narinthon-so/Mushroom-project/Documents/เล่ม/successed/resource/Pics/t8.jpg

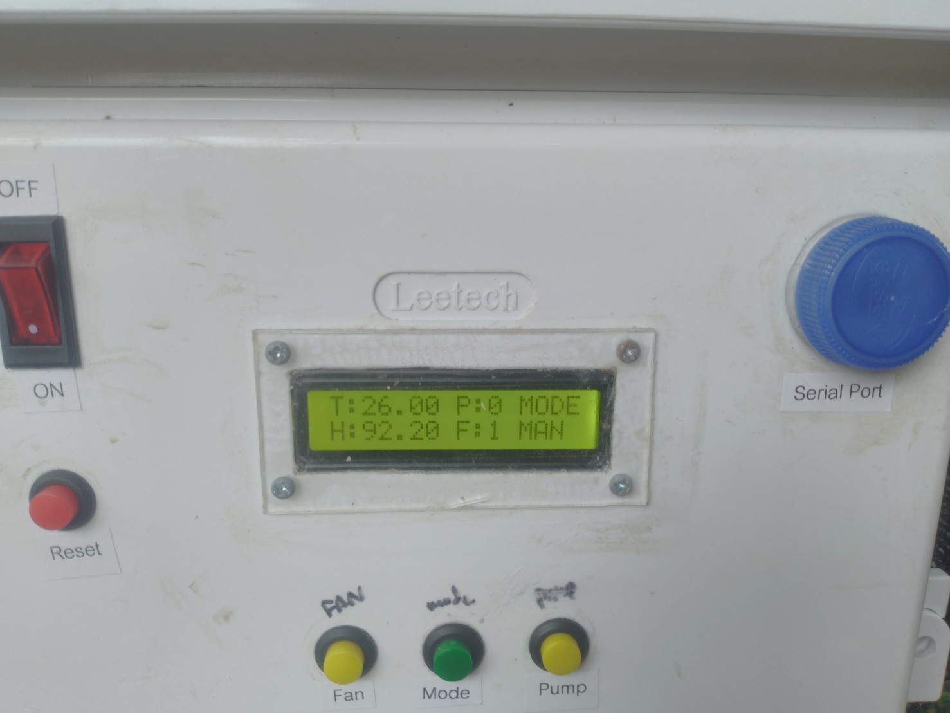
Documents/เล่ม/successed/resource/Pics/t8.jpg
