narinthon-so/Mushroom-project/Documents/เล่ม/successed/resource/Pics/IMG_20201009_142313.jpg

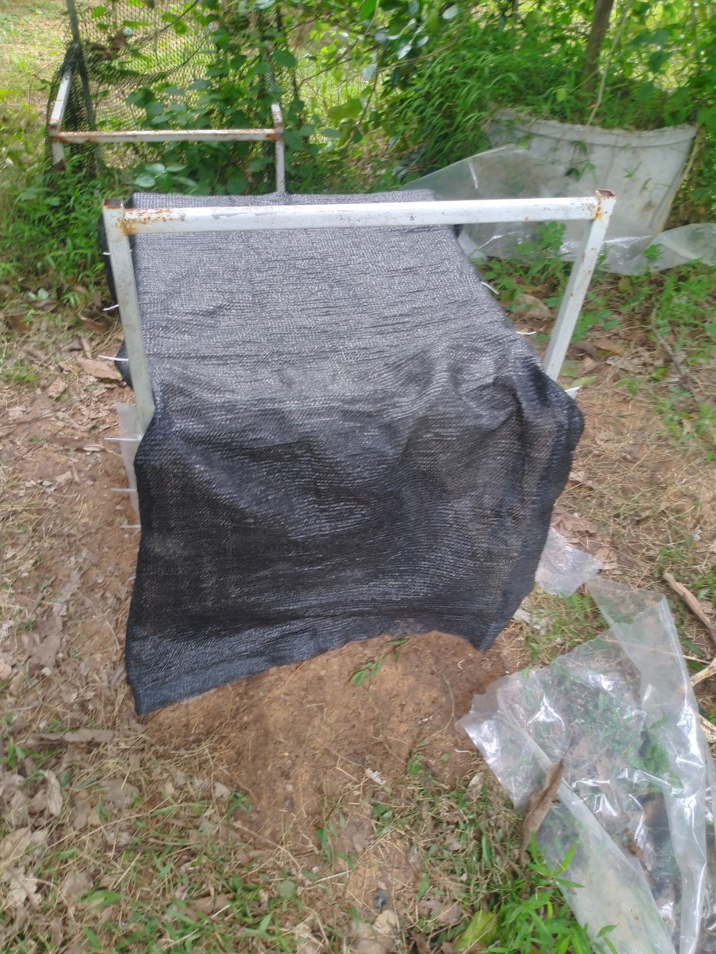
Documents/เล่ม/successed/resource/Pics/IMG_20201009_142313.jpg
