narinthon-so/Mushroom-project/Documents/hardware-diagrame.pptx

PUMP

Relay

GPIO 33

ESP32LoRa

SDA

AM2315 Sensor

LCD Monitor

FAN

Relay

GPIO 4

SCL

GPIO 34

R Sensing FAN

R Sensing PUMP

GPIO 25

GPIO 15

Switch
On / Off
FAN

GPIO 13

Switch
On / Off
PUMP

GPIO 12

Switch
AUTO / MANUAL
