narinthon-so/Mushroom-project/Documents/SystemDiagram.pptx

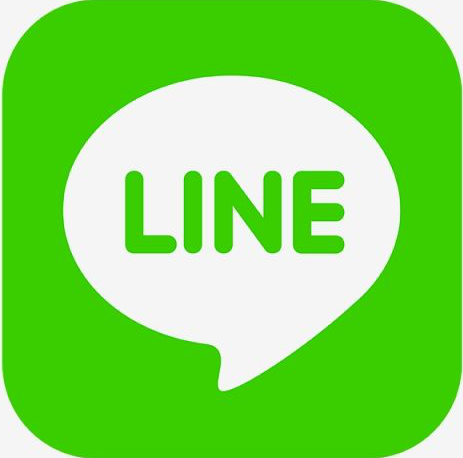
[picture p3: figure]

Line Application

Line Notify Service

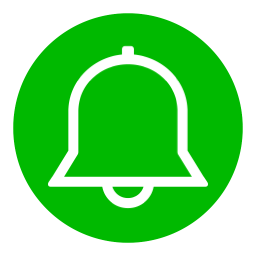
[picture p4: figure]
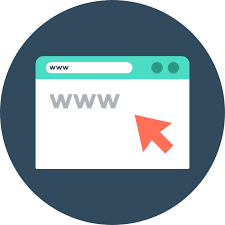
[picture p5: figure]

Web Client

Mushroom Farm

ngrok

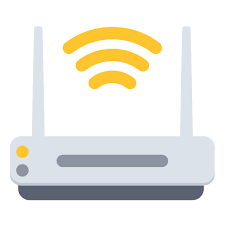
[picture p6: figure]

Access Point

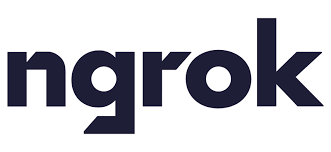
[picture p7: figure]
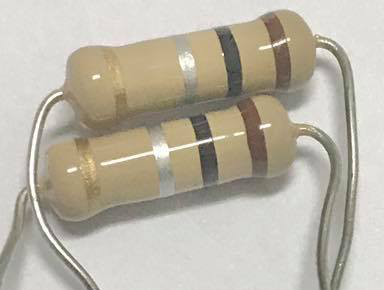
[picture p8: figure]

Current Sense Resistors

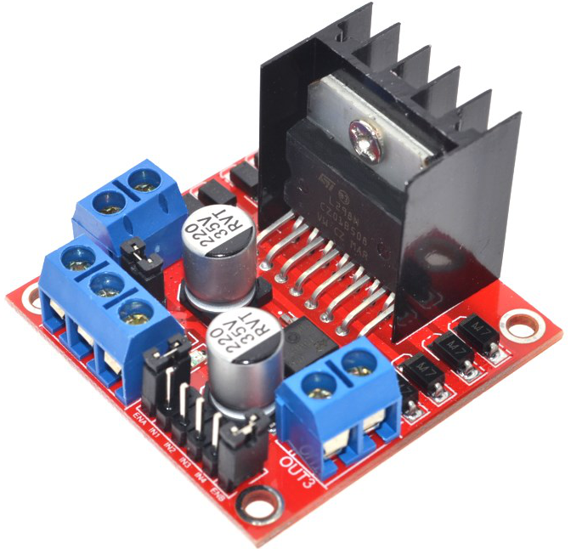
[picture p9: figure]

L298N

LED x 112

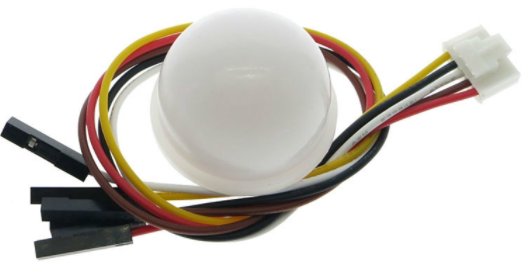
[picture p10: figure]

BH1750FVI

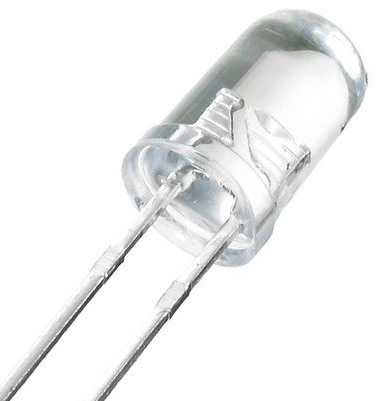
[picture p11: figure]
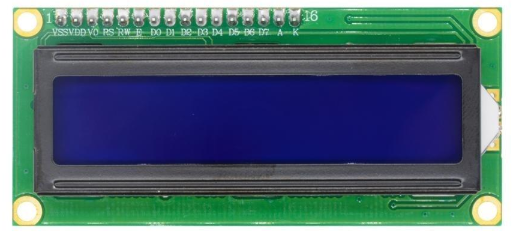
[picture p12: figure]

I2C LCD

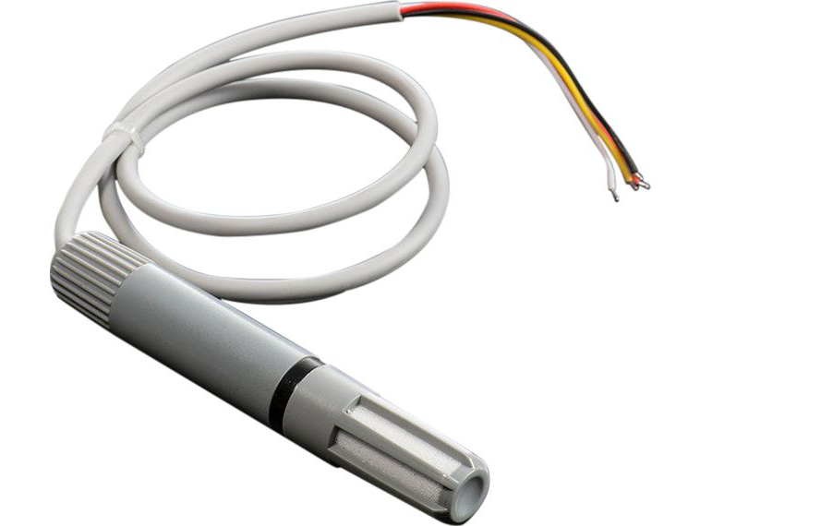
[picture p13: figure]
AM2315

AM2315

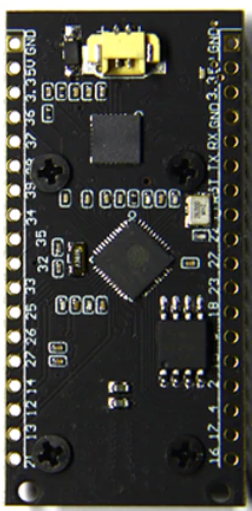
[picture p14: figure]

ESP32LoRa

ESP32LoRa

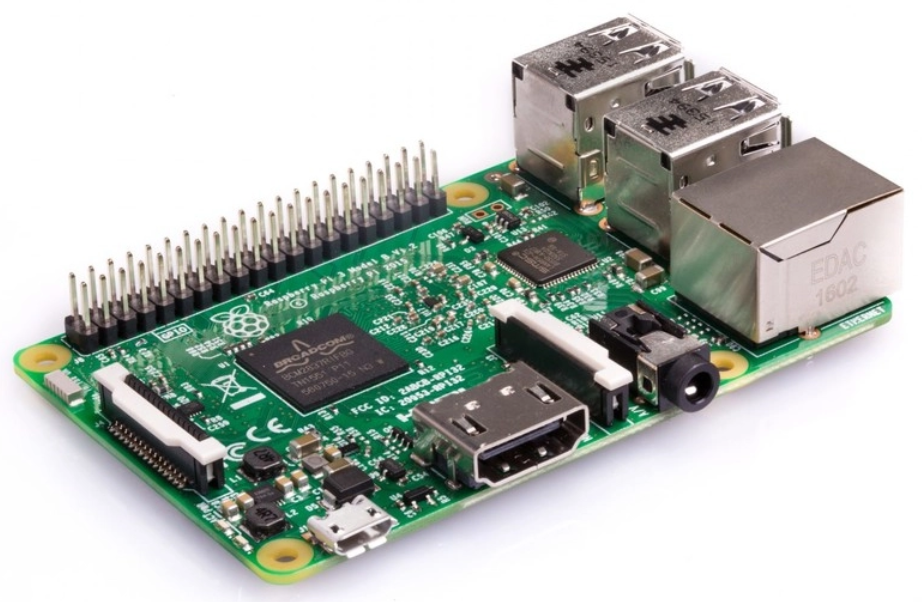
[picture p15: figure]

Raspberry pi 3 b

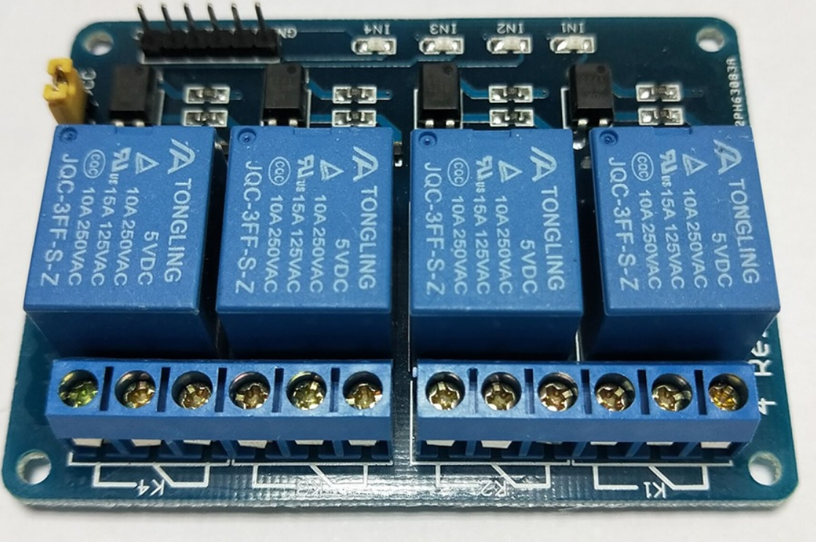
[picture p16: figure]
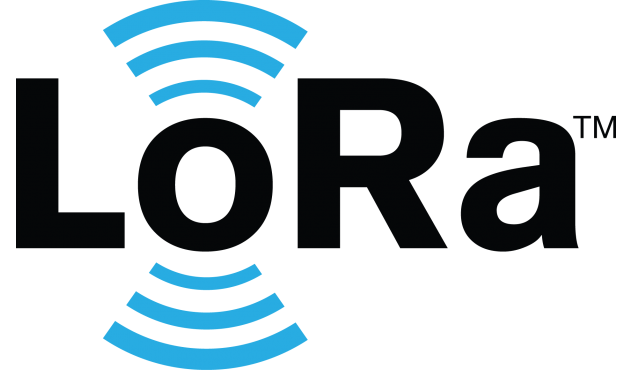
[picture p17: figure]

Relay

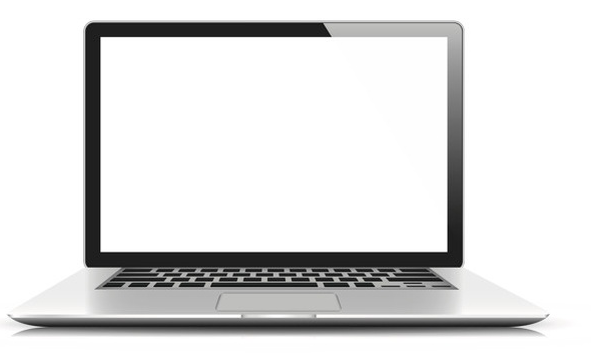
[picture p18: figure]

Windows
Application

I2C LCD

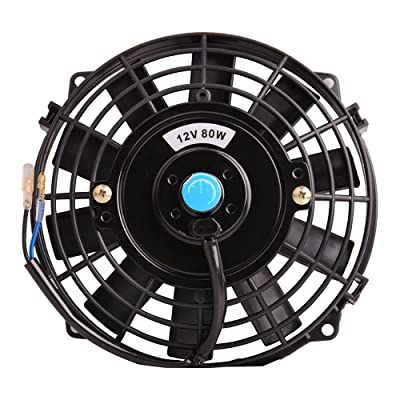
[picture p19: figure]

Fan

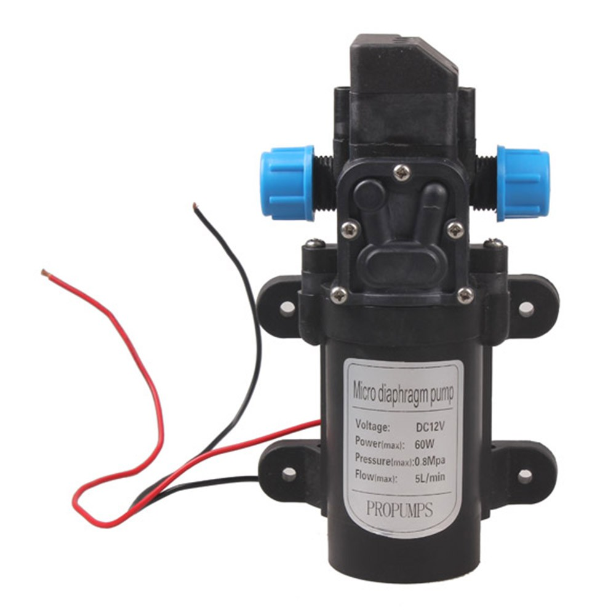
[picture p20: figure]

Pump

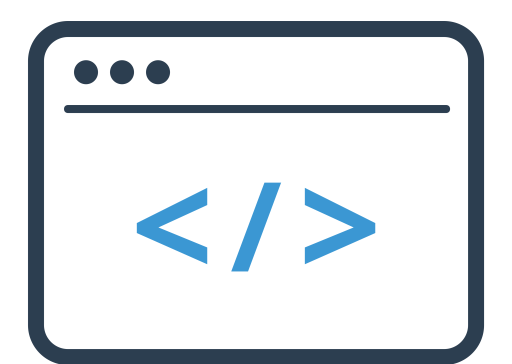
[picture p21: figure]

Web Server

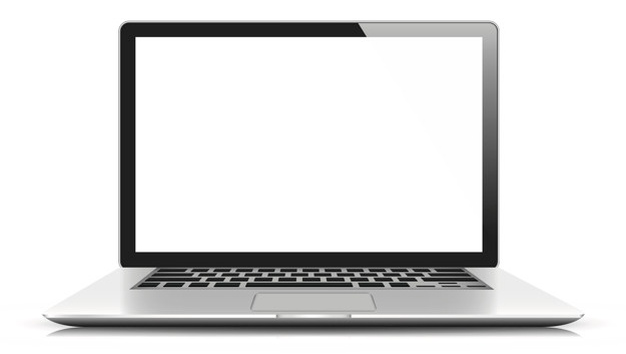
[picture p22: figure]

Windows
Application

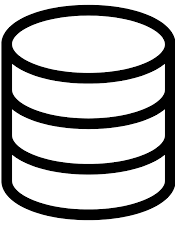
[picture p23: figure]

Database Server

## Slide 2

Web Application

NGROK

Line Application

Line Notify Service

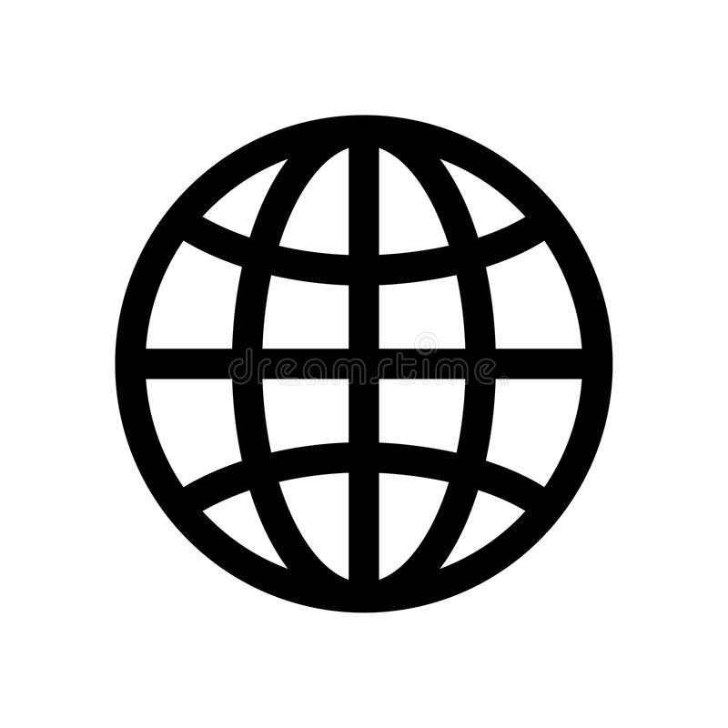
[picture p24: figure]

Internet

Access Point

Mushroom Farm

Raspberry Pi 3 b

ESP32LoRa

Web Server

Windows Application

Windows Application

Database

## Slide 3
