narinthon-so/Mushroom-project/Documents/MushroomNodeDataFormat.pptx

Mushroom Node
Address

Humidity

Min Humidity

Pump Status

Min Temperature

Set Light

X0X1T32.30H71.403080M0P1F12085L0200.33200

Mode

Fan Status

Max Humidity

Max Temperature

STA Node Address

Light

Temperature
