narinthon-so/Mushroom-project/Documents/boxdiagram.pptx

Mushroom Farm

AM2315
(วัดอุณหภูมิและความชื้น)

Web Browser
(เว็บเบราวด์เซอร์)

LINE Application
(ไลน์แอปพลิเคชัน)

I2C

Windows Application
(วินโดว์แอปพลิเคชัน)

Serial Port

ESP32LoRa
(ไมโครคอนโทรลเลอร์)

Pump, Fan
(ควบคุมอุณหภูมิและความชื้น)

NGROK
(Forward Port)

Line Notify
(แจ้งเตือน)

BH1750FVI
(วัดความแสงสว่าง)

Current Sense Resistors Circuit
(ตรวจสอบสถานะการทำงานของอุปกรณ์)

I2C

GPIO

Relay
(รีเลย์)

LCD 16X2
(แสดงผล)

LoRa 433MHz

I2C

Access Point
(แอคเซสพอยต์)

GPIO

GPIO

Raspberry Pi 3 B
(คอมพิวเตอร์)

L298N
(ควบคุมความสว่าง)

I2C

LCD 16X2
(แสดงผล)

Serial Port

Windows Application
(วินโดว์แอปพลิเคชัน)

ESP32LoRa
(ไมโครคอนโทรลเลอร์)

Web Application
(เว็บแอปพลิเคชัน)

LED
(หลอดไฟ)

Database
(ฐานข้อมูล)
