narinthon-so/Mushroom-project/Documents/รายละเอียด Use Case.docx

รายละเอียด Use Case

ตาราง 3.ป ถึงตาราง 3.ป ด้านล่างต่อไปนี้แสดงถึงรายละเอียดการใช้งานของแต่ละ

Use Case ตามรูปแบบของ UML Use Case Description

ตาราง 3.ป Login Use Case

Use Case Name | Login
Actors | User
Use Case Purpose | เพื่อเข้าสู่ระบบ
Pre-conditions | -
Post-conditions | เข้าสู่ระบบเพื่อดูค่าสถานะต่างๆ ควบคุมการทำงานของอุปกรณ์ กำหนดค่าสูงสุดต่ำสุดของอุณหภูมิและความชื้น
Main Course | 1.กรอก Username และ Password 2.กดปุ่ม Login 3.เข้าสู่ระบบเสร็จสิ้น
Exceptions | Username หรือ Password ไม่ถูกต้อง

ตาราง 3.ป Logout Use Case

Use Case Name | Logout
Actors | User
Use Case Purpose | เพื่อใช้ในการออกจากระบบ
Pre-conditions | เข้าสู่ระบบมาแล้วก่อนหน้า
Post-conditions | ออกจากระบบสำเร็จ
Main Course | 1.กดปุ่ม Logout 2.ออกจากระบบสำเร็จ
Exceptions | -

ตาราง 3.ป View Dashboard Use Case

Use Case Name | View Dashboard
Actors | User
Use Case Purpose | เพื่อใช้ในการแสดงสถานะต่างๆ และจัดการระบบ
Pre-conditions | เข้าสู่ระบบมาแล้วก่อนหน้า
Post-conditions | -
Main Course | แสดงค่าสถานะต่างๆ เช่น อุณหภูมิ ความชื้น สถานะการทำงานของอุปกรณ์
Exceptions | แสดงค่าผิดพลาด

ตาราง 3.ป Control Use Case

Use Case Name | Control
Actors | User
Use Case Purpose | เพื่อใช้ในการควบคุมการทำงานของระบบ เช่น เปลี่ยนโหมดการทำงาน ความคุมการเปิดปิดของอุปกรณ์
Pre-conditions | ใช้ร่วมกับ View Dashboard
Post-conditions | -
Main Course | 1.กดปุ่ม change mode 2.ถ้าโหมดการทำงานแบบอัตโนมัติระบบจะควบคุมการทำงานของอุปกรณ์โดยอัตโนมัติ เมื่อค่าอุณหภูมิและความชื้นต่ำกว่าหรือสูงกว่าที่กำหนด ถ้าโหมดการทำงานแบบแมนนวลผู้ใช้จะสามารถสั่งเปิดปิดอุปกรณ์ได้ตามต้องการ
Exceptions | เกิดความผิดพลาดภายในระบบ

ตาราง 3.ป Setting Use Case

Use Case Name | Setting
Actors | User
Use Case Purpose | เพื่อใช้ในการกำหนดค่าสูงสุดต่ำสุดของอุณหภูมิและความชื้น
Pre-conditions | ใช้ร่วมกับ View Dashboard
Post-conditions | -
Main Course | 1.กำหนดค่าสูงสุดต่ำสุด 2.กำหนดค่าสูงสุดต่ำสุดสำเร็จ
Exceptions | เกิดความผิดพลาดภายในระบบ

ตาราง 3.ป View Data Use Case

Use Case Name | View Data
Actors | User
Use Case Purpose | เพื่อใช้ในการแสดงผลข้อมูลที่อยู่ใน database ในรูปแบบต่างๆ
Pre-conditions | ใช้ร่วมกับ View Dashboard
Post-conditions | -
Main Course | 1.กดปุ่ม datalogger หรือ chart 2.แสดงข้อมูลในรูปแบบต่างๆ
Exceptions | ไม่สามารถติดต่อฐานข้อมูลได้

ตาราง 3.ป View Status Use Case

Use Case Name | View Status
Actors | User, Guest
Use Case Purpose | เพื่อใช้ในการแสดงสถานะบนจอ LCD Display ที่โรงเพาะเห็ด
Pre-conditions | -
Post-conditions | -
Main Course | 1.ดูค่าสถานะบนจอ LCD Display
Exceptions | เกิดความผิดพลาดภายในระบบ
