narinthon-so/Mushroom-project/Documents/ตัวอย่าง/บรรณานุกรม.docx

บรรณานุกรม

กองบรรณาธิการ HD. (2560). คำนวณค่า BMI ดัชนีมวลกาย [ออนไลน์] เข้าถึงได้จาก

URL: https://www.honestdocs.co/bmi-body-mass-index-calculator (9 มีนาคม 2561)

ทันพงษ์ ภู่รักษ์. (2563). ซอฟต์แวร์สำหรับโปรแกรมภาษา C [ออนไลน์]. เข้าถึงได้จาก

URL: www.sbt.ac.th › new › sites › default › files › TNP_Unit_2. (20 กรกฎาคม 2563)

พัชรินทร์ สุภายอง. (2560). หน่วยที่-1-ความเป็นมาของโปรแกรม-SketchUp [ออนไลน์].

เข้าถึงได้จาก URL:

https://sites.google.com/site/websitkhruhnungzz/home/hnwythi-

1-khwam-pen-ma-khxng-porkaerm-sketchup (https://sites.google.com/site/websitkhruhnungzz/home/hnwythi-). (19 กรกฎาคม 2563)

A FMIS (https://sysadmin.psu.ac.th/author/maliwan-s/) [นามแฝง]. (2560) รู้จัก Angular กันดีกว่า [ออนไลน์] เข้าถึงได้จาก

URL: https://sysadmin.psu.ac.th/2018/05/22. (9 มีนาคม 2563)

ASSANAI MANURAT (http://assanai.com/author/assanai/). (2559). เริ่มต้นทำความรู้จักกับ Spring Boot [ออนไลน์]. เข้าถึงได้จาก

URL: http://assanai.com/getting-started-spring-boot/. (19 กรกฎาคม 2563)

Hx711 [นามแฝง]. (2558). HX711 Weight Sensor Amplifier Module Dual Channel HX711 For load cell [ออนไลน์] เข้าถึงได้จาก URL: https://www.myarduino.net/product/60/hx711-weight-sensor-amplifier-module-dual-channel-hx711-for-load-cell. (8 ตุลาคม 2562)

IOXhop [นามแฝง]. (2563). DFPlayer Mini - mini MP3 player module [ออนไลน์]. เข้าถึงได้จาก URL: https://www.ioxhop.com/product/219. (19 กรกฎาคม 2563)

IOXhop [นามแฝง]. (2563). Mini 298N 2 Way PWM Mortor Driver MX1508 บอร์ดขับมอเตอร์ 2 ช่อง 1.5A ขนาดเล็ก สำหรับ smart car robot [ออนไลน์]. เข้าถึงได้จาก URL: https://www.allnewstep.com/product/1116. (19 กรกฎาคม 2563)

บรรณานุกรม (ต่อ)

IOXhop [นามแฝง]. (2563). เกียร์มอเตอร์ N20 Gear Motor 3-6V ทดรอบความเร็ว 180-360

rpm [ออนไลน์]. เข้าถึงได้จาก URL: https://www.allnewstep.com/product/3474.

(19 กรกฎาคม 2563)

IOXhop [นามแฝง]. (2563). Spur Gear Pinion 1.0 Mod 20Teeth Bore 12.7mm

(straightteeth - เฟืองตรง)[ออนไลน์]. เข้าถึงได้จาก

URL: https://www.zonemaker.com/product/1982. (19 กรกฎาคม 2563)

Kritsada Jaiyen. (2557). [UNICON] [HC-SR04] วัดระยะทางด้วยคลื่นอัลตร้าโซนิก [ออนไลน์].

Innovative Experiment Co.,Ltd. เข้าถึงได้จาก URL: http://doc.inex.co.th/hc-sr04-

ultrasonic-unicon. (8 ตุลาคม 2562)

Load Cell [นามแฝง]. (2560). Load Cell [ออนไลน์]. เข้าถึงได้จาก

URL: https://www.myarduino.net/product/1054/load-cell-weight-sensor-200-kg

(8 ตุลาคม 2562)

LoRa [นามแฝง]. (2556). LoRa 433MHz [ออนไลน์] เข้าถึงได้จาก

URL:

https://www.arduitronics.com/product/2199/lora-433mhz-sx1278-wifi-esp32-

oled-0-96 (https://www.arduitronics.com/product/2199/lora-433mhz-sx1278-wifi-esp32-). (8 ตุลาคม 2562)

Mindphp [นามแฝง]. (2560). รู้จักกับ Visual Studio Code (วิชวล สตูดิโอ โค้ด) โปรแกรมฟรี

จากค่ายไมโครซอฟท์ [ออนไลน์]. เข้าถึงได้จาก URL:

https://www.mindphp.com

/บทความ/microsoft/4829-visual-studio-code.html (https://www.mindphp.com). (19 กรกฎาคม 2563)

บรรณานุกรม (ต่อ)

Mindphp [นามแฝง]. (2560). SQL คืออะไร [ออนไลน์]. เข้าถึงได้จาก: URL:

https://www.mindphp.com/คู่มือ/73-คืออะไร/2088-sql-คืออะไร.html. (9 มีนาคม 2563)

Mindphp [นามแฝง]. (2560). Java คืออะไร จาวา คือภาษาคอมพิวเตอร์ สำหรับเขียนโปรแกรมเชิง

วัตถุ [ออนไลน์]. เข้าถึงได้จาก URL:

https://www.mindphp.com/คู่มือ/73-คืออะไร/2185-

java-คืออะไร.html (https://www.mindphp.com/คู่มือ/73-คืออะไร/2185-). (20 กรกฎาคม 2563)

Nuttavut Thongjor. (2559). TypeScript คืออะไร [ออนไลน์]. เข้าถึงได้จาก URL:

https://www.babelcoder.com/blog/posts/typescript-data-types.

(19 กรกฎาคม 2563)

Quick ERP TV [นามแฝง]. (2560). NEXTION DISPLAY [ออนไลน์]. เข้าถึงได้จาก URL:

https://www.youtube.com/watch?v=_fJO5rBiAP4. (19 กรกฎาคม 2563)

Saravut Konglampan (https://www.kkmakerclub.com/author/saravut/). (2559). จอ Touch Screen (https://www.kkmakerclub.com/2016/03/02/%e0%b8%88%e0%b8%ad-touch-screen-nextion-itead-studio-%e0%b8%aa%e0%b8%b7%e0%b9%88%e0%b8%ad%e0%b8%aa%e0%b8%b2%e0%b8%a3%e0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) [ออนไลน์]. เข้าถึงได้จาก URL:

https://www.kkmakerclub.com/2016/03/02/?fbclid=IwAR3DYbcrGDCHftxVF74ZnZsIzATUFqjTWUv_dZx_DYPQo30hxX_MlOQY0WM. (19 กรกฎาคม 2563)

SE-ED inspiration starts here [นามแฝง]. (2563). จำลองการทำงานและออกแบบลายวงจรพิมพ์

ด้วย Circuit Wizard [ออนไลน์]. เข้าถึงได้จาก URL: https://bit.ly/32DHJAn.

(19 กรกฎาคม 2563)

Wikipedia [นามแฝง]. (2563). IntelliJ IDEA [ออนไลน์]. เข้าถึงได้จาก URL:

https://en.wikipedia.org/wiki/IntelliJ_IDEA. (19 กรกฎาคม 2563)

บรรณานุกรม (ต่อ)

Y.Jaruwan [นามแฝง]. (2544). ความรู้ทั่วไปเกี่ยวกับระบบฐานข้อมูล [ออนไลน์]. เข้าถึงได้จาก :

URL: http://www3.chandra.ac.th/office/ict/document/it/it04/page01.html.

(9 ตุลาคม 2562)
