narinthon-so/Mushroom-project/Documents/งานวิจัยที่เกี่ยวข้อง/use/b_thesis.pdf

## ไอโอทีแพลทฟอร์มในโรงเพาะเห็ด IoT Platform for Mushroom Nursery

ขนั ติชัยรุจิตระการโชติกลุ ชยุต สุรกลุ

รายงานนีเ้ป็นส่วนหนึ่งของการศึกษาตามหลกัสูตรปริญญาวศิวกรรมศาสตรบัณฑิต สาขาวิชาวิศวกรรมคอมพิวเตอร์ คณะวิศวกรรมศาสตร์ สถาบันเทคโนโลยพีระจอมเกล้าเจ้าคุณทหารลาดกระบัง ปี การศึกษา 2560

ปริญญานิพนธ์ปี การศึกษา 2560 ภาควิชาวิศวกรรมคอมพิวเตอร์คณะวิศวกรรมศาสตร์ สถาบันเทคโนโลยีพระจอมเกล้าเจ้าคุณทหารลาดกระบัง เรื่อง ไอโอทีแพลทฟอร์มในโรงเพาะเห็ด
IOT PLATFORM FOR MUSHROOM NURSERY

ผู้จัดท า
1. นายขันติชัย รุจิตระการโชติกุล | รหัสนักศึกษา 57010127
2. นายชยุต | สุรกุล | รหัสนักศึกษา 57010266

_____________________________ อาจารย์ที่ปรึกษา (อาจารยเ์กียรติณรงค์ทองประเสริฐ)

______________________________อาจารยท์ ี่ปรึกษาร่วม (อาจารยส์ รยทุ ธกลมกล่อม)

I

## ไอโอทีแพลทฟอร์มในโรงเพาะเห็ด

นายขันติชัย | รุจิตระการโชติกุล 57010127
นายชยุต | สุรกุล | 57010266
อาจารยเ์กียรติณรงค์ทองประเสริฐ | อาจารย์ที่ปรึกษา
อาจารย์สรยุทธ | กลมกล่อม | อาจารยท์ ี่ปรึกษาร่วม
ปี การศึกษา 2560

บทคัดย่อ
โครงงานน้ีจดั ทา ข้ึนเพื่อศึกษา ออกแบบ และสร้างไอโอทีแพลทฟอร์มส าหรับใช้ในโรง เพาะเห็ด โดยการใช้ Raspberry Pi 3 Model B ซึ่งเป็ น Microcontroller มาใช้วดัค่าอุณหภูมิและ ความช้ืนจากเซนเซอร์ภายในโรงเรือน จากน้ันจึงส่งข้อมูลอุณหภูมิและความช้ืนที่วดัได้ไปยงั Platform และเก็บขอ้ มูลอุณหภูมิและความช้ืนลงบนฐานขอ้ มูลโดยใช้MySQL เป็นท้งฐานข้อมูล ั และตวัจดัการฐานขอ้ มูล นอกจากน้นั ยงัมีระบบ Web Application เพื่อใชแ้ สดงผลค่าอุณหภูมิและ ความช้ืนที่ถูกส่งมาจาก Raspberry Pi หรือประวตัิของค่าอุณหภูมิและความช้ืนที่เก็บไว้ใน ฐานข้อมูล
โดย Protocol ที่เป็นตวักลางในการรับส่งขอ้ มูลระหวา่ ง Raspberry Pi, Platform และ Web Application คือ MQTT Protocol และใชร้่วมกบั NodeJS ซึ่งเป็ น Service หลักที่ใช้ภายใน Platform

II

## IoT Platform for Mushroom Nursery

Mr. Kantichai Rujitrakarnchotikul 57010127
Mr. Chayoot Surakul | 57010266
Mr. Kiatnarong Tongprasert | Advisor
Mr. Sorayut | Glomglome | Co-Advisor
Academic Year 2560

ABSTRACT
This project aims to study, design and build the IoT platform for the mushroom nursery by using Raspberry Pi 3 Model B+, a microcontroller to measure the temperature and humidity from sensors in the mushroom nursery. Then sending the measured temperature and humidity data to the platform and stores them in the database using MySQL. In addition, there is a web application to display real-time temperature andhumidity data sent from Raspberry Pi or historical data stored in the database.
The protocol used to transmit data among Raspberry Pi, the platform and web application is MQTT protocol, and use NodeJS as the main service in the platform.

III

## กิตติกรรมประกาศ

โครงงานไอโอทีแพลทฟอร์มในโรงเพาะเห็ดส าเร็จลุล่วงไปไดด้ว้ยดีดว้ยความกรุณาและ ความช่วยเหลืออย่างสูงจากอาจารย์เกียรติณรงค์ทองประเสริฐ ซ่ึงเป็นอาจารย์ที่ปรึกษาของ โครงงานน้ีและอาจารยส์ รยุทธกลมกล่อม ซ่ึงเป็นอาจารยท์ ี่ปรึกษาร่วมที่ไดใ้ห้คา ปรึกษาโครงงาน และการวางแผนการดา เนินงานตลอดจนให้คา แนะนา และแนะแนวทางปฏิบตัิรวมท้งัเสียสละเวลา อนั มีค่าติดตามความคืบหน้าของโครงงานอย่างสม่า เสมอ และแกไ้ขขอ้ บกพร่องของเน้ือหาและ สา นวนของภาษาดว้ยความเอาใจใส่อยา่ งดียงิ่
ขอบพระคุณอาจารยท์ ุกท่านในภาควิชาวิศวกรรมคอมพิวเตอร์คณะวิศวกรรมศาสตร์ สถาบันเทคโนโลยีพระจอมเกล้าเจ้าคุณทหารลาดกระบังที่ได้ให้ความรู้ด้านทฤษฎีและการปฏิบัติ ในรายวิชาต่างๆที่เกี่ยวขอ้งกบัการทา โครงงานน้ีท้งัความรู้ดา้นฮาร์ดแวร์ซอฟต์แวร์และระบบ เครือข่าย ตลอดจนการเรียนรู้การทา งานเป็นกลุ่ม และสามารถทา งานร่วมกบัผอู้ื่นไดเ้ป็นอยา่ งดี ขอกราบขอบพระคุณบิดามารดาที่ให้กา ลงัใจและสนบั สนุนในทุกๆดา้น รวมท้งัให้ความรู้ และคา แนะน าในการทา งาน เพื่อส่งเสริมให้ผลลัพธ์ของโครงงานน้ีให้เป็นไปตามเป้าหมายที่ กา หนดไว้
ขอขอบคุณห้อง Make Ducation และห้อง HCRL ที่เป็นแหล่งสนบั สนุนดา้นสถานที่และ อุปกรณ์ในการพฒั นาโครงงานได้อย่างสะดวก และขอบคุณสมาชิกภายในห้อง Make Ducation และห้อง HCRL ทุกคนที่มีส่วนร่วมใหโ้ครงงานน้ีสา เร็จลุล่วงไปไดด้ว้ยดี ขอบคุณรุ่นพี่และเพื่อนๆตลอดจนผูท้ี่เกี่ยวขอ้งทุกท่านที่ไม่ไดก้ล่าวนามไว้ณ ที่น้ีที่ไดใ้ห้ ค าปรึกษาและค าแนะนา รวมท้งัแสดงความคิดเห็นต่อโครงงานในดา้นต่างๆ สุดทา้ยน้ีดว้ยคุณค่าและประโยชน์อนั พึงมีจากโครงงานน้ีขอมอบแด่ผูม้ีพระคุณทุกท่านที่ กล่าวมาขา้งตน้ และขอกราบขอบพระคุณทุกท่านมา ณ ที่น้ี

ขันติชัย รุจิตระการโชติกุล ชยุต สุรกุล

IV

## สารบัญ

หน้า
ไอโอทีแพลทฟอร์มในโรงเพาะเห็ด | I
IoT Platform for Mushroom Nursery | II
สารบัญ | IV
สารบัญตาราง | IX
สารบัญรูป | X

V

## สารบัญ(ต่อ)

หน้า

2.4.1 TEMPERATUER & HUMIDTY CONTROL SYSTEM FOR MUSHROOM.16

2.4.3 Automatic Temperature and Humidity control system by using Fuzzy Logic

VI

## สารบัญ(ต่อ)

หน้า

4.2 การทดลองรับ-ส่งขอ้มูลระหวา่ ง Raspberry Pi และ Platform โดยใช้ MQTT Protocol35

4.3 การดึงค่าจาก Back-End ที่ติดต่อกบั MySQL มาแสดงผลบน Web Application.........36

4.6 การทดลองเพาะเห็ดโดยใช้Platform ในการควบคุมสภาพแวดล้อมภายในตู้จ าลอง

VII

## สารบัญ(ต่อ)

หน้า

VIII

## สารบัญ(ต่อ)

หน้า

IX

## สารบัญตาราง

ตาราง | หน้า
1.1แผนการด าเนินงาน | 5
2.1 หลักการท างานของ Fuzzy Logic | 18
3.1 Login Use Case | 25
3.2 Logout Use Case | 26
3.3 View Dashboard Use Case | 26
3.4 View Summary Use Case | 27
3.5Set Profile Use Case | 27
3.6 Manage User/Device Use Case | 28
3.7Set Profile Use Case | 28
4.1 อัตราการเจริญเติบโตของเห็ด | 45

X

## สารบัญรูป

รูป | หน้า
1.1 IoT | 1
1.2 Model ตู้จ าลองโรงเรือนเพาะเห็ด | 3
1.3 Hardware I/O Diagram | 4
1.4System Diagram | 4
2.1 Raspberry Pi 3 Model B | 6
2.2 Ultrasonic Mist Maker Fogger | 8
2.3 DHT22 | 9
2.4 LCD Display | 10
2.5 Grow LED Strip | 11
2. 6 Waterproof Fan | 12
2.7 MQTT | 13
2.8 Web Application | 15
2.9รายละเอียดของส่วนประกอบภายในโรงเรือนจา ลอง | 16
2.10โรงเรือนเพาะเห็ดจ าลอง | 16
2.11โรงเรือนเพาะเห็ดจ าลอง | 17
3.1System Diagram | 21
3.2 Hardware I/O Diagram | 21
3.3Sequence Diagram | 22
3.4 Use Case Diagram | 24
3.5 Database Schema | 29
4.1 ส่วนสา หรับเพาะเห็ด | 34
4.2 ส่วนแผงควบคุม | 34
4.3 Dashboard | 37
4.4 หน้า Login | 40
4.5 หน้า Dashboard | 41
4.6 หน้า Profile | 41
4.7 หน้า Edit User | 42
4.8 หน้า Edit Device | 42

XI

## สารบญั รูป(ต่อ)

รูป | หน้า
4.9 หน้า Edit Farm | 43
4.10 alert message | 43
4.11 Dashboard ส าหรับจอ LCD(1) | 38
4.12 Dashboard ส าหรับจอ LCD(2) | 39
4.13 Dashboard ส าหรับจอ LCD(3) | 39
4.14 เห็ดท้งั 4 ชนิดในตูเ้พาะเห็ด | 44
4.15ค่าProfile ส าหรับการเพาะเห็ด | 45
4.16 นางรมฮังการี | 47
4.17 เห็ดนางนวลสีชมพู | 47
4.18 เห็ดนางฟ้าภูฐาน | 48
4.19 เห็ดเป๋าฮ้ือ | 48
ค.1ไฟล์ CentOS 7 -Platform.vhdx | 78
ค.2 เพิ่ม Virtual Machine | 78
ค.3 Virtual Machine Interface | 79
ค.4 Network Configuration Using a Text User Interface (nmtui) | 79
ค.5 Bash in NodeJS Container | 80
ค.6 Run Service on Bash in NodeJS Container | 80
ค.7 ดา้นซา้ยมุมซา้ยล่างของตูจ้า ลอง | 81
ค.8 ด้านบนของตู้จ าลอง | 81
ค.9 Raspberry Pi Terminal Interface | 82
ค.10 Network Configuration | 82

### บทที่ 1

## บทน า

### 1.1 ที่มาและความส าคัญของโครงงาน

ในปัจจุบนัการเพาะเห็ดในโรงเรือนน้นั มีอุณหภูมิและความช้ืนที่เหมาะสมในการออกดอก แตกต่างกนัออกไปสา หรับเห็ดแต่ละประเภท การควบคุมระบบในโรงเรือนโดยมนุษยน์ ้นัอาจทา ให้ เกิดปัญหาเนื่องจากการดูแลที่ไม่ทวั่ ถึงได้ทา ให้เกิดผลกระทบกบัคุณภาพของผลผลิตให้ไม่เป็ นไป ตามที่ต้องการได้
โครงงานน้ีจึงได้นา เอา Microcontroller มาช่วยในการควบคุมอุณหภูมิและความช้ืนใน โรงเรือนให้มีปริมาณที่เหมาะสมกับการเจริญเติบโตของเห็ด เพื่อให้เห็ดเจริญเติบโตใน สภาพแวดลอ้ มที่ดีที่สุด ทา ใหเ้พิ่มผลผลิตไดม้ ากข้ึนและลดขอ้ผิดพลาดจากการควบคุมดูแล และใช้ ควบคู่กบระบบ ั IoT Platfrom เพื่อที่สามารถแสดงขอ้มูลต่างๆและจดัการระบบภายในโรงเรือนได้ แนวคิด Internet of Things ถูกคิดข้ึนในปี1999 ต่อมาหลงัจาก2000เป็นตน้ ไปไดม้ีอุปกรณ์ อิเล็กทรอนิกส์ที่มีการใชค้า วา่ Smart ออกมาจา นวนมากเช่น smart device, smart home และsmart network ซ่ึงท้งัหมดลว้นมีโครงสร้างพ้ืนฐานที่สามารถเชื่อมต่อกบั โลกอินเตอร์เน็ตไดตามรูป ้ 1.1 ซ่ึงทา ใหอุ้ปกรณ์เหล่าน้นั สามารถสื่อสารกนั เองไดด้ว้ยเช่นกนั

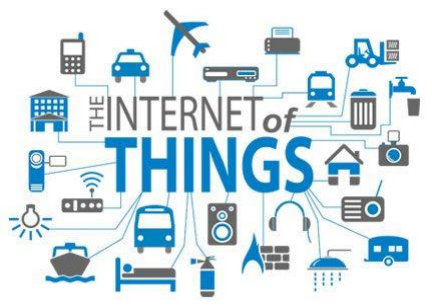
[picture p122: figure]

รูป 1.1IoT

โดย Microcontroller ส่งขอ้มูลต่างๆท้งัอุณหภูมิและความช้ืนข้ึนไปเก็บไวบ้ นเซิฟเวอร์แลว้ เราจึงนา ขอ้ มูลเหล่าน้ันไปแสดงผลผ่านทาง IoT Platform โดยสามารถจัดการและควบคุมดูแล ระบบต่างๆในโรงเรือนไดผ้า่ นทาง Web Application

1.2วตัถุประสงค

์

ของโครงงาน
1) เพื่อศึกษาและประยุกต์ใช้งาน Microcontroller
2) เพื่อจา ลองระบบโรงเรือนที่มีการเพาะเล้ียงเห็ดที่ควบคุมโดย Microcontroller
3) เพื่อออกแบบระบบควบคุมอุณหภูมิและความช้ืนที่เหมาะสมกบั เห็ดแต่ละชนิด
4) เพื่อศึกษาและประยุกต์ใช้งาน IoT Platform
5) เพื่อออกแบบระบบ Web Application ส าหรับแสดงสถานะและควบคุมระบบภายใน โรงเรือนเพาะเห็ด

### 1.3 ประโยชน์ที่คาดว่าจะได้รับ

1) เขา้ใจระบบการทา งานท้งัหมดต้งัแต่การเพาะเล้ียงเห็ด, Microcontroller, IoT Platform และ Web Application
2) นา ระบบควบคุมอุณหภูมิและความช้ืนไปประยกุ ตใ์ชใ้นการปลูกพืชและเห็ดชนิดอื่นๆ

### 1.4 ขอบเขตของโครงงาน

1) ออกแบบตู้เพาะเห็ดตามรูป 1.2 ที่สามารถควบคุมความช้ืน อุณหภูมิแสง ดว้ยProfile ต่างๆ ของเห็ดแต่ละชนิด ด้วย Mircocontroller โดยมีDiagram การเชื่อมต่อตามรูป 1.3 และ สามารถส่งขอ้มูลไปยงัระบบ IoT Platform ที่ได้พัฒนาไว้
2) นา ไปจดัแสดงในนิทรรศการและงานกิจกรรมต่างๆได้โดยตู้เพาะเห็ดสามารถเคลื่อนย้าย ไดง้่ายดว้ยลอ้เลื่อน เพื่อเป็นความรู้และแนวคิดใหก้ บัผูช้ มในงาน ท้งัน้ีสามารถเป็นชื่อเสียง ใหก้ บั สถาบนัและภาควชิา
3) จากรูป 1.4 จะเห็นไดว้า่ ระบบมีการติดต่อกนั ระหวา่ ง ตูเ้พาะเห็ด Iot Platform และผู้ใช้งาน จาก Web Application โดยมีรายละเอียดดงัน้ี
a) ตู้เพาะเห็ดสามารถท างานได้แบบ Standalone คือไม่ไดต้ิดต่อกบั Platform ก็สามารถ ท างานตาม Profile ของเห็ดแต่ละชนิด และรับส่งขอ้ มูลไปยงั Platform ภายหลังที่ สามารถเชื่อมต่อPlatform ได้
b) IoT Platform เป็นตวัสั่งการ และรับขอ้มูลต่างๆจากตูเ้พาะเห็ด ด้วย Protocol ที่กา หนด ได้

c) มี Web Appilcation ที่ติดต่อกบัผใู้ชง้านผา่ น HTTP เพื่อดูค่าสถานะและสั่งการได้

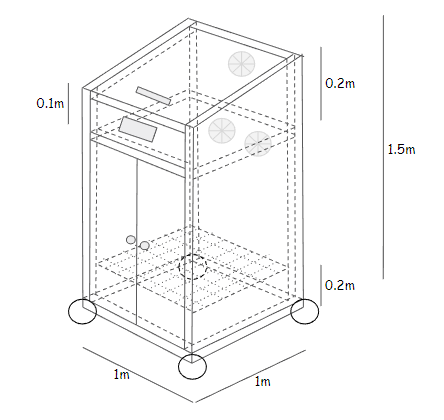
[picture p123: figure]

รูป 1.2 Model ตู้จ าลองโรงเรือนเพาะเห็ด

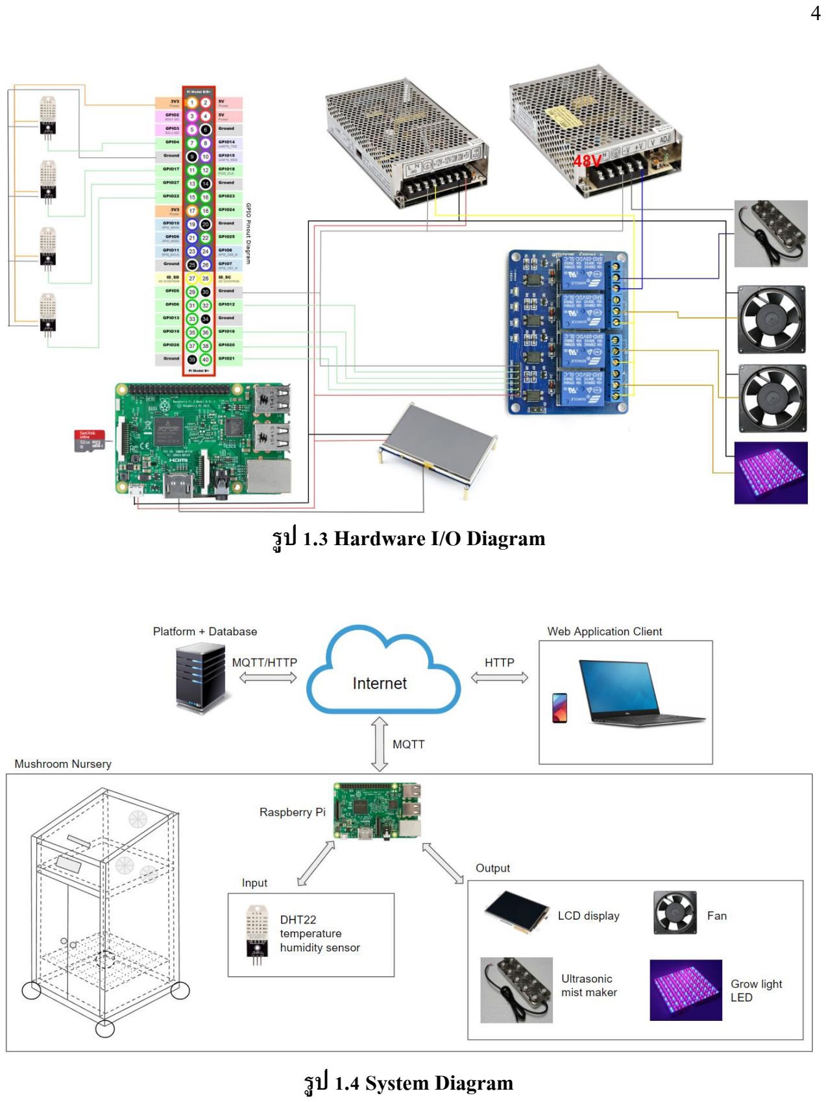
[picture p124: page 17]

รูป 1.3 Hardware I/O Diagram

รูป 1.4System Diagram

### 1.5 แผนการด าเนินการ

ตาราง 1.1แผนการด าเนินงาน
หัวข้อกิจกรรม | เดือน
ส.ค. | ก.ย. | ต.ค. | พ.ย. | ธ.ค. | ม.ค. | ก.พ. | มี.ค. | เม.ย. | พ.ค.
1. ศึกษาระบบและความ เป็ นมาของ IoT Platform และโรงเรือน เพาะเห็ด
2. ออกแบบระบบ จ าลองโรงเรือนเพาะเห็ด ที่ควบคุมโดย Microcontroller
3. จัดหาวัสดุและ อุปกรณ์ในการสร้าง โรงเรือนจ าลอง
4. ด าเนินการสร้าง โรงเรือนจ าลอง
5. ติดต้งั Microcontroller ลงใน โรงเรือนจ าลอง และ ทดลองเพาะเห็ด
6. ด าเนินการสร้างและ ทดสอบฝั่ง IoT Platform
7. วิเคราะห์ผลและ ปรับปรุงพลาดต่างๆ
8. จัดท าเอกสารเพื่อ ตีพิมพ์และรวบรวมองค์ ความรู้ท้งัหมดและ สรุปผลโครงงาน

### บทที่ 2

## ทฤษฎีที่เกียวข้อง

บทน้ีกล่าวถึงทฤษฎีต่างๆ ที่ไดน้ า มาใชใ้นโครงงานน้ีซ่ึงสามารถแบ่งไดท้ ้งัหมด 3 ส่วน คือ ส่วนของโรงเรือนจา ลองและ Microcontroller ส่วนของ Platform และสุดทา้ยคือส่วนของ Web Application แต่ละส่วนประกอบดว้ยทฤษฎีต่างๆดงัน้ี

### 2.1 Microcontroller และอปุ กรณ

์

ต่างๆภายในโรงเร

ื

อนเพาะเห็ด
Microcontroller ที่นา มาใชค้วบคุมอุปกรณ์ต่างๆภายในโรงเรือนเพาะเห็ดคือ Raspberry Pi 3 Model B ตามรูป 2.1 โดยอุปกรณ์ภายในโรงเรือนเพาะเห็ดประกอบด้วย เครื่องสร้างหมอกแบบ Ultrasonic ใชส้ ร้างกลุ่มหมอกเพื่อเพิ่มความช้ืนภายในโรงเรือน เซนเซอร์ DHT 22 ใชว้ดัความช้ืน และอุณหภูมิ เซนเซอร์ ESEN171 ใชว้ดัระดบั น้า LCD Display ส าหรับการแสดงผล Grow LED Strip ใชเ้พื่อช่วยใหเ้ห็ดเจริญเติบโตไดด้ีข้ึน และพดัลมระบายอากาศแบบกนั น้า

### 2.1.1 Raspberry Pi 3 Model B

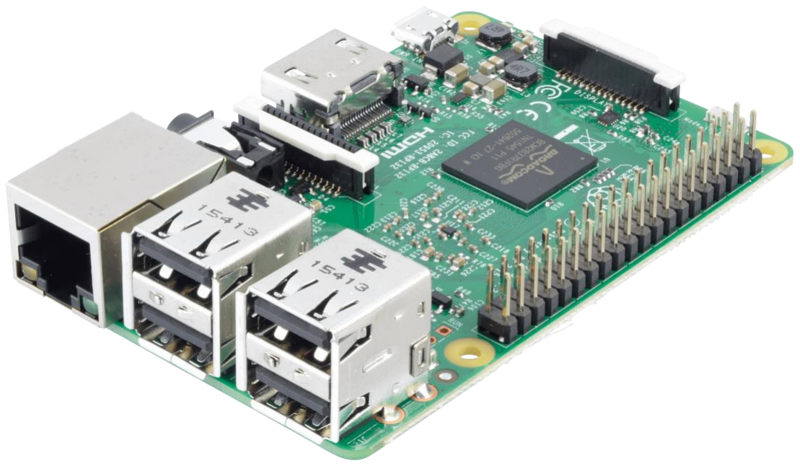
[picture p125: figure]

รูป 2.1 Raspberry Pi 3 Model B

Raspberry Piถูกออกแบบมาเพื่อให้เป็นคอมพิวเตอร์ขนาดเล็กที่สามารถเชื่อมต่อ กับ จอ เมาส์และคีย์บอร์ดได้สามารถทา งานได้เหมือนคอมพิวเตอร์ทั่วๆไป เช่น การใช้งาน Internet หรือเล่นไฟลว์ ดีีโอ
Raspberry Pi สามารถรองรับระบบปฏิบัติการ Linux ได้หลายระบบ เช่น Raspbian Pidora และ Arch Linux โดยติดต้งัลงบน SD Card โดย Raspberry Pi สามารถน าไป ประยกุ ตใ์ชท้ า สิ่งต่างๆไดม้ากมายเช่น นา ไปทา เป็นหุ่นยนต์เครื่องเล่นดนตรี
Raspberry Pi 3 Model B เป็นรุ่นที่3ของ Raspberry Pi ซ่ึงมีขนาดของบอร์ดเท่า บัตรเครดิตเท่าน้นั โดยที่มีความสามารถในการประมวลผลมากกวา่ Raspberry Pi รุ่นแรกถึง 10 เท่า คุณสมบัติของ Raspberry Pi 3 Model B มีดงัน้ี
- Broadcom BCM2837 chipset running at 1.2 GHz
- 64-bit quad-core ARM Cortex-A53
- 802.11 b/g/n Wireless LAN
- Bluetooth 4.1
- Dual core Videocore IV® Multimedia co-processor
- 1 GB LPDDR2 memory
- Supports all the latest ARM GNU/Linux distributions and Windows 10 IoT
- microUSB connector for 2.5 A power supply
- 1 x 10/100 Ethernet port
- 1 x HDMI video/audio connector
- 1 x RCA video/audio connector
- 4 x USB 2.0 ports
- 40 GPIO pins
- Chip antenna
- DSI display connector
- microSD card slot
- Size 85*56*17 mm

### 2.1.2 Ultrasonic Mist Maker Fogger

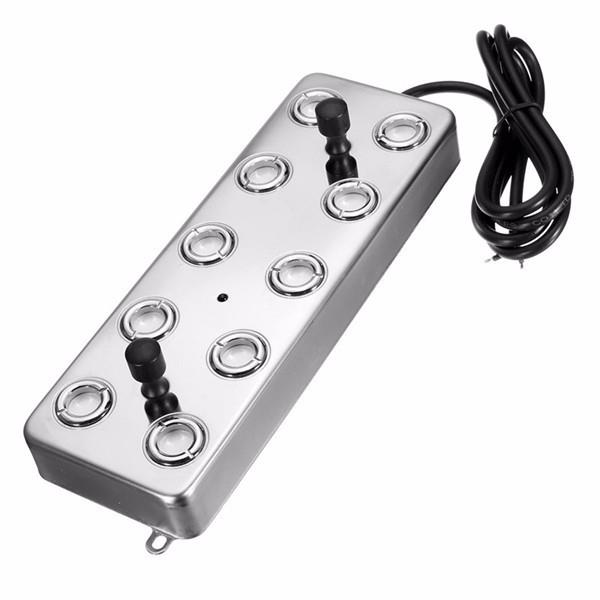
[picture p126: figure]

รูป 2.2 Ultrasonic Mist Maker Fogger

Ultrasonic Mist Maker Fogger จากรูป 2.2 ใช้ในการสร้างหมอกโดยอาศัยคลื่น Ultrasonic ในการทา ให้น้า เกิดการแตกตวักลายเป็นกลุ่มหมอก ทา ให้สามารถควบคุมความช้ืนใหม้ี ความเหมาะสมต่อการเจริญเติบโตของพืชได้
คุณสมบัติของ Ultrasonic Mist Maker Fogger มีดงัน้ี
- Power 250 w
- Electric Current 5 A
- Size 252*92*67 mm
- Water-depth : 60-80 mm
- Particle size : 0.1~0.5u
- Piezoceramics disc 1.7 MHZ
- Humidification amount : 4.5 kg/h
- Mist output tolerance ±10%

### 2.1.3 Humidity and Temperature Sensor – DHT22

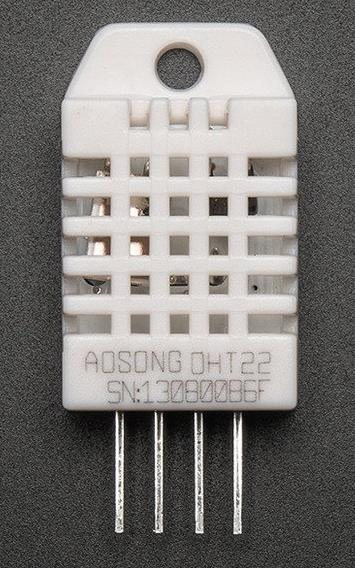
[picture p127: figure]

รูป 2.3 DHT22

DHT22 จากรูป 2.3 เป็นเซนเซอร์ที่ใชว้ดัความช้ืนและอุณหภูมิภายในตวัเดียว ถูก ออกแบบมาให้ใช้งานง่ายและมีความแม่นยา สูง โดยค่าที่วดัไดเ้ป็นรูปแบบ Digital โดยสามารถ เชื่อมต่อกบั Raspberry Pi ด้วย 4 Pin connector
คุณสมบัติของ DHT22 มีดงัน้ี
- Low cost
- 3 to 5V power and I/O
- 2.5mA max current use during conversion (while requesting data)
- Good for 0-100% humidity readings with 2-5% accuracy
- Good for -40 to 80°C temperature readings ±0.5°C accuracy
- No more than 0.5 Hz sampling rate (once every 2 seconds)
- Body size 27mm x 59mm x 13.5mm (1.05" x 2.32" x 0.53")
- 4 pins, 0.1" spacing
- Weight (just the DHT22): 2.4g

### 2.1.4 LCD Display

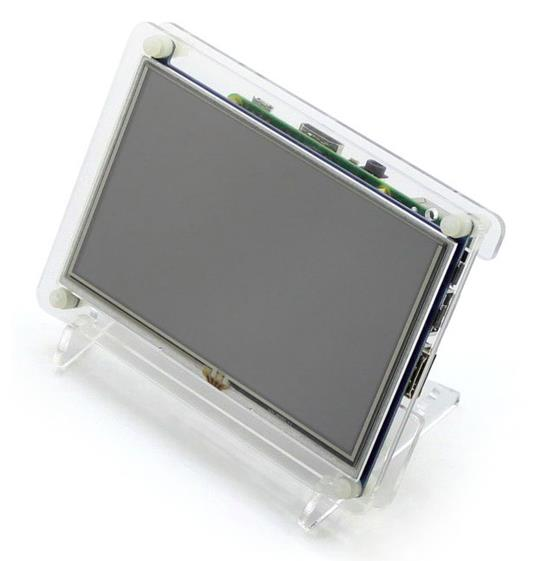
[picture p128: figure]

รูป 2.4 LCD Display

จอ LCD Display จากรูป 2.4 เป็ นจอส าหรับแสดงผลแบบสัมผสัขนาด 5 นิ้ว มี ความละเอียด 800 * 480 โดยส่วนจอแสดงผลสามารถเชื่อมต่อกบั Raspberry Pi โดยผ่านพอร์ต HDMI และแผน่ ทชัสกรีนแบบ Resistive เชื่อมต่อผา่ นพอร์ต USB
ก่อนการเริ่มตน้ ใชง้านจอ LCD Display จา เป็นตอ้งเขา้ไปปรับค่าความละเอียดของ หน้าจอให้ตรงก่อนซ่ึงต้องเพิ่มค่า Config ไว้ท้ายไฟล์ /boot/config.txt ใน SD Card ที่ติดต้ัง ระบบปฏิบตัิการไว้ดงัน้ี

โปรแกรม 2.1 การตั้งค่า Config ส าหรับจอ LCD Display

max_usb_current=1
hdmi_group=2
hdmi_mode=87

hdmi_cvt 800 480 60 6 0 0 0 hdmi_drive=1

### 2.1.5 Grow LED Strip

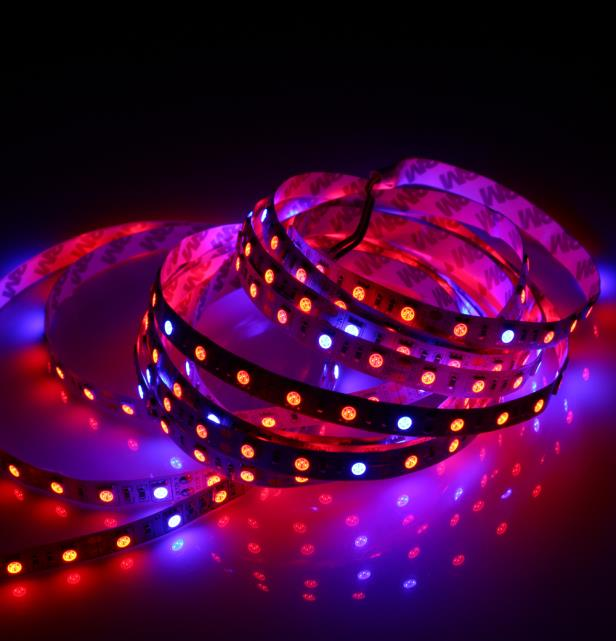
[picture p129: figure]

รูป 2.5 Grow LED Strip

ในแสงอาทิตย์ประกอบด้วย Color Spectrum ทุกสีโดยที่แสงแต่ละสีก็มีความยาว คลื่นที่แตกต่างกนั และความยาวคลื่นของแสงที่จา เป็นในการเจริญเติบโตของพืชน้นั มีเพียงแสงสี แดงกบัแสงสีน้า เงินเท่าน้นั โดยที่ความยาวคลื่นของแสงสีแดงอยูใ่ นช่วง 632nm~660nm และความ ยาวคลื่นของแสงสีน้า เงินอยใู่ นช่วง 440nm~460nm ซ่ึงความยาวคลื่นท้งั 2 ช่วงน้ีสามารถช่วยให้พืช เจริญเติบโตไดด้ีข้ึน ทา ให้สามารถใช้LED สีแดงผสมกบั LED สีน้า เงิน ในอตัราส่วน สีแดง 80% ต่อสีน้ าเงิน 20% ตามรูป 2.5 จะทา ให้เกิดเป็นแสงที่มีความยาวคลื่นตามที่พืชต้องการในการ เจริญเติบโตได้ทา ใหส้ ามารถปลูกพืชในที่ร่มได้
คุณสมบัติของ Grow LED Strip มีดงัน้ี
- Lamp Power 12 W
- Input Voltages 12 V / 24 V
- Lamp Luminous Flux 1080 -1200 lm
- Lamp Luminous Efficiency 80 lm/w
- Working Temperature -20 -60°C
- LED Wavelength Red:660nm, Blue:440nm

### 2.1.6 Waterproof Fan

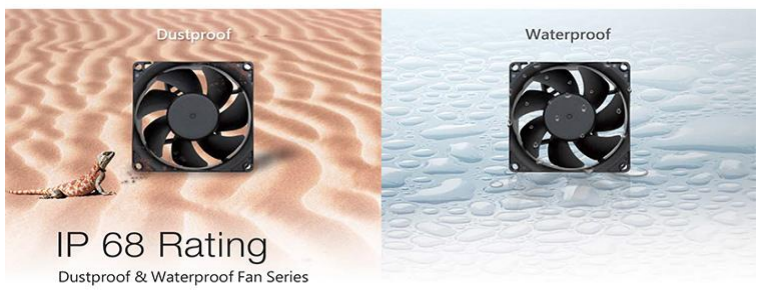
[picture p130: figure]

รูป 2. 6 Waterproof Fan

พดัลมระบายอากาศแบบกนั น้า ตามรูป 2.6 มีคุณสมบตัิดงัน้ี
- Power 2.28 W
- Power Current 190 mA
- Input Voltages 12 V
- Air Volume 50.3 CFM
- Speed 4100 RPM
- Static Pressure 0.27 Inch-H2O
- Noise 41.1 dB(A)
- Working Temperature -10 - 70°C

### 2.2 Service ที่ใช้ใน Platform

Platform น้ีใช้NodeJS เป็ น Service หลักในระบบ โดยมี MQTT Protocol library อยภู่ ายใน NodeJS ใช้ในการติดต่อกนั ระหว่าง Microcontroller, Platform และ Web Application และมี MySQL ในการจดัเก็บและจดัการขอ้มูล

### 2.2.1 NodeJS

NodeJS คือ การเขียนโปรแกรมด้วยภาษา JavaScript ที่ฝั่ง Server และมีการรัน ด้วย Chrome’s V8 JavaScript engine ซึ่งท าให้ NodeJS มีจุดเด่นอยูท่ ี่ความเร็วในการประมวลผล มี ความสามารถ Scalable network applications และสามารถรันได้บนหลายระบบปฏิบัติการ
NodeJS มีการท างานแบบ event-driven คือ การขับเคลื่อนด้วยเหตุการณ์ และ NodeJS ยงัมาพร้อมกบั เทคโนโลยีNon-Blocking I/O คือ ไม่จา เป็นตอ้งรอการทา งานของคา สั่ง อื่นๆที่ใชเ้วลานานให้เสร็จก่อน สามารถขา้มไปทา งานคา สั่งถดัไปไดเ้ลย นอกจากน้นั NodeJS ยังมี ความเป็ น Real-time Application อีกด้วย

### 2.2.2 MQTT

MQTT เป็ น Protocol ที่ถูกออกแบบมาให้ใช้ในการเชื่อมต่อระหว่างอุปกรณ์กบั อุปกรณ์ เพื่อสนับสนุนเทคโนโลยี IoT โดยใช้หลักการ Client / Server มี Topology แบบ hub and spoke โดยฝั่งPlatform ถูกเรียกวา่ Broker มีหน้าที่จัดการคิวรับ-ส่งของขอ้มูลระหวา่ ง Client และใช้ Topic เป็นตวัอา้งอิงฝั่ง Client เป็นไดท้ ้งั Publisher และ Subscriber ตามรูป 2.8

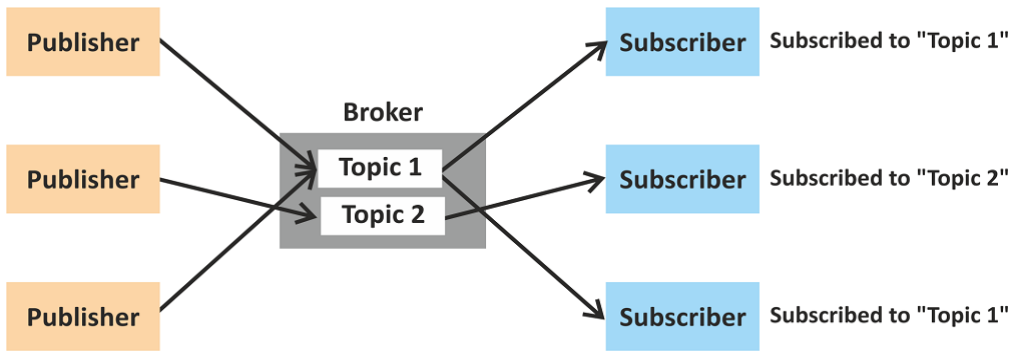
[picture p131: figure]

รูป 2.7 MQTT

หนา้ที่ของส่วนประกอบต่างๆของ MQTT คือ
1) Broker ทา หนา้ที่เป็นตวักลางคอยจดัการกบัขอ้ความที่ไดจ้าก Publisher แลว้ส่งไป ให้ Subscriber โดยอิงจาก Topic ที่ Subscriber ได้ Subscribe ไว้
2) Publisher และ Subscriber ทา การเชื่อมต่อไปยงั Broker ซ่ึงเชื่อมต่อได้2 วิธีคือ Persistent ที่สร้าง Session ค้างไวต้ลอดเวลาเพื่อติดต่อกับ Boker อีกวิธีคือ Transient ที่จ าท าให้ Boker ไม่สามารถติดตามสถานะได้
3) Topic เปรียบเสมือน Address บน Broker ที่ Client ท าการเชื่อมต่อเพื่อรับส่ง ขอ้ความต่างๆระหวา่ งกนั

### 2.2.3 Mosca

Mosca เป็ น MQTT Broker พี่พัฒนาโดยใช้ NodeJS ท าให้ Mosca มีความเร็วใน การอ่าน-เขียนขอ้ มูลไดอ้ยา่ งรวดเร็วโดยสามารถใชง้านแบบ Standalone หรือใช้งาน Embedded ใน NodeJS Application อื่นๆก็ได้

### 2.2.4 MySQL

ฐานขอ้ มูลมีลกั ษณะเป็นโครงสร้างของการเก็บรวบรวมขอ้ มูล การที่เขา้ถึงหรือ เปลี่ยนแปลงข้อมูลในฐานข้อมูลจึงจ าเป็ นต้องอาศัยระบบจัดการฐานข้อมูลเป็ นตัวกลางในการ จัดการข้อมูล และรองรับการท างานของ Application อื่นๆที่ตอ้งการใชง้านขอ้ มูลน้นั ๆ เพื่อความ สะดวกในการจัดการกบั ขอ้ มูลจา นวนมาก MySQL จึงทา หน้าที่เป็นท้งัตวัฐานขอ้ มูลและระบบ จัดการฐานข้อมูล
MySQL เป็ นระบบจัดการฐานข้อมูลแบบ Relational ซ่ึงทา การเก็บขอ้ มูลท้งัหมด ในแบบของตาราง ทา ให้ทา งานไดอ้ยา่ งรวดเร็วและมีความยืดหยุน่ นอกจากน้นั ตารางแต่ละตาราง สามารถเชื่อมโยงเข้าหากนั ทา ให้สามารถรวบหรือจดักลุ่มของขอ้ มูลไดต้ ามที่ตอ้งการโดยอาศยั ภาษา SQL
จุดเด่นของ MySQL คือ สามารถทา งานไดอ้ย่างรวดเร็ว น่าเชื่อถือใช้งานไดง้่าย และเป็ น Open Source ซ่ึงการพฒั นายงัคงดา เนินอยูอ่ ยา่ งต่อเนื่อง ทา ให้มีฟังก์ชนั่ การทา งานใหม่ๆ ที่อ านวยความสะดวกแก่ผูใ้ช้งานเพิ่มข้ึน รวบไปถึงการปรับปรุงประสิทธิภาพ ความเร็วในการ ท างาน และความปลอดภัย

### 2.3 Web Application

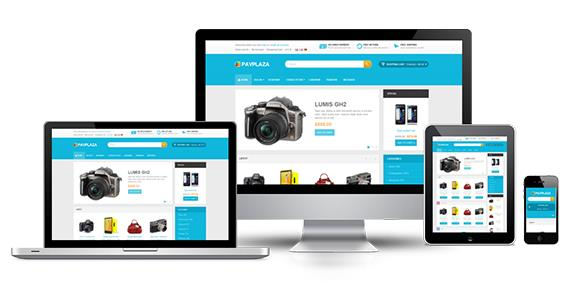
[picture p132: figure]

รูป 2.8 Web Application

Web Application คือ Application ที่ถูกเขียนข้ึนมาเพื่อเป็น Browser เพื่อใช้งาน Webpage ต่างๆ ตวัโปรแกรมของ Web Application ถูกติดต้งัไวท้ี่Platform เพื่อให้บริการกบั Client ซึ่งฝั่ง Client สามารถเป็ น Device ได้หลากหลายตามรูป 2.9 และฝั่ง Client ไม่จา เป็นตอ้งติดต้งัโปรแกรม เพิ่มเติมนอกจาก Web Browser และขอ้ มูลที่ส่งหากนั ระหว่าง Client กบั Server บนมาตรฐาน HTTP ทวั่ ไป

### 2.3.1 HTML

HTML ย่อมาจาก Hyper Text Mrkup Language เป็ นภาษาหลักที่ใช้ในการเขียน Webpage HTML ถูกพัฒนามาจากภาษา SGML และได้มีการพฒั นาต่อมาเรื่อยๆและก าหนด มาตรฐานโดย W3C มีโครงสร้างการเขียนโดยอาศัย Tag มาเพื่อควบคุมการแสดงผลของสิ่งต่างๆที่ แสดงผลอยบู่ นหนา้ Webpage และแต่ละ Tag สามารถมี Attribute อื่นๆเพิ่มเติมได้

### 2.4 Literature Review

### 2.4.1 TEMPERATUER & HUMIDTY CONTROL SYSTEM FOR MUSHROOM

งานวิจยัน้ีได้สร้างโรงเรือนเพาะเห็ดจา ลองและทา ระบบควบคุมอุณหภูมิและ ความช้ืนที่ควบคุมดว้ย Arduino MEGA 2560 R3 โดยใช้เซนเซอร์ DHT 22 และนา ค่าที่วดัไดไ้ป แสดงผลผา่ นจอ LCD Display
ภายในตูเ้พาะเห็ดใช้เครื่องพ่นหมอกแบบสเปรยจ์า นวน 3 ตวั ในการให้ความช้ืน ใชแ้อร์หนา้ต่างในการทา ความเยน็ และพดัลมส าหรับระบายอากาศจา นวน 2 ตวั ตามรูป 2.10 และ รูป 2.11

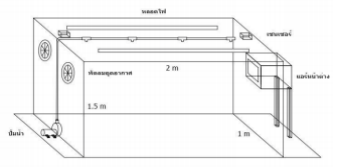
[picture p133: figure]

รูป 2.9รายละเอียดของส่วนประกอบภายในโรงเรือนจ าลอง

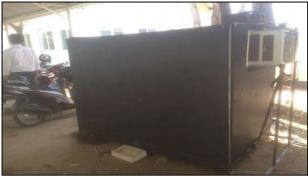
[picture p134: figure]

รูป 2.10 โรงเรือนเพาะเห็ดจ าลอง

หลกัการทา งานของอุปกรณ์ต่างๆ คือ เมื่อท าการเปิ ดเครื่อง เซนเซอร์ตรวจวัด อุณหภูมิและความช้ืน จากน้นั นา ไปแสดงผลผา่ นจอ LCD Display และทา การปรับค่าอุณหภูมิและ ความช้ืนตามตอ้งการ จากน้นั Arduino ควบคุมการทา งานของแอร์และเครื่องพ่นหมอกให้ได้ค่า สถานะต่างๆใกลเ้คียงตามค่าที่ต้งัไว้

### 2.4.2 WONDERFUL MUSHROOM PLANT

งานวิจยัน้ีไดท้ า ระบบควบคุมอุณหภูมิและความช้ืนที่ควบคุมดว้ย Arduino UNO R3 โดยใช้เซนเซอร์ AMT1001 ซ่ึงสามารถกา หนดค่าอุณหภูมิและความช้ืนตามที่ตอ้งการไดแ้ละ นา ไปแสดงผลผา่ นจอ LCD
ภายในตูเ้พาะเห็ดไดใ้ชเ้ครื่องพ่นหมอกแบบ Ultrasonic ในการใหค้วามช้ืนภายใน ตู้เพาะเห็ด ตามรูปที่ 2.12

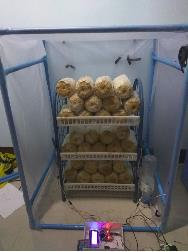
[picture p135: figure]

รูป 2.11 โรงเรือนเพาะเห็ดจ าลอง

### 2.4.3 Automatic Temperature and Humidity control system by using Fuzzy Logic

Algorithm for Mushroom nursery
งานวิจยัน้ีไดท้ า ระบบควบคุมอุณหภูมิและความช้ืนที่ควบคุมดว้ย Arduino UNO R3 โดยใช้เซนเซอร์ DHT 11 และใช้หลัก Fuzzy logic ในการควบคุมเครื่องพ่นหมอก พดัลม และ หลอดไส้
ภายในโรงเพาะเห็ดใชเ้ครื่องพ่นหมอกแบบสเปรยจ์า นวน 1 ตวัในการให้ความช้ืน พัดลมส าหรับระบายอากาศจ านวน 2 ตัว และหลอดไส้จ านวน 3 หลอดในการให้ความร้อนและแสง สวา่ ง
หลกัการทา งานคือเริ่มตน้ ทา การวดัค่าอุณหภูมิและความช้ืน จากน้นั Arduino สั่ง อุปกรณ์ท้งั 3 ตวั คือเครื่องพน่ หมอก พดัลม และหลอดไส้ใหท้ า งานดงัตารางที่2.1

ตาราง 2.1 หลักการท างานของ Fuzzy Logic

Input | Output
อุณหภูมิ | ความช้ืน | พัดลม | เครื่องพน่ หมอก | หลอดไส้
Low | Low | Off | Medium | High
Low | Medium | Off | Low | High
Low | High | Off | Off | Medium
Medium | Low | Off | Off | High
Medium | Medium | Off | Off | Off
Medium | High | Low | Off | Low
High | Low | High | Low | Off
High | Medium | High | Off | Off
High | High | High | Off | Off

จากตารางที่2.1ค่าของ Input เกิดจากสมการท้งั 3 สมการต่อไปน้ี

Medium (x) = exp (−

(x−m)

2
2σ²

) (1)

Higℎ (x) = exp (−

(x−m)

2
2σ1

2

) | (2) | เมื่อ σ1 = m − σ

Low (x) = exp (−

(x−m)

2
2σ2
2 ) | (3) | เมื่อ σ2 = m − σ1

และค่าของ Output เกิดจากการใช้Gaussian Membership Function ดงัต่อไปน้ี
1) พัดลมระบายอากาศมี 2 Fuzzy Sets คือ
a) Low ท าการเปิ ดพัดลมเพียง 1 ตัว
b) High ทา การเปิดพดัลมพร้อมกนั 2 ตวั
2) เครื่องพน่ หมอกมี3Fuzzy Sets คือ
a) Low ทา การเปิดหวัพน่ หมอกท้งัหมด 4 หวั
b) Medium ทา การเปิดหวัพน่ หมอกท้งัหมด 6 หวั
c) High ทา การเปิดหวัพน่ หมอกท้งัหมด 8 หวั
3) หลอดไส้มี 3 Fuzzy Sets คือ
a) Low ท าการเปิ ดหลอดไส้เพียง 1 ตัว
b) Medium ทา การเปิดหลอดไส้พร้อมกนั 2 ตวั
c) High ทา การเปิดหลอดไส้พร้อมกนั 3 ตวั

### บทที่ 3

## การวิเคราะห์ และออกแบบ

บทน้ีอธิบายถึงการวิเคราะห์และการออกแบบระบบ ซ่ึงแบ่งออกเป็นฝั่งโรงเรือนจา ลอง ฝั่ง Platform และฝั่ง Microcontroller โดยอธิบายเกี่ยวกบัความตอ้งการของระบบ โครงสร้างของระบบ และ Diagram ต่างๆที่เกี่ยวขอ้ง

### 3.1 ความต้องการของระบบ

1) สามารถต้งัค่าชุดขอ้มูลตามความเหมาะสมของเห็ดแต่ละชนิด
2) สามารถใชเ้ซนเซอร์วดัอุณหภูมิความช้ืน และระดบั น้า ภายในถงัน้า
3) สามารถผลิตหมอกไอน้า แสงและระบายอากาศไดต้ามความเหมาะสม
4) สามารถอ่านเขียนขอ้ มูลลงใน SD Card และส่งขอ้มูลไปยงัPlatform ผา่ น MQTT Protocol
5) มีจอ LCD ขนาด 5 นิ้ว สา หรับแสดงสถานะภายในตูเ้ห็ด
6) มี Web Application ให้ Login สา หรับจดัการและแสดงผลระบบท้งัหมด

### 3.2 โครงสร้างของระบบ

โครงสร้างของระบบจะจะแบ่งออกเป็น 2 ส่วน คือ ส่วนของSystem Diagram ตามรูป 3.1 และส่วนของ Hardware I/O Diagram ตามรูป3.2

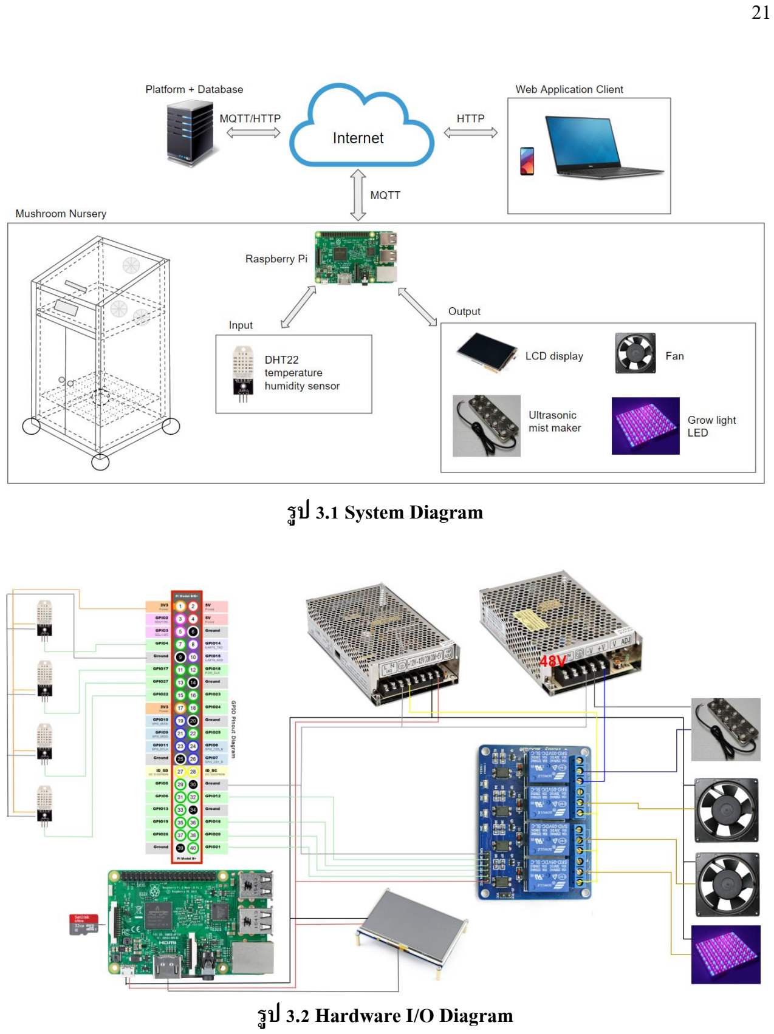
[picture p136: page 34]

รูป 3.1System Diagram

รูป 3.2 Hardware I/O Diagram

### 3.3 Sequence Diagram

Sequence Diagram จะมีรายละเอียดดังรูป 3.3

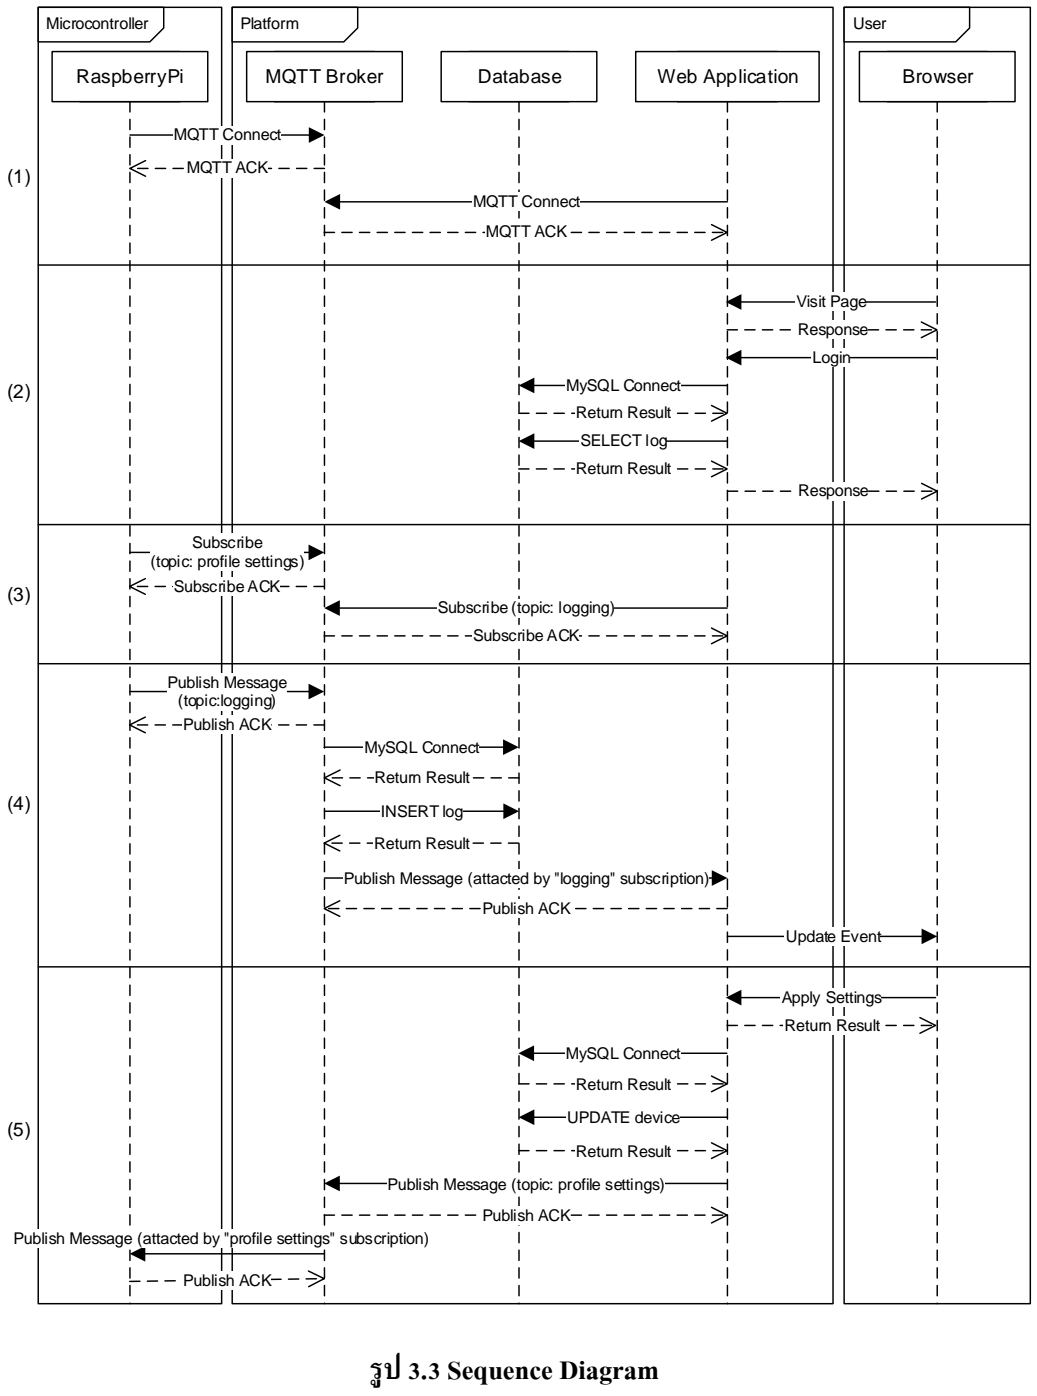
[picture p137: figure]
RaspberryPi; MQTT Broker; Database; Web Application; Browser; Microcontroller; Platform; User; MQTT Connect; MQTT ACK; Visit Page; Login; Subscribe (topic: profile settings); Subscribe ACK; Subscribe (topic: logging); Publish Message (topic:logging); MySQL Connect; INSERT log; Return Result; Update Event; Apply Settings; UPDATE device; Publish Message (topic: profile settings); SELECT log; Response; Publish ACK; รูป 3.3Sequence Diagram

Publish Message (attacted by "logging" subscription)

Publish Message (attacted by "profile settings" subscription)

ระบบมีการท างานแบบ Concurrency และ Event-driven ดงัน้นั การเขียนโครงสร้างแบบ Sequence Diagram ทา ให้เขา้ใจและมีประสิทธิภาพมากกวา่ Diagram ชนิดอื่น จากรูปภาพด้านบน แบ่งออกเป็น 5 สถานการณ์ดงัน้ี

### 3.3.1 MQTT Open Connection (1)

เมื่อเริ่มตน้ MQTT Broker Service ที่ฝั่ง Platform แล้ว ให้ Microcontroller และ Web Application Service ทา การติดต่อเขา้มาที่ Broker เพื่อใช้ในการรับ-ส่งขอ้มูลต่อไป

### 3.3.2 Web Browsing (2)

ผูใ้ช้งานติดต่อเข้ามาผ่าน Browser ตัว Web Application Service ติดต่อกับ ฐานข้อมูลเพื่อน าข้อมูลมาใช้งาน เมื่อเขา้มาแลว้แสดงในหนา้เขา้สู่ระบบ เมื่อเขา้สู่ระบบแลว้แสดง หน้า Dashboard สา หรับจดัการระบบต่อไป

### 3.3.3 Subscribe (3)

Microcontroller ท าการ Subscribe ไปที่ Platform ในหัวข้อ profile settings และ Web Application Service ท าการ Subscribe ไปที่ Platform ในหัวข้อ logging โดยเมื่อมีข้อมูล Publish เข้ามาในหัวข้อที่ได้ Subscribe ไว้ ท าให้ผู้ที่ Subscribe ไว้ที่รับข้อมูลด้วย

### 3.3.3 Publish (topic: logging) (4)

Microcontroller ส่งขอ้ มูลให้Platform ทา ให้มีเหตุการณ์เกิดข้ึน 3อย่างคือ เก็บ ขอ้ มูลที่ไดร้ับมาลงฐานขอ้ มูล, ส่งขอ้ มูลต่อไปที่Web Application Service และท าการอัพเดทหน้า เว็บ

### 3.3.3 Publish (topic: profile settings) (5)

ผูใ้ช้งานส่งขอ้ มูลให้Platform ท าให้ Web Application ท างานและมีเหตุการณ์ เกิดข้ึน 3อย่างคือแกไ้ขขอ้ มูลที่ไดร้ับมาลงฐานขอ้ มูล, ส่งขอ้ มูลต่อไปที่ Broker และ Broker ส่ง ขอ้มูลต่อไปที่Microcontroller

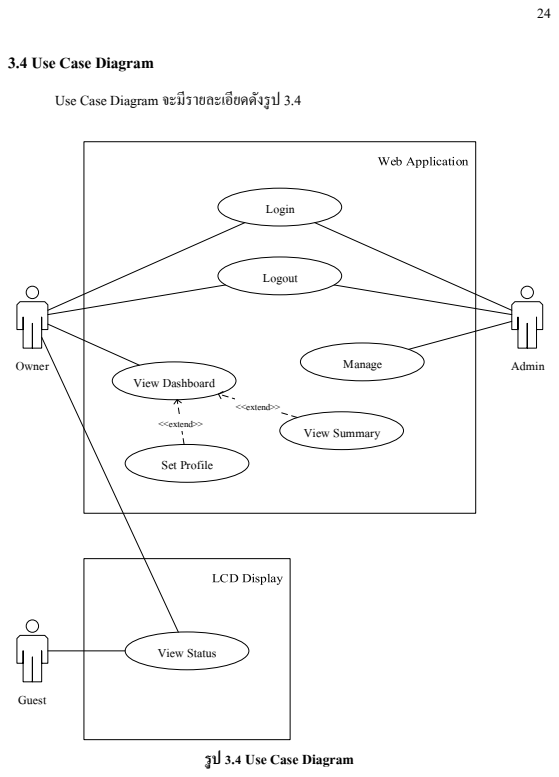
[picture p138: page 37]
Owner; Login; Guest; View Summary; Set Profile; View Status; View Dashboard; <<extend>>; Logout; Manage; Admin

3.4 Use Case Diagram
Use Case Diagram จะมีรายละเอียดดังรูป 3.4

รูป 3.4 Use Case Diagram

### 3.4.1 รายละเอียด Use Case

ตาราง 3.1 ถึงตาราง 3.5 ดา้นล่างต่อไปน้ีแสดงถึงรายละเอียดการใชง้านของแต่ละ Use Case ตามรูปแบบของ UML Use Case Description

ตาราง 3.1 Login Use Case

Use Case Name | Login
Actors | Owner, Admin
Use Case Purpose | เพื่อใชใ้นการเขา้สู่ระบบ
Pre-conditions | -
Post-conditions | เขา้สู่ระบบเพื่อเขา้หนา้จดัการขอ้มูลต่อไป
Main Course | 1.กรอก Username และ Password 2.กดปุ่ ม Login หรือ Enter 3.เขา้สู่ระบบเสร็จสิ้น
Exceptions | 1.Username หรือ Password ไม่ถูกตอ้ง 2.ไม่สามารถติดต่อกบัฐานขอ้ มูลได้

ตาราง 3.2 Logout Use Case

Use Case Name | Logout
Actors | Owner, Admin
Use Case Purpose | เพื่อใช้ในการออกจากระบบ
Pre-conditions | เขา้สู่ระบบมาแลว้ก่อนหนา้
Post-conditions | ออกสู่ระบบโดยสมบูรณ์
Main Course | 1.กดปุ่ ม Logout 2.ออกสู่ระบบเสร็จสิ้น
Exceptions | 1.ระบบภายในผิดพลาด

ตาราง 3.3 View Dashboard Use Case

Use Case Name | View Dashboard
Actors | Owner
Use Case Purpose | ใช้ในการแสดงและจัดการระบบ
Pre-conditions | เขา้สู่ระบบมาแลว้ก่อนหนา้
Post-conditions | -
Main Course | 1.แสดงผลประวตัิและกราฟต่างๆ 2.แกไ้ขProfile ต่างๆ
Exceptions | 1.ระบบภายในผิดพลาด 2.ใส่ขอ้มูลไม่ถูกตอ้ง

ตาราง 3.4 View Summary Use Case

Use Case Name | View Summary
Actors | Owner
Use Case Purpose | ใชใ้นการแสดงผลสรุปในรูปแบบต่างๆ
Pre-conditions | ใชร้่วมกบั View Dashboard
Post-conditions | -
Main Course | -
Exceptions | 1.ระบบภายในผิดพลาด

ตาราง 3.5Set Profile Use Case

Use Case Name | Set Profile
Actors | Owner
Use Case Purpose | ใชใ้นการต้งัค่าProfile
Pre-conditions | ใชร้่วมกบั View Dashboard
Post-conditions | -
Main Course | -
Exceptions | 1.ระบบภายในผิดพลาด

ตาราง 3.6 Manage User/Device Use Case

Use Case Name | Manage
Actors | Admin
Use Case Purpose | ใช้ในการจัดการระบบ
Pre-conditions | เขา้สู่ระบบมาแลว้ก่อนหนา้และมีสถานะเป็ น ผู้ดูแลระบบ
Post-conditions | -
Main Course | 1.จัดการ User, Farm และ Device
Exceptions | 1.ระบบภายในผิดพลาด 2.ใส่ขอ้มูลไม่ถูกตอ้ง

ตาราง 3.7Set Profile Use Case

Use Case Name | View Status
Actors | Owner, Guest
Use Case Purpose | ใช้ในการแสดงสถานะบนจอ LCD Display บนตู้เห็ดจ าลอง
Pre-conditions | -
Post-conditions | -
Main Course | 1.นิ้วกดบนจอสัมผสัเพื่อเลือกแสดงส่วนต่างๆ
Exceptions | 1.ระบบภายในผิดพลาด

### 3.5 Database Schema

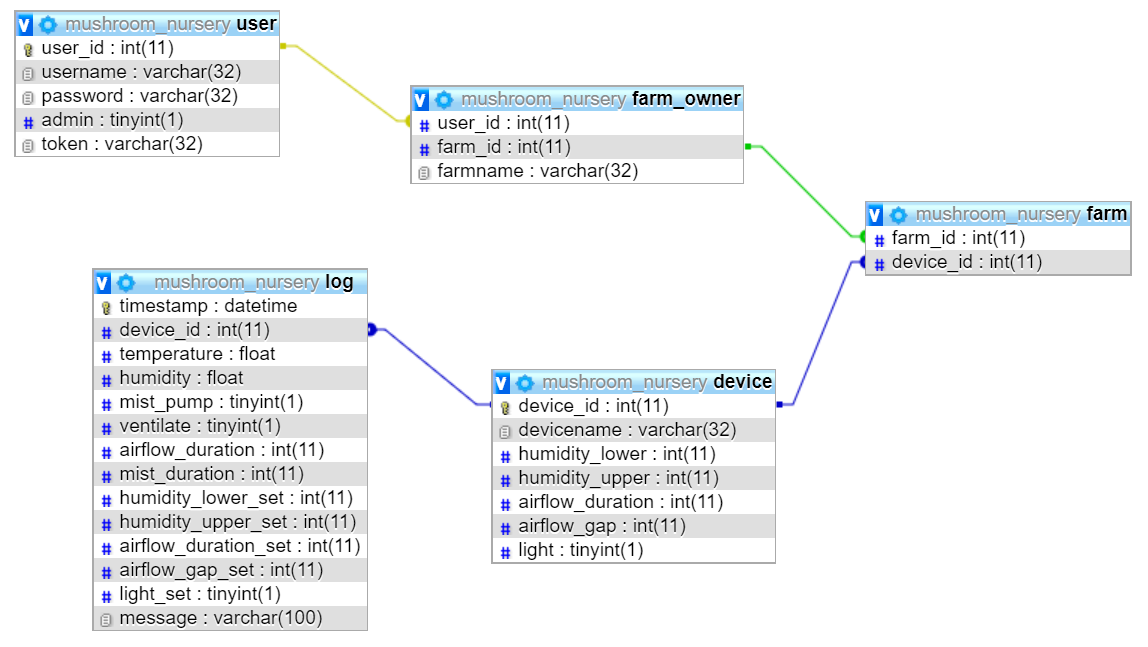
[picture p139: figure]

รูป 3.5 Database Schema

จากรู ป 3.5 จะแสดงโครงสร้างฐานข้อมูล โดยแบ่งออกเป็น 5 ตาราง มีรายละเอียด คา อธิบายแต่ละ Attribute ดงัน้ี

### 3.5.1 user

ใชเ้ก็บขอ้มูลของผใู้ชง้าน
1) user_id ขอ้ มูลประเภทเลขจา นวนเต็ม ใช้เก็บเลขไอดีของผูใ้ช้งาน เป็น Primary Key
2) username ขอ้มูลประเภทตวัอกัษรความยาวไม่เกิน 32 ตวั ใชเ้ก็บชื่อผใู้ชง้าน
3) password ขอ้มูลประเภทตวัอกัษรความยาวไม่เกิน 32 ตวั ใชเ้ก็บรหสัผา่ น
4) admin ขอ้มูลประเภทบูลีน ใชเ้ก็บสถานะผดูู้แลระบบ
5) token ขอ้ มูลประเภทตวัอกัษรความยาวไม่เกิน 32 ตัว ใชเ้ก็บ token ส าหรับเข้าถึง Web Application ของPlatform

### 3.5.2 farm_owner

ใชเ้ก็บขอ้มูลรายการฟาร์มของผู้ใช้งาน
1) user_id ข้อมูลประเภทเลขจ านวนเต็ม ใช้เก็บเลขไอดีของผูใ้ช้งาน เป็ น Unique Key
2) farm_id ข้อมูลประเภทเลขจ านวนเต็ม ใชเ้ก็บเลขไอดีของฟาร์ม เป็ น Unique Key
3) farmname ขอ้มูลประเภทตวัอกัษรความยาวไม่เกิน 32 ตัวใชเ้ก็บชื่อฟาร์ม

### 3.5.3 farm

ใชเ้ก็บขอ้มูลรายการอุปกรณ์ของฟาร์ม
1) farm_id ข้อมูลประเภทเลขจ านวนเต็ม ใชเ้ก็บเลขไอดีของฟาร์ม เป็ น Unique Key
2) device_id ข้อมูลประเภทเลขจ านวนเต็ม ใชเ้ก็บเลขไอดีของอุปกรณ์เป็ น Unique Key

### 3.5.3 device

ใชเ้ก็บขอ้มูลProfile ของ Mircocontroller
1) device_id ขอ้มูลประเภทเลขจา นวนเตม็ ใชเ้ก็บเลขอุปกรณ์เป็น Primary Key
2) devicename ขอ้มูลประเภทตวัอกัษรความยาวไม่เกิน 32 ตัวใชเ้ก็บชื่ออุปกรณ์
3) humidity_upper ข้อมูลประเภทเลขจ านวนเต็ม ใชเ้ก็บค่าช่วงความช้ืนสูงสุด
4) humidity_lower ข้อมูลประเภทเลขจ านวนเต็ม ใชเ้ก็บค่าช่วงความช้ืนต่

้
าสุด
5) airflow_duration ข้อมูลประเภทเลขจ านวนเต็ม ใชเ้ก็บค่าระยะเวลาที่ระบายอากาศ หน่วยเป็นนาที
6) airflow_gap ข้อมูลประเภทเลขจ านวนเต็ม ใชเ้ก็บค่าระยะเวลาที่พกัระบายอากาศ หน่วยเป็นนาที
7) light ขอ้มูลประเภทบูลีน ใชเ้ก็บค่าการในแสงในโรงเรือน

### 3.5.4 log

ใชเ้ก็บประวตัิของค่าที่ต่างๆในช่วงเวลาต่างๆ
1) timestamp ขอ้มูลประเภทวนั เวลา ใชเ้ก็บเวลา Unix Timestamp เป็ น Primary Key
2) device_id ข้อมูลประเภทเลขจ านวนเต็ม ใช้เก็บเลขอุปกรณ์เป็น Unique Keytemperature ข้อมูลประเภทเลขทศนิยมลอยตัว ใชเ้ก็บค่าอุณหภูมิณ ช่วงเวลา น้นั
3) humidity ข้อมูลประเภทเลขทศนิยมลอยตัว ใชเ้ก็บค่าความช้ืน ณ ช่วงเวลาน้นั
4) mist_pump ข้อมูลประเภทบูลีน ใชเ้ก็บค่าสถานะกา ลงัใชง้านเครื่องทา หมอก
5) ventilate ข้อมูลประเภทบูลีน ใชเ้ก็บค่าสถานะกา ลงัใชง้านระบายอากาศ

6) airflow_duration ข้อมูลประเภทเลขจ านวนเต็ม ใชเ้ก็บค่าระยะเวลาเครื่องทา หมอก ทา งานต้งัแต่เปิดเครื่อง
7) mist_duration ข้อมูลประเภทเลขจ านวนเต็ม ใช้เก็บค่าระยะเวลาระบายอากาศ ต้งัแต่เปิดเครื่อง
8) humidity_upper_set ข้อมูลประเภทเลขจ านวนเต็ม ใชเ้ก็บค่าช่วงความช้ืนสูงสุด
9) humidity_lower_set ข้อมูลประเภทเลขจ านวนเต็ม ใชเ้ก็บค่าช่วงความช้ืนต่า สุด
10) airflow_duration_set ข้อมูลประเภทเลขจ านวนเต็ม ใช้เก็บค่าระยะเวลาที่ระบาย อากาศหน่วยเป็นนาที
11) airflow_gap_set ข้อมูลประเภทเลขจ านวนเต็ม ใช้เก็บค่าระยะเวลาที่พกัระบาย อากาศหน่วยเป็นนาที
12) light ข้อมูลประเภทบูลีน ใชเ้ก็บค่าการในแสงในโรงเรือน
13) message ข้อมูลประเภทตัวอักษรความยาวไม่เกิน 100 ตัว ใช้เก็บข้อความที่ ต้องการ เช่น error, note, comment, information เป็ นต้น

### 3.6 MQTT Design

มีระบบ Authenticate เพื่อยืนยันอุปกรณ์ข้อมูลที่ใช้สา หรับติดต่อสื่อสารเป็นรูปแบบ JSON แล้วให้ JavaScript แปลงเป็ น Object เพื่อใชง้านต่อไป โดยแบ่ง Topic เพื่อใชใ้นงานดา้นต่างๆดงัน้ี 3.5.1profile settings
ใช้ส าหรับต้งัค่าโปรไฟล์ของอุปกรณ์โดยส่งขอ้ มูลจากPlatform ไปยังอุปกรณ์ โดยมีรายละเอียดดงัน้ี
1) device_id หมายเลขไอดีของอุปกรณ์
2) humidity_lowerค่าการต้งัค่าความช้ืนต ่าสุด
3) humidity_upperค่าการต้งัค่าความช้ืนสูงสุด
4) airflow_durationค่าการต้งัค่าระยะเวลาระบายอากาศ
5) airflow_gapค่าการต้งัค่าระยะเวลาพักระบายอากาศ
6) lightค่าการต้งัค่าการใช้แสง

### 3.5.1 logging

ใช้ส าหรับส่งประวตัิโปรไฟล์และสถานะต่างๆของอุปกรณ์โดยส่งขอ้ มูลจากอุ ปกรณ์ไปยัง Platform โดยมีรายละเอียดดงัน้ี
1) device_id หมายเลขไอดีของอุปกรณ์
2) temperatureค่าอุณหภูมิณ เวลาน้นั
3) humidityค่าความช้ืน ณ เวลาน้นั
4) mist_pumpค่าการทา งานของเครื่องทา หมอก
5) ventilateค่าการทา งานของระบายอากาศ
6) airflow_durationค่าระยะเวลาระบายอากาศท้งัหมด ต้งัแต่เปิดเครื่อง
7) mist_durationค่าระยะเวลาทา งานของเครื่องทา หมอกท้งัหมด ต้งัแต่เปิดเครื่อง
8) humidity_lower_setค่าการต้งัค่าความช้ืนต่า สุด
9) humidity_upper_setค่าการต้งัค่าความช้ืนสูงสุด
10) airflow_duration_setค่าการต้งัค่าระยะเวลาระบายอากาศ
11) airflow_gap_setค่าการต้งัค่าระยะเวลาพกัระบายอากาศ
12) light_setค่าการต้งัค่าการใชแ้สง
13) messageข้อความจากอุปกรณ์

### บทที่ 4

## การทดลองและผลการทดลอง

บทน้ีเป็นการทดลองต่างๆ ท้ังส่วนโรงเรือนเพาะเห็ด ส่วน Platform และส่วน Web Application และการเชื่อมต่อท้งั 3 ส่วนเขา้ดว้ยกนัผา่ น MQTT Protocol โดยไดท้ า การทดลองดงัน้ี
1. สร้างตู้จ าลองโรงเรือนเพาะเห็ด
2. การทดลองรับ-ส่งขอ้มูลระหวา่ ง Raspberry Pi และ Platform โดยใช้ MQTT Protocol
3. การดึงค่าจาก Back-End ที่ติดต่อกบั MySQL มาแสดงผลบน Web Application
4. การควบคุมระบบต่างๆภายในโรงเรือนผา่ น Web Application
5. การควบคุมระบบต่างๆภายในโรงเรือนผา่ นจอ LCD หน้าโรงเรือน
6. การทดลองเพาะเห็ดโดยใช้Platform ในการควบคุมสภาพแวดล้อมภายในตู้จ าลอง โรงเรือนเพาะเห็ด

### 4.1 สร้างตู้จ าลองโรงเร

ื

อนเพาะเห็ด
4.1.1วตัถุประสงค์
เพื่อจา ลองระบบโรงเรือนที่มีการเพาะเล้ียงเห็ดที่สามารถควบคุมความช้ืนและ อุณหภูมิได้โดยใช้ Microcontroller

### 4.1.2 วิธีการทดลอง

สร้างตูจ้า ลองโรงเรือนเพาะเห็ดจา ลองข้ึนจากPlastwood โดยโรงเรือนมีขนาด 1x1x1.5 เมตรและไดม้ีการแบ่งส่วนสา หรับเพาะเห็ดและส่วนแผงควบคุมออกจากกนั ดงัน้ี
1) ส่วนส าหรับเพาะเห็ด ประกอบไปด้วยช้ันก้อนเห็ด มีเซนเซอร์วัดอุณหภูมิและ ความช้ืน เซนเซอร์วดัระดบั น้า เครื่องทา หมอก พัดลมระบายอากาศ ไฟ LED
2) ส่วนแผงควบคุม มีRaspberry Pi ที่คอยรับค่าต่างๆจากเซนเซอร์และควบคุมการ ท างานของอุปกรณ์ภายในโรงเรือน และจอ LCD เพื่อแสดงสถานะต่างๆ

### 4.1.3 ผลการทดลอง

สร้างตู้จ าลองโรงเรือนเพาะเห็ดโดยมีส่วนของตูแ้ยกออกเป็น 2 ส่วน คือภายในตู้ เป็ นส่วนสา หรับเพาะเห็ดตามรูป 4.1และด้านบนตู้จะเป็ นส่วนแผงควบคุมตามรูป 4.2

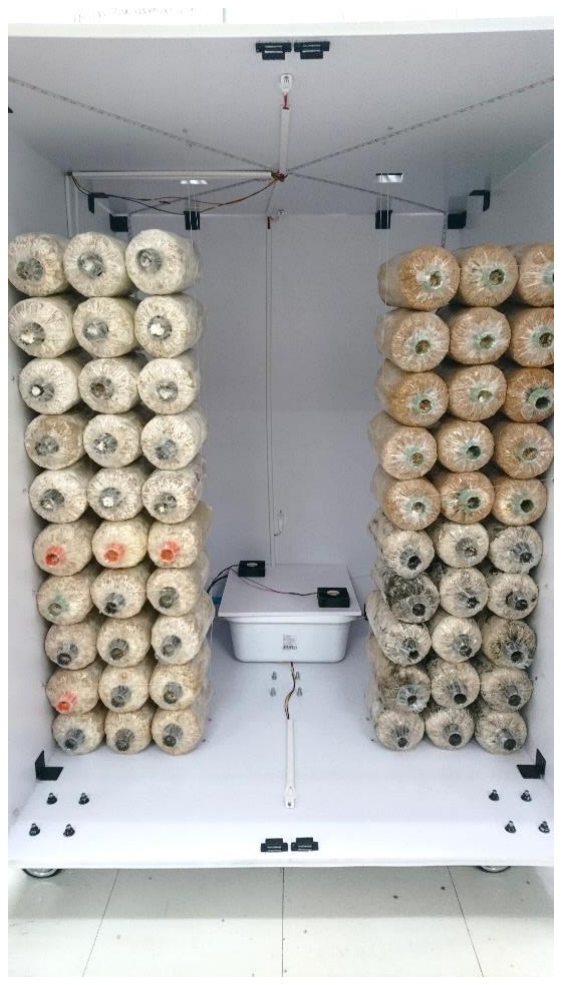
[picture p140: figure]

รูป 4.1 ส่วนส าหรับเพาะเห็ด

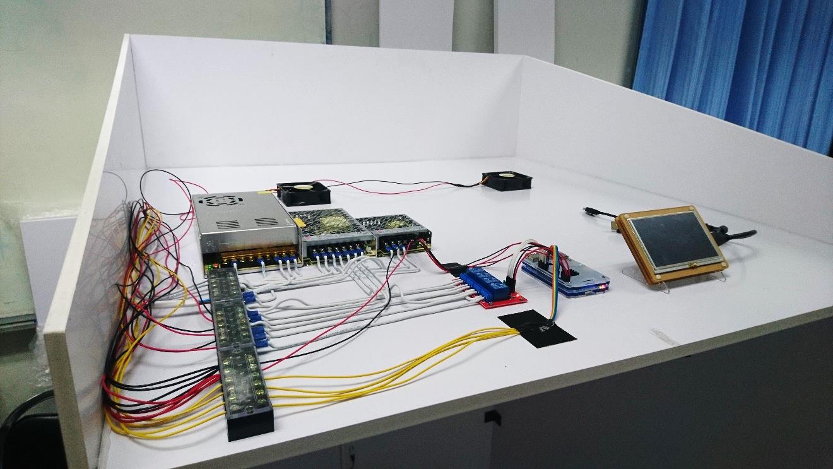
[picture p141: figure]

รูป 4.2 ส่วนแผงควบคุม

### 4.2 การทดลองรับ-ส่งข้อมูลระหว่าง Raspberry Pi และ Platform โดยใช้ MQTT

Protocol
4.2.1วตัถุประสงค์
เพื่อส่งขอ้มูลอุณหภูมิและความช้ืนที่วดัไดจ้าก Raspberry Pi ไปแสดงบน Platform

### 4.2.2 วิธีการทดลอง

1) ติดต้งัระบบปฏิบตัิการ NOOBS (New Out Of Box Software) บน Raspberry Pi
2) ติดต้งัระบบปฏิบตัิการ Ubuntu บน Platform
3) เขียนโปรแกรม Microservice บน Platform โดยใช้ NodeJS และ Mosca ตาม โปรแกรม 4.1

โปรแกรม 4.1 การตั้งค่าโปรแกรมเพื่อทดลอง Create MQTT Broker

var mosca = require('mosca');

var ascoltatore = {
//using ascoltatore
type: 'mongo',
url: 'mongodb://localhost:27017/mqtt', pubsubCollection: 'ascoltatori', mongo: {}

};

var settings = {
port: 1883

};

var server = new mosca.Server(settings);

server.on('clientConnected', function(client) { console.log('client connected', client.id); });

// fired when a message is received server.on('published', function(packet, client) { console.log('Published', packet.payload);
});

server.on('ready', setup);

// fired when the mqtt server is ready function setup() {
console.log('Mosca server is up and running');

}

4. เขียนโปรแกรม Microservice บน Raspberry Pi โดยใช้ NodeJS และ MQTT ตาม โปรแกรม 4.2

โปรแกรม 4.2 การตั้งค่าโปรแกรมเพื่อทดลอง Open Connection, Subscribe และ Publish

var mqtt = require('mqtt')
var client = mqtt.connect('mqtt://test.mosquitto.org')

client.on('connect', function () { client.subscribe('presence') client.publish('presence', 'Hello mqtt')
})

client.on('message', function (topic, message) { // message is Buffer
console.log(message.toString())
client.end()
})

### 4.2.3 ผลการทดลอง

Platform สามารถรับข้อมูลจาก Raspberry Pi ผา่ น MQTT Protocol บนมาตรฐาน IP โดยการปรับแต่งให้Microcontroller และ Platform สามารถเขา้กนัได้

4.3การดึงค่าจาก Back-End ที่ติดต่อกับ MySQL มาแสดงผลบน Web Application 4.3.1วตัถุประสงค์
เพื่อดึงค่าอุณหภูมิความช้ืน และค่า Profile ต่างๆที่ได้ต้งัค่าและถูกเก็บไว้ใน MySQL มาแสดงผลบนหน้า Dashboard ใน Web Application

### 4.3.2 วิธีการทดลอง

เขียน Code SQL เพื่อ query ขอ้มูลส่วนที่ตอ้งการออกมา แลว้นา มาเก็บในรูปแบบ Object ของ JavaScript เพื่อส่งขอ้มูลผา่ น Socket.io ไปยัง Front-End

### 4.3.3 ผลการทดลอง

หน้า Dashboard ตามรูป 4.3 จะสามารถแสดงผลค่าอุณหภูมิและความช้ืนปัจจุบนั ภายในโรงเรือนได้และสามารถแสดงการฟยอ้นหลงัไดท้ ้งัอุณหภูมิและความช้ืน นอกจากน้นั ยงั สามารถแสดงระยะเวลาการทา งานท้งัหมดของพดัลมระบายอากาศกบั เครื่องทา หมอก

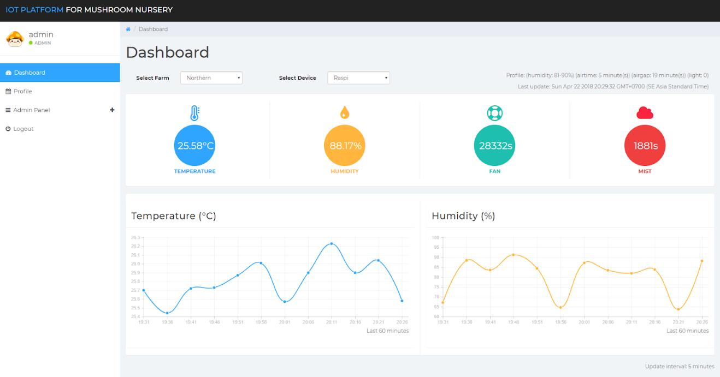
[picture p142: figure]

รูป 4.3 Dashboard

4.4การควบคุมระบบต่างๆภายในโรงเร

ื

อนผ่าน Web Application
4.4.1วตัถุประสงค์
เพื่อออกแบบระบบ Web Application ส าหรับแสดงสถานะและควบคุมระบบ ภายในโรงเรือนเพาะเห็ด

4.5การควบคุมระบบต่างๆภายในโรงเร

ื

อนผ่านจอ LCD หน้าโรงเรือน

### 4.5.1 วตัถุประสงค์

เพื่อออกแบบ Dashboard ส าหรับจอ LCD หน้าโรงเรือน เพื่อใช้แสดงสถานะและ ควบคุมระบบภายในโรงเรือนเพาะเห็ด

### 4.5.2 วิธีการทดลอง

ออกแบบหน้า Dashboard ตามรูป 4.11 ส าหรับใช้แสดงสถานะและควบคุมระบบ ต่างๆภายในโรงเรือน โดยจอ LCD มีขนาด 800x480 โดยหน้า Dashboard จะมีรายละเอียดหลักๆ ดงัน้ี

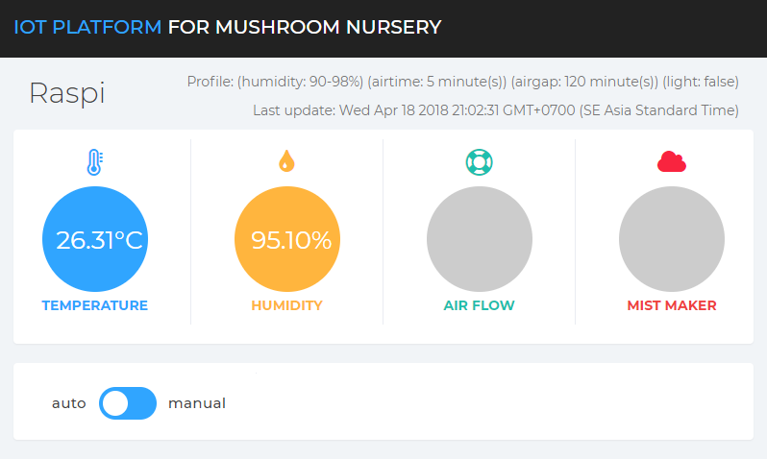
[picture p143: figure]

รูป 4.4 Dashboard ส าหรับจอ LCD(1)

โดยด้านบนจะแสดงชื่อ Device, Profile ที่ได้ต้งัค่าไว้และเวลาล่าสุดที่แสดง ส่วนกลางจะเป็นรายละเอียดหลกั ท้งั 4 อย่าง ประกอบไปด้วย อุณหภูมิความช้ืน พัดลมระบาย อากาศ และเครื่องทา หมอกโดยส่วนอุณหภูมิความช้ืนน้นั จะแสดงเป็นค่าปัจจุบนั ตามที่วดัค่าได้ ภายในตูเ้พาะเห็ด และส่วนพดัลมระบายอากาศ และเครื่องทา หมอกเมื่อทา การเปิดการทา งานจะมี ไฟแสดงแสดงสถานะปรากฎข้ึน โดยจะเปิดการทา งานก็ต่อเมื่อค่าความช้ืนอยู่ต่า กว่าค่าที่ต้งัค่าไว้ ใน Profile ตามรูป 4.12

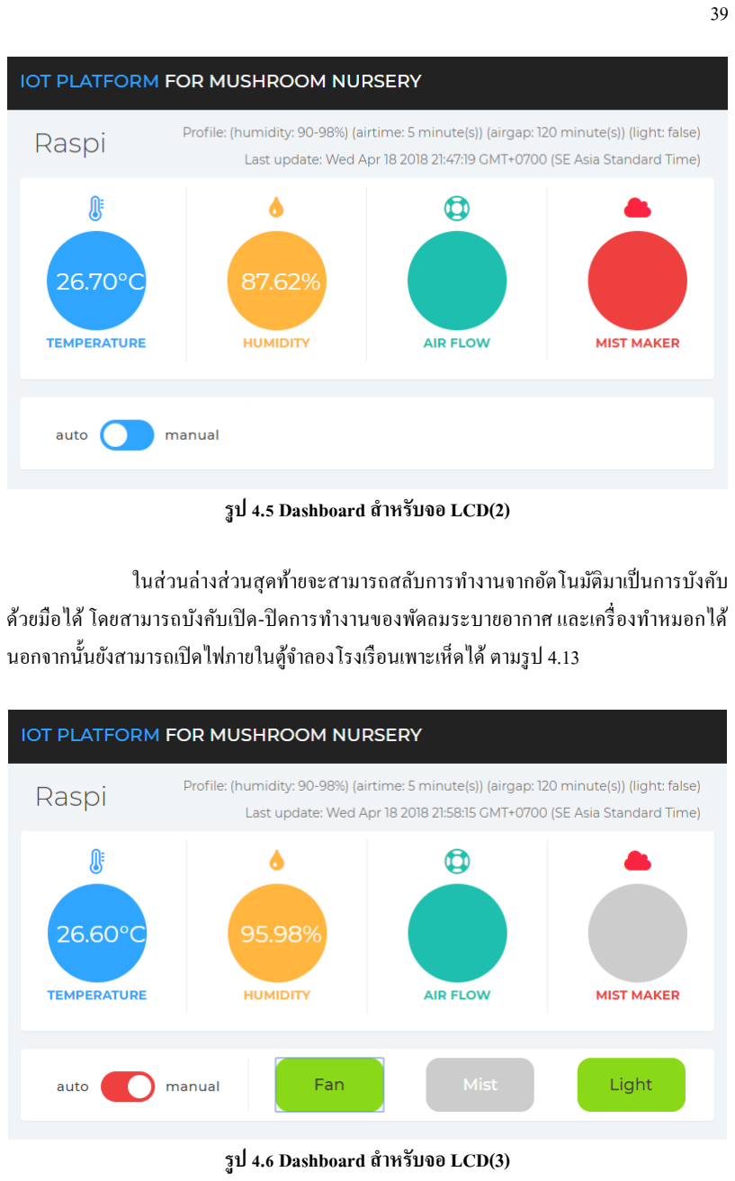
[picture p144: page 52]

รูป 4.5 Dashboard ส าหรับจอ LCD(2)

ในส่วนล่างส่วนสุดทา้ยจะสามารถสลบัการทา งานจากอตัโนมตัิมาเป็นการบงัคบั ด้วยมือได้ โดยสามารถบังคับเปิ ด-ปิ ดการท างานของพัดลมระบายอากาศ และเครื่องท าหมอกได้ นอกจากน้นัยงัสามารถเปิดไฟภายในตูจ้า ลองโรงเรือนเพาะเห็ดได้ตามรูป 4.13

รูป 4.6 Dashboard ส าหรับจอ LCD(3)

### 4.5.1 ผลการทดลอง

หน้า Dashboard สามารถแสดงค่าอุณหภูมิและความช้ืนปัจจุบนั ภายในโรงเรือนได้ และเมื่อความช้ืนต่า กวา่ ที่กา หนดไวพ้ ดัลมระบายอากาศ และเครื่องทา หมอกก็จะทา งาน ทา ให้ไฟ แสดงสถานะติด และเมื่อสลับการควบคุมจากอัตโนมัติเป็ นการควบคุมด้วยมือแล้วสามารถบังคับ เปิ ด-ปิ ด พัดลมระบายอากาศ, เครื่องท าหมอก และไฟภายในโรงเรือนได้

### 4.4.2 วิธีการทดลอง

ออกแบบ Web Application สา หรับใชแ้สดงสถานะและควบคุมระบบต่างๆภายใน โรงเรือน โดยจะแบ่งออกเป็น 4 ส่วน คือ หน้า Login, หน้า Dashboard, หน้า Profile และหน้า Admin Panel
หน้า Login ตามรูป 4.4 มีรายละเอียดคือ ช่องสา หรับใส่ Username และPassword เพื่อเข้าใช้งาน

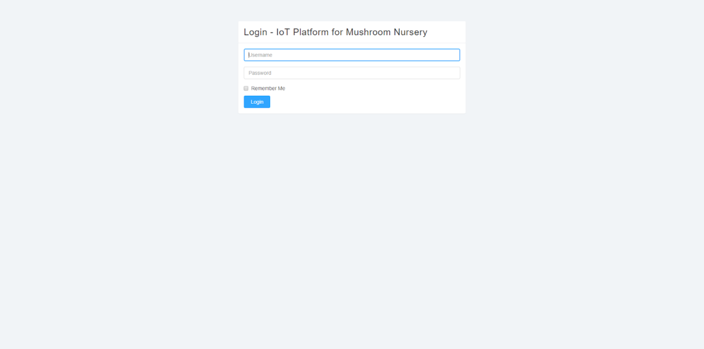
[picture p145: figure]

รูป 4.7 หน้า Login

หน้า Dashboard ตามรูป 4.5 จะสามารถเลือกฟาร์มและ Device เพื่อแสดงอุณหภูมิ และความช้ืนจากค่าที่วดัได้ภายในโรงเรือน พัดลมระบายอากาศ และเครื่องท าหมอกจะแสดง ระยะเวลาทา งานท้งัหมดเป็นวินาทีและกราฟแสดงรายละเอียดย้อนหลังส าหรับอุณหภูมิและ ความช้ืน

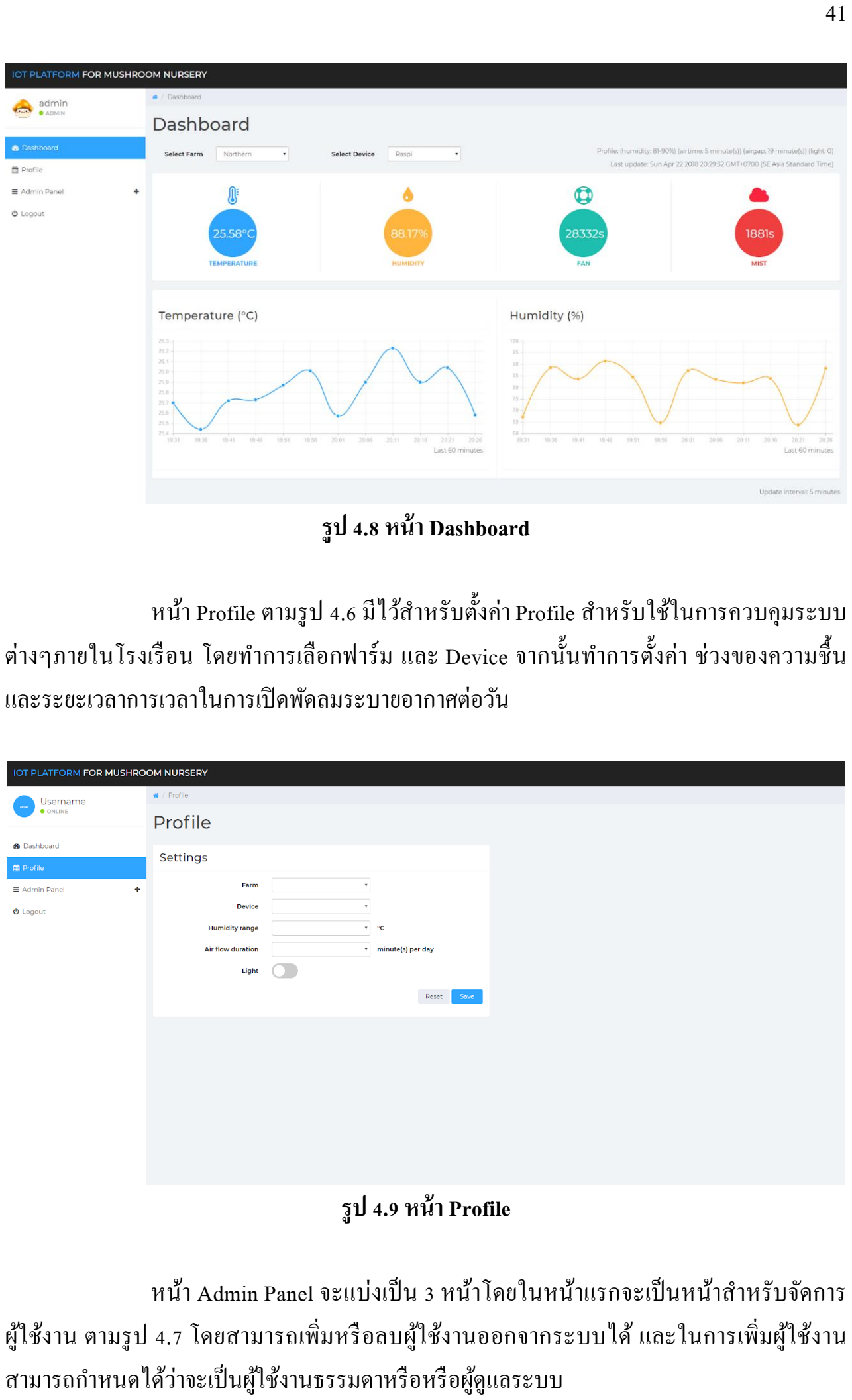
[picture p146: page 54]

รูป 4.8 หน้า Dashboard

หน้าProfile ตามรูป 4.6 มีไวส้ าหรับต้งัค่าProfile ส าหรับใช้ในการควบคุมระบบ ต่างๆภายในโรงเรือน โดยท าการเลือกฟาร์ม และ Device จากน้นั ทา การต้งัค่า ช่วงของความช้ืน และระยะเวลาการเวลาในการเปิดพดัลมระบายอากาศต่อวนั

รูป 4.9 หน้า Profile

หน้า Admin Panel จะแบ่งเป็น 3 หน้าโดยในหน้าแรกจะเป็ นหน้าส าหรับจัดการ ผู้ใช้งาน ตามรูป 4.7 โดยสามารถเพิ่มหรือลบผูใ้ช้งานออกจากระบบได้และในการเพิ่มผูใ้ช้งาน สามารถกา หนดไดว้า่ จะเป็นผใู้ชง้านธรรมดาหรือหรือผดูู้แลระบบ

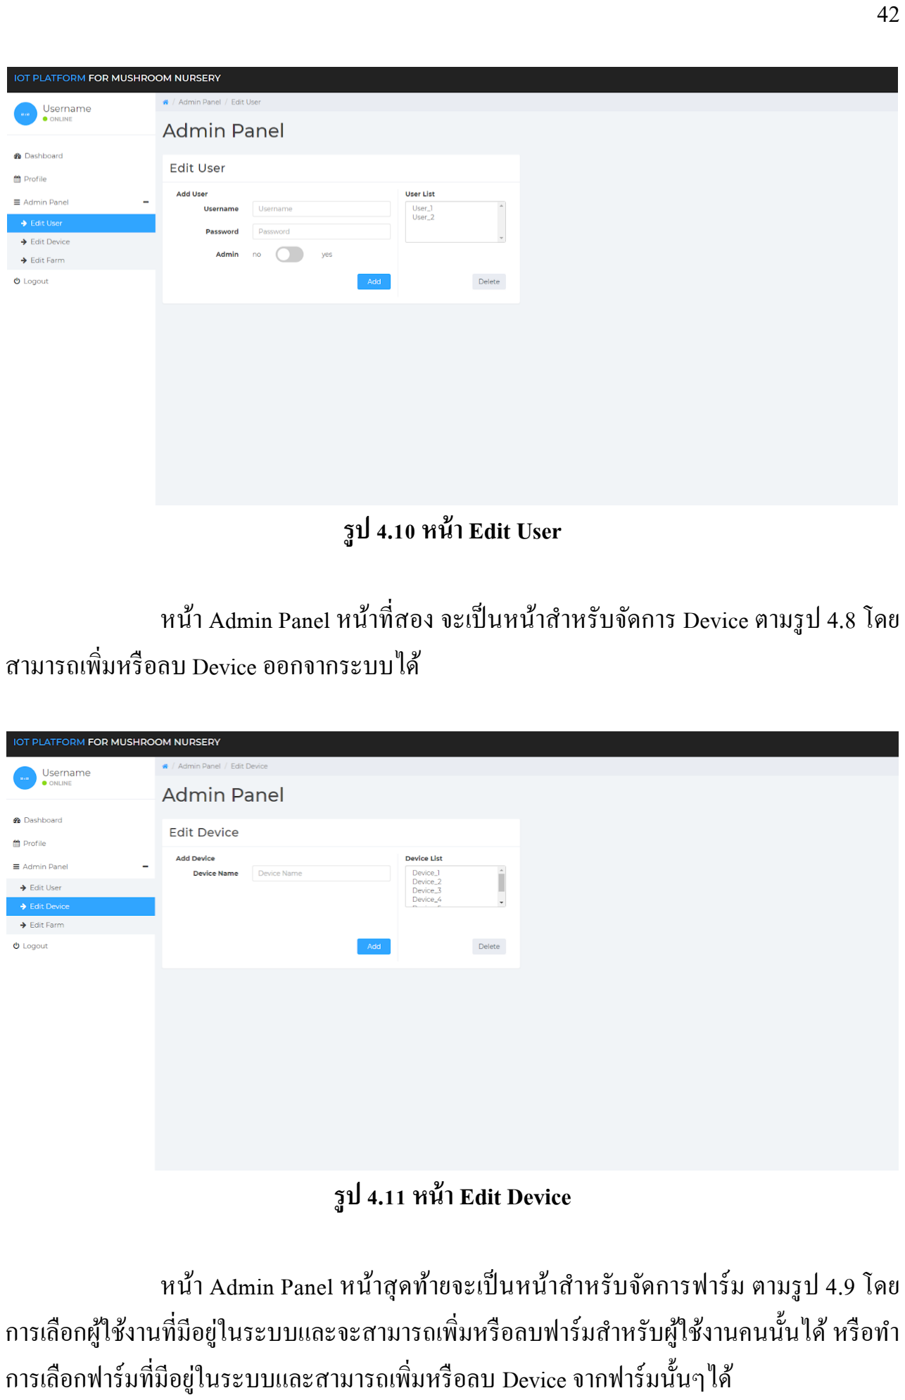
[picture p147: page 55]

รูป 4.10 หน้า Edit User

หน้า Admin Panel หน้าที่สอง จะเป็ นหน้าส าหรับจัดการ Device ตามรูป 4.8 โดย สามารถเพิ่มหรือลบ Device ออกจากระบบได้

รูป 4.11 หน้า Edit Device

หน้า Admin Panel หน้าสุดท้ายจะเป็ นหน้าส าหรับจัดการฟาร์ม ตามรูป 4.9 โดย การเลือกผใู้ชง้านที่มีอยใู่ นระบบและจะสามารถเพิ่มหรือลบฟาร์มสา หรับผใู้ชง้านคนน้นัได้หรือทา การเลือกฟาร์มที่มีอยใู่ นระบบและสามารถเพิ่มหรือลบ Device จากฟาร์มน้นั ๆได้

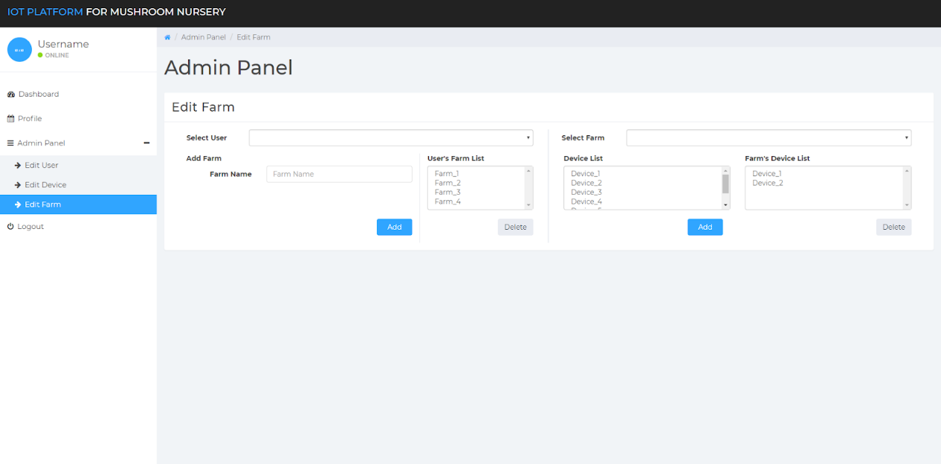
[picture p148: figure]

รูป 4.12หน้า Edit Farm

### 4.4.3 ผลการทดลอง

หน้า Login เมื่อใส่ Username และ Password ถูกจะสามารถเขา้ระบบไดแ้ ต่ถา้ใส่ ผดิจะไม่สามารถเขา้สู้ระบบได้ตามรูป 4.10

รูป 4.13 alert message

หน้า Dashboard สามารถเลือกฟาร์มและ Device ที่จะแสดงรายละเอียดได้และ รายละเอียดต่างๆที่แสดงมีความถูกตอ้งสมบูรณ์
หน้า Profile สามารถเลือกฟาร์มและ Device เพื่อต้งัค่าProfile ให้ Device น้นั ๆได้ และเมื่อทา การต้งัค่าProfile เสร็จจะอัพเดท Profile น้นั เขา้สู่ระบบ
หน้า Admin Panel สามารถจัดการผู้ใช้งาน Device และฟาร์มได้โดยสามารถเพิ่ม หรือลบผู้ใช้งานและ Device จากระบบได้และสามารถเพิ่มหรือลบฟาร์มใหผ้ใู้ชง้านที่มีอยใู่ นระบบ ได้และสามารถเพิ่มหรือลบ Device ที่มีอยใู่ นระบบใหฟ้ าร์มที่ตอ้งการได้

4.6การทดลองเพาะเห็ดโดยใช้Platform ในการควบคุมสภาพแวดล้อมภายในตู้จ าลอง โรงเรือนเพาะเห็ด
4.6.1วตัถุประสงค์
เพื่อทดสอบประสิทธิภาพของ Platform ว่าสามารถช่วยในการเพาะเห็ดภายใน โรงเรือนภายใตส้ ภาพแวลลอ้ มที่กา หนดได้

### 4.6.2 วิธีการทดลอง

ท าการเพาะเห็ดจ านวน 4 ชนิดในตู้จ าลองโรงเรือนเพาะเห็ด ตามรูป 4.14 โดยมี เห็ดดงัน้ี
1. เห็ดนางรมฮงัการีอยดู่ า้นบนซา้ยของรูป
2. เห็ดนางนวลสีชมพูอยดู่ า้นบนขวาของรูป
3. เห็ดนางฟ้าภูฐาน อยดู่ า้นล่างซา้ยของรูป
4. เห็ดเป๋าฮ้ืออยดู่ า้นล่างขวาของรูป

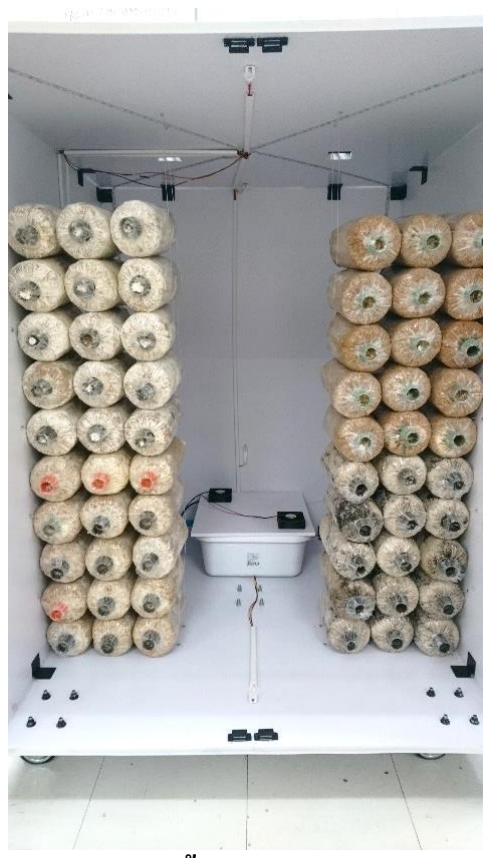
[picture p149: figure]

รูป 4.14 เห็ดท้งั4 ชนิดในตู้เพาะเห็ด

โดยกา หนดค่าProfile ดังรูป 4.15

รูป 4.15 ค่า Profile ส าหรับการเพาะเห็ด

จากน้นั ทา การติดตามการเจริญเติบโตของเห็ดเป็ นระยะเวลา 2 สัปดาห์ โดยท าการ เก็บขอ้มูลเป็ นถ่ายรูปบนั ทึกดงัตาราง 4.1

ตาราง 4.1อัตราการเจริญเติบโตของเห็ด
วันที่ | รูป
1 -2

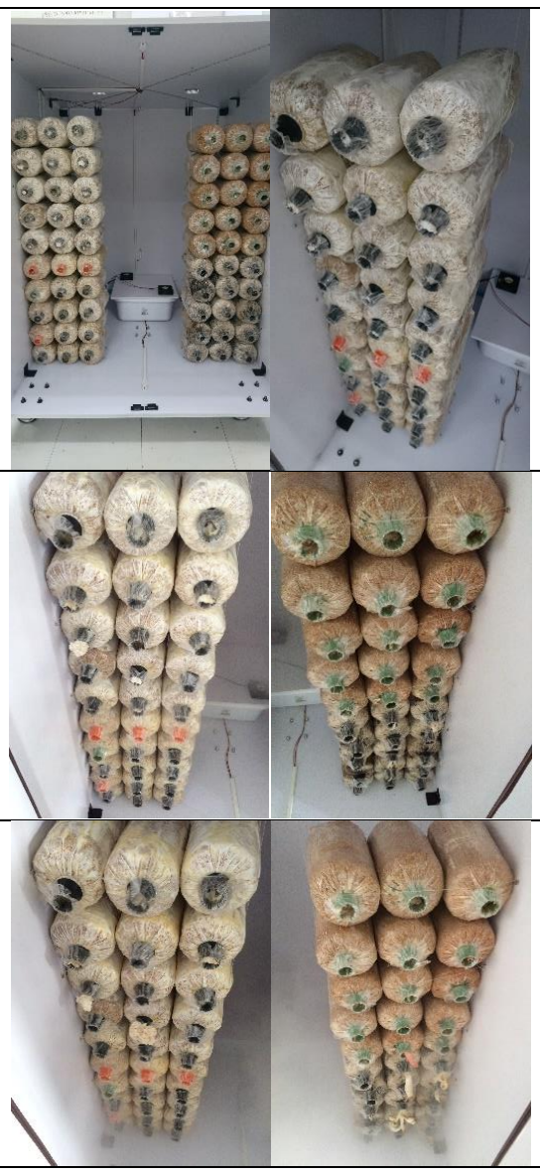
[picture p150: figure]

3 -4

5 -6

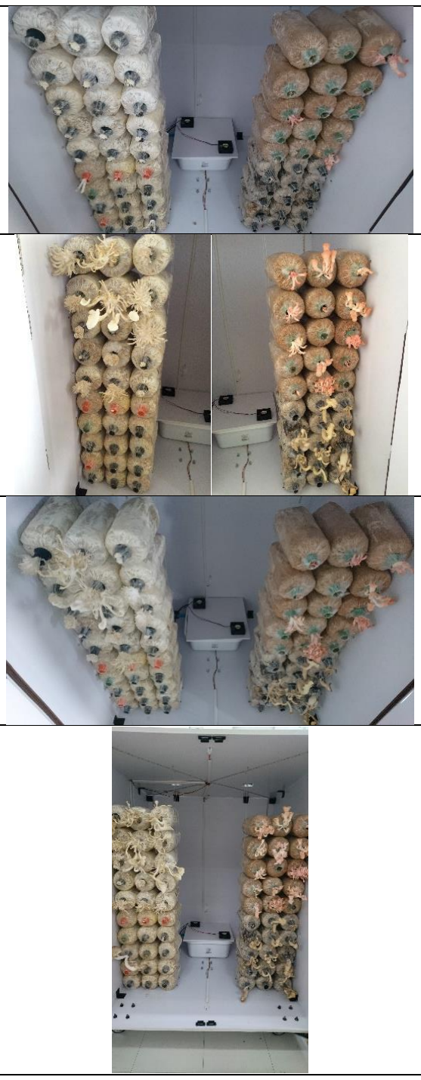
[picture p151: figure]

7 -8

9 -10

11 -12

13 -14

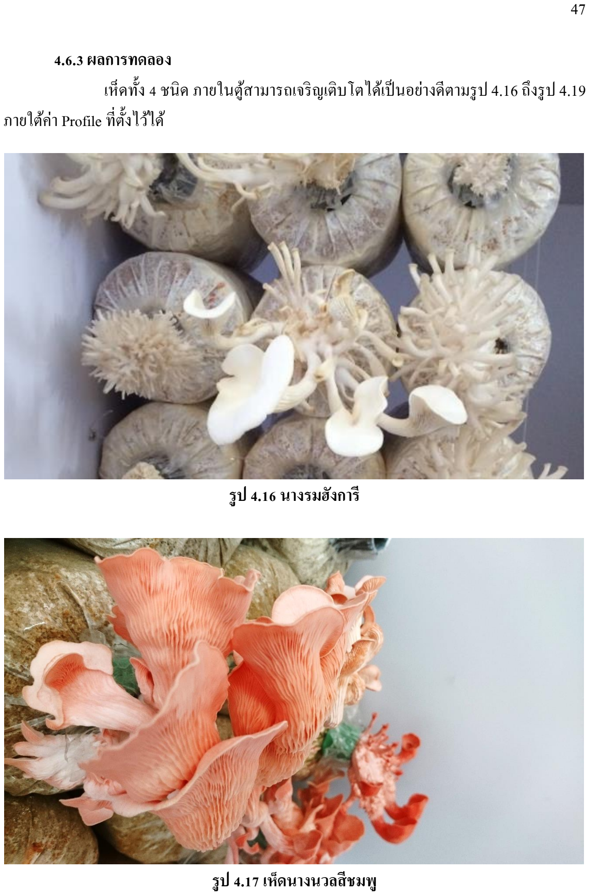
[picture p152: page 60]

### 4.6.3 ผลการทดลอง

เห็ดท้งั 4 ชนิด ภายในตูส้ ามารถเจริญเติบโตไดเ้ป็นอยา่ งดีตามรูป 4.16 ถึงรูป 4.19 ภายใต้ค่าProfile ที่ต้งัไว้ได้

รูป 4.16 นางรมฮังการี

รูป 4.17 เห็ดนางนวลสีชมพู

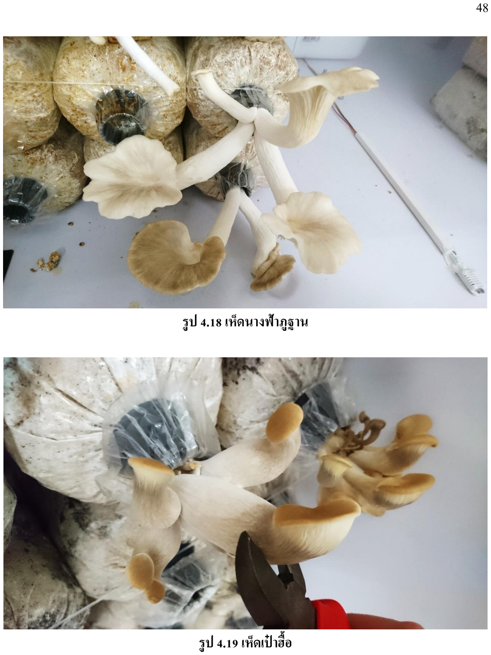
[picture p153: page 61]

รูป 4.18 เห็ดนางฟ้าภูฐาน

รูป 4.19 เห็ดเป๋ าฮื้อ

### บทที่ 5

## สรุปผล

### 5.1 ผลสรุปของโครงงาน

### 5.1.1 ส่วนของตู้จ าลองโรงเพาะเห็ด

สั่งซ้ือวสั ดุเช่น แผ่นไม้Plastwood, ล้อรถเข็น, เหล็กฉาก, สายไฟฟ้า, ตะปู,กาว เชื่อม, ถงัน้า , ท่อน้า และอุปกรณ์อิเล็กทรอนิกส์ เป็ นต้น และเครื่องมือ เช่น สว่านไฟฟ้า, เลื่อย Jigsaw, ไขควง,คีมปากแหลม และคีมตัด เป็ นต้น
ลงมือตดัแผน่ Plastwood ตามแบบตูท้ ี่ไดอ้อกแบบเอาไว้จากน้นั นา มาประกอบตู้ ดว้ยวสั ดุที่ไดก้ล่าวไปในขา้งตน้ ตามดว้ยติดต้งัอุปกรณ์อิเล็กทรอนิกส์ตาม Hardware I/O Diagram ที่ได้ออกแบบเอาไว้
ทดสอบความแข็งแรงของตูโ้ดยการเคลื่อนยา้ยวางของที่มีน้า หนกั โดยตูต้อ้งไม่ บุบ งอ หรือเบ้ียว ทดสอบระบบอิเล็กทรอนิกส์โดยจ่ายไฟเขา้ Power Supply แลว้สั่งใชง้าน พดัลม เครื่องท าหมอก หลอดไฟLED อ่านค่า Sensor จาก DHT22 ด้วย Raspberry Pi ให้ถูกต้องตามที่ กา หนด โดยที่ให้ค่าที่ไม่เพ้ียน ไม่ร้อนเกินค่าปกติและไม่ให้ทองแดงในสายไฟฟ้าโดนความช้ืน โดยตรง

### 5.1.2 ส่วนของ Platform

ติดต้งัระบบปฏิบตัิการ CentOS ลงบน Server และ NOOBS บน Raspberry Pi แล้ว ต้งัค่า Networkและค่าพ้ืนฐานที่จา เป็น เช่น รหสัผา่ น, Time Zone ให้เรียบร้อย
ติดต้งั Service ที่ใช้ใน Platform ตามหัวข้อ Deployment ในภาคผนวก ข ทดสอบระบบโดยการใช้งานทุกส่วนของระบบ เช่น ติดต่อกับฐานข้อมูลด้วย คา สั่ง Select, Insert, Update และ Delete, ใช้งาน Function ที่เขียนบน Platform และใช้งาน Web Application ด้วย Test Case ที่ครอบคลุมการใชง้านท้งัหมด
ทดสอบใช้งานจริง 24 ชวั่ โมงต่อวนั เก็บค่า Log เพื่อน ามาประเมินความถูกต้อง ของระบบ และแกไ้ขปัญหาตามความผดิพลาดที่พบ

### 5.1.3 ส่วนของ Web Application

เลือกใช้ Dashboard Template ที่เหมาะสมกบัความตอ้งการของระบบ เลือกใช้ณ ที่น้ีคือ Lumino - Dashboard โดยใช้ HTML, CSS และ JavaScript ในการพัฒนา Web Application

ปรับแต่งส่วนของ User Interface ตามความต้องการที่ได้ออกแบบไว้ พัฒนา Front-end และ Back-end ด้วยภาษา JavaScript
ทดสอบ Web Application ทุกส่วนดว้ย Test Case ที่ครอบคลุมการใชง้านท้งัหมด แบ่งเป็น Login, Logout, View Dashboard และ Admin Panel โดยตอ้งให้ค่าที่ถูกตอ้งตามที่กา หนด และแกไ้ขตามความผดิพลาดที่พบ

### 5.2 ปัญหาและอปุ สรรค

### 5.2.1 ส่วนของตู้จ าลองโรงเพาะเห็ด

การสร้างตู้จ าลองโรงเพาะเห็ดต้องตดัแผ่น Plastwood เองด้วย Jigsaw ทา ให้เกิด ความผิดพลาดได้ง่าย ตดัแล้วขนาดและรูปทรงไม่ได้ตามที่ต้องการ ต้องใช้เครื่องมือน าคือไม้ บรรทัดเหล็กฟุตยาว และเส้นเหล็กแบน
ช่องทางการระบายอากาศไม่เพียงพอและไม่เหมาะสม ทา ให้ดอกเห็ดออกมาเหี่ยว ไม่สวยตามที่คาดหวงั ตอ้งเพิ่มขนาดของช่องระบายอากาศและเพิ่มช่วงเวลาที่ระบายอากาศใน ระบบ

### 5.2.2 ส่วนของ Platform

ในส่วนของ NodeJS และ MQTT ไม่เขา้ใจการทา งานของเทคโนโลยีโดยละเอียด ทา ให้เกิดความล่าชา้ในการพฒั นาและ Code ที่พฒั นาไม่ไดป้ ระสิทธิภาพ ต้องศึกษาและท าความ เขา้ใจเพื่อใหใ้ชง้านไดอ้ยา่ งมีประสิทธิภาพ ตวัอยา่ งเช่น NodeJS ได้ศึกษาSyntax มาตรฐาน, Arrow Function, Callback Function, Synchronous และ Asynchronous เป็นตน้ ส่วนของ MQTT ได้ศึกษา การ Authenticate, Subscribe และ Publish เป็ นต้น

### 5.1.3 ส่วนของ Web Application

จาก Dashboard Template ที่ไดเ้ลือกมา ตอ้งใช้เวลาศึกษาโครงสร้างท้งัหมดจาก ผู้พัฒนา Lumino - Dashboard
เนื่องจากระบบมีหลาย Module ท าให้ต้องใช้เวลาและการจัดการสูง ต้องวางแผน และเขียนบนั ทึกให้ครอบคลุม แบ่ง Module การทา งานออกเป็นส่วนๆ ไม่ให้เกิดการ Bind กนัของ Function

### 5.3 แนวทางพัฒนาต่อ

### 5.3.1 ส่วนของตู้จ าลองโรงเพาะเห็ด

ลงมือติดต้งัและใชง้านในฟาร์มเห็ดจริงให้สามารถScaling จ านวนของฟาร์มเห็ด จา นวนมากได้จากหมู่บา้น ชุมชน ของผเู้ป็นเจา้ของฟาร์มเห็ด

### 5.3.2 ส่วนของ Platform

ทดลองรองรับ ผู้ใช้งาน, ฟาร์ม และอุปกรณ์จ านวนมาก เชื่อมต่อเข้ามาใน Platform จากน้นัวเิคราะห์วา่ รองรับปริมาณไดเ้ท่าไหร่ในขนาด Platform หนึ่ง เมื่อการใช้งานในระบบเดิมไม่เพียงพอ สามารถวางแผนออกแบบและพฒั นาท้งั แบบ Horizontal Scalingและ VerticalScaling ได้

### 5.3.3 ส่วนของ Web Application

เพิ่ม Feature ตามความตอ้งการของเจา้ของฟาร์มเห็ดเช่น ควบคุมความช้ืนแบบ เปลี่ยนแปลงไดใ้นแต่ละช่วงเวลาที่กา หนด เป็นตน้ เพิ่มระบบ Sorting และ Searching เพิ่มรองรับปริมาณผู้ใช้งาน, ฟาร์ม และอุปกรณ์ จา นวนมากที่เพิ่มข้ึน

### บรรณานุกรม

Oran Chieochan and Anukit Saokaew. 2017. “IoT for Smart Farm: A case study of the Lingzhi Mushroom Farm at Maejo University.” Bachelor’s Thesis, Chiang Mai University, Thailand.

Theeramet Kaewwiset and Paitoon Yodkhad. 2013. “Automatic Temperature and Humidity control system by using Fuzzy Logic Algorithm for Mushroom nursery.” Bachelor’ s Thesis, Chiangrai College, Thailand.

Adison Chuenthaisong. 2016. “ Temperatuer and Humidiy Control System for Mushroom. ” Bachelor’s Thesis, Kasetsart University Chalermphrakiat Sakonnakhon Province Campus, Thailand.

Nithikorn Sabaengbal. 2016. “ Wonderful Mushroom Plant.” Bachelor’ s Thesis, Kasetsart University Chalermphrakiat Sakonnakhon Province Campus, Thailand.

Hyemin Lee, Dongig Sin, Eunsoo Park, Injung Hwang, Gyeonghwan Hong, and Dongkun Shin. 2016. “ Open Software Platform for Companion IoT Devices.” Bachelor’ s Thesis, Sungkyunkwan University, Korea.

ก ฤ ษ ณ ะ จู จ้ อ ย . 2018. ก ฤ ษ ณ ะ ฟ า ร์ ม เ ห็ ด . [ Online] . Available : http://www.kritsanamushroom.com/th.

Arpapon Chankaew. 2018. factors affect mushroom growth. [Online]. Available : https://hug-hed.blogspot.com/2015/07/factors-affect-mushroom-growth.html.

### ภาคผนวก ก

## Source Code

Platform
เขียนด้วยภาษา JavaScript ใช้งานด้วย NodeJS โดยแบ่งเป็น 4 Module ดงัน้ี main-server.js
├ | mosca-server.js
├ | mysql.js
└ | web-backend.js
docker-compose.yaml
main-server.js

// require

var mosca_server = require('./mosca-server.js')

var mysql = require('./mysql.js')

var web_backend = require('./web-backend.js')

// function

function makeToken (length) {

var text = ''

var possible =

'ABCDEFGHIJKLMNOPQRSTUVWXYZabcdefghijklmnopqrstuvwxyz0123456789' for (var i=0; i<length; i++)

text += possible.charAt(Math.floor(Math.random() * possible.length))

return text

}

function checkToken (token) {

var check_result = false

var sql = 'SELECT user_id FROM user WHERE token = ?'

return mysql.con.query(sql, [token], function (err, result) {

if (!(result[0] === undefined))

return true
else
return false
})

}

function checkAdmin (token) {

var check_result = false

var sql = 'SELECT admin FROM user WHERE token = ?'

return mysql.con.query(sql, [token], function (err, result) {

if (!(result[0] === undefined))

return true
else
return false
})

}

// object

// log: device -> mqtt -> mosca -> nodejs -> mysql

mosca_server.server.on('published', function (message, detail) {

if (message.topic === 'logging') {

console.log('MQTT log received:', message.payload.toString())

var sql = 'INSERT INTO log SET ?'

mysql.con.query(sql, JSON.parse(message.payload), function (err, result) {

if (err)

throw err
console.log('MySQL 1 log record inserted\n')

})

}
})

// socket.io for web backend

web_backend.io.on('connection', function (socket) {

socket.on('login', function (message) {

var sql = 'SELECT password FROM user WHERE username = ?'

mysql.con.query(sql, [message.username], function (err, result) {

if (err)

throw err
if (!(result[0] === undefined) &&(message.password ===

result[0].password)) {

var token = makeToken(32)

var sql = 'UPDATE user SET token = ? WHERE

username = ?'

mysql.con.query(sql, [token, message.username],

function (err, result) {

if (err)

throw err
socket.emit('login-result', token)

console.log('Socket.io user logged in:',

message.username)

})

}
else
socket.emit('login-result', false)

})

})

socket.on('get-user-info', function (message) {

if (!checkToken(message))

socket.emit('get-user-info-result', false)

var sql = 'SELECT user_id, username, admin FROM user WHERE token = ?'

mysql.con.query(sql, [message], function (err, result) {

if (err)

throw err
if (!(result[0] === undefined)) {

socket.emit('get-user-info-result', result[0])

}
else {
socket.emit('get-user-info-result', false)

}
})

})

socket.on('update-dashboard', function (message) {

if (!checkToken(message.token))

socket.emit('update-dashboard-result', false)

var sql = 'SELECT log.* FROM user, log WHERE token = ? AND device_id = ?

AND timestamp >= (SELECT CURRENT_TIMESTAMP - (1000*5*2))'

mysql.con.query(sql, [message.token, message.device_id], function (err,

result) {

if (err)

throw err
if (!(result === undefined)) {

socket.emit('update-dashboard-result', result)

}
else {
socket.emit('update-dashboard-result', false)

}
console.log('Socket.io update dashboard')

})

})

socket.on('update-profile-settings', function (message) {

if (!checkToken(message.token))

socket.emit('update-profile-settings-result', false)

var sql = 'UPDATE device SET humidity_lower = ?, humidity_upper = ?,

airflow_duration = ?, airflow_gap = ?, light = ? WHERE device_id = ?'

mysql.con.query(sql, [message.humidity_lower, message.humidity_upper,

message.fan_duration, message.fan_gap, message.light, message.device_id], function (err,

result) {

if (err)

throw err
if (!(result === undefined)) {

socket.emit('update-profile-settings-result',

result)

}
else {
socket.emit('update-profile-settings-result', false)

}
console.log('Socket.io update profile settings')

})

var sql = 'SELECT devicename FROM device WHERE device_id = ?'

mysql.con.query(sql, [message.device_id], function (err, result) {

if (err)

throw err
var mqtt_message = {

device_id:+message.device_id,

devicename: result[0].devicename,

humidity_lower: message.humidity_lower,

humidity_upper: message.humidity_upper,

airflow_duration: message.fan_duration,

airflow_gap: message.fan_gap,

light: message.light,

}
mosca_server.server.publish({topic:'profile_settings',

payload: JSON.stringify(mqtt_message)}, function() {

console.log('Mosca sent:', 'profile settings')

})

})

})

socket.on('get-user', function (message) {

if (!checkToken(message.token) || !checkAdmin(message.token))

socket.emit('get-user-result', false)

var sql = 'SELECT username, user_id FROM user'

mysql.con.query(sql, function (err, result) {

if (err)

throw err
if (!(result === undefined)) {

socket.emit('get-user-result', result)

}
else {
socket.emit('get-user-result', false)

}
console.log('Socket.io get user')

})

})

socket.on('add-user', function (message) {

if (!checkToken(message.token) || !checkAdmin(message.token))

socket.emit('add-user-result', false)

var sql = 'SELECT username FROM user WHERE username = ?'

mysql.con.query(sql, [message.username], function (err, result) {

if (result[0] === undefined) {

var sql = 'INSERT INTO user SET username = ?, password = ?,

admin = ?'

mysql.con.query(sql, [message.username,

message.password, message.admin], function (err, result) {

if (err)

throw err
if (!(result === undefined)) {

socket.emit('add-user-result',

'add')

}
else {
socket.emit('add-user-result',

false)

}
console.log('Socket.io add user')

})

}
else {
var sql = 'UPDATE user SET password = ?, admin = ?

WHERE username = ?'

mysql.con.query(sql, [message.password,

message.admin, message.username], function (err, result) {

if (err)

throw err
if (!(result === undefined)) {

socket.emit('add-user-result',

'update')

}
else {
socket.emit('add-user-result',

false)

}
console.log('Socket.io update user')

})

}
})

})

socket.on('delete-user', function (message) {

if (!checkToken(message.token) || !checkAdmin(message.token))

socket.emit('delete-user-result', false)

var sql = 'DELETE FROM user WHERE user_id = ?'

mysql.con.query(sql, [message.user_id], function (err, result) {

if (err)

throw err
if (!(result === undefined)) {

socket.emit('delete-user-result', result)

}
else {
socket.emit('delete-user-result', false)

}
console.log('Socket.io delete user')

})

})

socket.on('get-device', function (message) {

if (!checkToken(message.token) || !checkAdmin(message.token))

socket.emit('get-device-result', false)

var sql = 'SELECT * FROM device WHERE ?'

mysql.con.query(sql, [message.where], function (err, result) {

if (err)

throw err
if (!(result === undefined)) {

socket.emit('get-device-result', result)

}
else {
socket.emit('get-device-result', false)

}
console.log('Socket.io get device')

})

})

socket.on('add-device', function (message) {

if (!checkToken(message.token) || !checkAdmin(message.token))

socket.emit('add-device-result', false)

var sql = 'SELECT devicename FROM device WHERE devicename = ?'

mysql.con.query(sql, [message.devicename], function (err, result) {

if (result[0] === undefined) {

var sql = 'INSERT INTO device SET devicename = ?,

humidity_lower = 81, humidity_upper = 90, airflow_duration = 5, airflow_gap = 35, light = 0'

mysql.con.query(sql, [message.devicename], function

(err, result) {

if (err)

throw err
if (!(result === undefined)) {

socket.emit('add-device-

result', result)

}
else {
socket.emit('add-device-

result', false)

}
console.log('Socket.io add device')

})

}
else
socket.emit('add-device-result', 'exist')

})

})

socket.on('delete-device', function (message) {

if (!checkToken(message.token) || !checkAdmin(message.token))

socket.emit('delete-device-result', false)

var sql = 'DELETE FROM device WHERE device_id = ?'

mysql.con.query(sql, [message.device_id], function (err, result) {

if (err)

throw err
if (!(result === undefined)) {

socket.emit('delete-device-result', result)

}
else {
socket.emit('delete-device-result', false)

}
console.log('Socket.io delete device')

})

})

socket.on('get-farm', function (message) {

if (!checkToken(message.token) || !checkAdmin(message.token))

socket.emit('get-farm-result', false)

var sql = 'SELECT * FROM farm_owner WHERE ?'

mysql.con.query(sql, [message.where], function (err, result) {

if (err)

throw err
if (!(result === undefined)) {

socket.emit('get-farm-result', result)

}
else {
socket.emit('get-farm-result', false)

}
console.log('Socket.io get farm')

})

})

socket.on('get-user-farm', function (message) {

if (!checkToken(message.token))

socket.emit('get-user-farm-result', false)

var sql = 'SELECT * FROM farm_owner WHERE user_id = ?'

mysql.con.query(sql, [message.user_id], function (err, result) {

if (err)

throw err
if (!(result === undefined)) {

socket.emit('get-user-farm-result', result)

}
else {
socket.emit('get-user-farm-result', false)

}
console.log('Socket.io get user farm')

})

})

socket.on('add-user-farm', function (message) {

if (!checkToken(message.token) || !checkAdmin(message.token))

socket.emit('add-user-farm-result', false)

var sql = 'SELECT farmname FROM farm_owner WHERE farmname = ?'

mysql.con.query(sql, [message.farmname], function (err, result) {

if (result[0] === undefined) {

var sql = 'INSERT INTO farm_owner SET user_id = ?,

farmname = ?'

mysql.con.query(sql, [message.user_id,

message.farmname], function (err, result) {

if (err)

throw err
if (!(result === undefined)) {

socket.emit('add-user-farm-

result', result)

}
else {
socket.emit('add-user-farm-

result', false)

}
console.log('Socket.io add user farm')

})

}
else
socket.emit('add-user-farm-result', 'exist')

})

})

socket.on('delete-user-farm', function (message) {

if (!checkToken(message.token) || !checkAdmin(message.token))

socket.emit('delete-user-farm-result', false)

var sql = 'DELETE FROM farm_owner WHERE user_id = ? AND farm_id = ?'

mysql.con.query(sql, [message.user_id, message.farm_id], function (err,

result) {

if (err)

throw err
if (!(result === undefined)) {

socket.emit('delete-user-farm-result', result)

}
else {
socket.emit('delete-user-farm-result', false)

}
console.log('Socket.io delete user farm')

})

})

socket.on('get-farm-device', function (message) {

if (!checkToken(message.token))

socket.emit('get-farm-device-result', false)

var sql = 'SELECT device.* FROM farm, device WHERE farm_id = ? AND

farm.device_id = device.device_id'

console.log('Socket.io get farm device')

mysql.con.query(sql, [message.farm_id], function (err, result) {

if (err)

throw err
if (!(result === undefined)) {

socket.emit('get-farm-device-result', result)

}
else {
socket.emit('get-farm-device-result', false)

}
})

})

socket.on('add-farm-device', function (message) {

if (!checkToken(message.token) || !checkAdmin(message.token))

socket.emit('add-farm-device-result', false)

var sql = 'SELECT device_id FROM farm WHERE farm_id = ? AND device_id

= ?'

mysql.con.query(sql, [message.farm_id, message.device_id], function (err,

result) {

if (result[0] === undefined) {

var sql = 'INSERT INTO farm SET farm_id = ?,

device_id = ?'

mysql.con.query(sql, [message.farm_id,

message.device_id], function (err, result) {

if (err)

throw err
if (!(result === undefined)) {

socket.emit('add-farm-device-

result', result)

}
else {
socket.emit('add-farm-device-

result', false)

}
console.log('Socket.io add farm device')

})

}
else
socket.emit('add-farm-device-result', 'exist')

})

})

socket.on('delete-farm-device', function (message) {

if (!checkToken(message.token) || !checkAdmin(message.token))

socket.emit('delete-farm-device-result', false)

var sql = 'DELETE FROM farm WHERE farm_id = ? AND device_id = ?'

console.log('Socket.io delete farm device')

mysql.con.query(sql, [message.farm_id, message.device_id], function (err,

result) {

if (err)

throw err
if (!(result === undefined)) {

socket.emit('delete-farm-device-result', result)

}

else {
socket.emit('delete-farm-device-result', false)

}
})

})

})

mosca-server.js

// require

var mosca = require('mosca')

// variable

var settings = {

port: 1883,

}

var server = new mosca.Server(settings)

// Accepts the connection if the username and password are valid

var authenticate = function(client, username, password, callback) {

var authorized =(username.toString() === 'mqtt' && password.toString() === 'naja')

if (authorized) {

client.user = username

callback(null, authorized)

}
}

// function

function setup() {

server.authenticate = authenticate

console.log('Mosca server is up and running on 0.0.0.0:'+settings.port)

}

// object

server.on('clientConnected', function(client) {

console.log('Mosca client connected:', client.id)

})

server.on('clientDisconnected', function(client) {

console.log('Mosca client disconnected:', client.id)

})

server.on('published', function(packet, client) {

//console.log('Received data', '\n')

})

server.on('ready', setup)

// exports

exports.server = server

mysql.js

// require

var mysql = require('mysql')

// variable

var settings = {

host: "mysql",

port: "3306",

user: "root",

password: "eiei",

database : 'mushroom_nursery'

}

var con = mysql.createConnection(settings)

// exports

exports.con = con

console.log('MySQL connected to mysql:'+settings.port)

web-backend.js

// require

var io = require('socket.io')(9000)

// exports

exports.io = io

console.log('Socket.io listening on 0.0.0.0:9000')

Raspberry Pi
เขียนด้วยภาษา JavaScript ใช้งานด้วย NodeJS โดยแบ่งเป็น 4 Module และ 1 JSON file ดงัน้ี
main-client.js
├ | mqtt-client.js
├ | lcd-display.js
└ | sensor.js
└ | filesystem.js
└ | profile.json
main-client.js

// require

var mqtt_client = require('./mqtt-client.js')

var sensor = require('./sensor.js')

var filesystem = require('./filesystem.js')

var lcd_display = require('./lcd-display.js')

// variable

var profile = sensor.profile

// function

function sendLog() {

var message = {

device_id: profile.device_id,

temperature: sensor.status.temperature,

humidity: sensor.status.humidity,

mist_pump: sensor.status.mist_pump,

ventilate: sensor.status.ventilate,

airflow_duration: sensor.status.airflow_duration,

mist_duration: sensor.status.mist_duration,

humidity_lower_set: profile.humidity_lower,

humidity_upper_set: profile.humidity_upper,

airflow_duration_set: profile.airflow_duration,

airflow_gap_set: profile.airflow_gap,

light_set: profile.light,

message: 'OK'

}

mqtt_client.client.publish('logging', JSON.stringify(message), function() {

console.log('MQTT sent:', 'log')

})

}
setInterval(sendLog, 300000)

// object mqtt_client.client.on('message', function (topic, message) {

if (topic === 'profile_settings' && JSON.parse(message).device_id ===

profile.device_id) {

console.log('MQTT get profile settings')

profile = sensor.profile = JSON.parse(message)

sensor.updateExportsProfile()

}
})

lcd_display.io.on('connection', function(socket) {

console.log('Socket.io connected')

socket.on('update-request', function() {

sensor.updateExportsStatus()

var message = {

profile: profile,

temperature: sensor.status.temperature,

humidity: sensor.status.humidity,

mist_pump: sensor.status.mist_pump,

ventilate: sensor.status.ventilate

}
socket.emit('update-value', message) // Emit on the opened socket.

})

socket.on('control', function(message) {

sensor.control = message

sensor.updateExportsControl()

console.log(message)

})

})

mqtt-client.js

// require

var mqtt = require('mqtt')

// variable

var settings = {

clientId: 'raspi_01',

username: 'mqtt',

password: 'naja',

reconnectPeriod: 1000 * 1

}

var client = mqtt.connect('mqtt://161.246.11.102', settings)

// object

client.on('connect', function () {

console.log('MQTT connected to the server')

client.subscribe('profile_settings', { qos: 2 })

console.log('MQTT subscribed: profile_settings')

})

client.on('message', function (topic, message) {

//console.log('MQTT ( topic:', topic, ') received:', message.toString(), '\n')

})

client.on('error', function(error) {

console.log('MQTT ERROR: ', error)

})

client.on('offline', function() {

console.log('MQTT offline')

})

client.on('reconnect', function() {

console.log('MQTT reconnect')

})

// exports

exports.client = client

lcd-display.js

// require

var express = require('express')

var io = require('socket.io')(9000)

// variable

var settings = {

port: 80,

env: '0.0.0.0'

}

// object

app = express()

app.use(express.static(__dirname + '/views'))

app.listen(settings.port, settings.env, function () {

console.log('Express listening on', settings.env+':'+settings.port)

})

// exports

exports.app = app

exports.io = io

sensor.js

// require

var nodeDhtSensor = require('node-dht-sensor')

var gpio = require('onoff').Gpio

var filesystem = require('./filesystem.js')

// variable

var sensors =[

{name: 'DHT22-1', type: 22, pin: 6},

{name: 'DHT22-1', type: 22, pin: 13},

{name: 'DHT22-3', type: 22, pin: 19},

{name: 'DHT22-4', type: 22, pin: 26}
]

var relays =[

new gpio(12, 'out'),

new gpio(16, 'out'),

new gpio(20, 'out'),

new gpio(21, 'out')
]

var profile = filesystem.readFile()

var temperature =[0, 0, 0, 0]

var humidity =[0, 0, 0, 0]

var mist_pump = false

var ventilate = false

var airflow_duration = 0

var mist_duration = 0

var temperature_average
var humidity_average
var triggered =[0, 0]

var airflow = false

var airflow_duration_counter = 0

var airflow_gap_counter = 0

var control = {

manual: false,

fan: false,

mist: false,

light: false

}

var interval = {

_1second: new Date(),

_5second: new Date(),

_60second: new Date()

}

// function

function readSensors () {

for (var i in sensors) {

var read = nodeDhtSensor.read(sensors[i].type, sensors[i].pin)

temperature[i] = read.temperature.toFixed(2)

humidity[i] = read.humidity.toFixed(2)

}
temperature_average =(+temperature[0]*0.1 ++temperature[1]*0.3 ++temperature[2]*0.3 +

+temperature[3]*0.3).toFixed(2)

humidity_average =(+humidity[0]*0.3 ++humidity[1]*0.3 ++humidity[2]*0.1 +

+humidity[3]*0.3).toFixed(2)

writeRelays()

}

function writeRelays () {

if (control.manual)

return

if(airflow) {

relays[1].writeSync(1)

relays[2].writeSync(0)

relays[3].writeSync(0)

if(!ventilate)

triggered[1]++

mist_pump = false

ventilate = true

}
else if(humidity_average < profile.humidity_lower) {

relays[1].writeSync(1)

relays[2].writeSync(1)

relays[3].writeSync(1)

if(!mist_pump)

triggered[0]++

if(!ventilate)

triggered[1]++

mist_pump = true

ventilate = true

}
else if(humidity_average > profile.humidity_upper) {

relays[1].writeSync(1)

relays[2].writeSync(0)

relays[3].writeSync(0)

if(!ventilate)

triggered[1]++

mist_pump = false

ventilate = true

}
else {
relays[1].writeSync(0)

relays[2].writeSync(0)

relays[3].writeSync(0)

mist_pump = false

ventilate = false

}

if(profile.light)

relays[0].writeSync(1)

else
relays[0].writeSync(0)

}

function manualWriteRelays () {

if (!control.manual)

return

if(control.fan) {

relays[1].writeSync(1)

if(!ventilate)

triggered[1]++

ventilate = true

}
else {
relays[1].writeSync(0)

ventilate = false

}

if(control.mist) {

relays[2].writeSync(1)

relays[3].writeSync(1)

if(!mist_pump)

triggered[0]++

mist_pump = true

}
else {
relays[2].writeSync(0)

relays[3].writeSync(0)

mist_pump = false

}

if(control.light)

relays[0].writeSync(1)

else
relays[0].writeSync(0)

}

function consoleOutput () {

console.log('\n', Date())

console.log('Profile:', JSON.stringify(profile))

console.log('DHT22-1\tTemperature:', temperature[0]+'°C,', 'Humidity:',

humidity[0]+'%')

console.log('DHT22-2\tTemperature:', temperature[1]+'°C,', 'Humidity:',

humidity[1]+'%')

console.log('DHT22-3\tTemperature:', temperature[2]+'°C,', 'Humidity:',

humidity[2]+'%')

console.log('DHT22-4\tTemperature:', temperature[3]+'°C,', 'Humidity:',

humidity[3]+'%')

console.log('Humidity:', humidity_average+'%', ' | Triggered:', triggered)
console.log('MistPump:', mist_pump, ' | Ventilate:', ventilate)
console.log('MistDuration:', mist_duration, ' | AirflowDuration:',

airflow_duration, '\n')

}

function timer () {

var time = new Date()

if (time - interval._1second >= 1000) {

interval._1second =+interval._1second + 1000

if (mist_pump)

mist_duration++

if (ventilate)

airflow_duration++

}

if (time - interval._5second >= 5000) {

interval._5second =+interval._5second + 5000

readSensors()

consoleOutput()

}

if (time - interval._60second >= 60000) {

interval._60second =+interval._60second + 60000

if (airflow_duration === 1) {

airflow = true

console.log('Sensor start airflow')

}
else if (airflow_duration === 0) {

airflow = false

console.log('Sensor stop airflow')

}
else if (airflow) {

airflow_duration_counter++

if (airflow_duration_counter >=+profile.airflow_duration) {

airflow_duration_counter = 0

airflow = false

console.log('Sensor stop airflow')

}

}
else {
airflow_gap_counter++

if (airflow_gap_counter >=+profile.airflow_gap) {

airflow_gap_counter = 0

airflow = true

console.log('Sensor start airflow')

}

}
}

}

setInterval(timer, 100)

function unexportOnClose () {

for(var i in relays) {

relays[i].writeSync(0)

console.log('Sensor unexport relay:', i)

}
process.exit()

}
process.on('SIGINT', unexportOnClose)

// exports

exports.profile = profile

exports.status = {

temperature: temperature_average,

humidity: humidity_average,

mist_pump: mist_pump,

ventilate: ventilate,

airflow_duration: airflow_duration,

mist_duration: mist_duration

}
exports.control = control

exports.updateExportsProfile = function () {

profile = exports.profile

filesystem.writeFile(profile)

console.log('Sensor profile settings updated')

if (profile.airflow_duration === 1) {

airflow = true

console.log('Sensor start airflow')

}
else if (profile.airflow_duration === 0) {

airflow = false

console.log('Sensor stop airflow')

}

}
exports.updateExportsStatus = function () {

exports.status = {

temperature: temperature_average,

humidity: humidity_average,

mist_pump: mist_pump,

ventilate: ventilate,

airflow_duration: airflow_duration,

mist_duration: mist_duration

}
}
exports.updateExportsControl = function () {

control = exports.control

manualWriteRelays()

}

console.log('Sensor activated')

filesystem.js

// require

var fs = require('fs')

// variable

var filename = 'profile.json'

// function

function readFile () {

console.log('Filesystem read:', filename)

return JSON.parse(fs.readFileSync(filename))

}

function writeFile (data) {

fs.writeFile(filename, JSON.stringify(data), function (err) {

if (err) throw err

console.log('Filesystem write:', filename)

})

}

// exports

exports.readFile = readFile

exports.writeFile = writeFile

profile.json

{
"device_id":0,

"devicename":"Raspi",

"humidity_lower":81,

"humidity_upper":90,

"airflow_duration":5,

"airflow_gap":25,

"light":false

}

docker-compose.yaml

version: '3'

services:

nginx-php:

image: richarvey/nginx-php-fpm

ports:
- "80:80"

volumes:

- "/root/platform/nginx-php:/var/www/html:Z"

restart: always

stdin_open: true

tty: true

mysql:

image: mysql

ports:

- "3306:3306"

volumes:

- "/root/platform/mysql:/var/lib/mysql:Z"

environment:

MYSQL_ROOT_PASSWORD: "eiei"

MYSQL_ALLOW_EMPTY_PASSWORD: "no"

restart: always

stdin_open: true

tty: true

node:

image: node

ports:

- "1883:1883"
- "9000:9000"

volumes:

- "/root/platform/node:/root/node:Z"

restart: always

stdin_open: true

tty: true

### ภาคผนวก ข

## Deployment

Technology Requirement
Hardware
Server
Raspberry Pi Model B+
Operating System
CentOS
NOOBS
Engine
Docker
Docker-compose
NodeJS
MySQL
MQTT
Nginx
Language
Bash
JavaScript
HTML
CSS
SQL

Installation Method Command Platform

yum update -y

yum install screen docker -y

dpkg-reconfigure tzdata

SET GLOBAL time_zone = 'Asia/Bangkok';

date +%T -s "0:00:00"

#upload phpmyadmin, create phpmyadmin database, generate blowfish passphase

curl "https://bootstrap.pypa.io/get-pip.py" -o "get-pip.py"

python get-pip.py

pip install docker-compose

#add docker-compose.yaml + necessary files and change to that directory

docker-compose create

docker-compose start

screen -md -S node docker exec -it platform_node_1 bash

cd /root/node

npm init
npm install
node main-server.js

#ctrl+A then ctrl+D for detach and run on background

Raspberry Pi

apt-get update -y

apt-get install screen vim nodejs -y

dpkg-reconfigure tzdata

SET GLOBAL time_zone = 'Asia/Bangkok';

date +%T -s "0:00:00"

curl -o bcm2835-1.55.tar.gz http://www.airspayce.com/mikem/bcm2835/bcm2835-1.55.tar.gz

tar zxvf bcm2835-1.55.tar.gz

cd bcm2835-1.55

./configure

make && make check
make install

#add necessary files and change to that directory

npm init
npm install
screen -md -S client node main-client.js

screen -md -S browser chromium-browser --start-fullscreen

Create Database Command

CREATE DATABASE mushroom_nursery;

USE mushroom_nursery;

CREATE TABLE user (

user_id INT PRIMARY KEY AUTO_INCREMENT, username VARCHAR(32),

password VARCHAR(32),

admin BOOLEAN,
token VARCHAR(32)
);

CREATE TABLE farm_owner (

user_id INT UNIQUE KEY,
farm_id INT UNIQUE KEY PRIMARY KEY AUTO_INCREMENT, farmname VARCHAR(32)
);

CREATE TABLE farm (

farm_id INT UNIQUE KEY,
device_id INT UNIQUE KEY
);

CREATE TABLE device (

device_id INT PRIMARY KEY AUTO_INCREMENT, devicename VARCHAR(32),

humidity_lower FLOAT,

humidity_upper FLOAT,
airflow_duration INT,
airflow_gap INT,

light BOOLEAN
);

CREATE TABLE log (

timestamp TIMESTAMP PRIMARY KEY, device_id INT,

temperature FLOAT,
humidity FLOAT,
mist_pump BOOLEAN,

ventilate BOOLEAN,
airflow_duration INT,

mist_duration INT,
humidity_lower_set FLOAT,
humidity_upper_set FLOAT,

airflow_duration_set INT,
airflow_gap_set INT,

light_set BOOLEAN,
message VARCHAR(100)
);

### ภาคผนวก ค

## Usage

Platform
1. เตรียม HyperV และไฟล์ CentOS 7 -Platform.vhdx

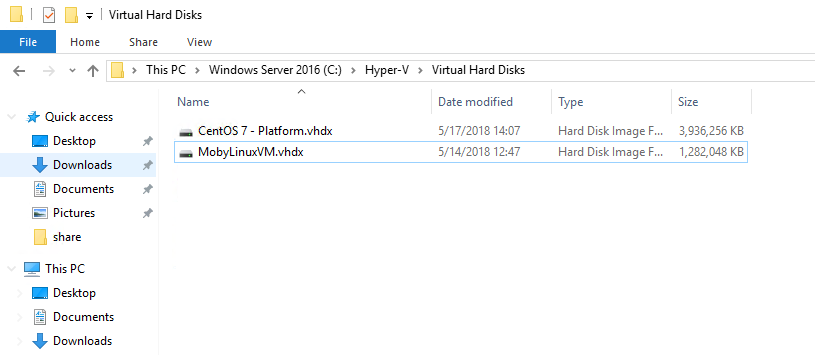
[picture p154: figure]

รูปที่ค.1 ไฟล์ CentOS 7 - Platform.vhdx

2. เข้าไปที่ Hyper-V Manager คลิกขวาที่ Server -> New -> Virtual Machine… ต้งั ค่าและเพิ่ม Virtual Disk ให้เรียบร้อย

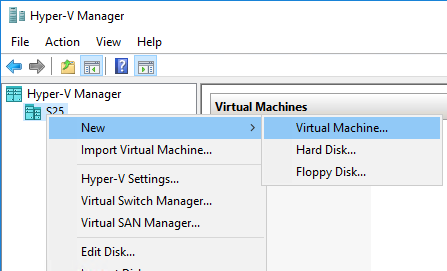
[picture p155: figure]

รูปที่ค.2 เพิ่ม Virtual Machine

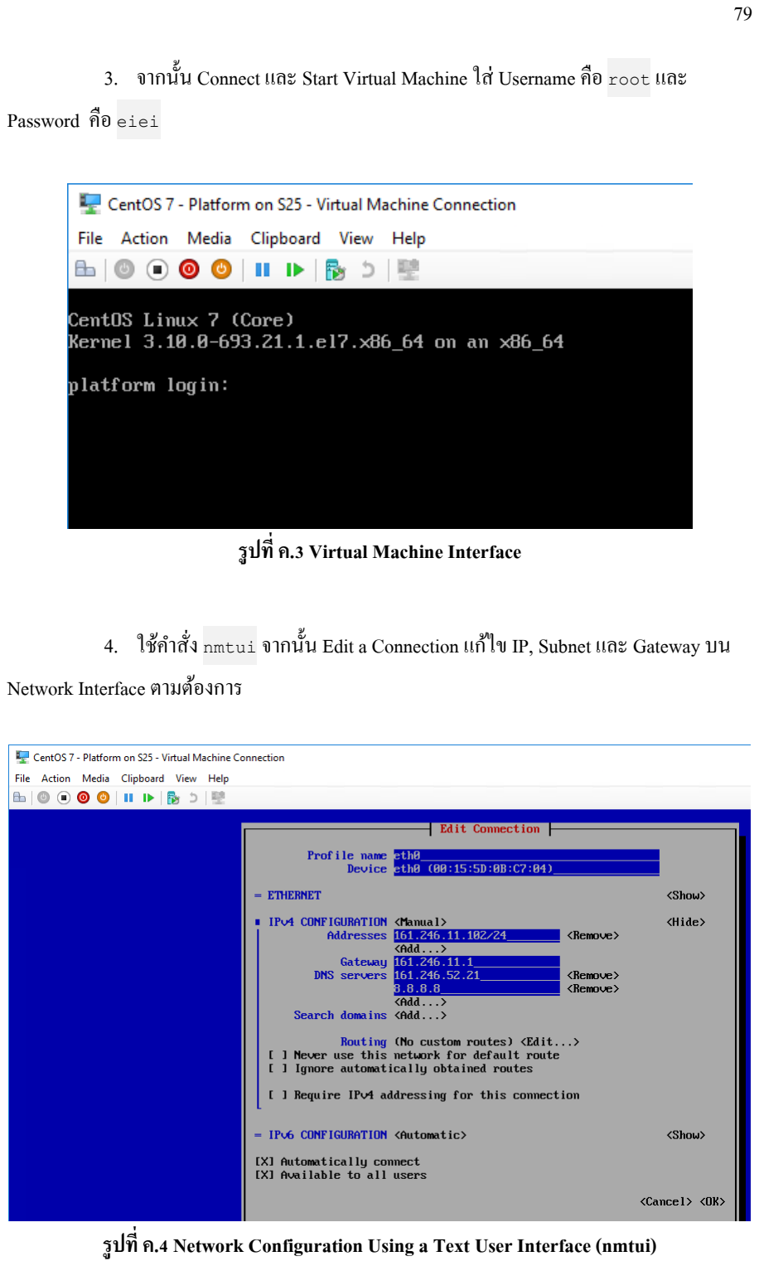
[picture p156: page 92]

3. จากน้นั Connect และ Start Virtual Machine ใส่ Username คือ root และ Password คือ eiei

รูปที่ค.3 Virtual Machine Interface

4. ใชค้า สั่ง nmtui จากน้นั Edit a Connection แกไ้ขIP, Subnet และ Gateway บน Network Interface ตามต้องการ

รูปที่ค.4 Network Configuration Using a Text User Interface (nmtui)

5. ใชค้า สั่ง screen -S node docker exec -it platform_node_1 bash
เพื่อเข้ามาจัดการ NodeJS

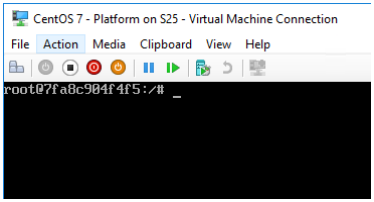
[picture p157: figure]

รูปที่ค.5 Bash in NodeJS Container

6. ใชค้า สั่ง cd /root/node | และ node main-server.js | เพื่อ run service
(กด Ctrl+A แล้ว Ctrl+D เพื่อ detach และ run in background) (กด Ctrl+C เพื่อ terminate)
(ใชค้า สั่ง screen -r node เพื่อกลับเข้ามาจัดการ NodeJS)

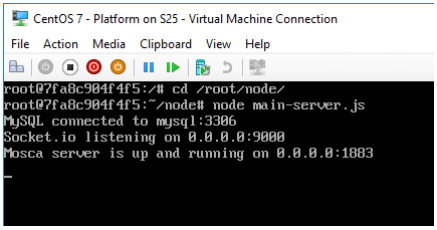
[picture p158: figure]

รูปที่ค.6 Run Service on Bash in NodeJS Container

Microcontroller

1. เสียบปลกั๊ไฟฟ้าและเสียบสายยางหรือเติมน้า ในถงั 5 ลิตรข้ึนไป ให้เรียบร้อย

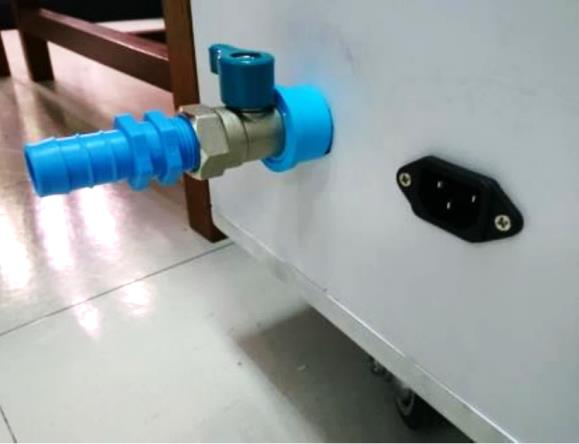
[picture p159: figure]

รูปที่ค.7 ด้านซ้ายมุมซ้ายล่างของตู้จ าลอง

2. ระบบจะท างานอัตโนมัติและข้ึนภาพดงัรูป

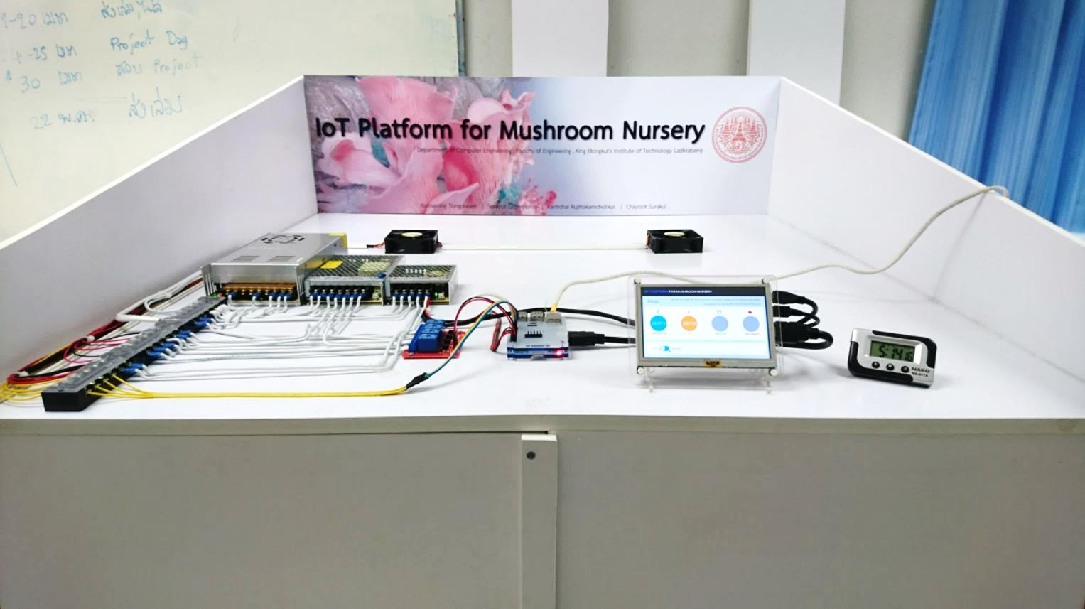
[picture p160: figure]

รูปที่ค.8 ด้านบนของตู้จ าลอง

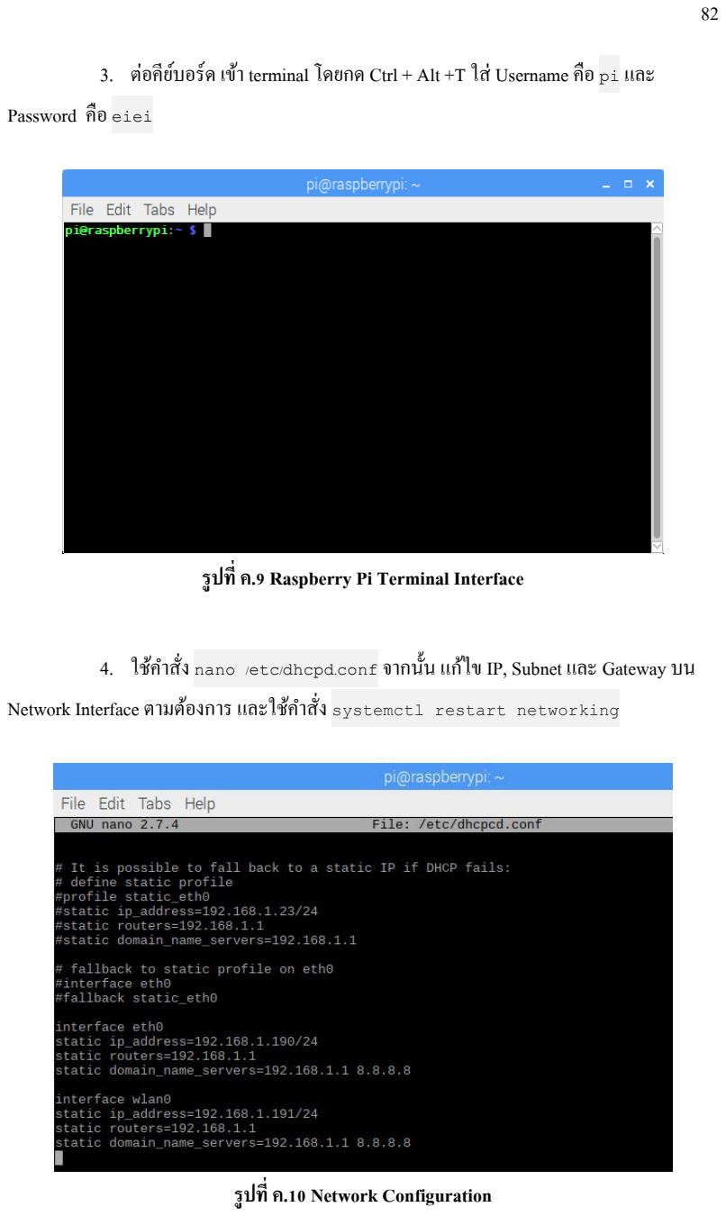
[picture p161: page 95]

3. ต่อคียบ์อร์ด เขา้ terminal โดยกด Ctrl + Alt +T ใส่ Username คือ pi และ Password คือ eiei

รูปที่ค.9 Raspberry Pi Terminal Interface

4. ใชค้า สั่ง nano /etc/dhcpd.conf จากน้นั แกไ้ขIP, Subnet และ Gateway บน Network Interface ตามตอ้งการและใชค้า สั่ง systemctl restart networking

รูปที่ค.10 Network Configuration

5. ใชค้า สั่ง cd /client แลว้ใชค้า สั่ง vim แกไ้ขทุก Module ที่มี IP ของ Platform ให้ ตรงกบั IP ของ Platform ที่ใชอ้ยปู่ ัจจุบนั
6. ใชค้า สั่ง screen -S node node main-client.js เพื่อ run service
(กด Ctrl+A แล้ว Ctrl+D เพื่อ detach และ run in background) (กด Ctrl+C เพื่อ terminate)
(ใชค้า สั่ง screen -r node เพื่อกลับเข้ามาจัดการ NodeJS)

Web Application
Web Application สา หรับใชแ้ สดงสถานะและควบคุมระบบต่างๆภายในโรงเรือน โดยจะแบ่งออกเป็น 4 ส่วน คือ หน้า Login, หน้า Dashboard, หน้าProfile และหน้า Admin Panel หน้า Login ส าหรับใส่ Username และ Password เพื่อเข้าใช้งาน เมื่อ login เข้า มาแล้วจะเจอหน้า Dashboard ที่จะแสดงอุณหภูมิและความช้ืนจากค่าที่วดัไดภ้ ายในโรงเรือน พัด ลมระบายอากาศ และเครื่องทา หมอกจะแสดงระยะเวลาทา งานท้งัหมดเป็นวินาทีและกราฟแสดง รายละเอียดย้อนหลังส าหรับอุณหภูมิและความช้ืน โดยสามารถเลือก Farm และ Device ไดว้่าจะ แสดงรายละเอียดต่างๆจาก Device ไหน
หน้า Profile มีไวส้า หรับต้งัค่า Profile สา หรับใชใ้นการควบคุมระบบต่างๆภายใน โรงเรือน โดยท าการเลือก Farm และ Device จากน้นั ทา การต้งัค่า ช่วงของความช้ืน ระยะเวลาการ เวลาในการเปิดพดัลมระบายอากาศต่อวนั และสามารถเลือกไดว้า่ จะเปิดไฟหรือไม่
หน้า Admin Panel จะสามารถใช้ได้เฉพาะผูใ้ชง้านที่มีสถานะผูดู้แลระบบเท่าน้นั โดยจะแบ่งเป็น 3 หน้า ในหน้าแรกจะเป็ นหน้าส าหรับจัดการผู้ใช้งาน โดยสามารถเพิ่มหรือลบ ผู้ใช้งานออกจากระบบได้และในการเพิ่มผใู้ชง้านสามารถกา หนดไดว้า่ จะเป็นผใู้ชง้านธรรมดาหรือ หรือผู้ดูแลระบบหน้าต่อไปจะเป็ นหน้าส าหรับจัดการ Device โดยสามารถเพิ่มหรือลบ Device ออก จากระบบได้หน้าสุดท้ายจะเป็ นหน้าส าหรับจัดการฟาร์ม โดยการเลือกผู้ใชง้านที่มีอยใู่ นระบบและ จะสามารถเพิ่มหรือลบฟาร์มส าหรับผูใ้ช้งานคนน้นั ได้หรือทา การเลือกฟาร์มที่มีอยู่ในระบบและ สามารถเพิ่มหรือลบ
