narinthon-so/Mushroom-project/Documents/เล่ม/บทที่ 2.pdf

บทที่ 2
ทฤษฎีและงานวิจัยที่เกี่ยวข้อง

ในการจัดทำโครงงานโรงเพาะเห็ดอัจฉริยะผู้จัดทำโครงงานได้ศึกษาทฤษฎีและงานวิจัยที่ เกี่ยวข้องเพื่อใช้ในการดำเนินโครงงานให้เป็นไปตามวัตถุประสงค์และขอบเขตของโครงงาน

### 2.1 ทฤษฎีที่เกี่ยวข้อง

### 2.1.1 ไมโครคอนโทรลเลอร์ESP32 LoRa

ESP32 LoRa เป็นบอร์ดที่รวมเอา ESP32 และโมดูล LoRa SX1278 ไว้ในบอร์ดเดียวทำให้ สามารถสื่อสารแบบ Wi-Fi Bluetooth และสามารถส่งข้อมูลระยะไกลแบบ LoRa

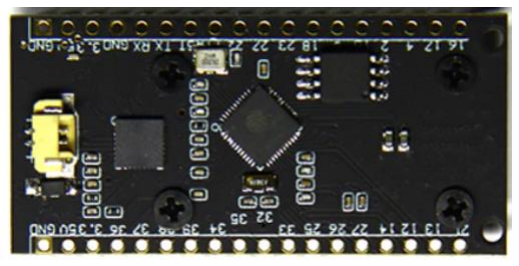
[picture p281: figure]

รูปที่ 2.1 แสดงภาพของไมโครคอนโทรลเลอร์ESP32 LoRa

รายละเอียด ESP32 เป็นชื่อของไอซีไมโครคอนโทรลเลอร์ที่รองรับการเชื่อมต่อ WiFi และ Bluetooth 4.2 BLE ในตัว ผลิตโดยบริษัท Espressif จากประเทศจีน โดยไอซี ESP32 มีสเปคโดย ละเอียด ดังนี้

- ซีพียูใช้สถาปัตยกรรม Tensilica LX6 แบบ 2 แกนสมอง สั า นา ิกา 240MHz
- มีแรมในตัว 512KB
- รองรับการเชื่อมต่อรอมภายนอกสูงสุด 16MB
- มาพร้อมกับ WiFi มาตร าน 802.11 b/g/n รองรับการใช้งานทั้งในโหมด Station softAP และ Wi-Fi direct
- มีบลูทู ในตัว รองรับการใช้งานในโหมด 2.0 และโหมด 4.0 BLE
- ใช้แรงดันไ ้าในการทำงาน 2.6V ถึง 3V
- ทำงานได้ที่อุ หภูมิ -40◦C ถึง 125◦C
- นอกจากนี้ ESP32 ยังมีเซ็นเซอร ต่าง มาในตัวด้วย ดังนี้
- วงจรกรองสั า รบกวนในวงจรขยายสั า
- เซ็นเซอร แม่เหล็ก
- เซ็นเซอร สัมผัส (Capacitive touch) รองรับ 10 ช่อง
- รองรับการเชื่อมต่อคลิสตอล 32.768kHz สำหรับใช้กับส่วนวงจรนับเวลาโดยเฉพาะ
- ขาใช้งานต่าง ของ ESP32 รองรับการเชื่อมต่อบัสต่าง ดังนี้
- มี GPIO จ านวน 28 ช่อง
- รองรับ UART จ านวน 3 ช่อง
- รองรับ SPI จ านวน 2 ช่อง
- รองรับ I2C จ านวน 2 ช่อง
- รองรับ 12-bits ADC จ านวน 18 ช่อง
- รองรับ 8-bits DAC จ านวน 2 ช่อง
- รองรับ I2S จ านวน 1 ช่อง
- รองรับ PWM / Timer ทุกช่อง
- รองรับการเชื่อมต่อกับ SD-Card
- นอกจากนี้ ESP32 ยังรองรับ ังก ชั่นเกี่ยวกับความปลอดภัยต่าง ดังนี้
- รองรับการเข้ารหัส WiFi แบบ WEP และ WPA/WPA2 PSK/Enterprise

รายละเอียด LoRa SX1278 ทำงานร่วมกับโปรโตคอลการสื่อสาร SPI ดังนั้นจึงสามารถใช้กับ ไมโครคอนโทรลเลอร์ที่รองรับ SPI ได้ จำเป็นต้องใช้ Ariel (เสาอากาศ) ร่วมกับโมดูลมิฉะนั้นอาจทำให้ โมดูลเสียหายอย่างถาวร โมดูลควรใช้พลังงาน 3.3V เท่านั้นโดยมีคุ สมบัติต่างดังนี้

### 2.1.2 Raspberry Pi 3 Model B

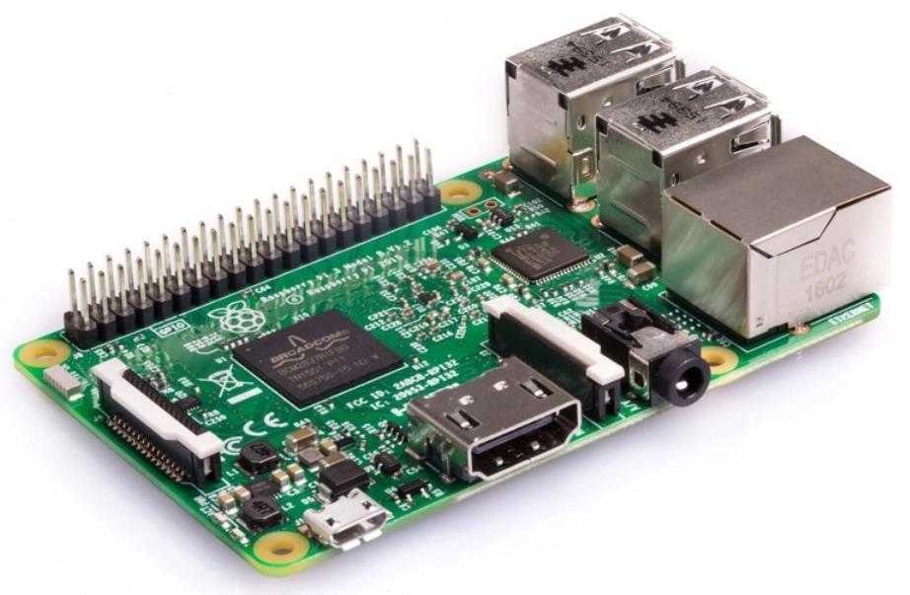
[picture p282: figure]

รูปที่ 2.2 แสดงภาพ Raspberry Pi 3 Model B

Raspberry Pi 3 Model B เปรียบเสมือนคอมพิวเตอร์ขนาดเล็กที่สามารถเชื่อมต่อกับ จอ เมาส์ และคีย์บอร์ดได้ สามารถทำงานได้เหมือนคอมพิวเตอร์ทั่วไป เช่น การทำงานเอกสาร ดูหนัง ัง เพลง การใช้งานอินเทอร์เน็ต การเขียนโปรแกรม เป็นต้น

- ใช้แรงดันไ ้าในการทำงาน 3.3V
- ความถี่ในการท างาน 433MHz
- การสื่อสาร SPI แบบ Half-Duplex
- เทคนิคการมอดูเลต FSK, GFSK, MSK, GMSK, LoRa
- Packet size: 256 bytes
- ความไว: -148db

Raspberry Pi สามารถรองรับระบบปฏิบัติการ Linux ได้หลาย Distros เช ่น Respbian Ubuntu Pidora และ Arch Linux โดยติดตั้งระบบปฏิบัติการลงใน SD Card โดย Raspberry Pi สามารถนำไปประยุกต์ใช้ทำสิ่งต่าง ได้มากมาย เช่น Database Server Robot Microcontroller รายละเอียดทางเทคนิคของ Raspberry Pi 3 Model B มีดังนี้
- Quad Core 1.2GHz Broadcom BCM2837 64bit CPU
- 1GB RAM
- BCM43438 wireless LAN and Bluetooth Low Energy (BLE) on board
- 100 Base Ethernet
- 40-pin extended GPIO
- 4 USB 2 ports
- 4 Pole stereo output and composite video port
- Full size HDMI
- CSI camera port for connecting a Raspberry Pi camera
- DSI display port for connecting a Raspberry Pi touchscreen display
- Micro SD port for loading your operating system and storing data
- Upgraded switched Micro USB power source up to 2.5A

### 2.1.3 AM2315 เซนเซอร์วัดอุณหภูมิและความชื้น

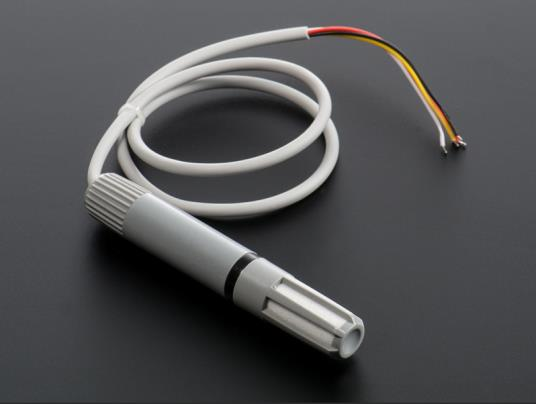
[picture p283: figure]

รูปที่ 2.3 แสดงภาพ AM2315 เซนเซอร์วัดอุ หภูมิและความชื้น

AM2315 คือเซ็นเซอร์วัดค่าอุ หภูมิและความชื้นคุ ภาพสูงที่มีเอาท์พุทเป็นสั า ดิจิตอล โดยมีการสอบเทียบสั า ดิจิตอลเอาท์พุทแล้ว ใช้โมดูลตรวจจับอุ หภูมิละความชื้นคุ ภาพสูงเพื่อให้ แน่ใจว่ามีการวัดค่าที่แม่นยำและมีความทนทาน เซ็นเซอร์ประกอบด้วยตัววัดความชื้นประเภทความจุ ไ ้า อุปกร ์วัดอุ หภูมิที่มีความแม่นยำสูง และเชื่อมต่อด้วยไมโครคอนโทรลเลอร์ 8 บิตประสิท ิภาพ สูง AM2315 สื่อสารด้วย I2C ผู้ใช้สามารถเชื่อต่อ I2C bus ได้โดยตรง

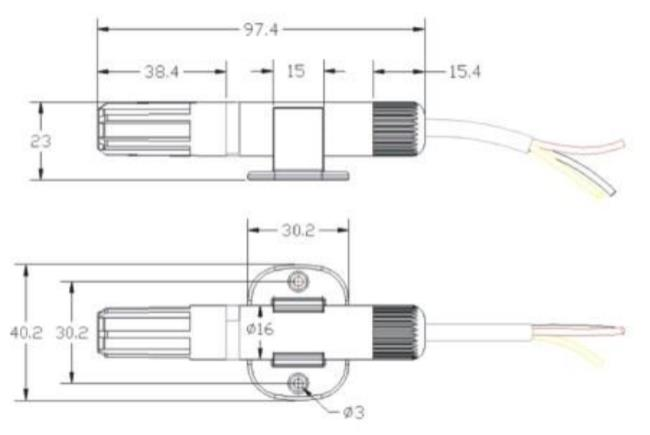
[picture p284: figure]

รูปที่ 2.4 แสดงภาพขนาดของ AM2315 ในหน่วยมิลลิเมตร (mm)

รายละเอียดทางเทคนิคของ AM2315 มีดังต่อไปนี้
- 3.5 to 5.5V power and I/O
- 10 mA max current use during conversion (while requesting data)
- Good for 0-100% humidity readings with 2% accuracy
- Good for -20 to 80°C temperature readings ±0.1°C typical accuracy
- 0.5 Hz update rate
- Body size 98mm x 16mm diameter (4" x 0.9" )
- 4 wires 20 inches long
- Weight: 82.64g
- This board/chip uses I2C 7-bit address 05C.

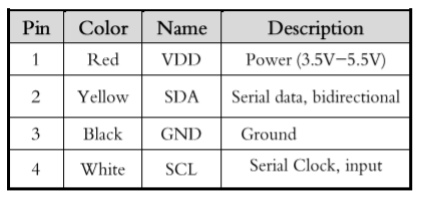
[picture p285: figure]

รูปที่ 2.5 แสดงภาพ AM2315 pin assignment

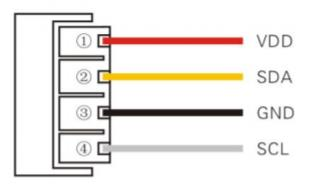
[picture p286: figure]

รูปที่ 2.6 แสดงภาพ AM2315 wiring diagram

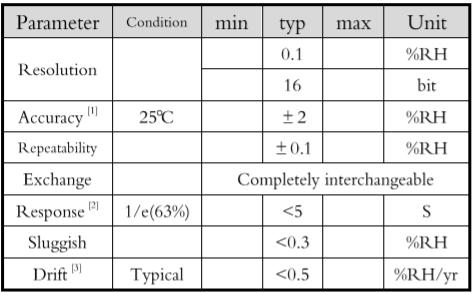
[picture p287: figure]

รูปที่ 2.7 แสดงภาพ AM2315 relative humidity performance table

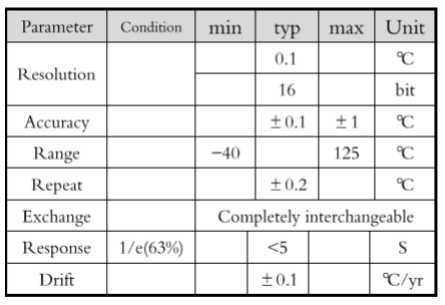
[picture p288: figure]

รูปที่ 2.8 แสดงภาพ AM2315 relative temperature performance table

### 2.1.3.1 โปโตคอลการสื่อสาร I

2C ของเซนเซอร์AM2315
AM2315 I²

c bus มีจุดเชื ่อมต ่อ (Interface) ที ่ได้มาตร าน สามารถต ่อกับ I

2C bus ของ
ไมโครคอนโทรลเลอร์ได้โดยตรง เซนเซอร์ AM2315 มี I2C address (SLAVE ADDRESS) คือ 0xB8

### 2.1.3.1.1 คำอธิบายอินเทอร์เฟซ I2C ของเซนเซอร์ AM2315

การวัดค่าอุ หภูมิและความชื้นที่แม่นยำและลดการทำงานของเซนเซอร์เมื่อเซนเซอร์ไม่มี การทำงานเซนเซอร์จะเปลี่ยนเป็นโหมด Sleep โดยอัตโนมัติ เพื่อลดการทำงานของเซ็นเซอร์ ลดอุ หภูมิ ภายในของเซนเซอร์ เมื ่อต้องการจะอ่านค ่าจากเซนเซอร์ที ่อยู ่ในโหมด Sleep ไมโครคอนโทรลเลอร์ จะต้องจะคำสั่งเพื่อปลุกการทำงานของเซนเซอร์ก่อน ดังนั้นถ้าไม่มีการอ่านค่าจากเซนเซอร์เป็นเวลานาน เมื่อจะอ่านค่าจากเซนเซอร์ต้องอ่านค่าอย่างน้อย 2 วินาที เพราะค่าที่อ่านได้วินาทีแรกจะเป็นค่าล่าสุด ก่อนเซนเซอร์จะเข้าโหมด Sleep

### 2.1.3.1.2 คุณสมบัตินเทอร์เฟซของ I

2C
ลักษ ะเฉพาะ I

2C ของ AM2315 ถ้าต้องการค่าอุ หภูมิและความชื้นที่ดีที่สุด การต่อสาย I

2C bus จะต้องต่อดังรูปที่ 2.9

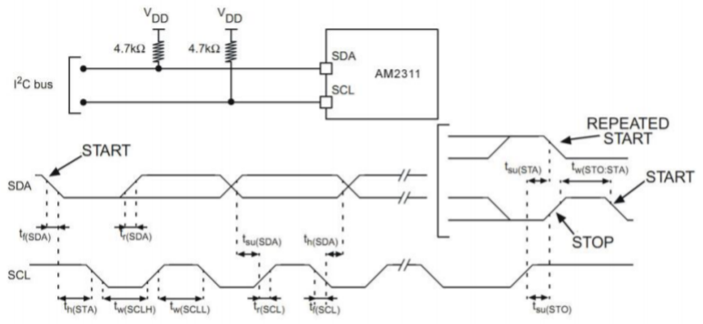
[picture p289: figure]

รูปที่ 2.9 แสดงภาพการต่อวงจรกับ I

2C bus ของ AM2315

### 2.1.3.1.3 โปรโตคอลการสื่อสาร

เซนเซอร์ AM2315 มีโปรโตคอลการสื่อสาร I

2C bus ที่ได้มาตร านโดยอ้างอิงจาก โปรโตคอล ModBus เซนเซอร์ AM2315 ตามมาตร านโรงงานได้ร่วมเอา I

2C_ModBus โดยมีรูปแบบดังต่อไปนี้
1) รูปแบบการสื่อสารข้อมูล (Communication data format)

รูปที่ 2.10 แสดงภาพรูปแบบการสื่อสารข้อมูลของ AM2315

2) การสื่อสารและกระบวนการถ่ายโอนข้อมูล เมื่อมีการส่งคำสั่งการสื่อสารจากไมโครคอนโทรลเลอร์ (host) ไปยัง เซนเซอร์และเซนเซอร์ ได้รับคำสั่งแล้วจะประมวลผลคำสั่งและอ่านค่าจากนั้นจะส่งข้อมูลที่ได้กลับไปยังไมโครคอนโทรลเลอร์ (host) ข้อมูลที่ส่งกลับไปจะประกอบไปด้วย function code, ข้อมูล (data) และ CRC code
3) I

2C slave address ของเซนเซอร์ AM2315 เซนเซอร์ AM2315 ทุกตัวจะมี I

2C address เหมือนกันคือ 0xB8 ดังนั้น ใน I

2C bus จะ
สามารถมีเซนเซอร์ AM2315 ได้เพียงแค่ 1 เซนเซอร์เท่านั้น
4) การสื่อสาร I

2C function code
ในการสื ่อสาร I

2C function code คือ byte แรกของเ รมข้อมูล (frame transmission) กฎของการสื่อสาร I

2C_ModBus กำหนด function code ระหว่าง 1 ถึง 127 เช่น ไมโครคอนโทรลเลอร์ (host) ส ่งความต้องการที ่จะดำเนินงานผ่านทาง function code เพื ่อบอกเซนเซอร์ดำเนินการตามที่ ต้องการ การตอบกลับของเซนเซอร์ก็จะส่ง function code เดียวกันไปยังไมโครคอนโทรลเลอร์ (host) เช่นกัน ตัวอย่างของ function code แสดงดังรูปที่ 2.11

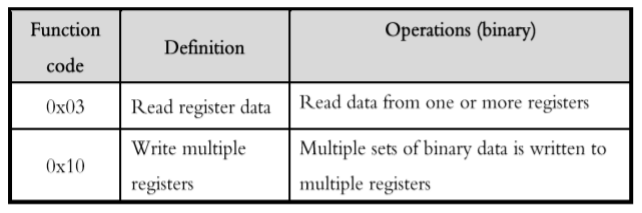
[picture p290: figure]

รูปที่ 2.11 แสดงภาพตัวอย่างของ function code

5) พื้นที่ข้อมูลการสื่อสาร I

2C
พื้นที่ข้อมูล (data area) ประกอบด้วยข้อมูลที่ต้องการจากเซนเซอร์ ตัวอย่างของข้อมูล เช่น อุ หภูมิ ความชื้น ข้อมูลต่าง ของเซนเซอร์ ข้อมูลที่เขียน เป็นต้น ที่อยู่อ้างอิง (reference address) ตัวอย่างเช่น ไมโครคอนโทรลเลอร์ (host) บอกเซนเซอร์ว่า 03 ผ่านทาง function code ข้อมูลที่ได้จะ ประกอบด้วย ความยาวของข้อมูล และ ข้อมูลภายใน register
I

2C_Modbus เ ซน เ ซ อ ร ์ใ ช้โ ป รโ ต ค อ ล ก า ร สื ่ อ ส า ร แบ บ ก ำ ห น ด เ อง (custom) ไมโครคอนโทรลเลอร์ (host) ใช้คำสั่งการสื่อสาร (function code 03) สามารถอ่านข้อมูลใน register ที่ แสดงในรูปที่ 2.12 ได้ทั้งหมด แต่ละ register จะมีขนาดเพียง 1 byte ถ้ามีการอ่านข้อมูลจากซนเซอร์ มากกว่า 10 register ขึ้นไป จะได้ค่า error จากเซนเซอร์

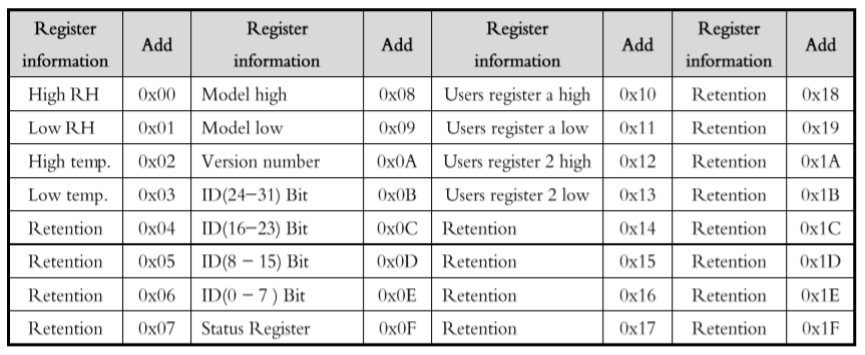
[picture p291: figure]

รูปที่ 2.12 แสดงภาพ AM2315 Data register

6) รูปแบบเอ้าท์พุตของอุ หภูมิ (Temperature output format)
ค่าอุ หภูมิมีความละเอียด 16bit ตำแหน่งค่าอุ หภูมิมากสุด (Bit15) เท่ากับ 1 สำหรับค่า อุ หภูมิที ่ติดลบ มีค ่าเท ่ากับ 0 สำหรับค ่าอุ หภูมิที ่เป็นบวก ค ่าอุ หภูมิจะอยู ่ที ่ (Bit14-Bit0) เป็น ตัวอักษร (string)
7) สาถานะของ Register
สาถานะของ Register Bit7-Bit0 bit แสดงดังรูปที่ 2.13

รูปที่ 2.13 แสดงภาพสาถานะของ Register

### 2.1.3.1.4 Timing การสื่อสาร I

2C
การสื ่อสาร I

2C ของเซนเซอร์ AM2315 แม้ว ่าจะอ้างอิงมาตร าน I

2C Timing แต ่จำเป็น
สำหรับโปรโตคอลของเซนเซอร์ AM2315 และ ข้อกำหนดด้านเวลา (timing) ในการสื่อสาร สำหรับการ อ่านค่าจากเซนเซอร์ที่ถูกต้อง ต้องทำตามข้อกำหนดและ timing
1) ตัวอย่างลำดับการอ่านค่าจากเซนเซอร์
รุปที่ 2.14 ตัวอย่างการอ่านค่าจากเซนเซอร์ AM2315 การอ่านค่าที่ถูกต้องต้องปฏิบัติตาม ข้อตกลงอย่างเข้มงวด จากรูปการสื่อสารระหว่างไมโครคอนโทรลเลอร์ (host)กับเซนเซอร์ตั้งแต่เริ่มต้น จนสิ้นสุดจะใช้เวลามากที่สุดคือ 3 วินาที

รูปที่ 2.14 แสดงภาพตัวอย่างการอ่านค่าจากเซนเซอร์ AM2315

2) I²C Read and write timing decomposition การอ่านหรือเขียนเซนเซอร์ต้องเป็นไปตาม 3 ขั้นตอนต่อไปนี้ มิฉะนั้นจะไม่สามารถสื่อสาร กับเซนเซอร์ได้หรือไม่สามารถอ่านค่าที่ถูกต้อง
ขั้นตอนที่ 1 ปลุกการทำงานของเซนเซอร์ ในการลดความร้อนภายในเซนเซอร์ เซนเซอร์จะ อยู่ในสถานะไม่ทำงาน ต้องปลุกการทำงานของเซนเซอร์ก่อนส่งคำสั่งอ่านและเขียน มิฉะนั้นเซนเซอร์จะ ไม่ตอบสนอง (respond) โดยการตอบกลับด้วยการส่ง ACK การปลุกการทำงานของเซนเซอร์ทำได้ตาม คำสั่งต่อไปนี้
ส่งสั า เริ่มต้น (start signal) ใช้กับโฮสต์ที่อยู่เริ่มต้น รอช่วงเวลาหนึ่ง แล้วส่งสั า สิ้นสุด (stop signal) กล่าวคือ initial signal + 0xB8 + wait (800us-3s) + stop signal ดังรูปที่ 2.15

รูปที่ 2.15 แสดงภาพการปลุกการทำงานของเซนเซอร์

ขั้นตอนที่ 2 อ่านคำสั่งเพื่อส่งหรือส่งคำสั่งเพื่อเขียน

เมื่อปลุกการทำงานของเซนเซอร์แล้วจะสามารถอ่านข้อมูลได้อย่างครบถ้วนด้วยมาตร าน I

2C timing รองรับความเร็วสูงสุด 100Kb/s การอ่านค่าอุ หภูมิและความชื้นเบื่องต้นแสดงดังรูปที่ 2.16 โดยไมโครคอนโทรลเลอร์ (host) จะส่งคำสั่งไปดังนี้ START + 0xB8 (SLA) + 0x03 (function code) + 0x00 (start address) + 0x04 (register length) + STOP

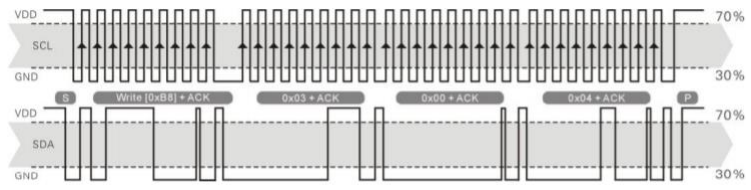
[picture p292: figure]

รูปที่ 2.16 แสดงภาพตัวอย่างการส่งคำสั่งเพื่ออ่านค่าอุ หภูมิและความชื้น

ขั้นตอนที่ 3 ข้อมูลอ่านกลับหรือสั า ยืนยัน
เมื่อไมโครคอนโทรลเลอร์ (host) ส่งคำสั่งเพื่ออ่านหรือเขียนไปแล้วต้องรออย่างน้อย 1.5ms แล้วขั้นตอนต่อไปก็ส่งลำดับการอ่าน (read sequence) เพื่ออ่านค่าจากเซนเซอร์ดังรูปที่ 2.17 เมื่ออ่าน ค่าเสร็จแล้ว I

2C address จะต้องการรอเป็นเวลาอย่างน้อย 30us ก่อนที่จะส่งสั า เพื่ออ่านค่าต่อไป หรือส่งค่า error

รูปที่ 2.17 แสดงภาพตัวอย่างการค่าอ่าอุ หภูมิและความชื้น

ตัวอย่างของข้อมูลที่อ่านได้และส่งกลับไปยังไมโครคอนโทรลเลอร์ (host)
0x03(Function code) + 0x04(Data length) + 0x03(High humidity) + 0x39(Low humidity) + 0x01(High temperature) + 0x15(Low temperature) + 0xE1(CRC Low byte checksum) + 0xFE(CRC High byte checksum);
ดังนั้น 0339H = 3x256+3x16+9 = 825 => Humidity = 825/10=82.5%RH;
0115H = 1x256+1x16+5 = 277 => Temperature = 277/10=27.7*C; จากขั้นตอนทั้งหมดที่ผ ่านมาเป็นกระบวนการอ่านค่าจากเซนเซอร์ ถ้าสามารถปฏิบัติตาม ขั้นตอนทั้งหมดได้ก็จะสามารถใช้งานเซนเซอร์ได้อย่างมีประสิท ิภาพ การอ่านค่าจากเซนเซอร์อย ่าง ต่อเนื่องค่าได้จะอั เดททุก 2 วินาทีเป็นอย่างน้อย (minimum interval of continuous reading 2S)

### 2.1.3.1.5 Flow chart การทำงานของเซนเซอร์

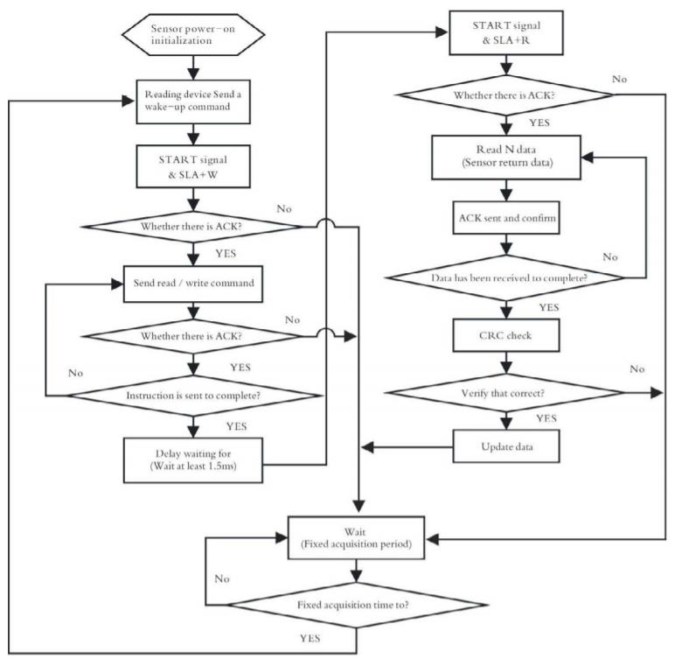
[picture p293: figure]

รูปที่ 2.18 แสดงภาพ Flow chart การทำงานของเซนเซอร์

2.1.4 4-Channel Relay Module

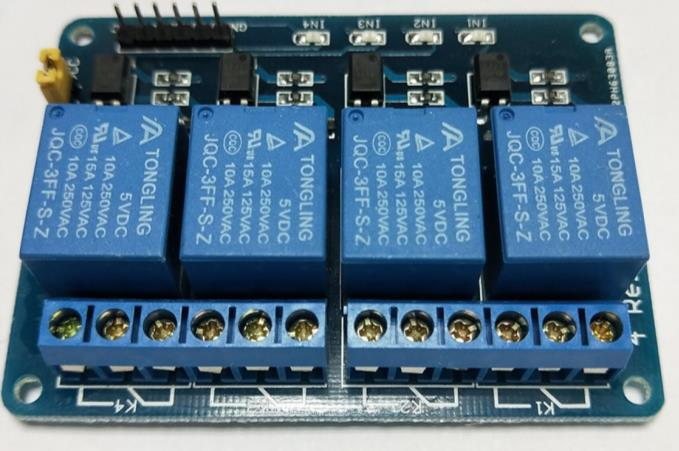
[picture p294: figure]

รูปที่ 2.19 แสดงภาพของ 4-Channel Relay Module

รีเลย์เป็นสวิตช์ที่ทำงานด้วยไ ้าและเช่นเดียวกับสวิตช์อื่น ที่สามารถเปิดหรือปิดได้โดย ปล ่อยให้กระแสไหลผ ่านหรือไม ่ สามารถควบคุมด้วยแรงดันไ ้าต ่ำเช ่น 3.3V ที ่ให้มาโดย Microcontroller GPIO และช่วยให้สามารถควบคุมแรงดันไ ้าสูงเช่น 12V, 24V หรือแรงดันไ หลัก (220V)
รายละเอียดทางเทคนิคของ 4-Channel Relay Module มีดังนี้
- 4-Channel Relay breakout
- Power supply range from 5V~7.5V
- Onboard Photocoupler isolation
- Equiped with high-current relay, AC250V 10A ; DC30V 10A.
- Relay Output Indicator LED
- VCC is system power source, and JD_VCC is relay power source. Ship 5V relay by default. Plug jumper cap to use
- TTL logic interface can be directly connected to microcontroller (Arduino, 8051, AVR, PIC, DSP, ARM, ARM, MSP430, etc )

จากรูปที ่ 2.19 ประกอบด้วย relay จำนวน 4 ตัว แต ่ละตัวมีสามช ่อง common(COM), Normally Closed(NC), Normally Open(NO)
- COM เชื่อมต่อกับแหล่งจ่ายแรงดัน (220V, 12V, 24V)
- NC (Normally Closed) ใช้เมื ่อต้องการให้รีเลย์ทำงานแบบ Normally Closed หมายความว ่าวงจรปิด(กระแสไหล) เว้นแต ่จะส ่งสั า จาก Microcontroller ไปยังโมดูลรีเลย์เพื่อเปิดวงจรและหยุดการไหลของกระแส
- NO (Normally Open) ใช้เมื่อต้องการให้รีเลย์ทำงานแบบ Normally Open หมายความว ่าวงจรเปิด(กระแสไม่ไหล) เว้นแต ่จะส ่งสั า จาก Microcontroller เพื่อปิดวงจร
ด้านแรงดันไ ต่ำ(ต่อกับ Microcontroller) ประกอบด้วย 6 พินดังนี้
- VCC แรงดันไ ้าบวก
- GND Ground
- IN1-IN4 พอร์ตสำหรับควบคุมรีเลย์

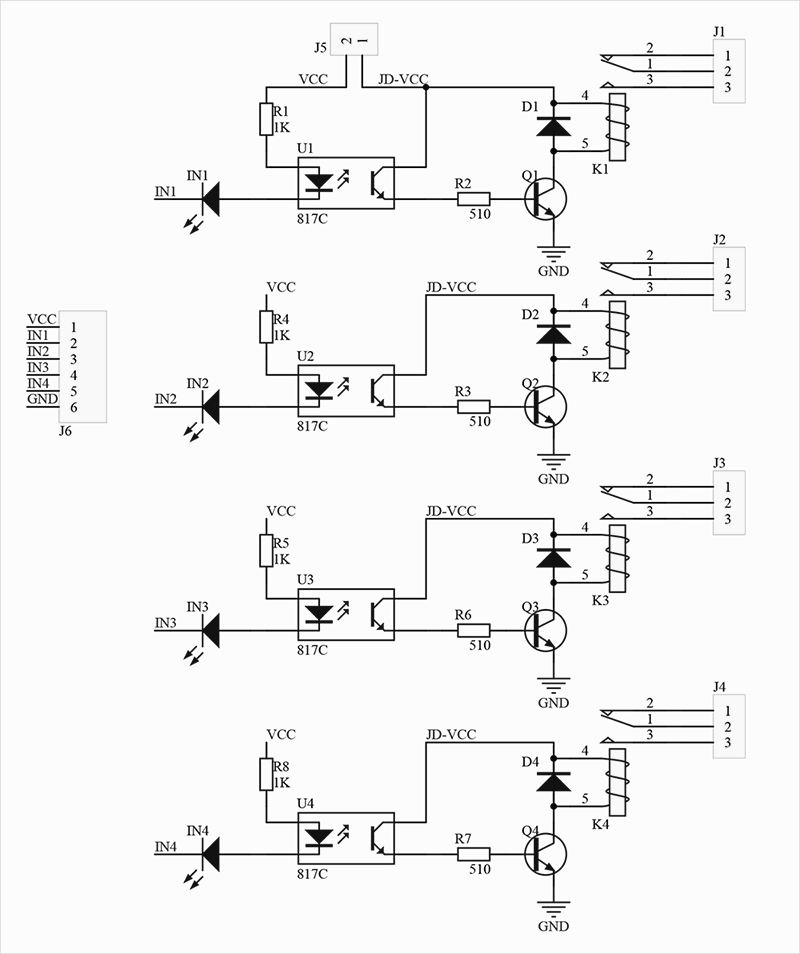
[picture p295: figure]

รูปที่ 2.20 แสดงภาพของ 4-channel relay schematic

จากรูปด้านบน เมื่อพอร์ตสั า (IN) อยู่ในระดับต่ำ(LOW) ไ สั า จะสว่างขึ้นและออป โตคัปเปลอร์ 817c จะแปลงแสงเป็นสั า ทางไ ้า ออปโตคัปเปลอร์ 817c สามารถแยก สั า ไ ้าอินพุตและเอาต์พุตออกจากกัน จากนั้นทรานซิสเตอร์จะทำงาน ขดลวดรีเลย์จะถูก กระแสไ ้า และหน้าสัมผัส(Contact) ที่เปิดตามปกติ(Normally Open) ของรีเลย์จะปิดลง เมื่อพอร์ต สั า (IN) อยู่ในระดับสูง(HIGH) หน้าสัมผัส(Contact) ที่ปิดตามปกติ(Normally Close) ของรีเลย์จะ ปิด

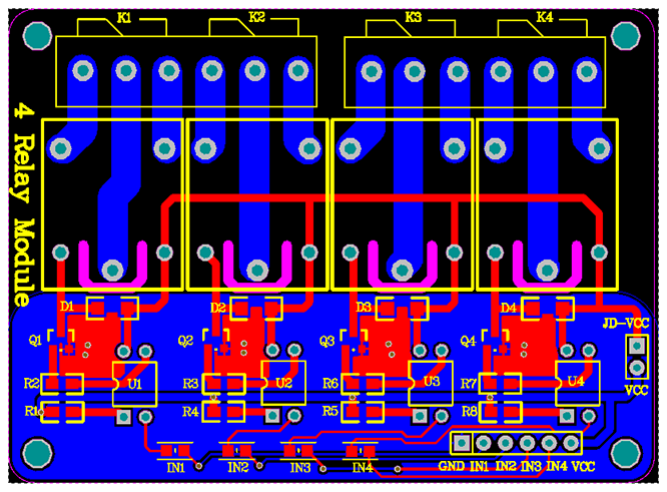
[picture p296: figure]

รูปที่ 2.21 แสดงภาพ 4-channel relay PCB

### 2.1.5 จอแอลซีดี (I2C LCD)

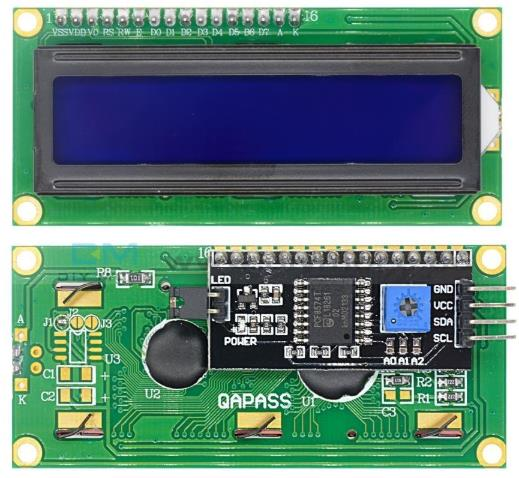
[picture p297: figure]

รูปที่ 2.22 แสดงภาพของจอแอลซีดี (I2C LCD)

I2C LCD ประกอบด้วยวงจรเสริมขนาดเล็กที่ติดตั้งที่ด้านหลังของโมดูล คือชิป PCF8574 ใช้ สำหรับการสื่อสาร I2C และโพเทนชิออมิเตอร์เพื่อปรับแสงจอ (backlight) ข้อดีของ I2C LCD คือการต่อ สายทำได้ง ่ายใช้เพียงสองพินในการควบคุม LCD โดยทั ่วไปแล้ว LCD มาตร านต้องการการเชื่อมต่อ ประมา 12 พินซึ่งอาจเป็นปั หาได้หากคุ ไม่มีพิน GPIO เหลือพอ
บัส I2C เป็นบัสอนุกรมที ่คิดค้นโดย PHLIPS เป็นบัสอนุกรมประสิท ิภาพสูงซึ ่งมีการ กำหนดเวลาบัสและ ังก์ชันซิงโครไนซ์อุปกร ์ความเร็วสูงหรือต่ำที่ระบบโฮสต์หลายระบบต้องการ บัส I2C มีเพียงสองสายสั า สองทิศทาง Serial Data Line (SDA) และ Serial Clock Line (SCL) ข้อมูลจำเพาะของ 16 × 2, 20 × 4 และ LCD ขนาดอื่น ส ่วนให ่จะเหมือนกัน เพาะ ทั้งหมดใช้ตัวควบคุม HD44780 Hitachi LCD เหมือนกัน
รายละเอียดทางเทคนิคของ จอแอลซีดี (I2C LCD) มีดังต่อไปนี้
- Operating voltage 5 V
- Controller Hitachi HD44780 LCD controller
- Default address 0x27
- Screen resolution 2-lines × 16 characters
- Character resolution 5 × 8 pixels
- Module dimensions 80 × 36 × 12 mm
- Viewing area dimensions 64.5 × 16.4 mm

### 2.1.6 เครื่องปั๊มน้ำ (Pump)

เครื่องปั๊มน้ำ (Pump) เป็นอุปกร ์ที่ช่วยส่งผ่านพลังงานจากแหล่งต้นกำเนิดไปยังของเหลว เพื่อทำให้ของเหลวเคลื่อนที่จาก ตำแหน่งหนึ่งไป ยังอีก ตำแหน่งหนึ่งที่อยู่สูงกว่า หรือในระยะทางที่ไกล ออกไป โดยจุดเริ่มต้นของเครื่องปั๊มน้ำนี้มีประวัติศาสตร์ที่ยาวนานกว่า 2,000 ปีก่อนคริสตศักราช ซึ่ง ในช่วงเริ่มแรกมีการใช้พลังงาน ที่ได้จากมนุษย์ สัตว์ ต่อมาจึงได้ใช้พลังงานจาก รรมชาติ เช่น พลังงาน จากลม และน้ำเป็นแหล่งต้นกำเนิด ซึ่งในช่วงแรกเพียง เพื่อการอุปโภคบริโภคและทำการเกษตรเท่านั้น ในปัจจุบันเครื่องปั๊มน้ำจัดเป็นอุปกร ์เครื่องมืออีกชนิดหนึ่งที่มีความเกี่ยวข้องกับชีวิตความ เป็นอยู่ของมนุษย์อย่างมาก เป็นอุปกร ์ ที่ช่วยจัดส่งน้ำเพื่อการอุปโภค บริโภค การเกษตร คมนาคม

อุตสาหกรรม ตลอดจนการบำบัดน้ำเสีย เพื่อรักษา สภาวะแวดล้อม ที่ดีให้กับมนุษย์ ซึ่งวิวัฒนาการของ เครื่องปั๊มน้ำในปัจจุบันได้เปลี่ยนไปจากเดิม ที่ใช้พลังงานจาก แหล่ง รรมชาติมาเป็น การใช้พลังงานจาก ไอน้ำ จากเครื่องยนต์ และที่นิยมกันมากคือ การใช้พลังงานไ ้า เนื่องจากความสะดวกและง่ายต่อการใช้ งาน

### 2.1.6.1 ปั๊มพ่นหมอก DC12V 4.8 บาร์

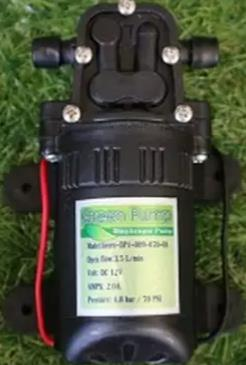
[picture p298: figure]

รูปที่ 2.23 แสดงภาพปั๊มพ่นหมอก DC12V 4.8 บาร์

รายละเอียดทางเทคนิคของ ปั๊มพ่นหมอก DC12V 4.8 บาร์มีดังต่อไปนี้
- แรงดันไ ้า : DC 12V
- กำลังไ ้า: 24 วัตต์
- กินกระแส : 2 แอมป์
- แรงดัน : 4.8 บาร์

- อัตราการไหลสูงสุด : 3.5ลิตร / นาที หรือ 210 ลิตร / ชั่วโมง
- ท่อน้ำเข้า - ออก : 3 หุน ( 3/8 นิ้ว) สามารถใช้สาย 3 หุน สวมเข้ากับท่อเข้า-ออก ปั๊มน้ำได้เลย
- ระยะดูดลึก : ไม่เกิน 1.8 เมตร
- ระบบการทำงาน : ไม่มีสวิตช์แรงดันอัตโนมัติ ( NO Pressure switch ) เหมือนปั๊ม น้ำอัตโนมัติ
- สามารถใช้งานกับแบตเตอรี่ 12V หรือแผงโซล่าเซลล์ไม่ควรต่ำกว่า 30 วัตต์ 12V หรือ 18V
- ขนาดโดยประมา 15*8*7ซม.
- น้ำหนัก 0.5กก.
- ควรใช้งานต่อเนื่องนานประมา 2 ชั่วโมง พัก 15 นาที เพื่อป้องกันการไหม้ของ มอเตอร์
- ปั๊มน้ำไม่ควรโดนน้ำ เพราะจะทำให้น้ำซึมผ่านเข้าไปในมอเตอร์ ทำให้มอเตอร์ไหม้ได้
- สามารถใช้เป็นปั๊มพ่นยา พ่นปุ๋ย สามารถใช้สายพ่นยาได้ 50 เมตร
- สามารถพ่นได้ไกลสูงประมา 4เมตร

### 2.1.7 พัดลม (Fan)

พัดลม (Fan) เป็นอุปกร ์ที่ช่วยให้เกิดการไหลของอากาศ ปัจจุบันพัดลมเป็นอุปกร ์ที่มีใช้ โดยทั่วไปในโรงงานอุตสาหกรรมและอาคารบ้านเรือน

### 2.1.7.1 การจำแนกพัดลมสามารถแบ่งได้เป็นประเภทใหญ่ๆ ตามลักษณะการเคลื่อนที่ของ

อากาศ
1) พัดลมแบบหมุนแรงเหวี่ยง (Centrifugal flow or radial fans) พัดลมแบบแรงเหวี่ยงหรือพัดลมซึ่งมีการไหลของอากาศในแนวรัศมีจะประกอบด้วยใบพัดหมุนอยู่ภายใน ตัวเรือนของพัดลม (Fan house) ชุดใบพัดจะประกอบด้วยแผ่นใบเล็ก ประกอบเข้าด้วยกัน เป็นลักษ ะ กงล้อความดันของอากาศจะถูกทำให้มีค่าสูงขึ้นภายในตัวเรือนของพัดลมซึ่งสามารถเพิ่มค่าให้สูงขึ้นได้ด้วย การเพิ่มขนาดความยาวของใบพัดซึ่งจะทำให้แรงเหวี่ยงหนีศูนย์กลางภายในระบบมีค่ามากขึ้นอากาศจะ

ไหลผ่านเข้าไปในท่อทางเข้าโดยมีทิศทางขนานกับแกนของใบพัดและไหลออกใน ทิศทางตั้งฉากกับแกน ของเพลาใบพัดในท่อทางออกพัดลมประเภทนี้จำแนกตามลักษ ะรูปร่างของ ใบพัดเป็น 3 แบบ คือ
1.1) แบบใบพัดตรง (Straight blade หรือ Radial fans) พัดลมชนิดนี้มีจำนวนใบน้อยที่สุดประมา 6 ถึง 20 ใบและใบพัดจะอยู่ในระนาบรัศมีจากเพลา ใบพัด หมุนด้วยความเร็วรอบอย่างต่ำประมา 500-3000 รอบ/นาที ดังนั้นจึงเหมาะกับงานที่ ต้องการปริมาตร การไหลน้อย และมีค่าความดันของอากาศสูง
1.2) แบบใบพัดโค้งไปข้างหน้า (Forward curved blade fans) พัดลมชนิดนี้จะมีใบพัดโค้งไปข้างหน้าในทิศทางเดียวกับการหมุนชุดใบพัดจะมีจำนวนแผ ่นใบพัด ประมา 20 – 60 ใบชุดใบพัดจะมีลักษ ะคล้ายกับกรงกระรอก (Squirrel cage) เพลาใบพัดจะมีขนาด เล็กหมุนด้วยความเร็วรอบที่สูงกว่าพัดลมชนิดใบพัดตรงการทำงานของพัดลมชนิดนี้มีเสียงเบา ที่สุดมี ข้อเสียคือมีโอกาสที่มอเตอร์จะทำงานเกินกำลังและมีช่วงการทำงานของพัดลมที่ไม่เสถียรดังนั้น จึงไม่ควร ใช้กับงานหรือระบบที่มีอัตราการไหลของอากาศเปลี่ยนแปลงตลอดเวลาพัดลมชนิดนี้จะให้ค่าความดันลม และอัตราการไหลของอากาศสูงที่สุด
1.3) แบบใบพัดโค้งไปข้างหลัง (Backward curved blade fans) พัดลมชนิดนี้จะมีใบพัดเอียงไปข้างหลังในทิศทางตรงกันข้ามกับทิศทางการหมุนของใบพัด จะมีจำนวน ใบพัดประมา 10 –50 ใบ และเป็นพัดลมที่มีความเร็วรอบสูง ไม่ก่อให้เกิดเสียงดังเกินควรไม่ มีลักษ ะ ที่มอเตอร์จะทำงานเกินกำลัง และไม่มีช่วงการทำงานที่ไม ่เสถียรเหมาะที่จะใช้งานระบายอากาศและ อากาศที่ใช้ต้องสะอาดด้วยเนื่องจากสามารถที่จะควบคุมความดันและปริมา ลมได้ง่าย พัดลมชนิดนี้จะมี ราคาสูงกว่าชนิดอื่น เมื่อเทียบขนาดเท่ากัน
2) พัดลมแบบอากาศไหลตามแนวแกน (Axial flow fans) พัดลมแบบนี้อากาศจะไหลขนานกับแกนของใบพัดและตั้งฉากกับระนาบการหมุนของใบพัดชุดใบพัด จะ ถูกติดตั้งบนแกนเพลาขับของมอเตอร์ต้นกำลัง ซึ่งอยู่ภายในตัวพัดลมทำให้มอเตอร์สามารถระบาย ความ ร้อนออกไปกับอากาศที่ถูกขับเคลื่อนพัดลมชนิดนี้มีราคาถูกการทำงานของพัดลมมีเสียงดังและมีช่วงการ

ทำงานของพัดลมที่ไม่เสถียรจึงเหมาะกับงานระบายอากาศ มีขนาดเล็ก เคลื่อนย้ายง่าย สามารถแบ่งได้ 2 ลักษ ะคือ

2.1) พัดลมที่ให้ลมหมุนเป็นเกลียว (Tube axial fans) พัดลมแบบอากาศไหลตามแนวแกนชนิดนี้มีโครงสร้างประกอบด้วยชุดใบพัดซึ ่งหมุนอยู่ภายในท่อรูป ทรงกระบอกลมที่ถูกขับเคลื่อนให้ผ่านชุดใบพัดจะหมุนเป็นเกลียวมีลักษ ะการไหลแบบปั่นป่วน พัดลม ชนิดนี้ให้ค่าความดันลมปานกลาง
2.2) พัดลมที่ให้ลมในแนวเส้นตรง (Vane axial fans) พัดลมแบบอากาศไหลตามแนวแกนชนิดนี้จะมีแผ ่นครีบเพื ่อใช้ในการบังคับการไหลของ อากาศที่ถูกขับเคลื่อนติดตั้งอยู่ภายในตัวเรือนของพัดลม บริเว ท่อทางออกบริเว ด้านหลัง ชุดใบพัดเพื่อช่วยให้การไหลของอากาศที่ถูกขับเคลื่อน มีทิศทางเป็นเส้นตรงมากที่สุดซึ ่งจะ ช่วยลดลักษ ะการไหลของ อากาศปั่นป่วนลดลงและลดพลังงานสู เสียเนื่องจากการไหลของ อากาศปั่นป่วนภายในระบบให้น้อยลงทำให้ประสิท ิภาพการใช้งานและราคาสูงกว่าพัดลม ชนิด Tube axial fans

### 2.1.7.2 การทำงานของพัดลม

การทำงาน และกลไกที ่ทำให้พัดลมกับที ่หรือหมุนส ่ายไปมาพัดลมจะทำงานได้เมื่อ กระแสไ ้า เข้าสู่ระบบ และเมื่อกดปุ่มเลือกให้ลมแรงหรือเร็วตามที่ผู้ใช้ต้องการ กระแสไ ้าจึงไหลเข้า สู่ตัวมอเตอร์ทำให้แกนมอเตอร์หมุนใบพัดที่ติดอยู่กับแกนก็หมุนตามไปด้วยจึงเกิดเป็น ลมพัดออกมา พัด ลมตั้งโต๊ะจะมีราคาต่ำกว ่าพัดลมตั้งพื้นและใช้พลังงานไ ้าต่ำกว ่า ทั้งนี้เพราะมีขนาดมอเตอร์และ กำลังไ ้าต่ำกว่าและพัดลมตั้งพื้นจะให้ลมแรงมากกว่า

### 2.1.7.3 พัดลม 12 นิ้ว 10 ใบ 12V

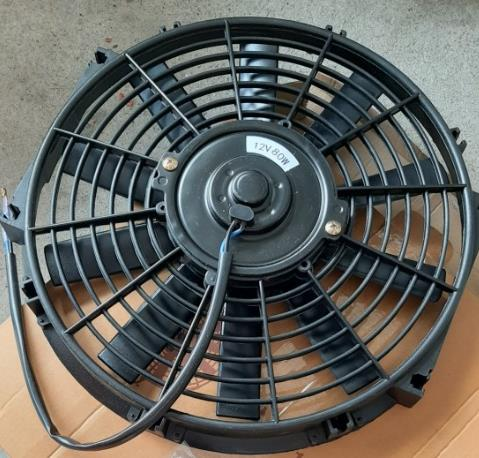
[picture p299: figure]

รูปที่ 2.24 แสดงภาพพัดลม 12 นิ้ว 10 ใบ 12V

รายละเอียดทางเทคนิคของ พัดลม 12 นิ้ว 10 ใบ 12V มีดังต่อไปนี้
- แรงดันไ ้า : DC 12V
- กำลังไ ้า: 80 วัตต์
- กินกระแส : 6.6 แอมป์
- ขนาด 12 นิ้ว
- 10 ใบพัด
- ใบพัดบาง น้ำหนักเบา มีตะแกรงกันการกระเด็น
- สามารถใช้ระบายความร้อนในรถยนต์ หรืองานดัดแปลงอื่น

### 2.1.8 LoRa (Long Range)

LoRa มากจากคำว่า Long Range เป็นหนึ่งในเทคโนโลยีด้าน LPWAN (Low-Power Wide-Area Network) เครือข่ายสื่อสารแบบกว้างที่เน้นใช้พลังงานต่ำ เป็นเทคโนโลยีที่ถือว่าเป็นหัวใจสำคั สำหรับงานทางด้าน IoT (Internet of Things) จุดเด่นของ LPWAN เทคโนโลยีได้แก่
- Secure—Bidirectional Communication
- Simple Star Network Topology ( ไม่จำเป็นต้องมี network ที่ซับซ้อนเช่น Mesh หรือ Repeater )
- Low data rate
- Low cost
- Long battery life
LoRa เป็นเทคโนโลยีการส ่งข้อมูลแบบไร้สายในระยะไกล โดยใช้เทคนิค Proprietary Spread Spectrum technology ซึ่งรูปแบบถูกพัฒนาโดย Semtech Corporation ซึ่งมีย่านความถี่ใน แต่ละภูมิภาคที่แตกต่างกันดังตารางต่อไปนี้
ตารางที่ 2.1 ความถี่ที่ใช้สำหรับ LoRa (หน่วยเป็น MHz)
ไทย | 920-925
ยุโรป | 867-869
อเมริกาเหนือ | 902-928
จีน | 470-510
เกาหลี | 920-925
ี่ปุ่น | 920-925
อินเดีย | 865-867

โดยประกาศจาก กสทช. ที่เกี่ยวข้องกับเทคโนโลยี LPWAN ว่าถ้ามีกำลังส่งไม่เกิน 500 มิลลิ วัตต์ได้รับยกเว้นไม่ต้องได้รับใบอนุ าตให้ มี ใช้ และนำออก ซึ่งเครื่องวิทยุคมนาคมและใบอนุ าตให้ตั้ง สถานีวิทยุคมนาคม แต่ไม่ได้รับยกเว้น ใบอนุ าตให้ทำนำเข้า และค้าซึ่งเครื่องวิทยุ คมนาคม

ถ้ามีกำลังส่งสูงกว่า 500 มิลลิวัตต์จะต้องได้รับใบอนุ าตวิทยุคมนาคมที่ เกี่ยวข้อง และการ ใช้คลื่นความถี่ดังกล่าว จะต้องได้รับอนุ าตให้ใช้คลื่นความถี่ ตามมาตรา ๔๕ แห่งพระราชบั ัติองค์กร จัดสรรคลื ่นความถี ่ และ กำกับการประกอบกิจการวิทยุกระจายเสียง วิทยุโทรทัศน์ และกิจการ โทรคมนาคม พ.ศ. ๒๕๕๓ และจะต้องได้รับ ใบอนุ าตประกอบกิจการโทรคมนาคมแบบที่ สาม

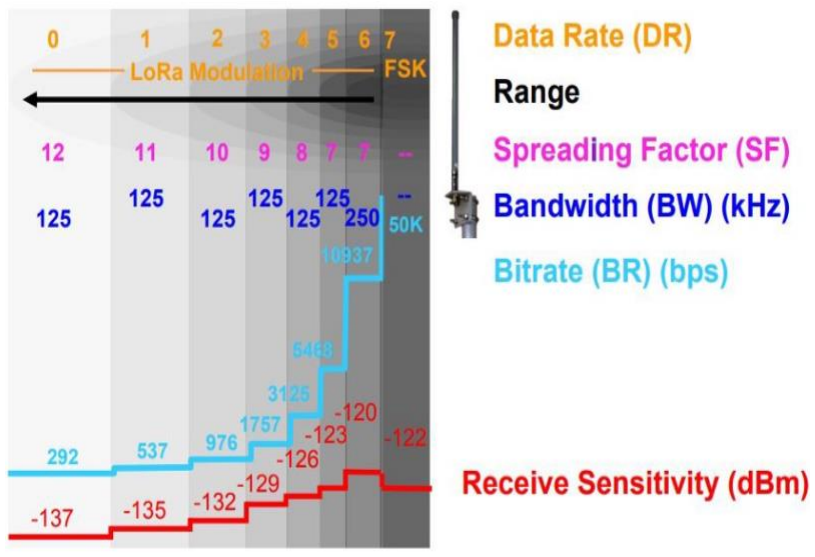
[picture p300: figure]

รูปที่ 2.25 แสดงภาพตัวอย่างค่า Data Rate (DR)

จากรูปที่ 2.25 ตัวอย่างค่า Data Rate ( DR ) สังเกตจากรูป จะเห็นว่า DR เป็น 0 อุปกร ์ จะสามารถส่งข้อมูลได้ไกลที่สุด โดยสามารถส่งด้วย Bitrate ที่ต่ำที่สุดโดยการกำหนด Data Rate จะถูก กำหนดจาก Spreading Factor ( SF ) ตั้งแต่ 7– 12 โดยที่แบนวิดท์ ช่องสั า และค่า SF ที่ปรับได้ อาจจะเปลี่ยนแปลงตาม Frequency plan ของแต่ละโซน

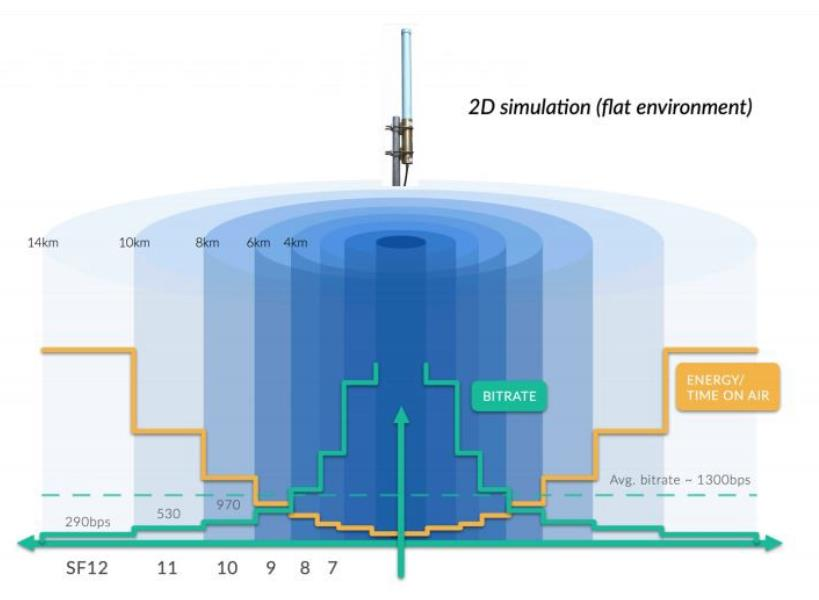
[picture p301: figure]

รูปที่ 2.26 แสดงภาพความสัมพัน ์ระหว่าง BITRATE และระยะห่างของอุปกร ์กับ Gateway

จากรูปที่ 2.26 จะเห็นว่าเมื่ออุปกร ์เข้าใกล้ gateway มากก็จะสามารถที่จะส่งข้อมูลด้วย BITRATE ที่สูงขึ้นได้ และการส่งข้อมูลจะเร็วขึ้นอีกด้วย รวมถึงพลังงานที่ใช้ในการส่งถ้าเทียบต่อขนาดของ แพกเกตก็จะน้อยกว่าอุปกร ์ที่อยู่ไกล Gateway ซึ่งในระดับ LoRaWAN จะมีโหมด ADR ( Adaptive Data Rate ) ที่เซตในแพกเกตการส่งข้อมูลเพื่อให้การเชื่อมต่อระหว่าง Gateway และ Device สามารถ ปรับ Spreading Factor แบบอัตโนมัติเพื่อประสิท ิภาพในการส่งโดยดูจากระยะการเชื่อมต่อระหว่าง Gateway และ Device โดยสามารถเลือกได้ว่าต้องที่จะ ปรับเพื่อส่งข้อมูลได้เร็วที่สุด หรือ ปรับเพื่ออายุ การใช้งานแบตเตอรี่ที่ยาวนานที่สุดเป็นต้น

### 2.1.8.1 คุณสมบัติหลักของเทคโนโลยี LoRa

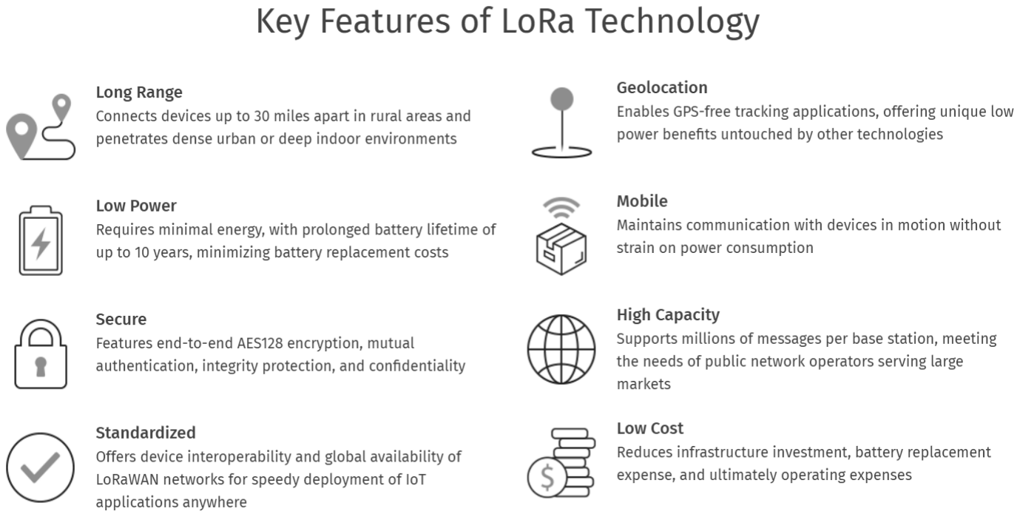
[picture p302: figure]

รูปที่ 2.27 แสดงภาพคุ สมบัติหลักของเทคโนโลยี LoRa

จากรูปที่ 2.27 เทคโนโลยี LoRa มีคุ สมบัติต่าง ดังต่อไปนี้
- Long Range สามารถเชื่อมต่ออุปกร ์ที่ห่างกันไม่เกิน 30 ไมล์ในพื้นที่ชนบทและ เจาะเข้าไปในสภาพแวดล้อมในเมืองที่หนาแน่นหรือในที่ลึก
- Geolocation มีแอปพลิเคชันการระบุตำแหน่งที่ใช้พลังงานต่ำ
- Low Power ใช้พลังงานน้อยที่สุดพร้อมอายุการใช้งานแบตเตอรี่ที่ยาวนานถึง 10 ปี ลดค่าใช้จ่ายในการเปลี่ยนแบตเตอรี่
- Mobile รักษาการสื่อสารกับอุปกร ์ที่เคลื่อนไหวโดยไม่ต้องใช้พลังงานมากเกินไป
- Secure มีการเข้ารหัส AES128 แบบ end-to-end การรับรองความถูกต้องซึ่งกัน และกัน
- High Capacity รองรับข้อความนับล้านต่อสถานี านตอบสนองความต้องการของผู้ ให้บริการเครือข่ายสา าร ะที่ให้บริการในตลาดขนาดให ่

- Standardized ความสามารถในการทำงานร่วมกันของอุปกร ์และความพร้อมใช้ งานทั่วโลกของเครือข่าย LoRaWAN สำหรับการปรับใช้แอปพลิเคชัน IoT ได้อย่าง รวดเร็วทุกที่
- Low Cost ลดการลงทุนโครงสร้างพื้น านค ่าใช้จ่ายในการเปลี ่ยนแบตเตอรี ่และ ค่าใช้จ่ายในการดำเนินงาน

### 2.1.8.2 ความแตกต่างระหว่าง LoRa และ LoRaWan

LoRa ใช้งานได้เฉพาะโปรโตคอลระดับ Link layer เหมาะอย่างยิ่งที่จะใช้ในการสื่อสารแบบ P2P (point to point) ระหว่างโหนด LoRaWan สามารถใช้งานโปรโตคอลระดับ Network layer ทำให้สามารถสื่อสารกับอุปกร ์ อื่นที่เชื่อมต่อกันผ่าน Cloud platform

### 2.1.9 การเชื่อมต่ออุปกรณ์แบบ I2C (I

2C)
I

2C หรือ I2C Bus ย่อมาจาก Inter Integrate Circuit Bus (IIC) นิยมเรียกสั้น ว่า BUS (ไอ-แสคว-ซี-บัส) เป็นการสื ่อสารอนุกรม แบบซิงโครนัส (Synchronous) เพื ่อใช้ ติดต ่อสื ่อสาร ระหว ่าง ไมโครคอนโทรลเลอร์ (MCU) กับอุปกร ์ภายนอก ซึ่งถูกพัฒนาขึ้นโดยบริษัท Philips Semiconductors โดยใช้สายสั า เพียง 2 เส้นเท่านั้น คือ serial data (SDA) และสาย serial clock (SCL) ซึ่งสามารถ เชื่อมต่ออุปกร ์ จำนวนหลาย ตัว เข้าด้วยกันได้ ทำให้ไมโครคอนโทรลเลอร์ใช้พอร์ตเพียง 2 พอร์ต เท่านั้น
I

2C BUS ใช้สายสั า 2 เส้น คือ SCL ,SDA สำหรับติดกับอุปกร์แบบ 2 ทิศทาง โดยที่ ขาสั า ทั้ง 2 จะต้องต่อกับตัวต้านทานแบบ pull up 2-10K เนื่องจากเอาต์พุตมีลักษ ะเป็น แบบ Open Darin หรือเป็นแบบ Open Collector เพื่อให้เอาต์พุตเชื่อมต่อกันได้หลายตัว


รูปที่ 2.28 แสดงลักษ ะการการเชื่อมต่ออุปกร ์แบบ I

2C BUS

### 2.1.9.1 การเขียน-อ่านข้อมูลกับอุปกรณ์แบบ I

2C BUS

รูปที่ 2.29 แสดงรูปแบบการเขียนและอ่านข้อมูลแบบ I

2C BUS

จากรูปที่ 2.29 การรับ-ส่งข้อมูลแบบ I

2C BUS ไมโครคอนโทรลเลอร์จะเริ่มต้นการส่งข้อมูล ด้วยการส ่ง สถานะเริ ่มต้น (START Conditions) เพื ่อแสดงการขอใช้บัส แล้วตามด้วย รหัสควบคุม (Control Byte) ซึ่งประกอบ ด้วยรหัส ประจำตัวอุปกร ์ Device ID ,Device Address ,และ Mode ใน การเขียนหรืออ่านข้อมูล เมื่ออุปกร ์ รับทราบว่าไมโครคอนโทรลเลอร์ต้องการ จะติดต่อด้วยก็ต้องส่ง สถานะรับรู้ (Acknowledge) หรือแจ้งให้ไมโครคอนโทรลเลอร์รับรู้ว่าข้อมูลที่ได้ส่งมามีความถูกต้อง และ เมื ่อสิ้นสุดการส ่งข้อมูล MCU จะต้องส ่ง สถานะสิ้นสุด ( STOP Conditions) เพื ่อบอกกับอุปกร ์ว่า สิ้นสุดการใช้บัส สถานะบัสว่าง คือเมื่อบัสไม่ได้ถูกใช้งาน ทั้ง SCL และ SDA จะเป็น 1 ทั้งคู่

### 2.1.9.2 การกำหนดสถานะเริ่มต้นและสถานะสิ้นสุดของ I

2C BUS (START and STOP
Conditions)


รูปที่ 2.30 แสดง I

2C BUS START and STOP Conditions จากรูปที ่ 2.30 ลักษ ะการกำหนดสถานะเริ ่มต้นและสถานะสิ้นสุดของ I

2C BUS เมื่อ
ต้องการส่งข้อมูล ไมโครคอนโทรลเลอร์จะต้องส่งสถานะเริ่มต้น (START Conditions) คือให้ SDA เปลี่ยน จาก 1 มาเป็น 0 ในข ะที่ SCL มีค่าเป็น 1 และเมื่อสิ้นสุดการการใช้บัส ไมโครคอนโทรลเลอร์จะต้องส่ง สถานะสิ้นสุด ( STOP Conditions) คือให้ SDA เปลี่ยนจาก 0 มาเป็น 1ในข ะที่ SCL มีค่าเป็น 1

### 2.1.9.3 รหัสควบคุมของ I

2C BUS (Control Byte)

รูปที่ 2.31 แสดงรหัสควบคุมของ I

2C BUS (Control Byte)

จากรูปที่ 2.31 รหัสควบคุมของ I

2C BUS ประกอบด้วยรหัสประจำตัวของอุปกร ์ (Device ID) ประกอบด้วยบิต 1-7 และบิต 0 เป็นบิตควบคุมการเขียนอ ่าน รหัสประจำตัวของอุปกร ์ ประกอบด้วยรหัสประจำตัวจากผู้ผลิต Product ID 4 บิต (บิต 4-7) ที ่เปลี ่ยนแปลงแก้ไขไม ่ได้ และ

Device Address 3 บิต (บิต 1-3) ซึ่งผู้ใช้ สามารถ กำหนด เองได้ รวมแลัวเป็นรหัส 7 บิท ใช้ระบุตัว อ ุปกร ์ ที ่ต ่ออยู ่บนบัส จะมีค ่าซ้ำกันไม ่ได้ บิตควบค ุมการเขียนอ ่าน (Mode) บิต 0 เมื่อ ไมโครคอนโทรลเลอร์ต้องการเขียนข้อมูลไปยังอุปกร ์ก็กำหนดให้บิตนี้เป็น 0 และเมื่อต้องการ อ่าน ข้อมูล จากอุปกร ์ ก็กำหนดให้บิตนี้เป็น 1

### 2.1.9.4 ช่วงเวลารับส่งบิตข้อมูลของ I

2C BUS


รูปที่ 2.32 แสดงช่วงเวลารับส่งบิตข้อมูลของ I

2C BUS

จากรูปที่ 2.32 สะภาวะการรับ-ส่งข้อมูล จะกระทำในข ะที่ขา SCL เป็น 1 และสะภาวะการ เปลี่ยนแปลงข้อมูล จะกระทำในข ะที่ขา SCL เป็น 0

### 2.1.10 วงจรแปลงสัญญาณอนาล็อกเป็นดิจิตอล (Analog to Digital Converter)

การรับสั า จากตัวตรวจจับ (Sensor) ที ่เป็นสั า อนาล็อกในรูปของแรงดันหรือ กระแสที่เปลี่ยนแปลง เช่น ตัวตรวจจับอุ หภูมิความดัน แสง ฯลฯ มาประมวลผลด้วยตัวประมวลผลที่ เป็นวงจร ดิจิตอล ไมโครโปรเซสเซอร์หรือไมโครคอมพิวเตอร์จะต้องมีการเปลี่ยนสั า อนาล็อกจาก ตัวตรวจจับเหล่านั้นให้เป็นสั า ดิจิตอล โดยใช้วงจรที่เรียกว่า วงจร Analog to Digital Converter (ADC) ซึ ่งวิ ีการในการแปลงสั า จากอนาล็อกเป็นดิจิตอลมีหลายวิ ีด้วยกันตั้งแต่ใช้วงจรแปลง สั า จากอนาล็อกเป็น Counter Ramp ADC, แบบ Linear Ramp ADC, แบบ Dual Slope ADC

หรือแบบ Successive Approximation ADC ซึ่งวังจรดังกล่าวนี้อาจอยู่ในรูปของวงจรที ่ประกอบจาก วงจรเปรียบเทียบแรงดัน และวงจรเข้ารหัส หรือวงจรที่ประกอบจากวงจรเปลี่ยนเทียบแรงดันวงจรนับ วงจรเปลี่ยนสั า จากดิจิตอลเป็นอนาล็อก รวมทั้งที่สร้างเป็นไอซีส าเร็จรูปที่ใช้ส าหรับแปลงสั า อนาล็อกเป็นดิจิตอลโดยเฉพาะ
วงจรแปลงสั า อนาล็อกเป็นดิจิตอลเป็นวงจรที่ท าหน้าที่แปลงสั า อนาล็อกที่อยู่ใน รูปของแรงดันหรือกระแสที่เปลี่ยนแปลง ให้เป็นสั า ดิจิตอลเพื่อส่งไปยังส่วนประมวลผลที่ใช้วงจร ดิจิตอลไมโครโปรเซสเซอร์หรือไมโครคอมพิวเตอร์


รูปที่ 2.33 แสดงบล็อกไดอะแกรมของระบบควบคุมที่ประกอบด้วยวงจร ADC ตัวประมวลผลและ วงจร DAC

จากรูปที ่ 2.33 ทรานสดิวเซอร์จะตรวจจับการเปลี ่ยนแปลงทางกายภาพ (Physical Variable) เช่นการเปลี่ยนแปลงของอุ หภูมิ, ความเข้มของแสง, อัตราการไหล, ความดัน และความเร็ว แล้วท าการเปลี่ยนการเปลี่ยนแปลงทางกายภาพเหล่านั้นให้เป็นการเปลี่ยนแปลงของสั า ไ ้าในรูป ของแรงดันหรือกระแสที่ เป็นสัดส่วนโดยตรงกับการเปลี ่ยนแปลงทางกายภาพนั้น อุปกร ์ ทรานสดิวเซอร์ที ่สามารถตรวจจับ สั า ดังกล่าวได้แก่ เทอร์มิสเตอร์ (Thermister) ,โ โต้ไดโอด (Photo Diode) , โ โต้เซลล์(Photo cell) , Flow Meter , Pressure Transducer หรือ Tachometer ตามล าดับ หลังจากนั้นจะส่งสั า ไ ้าที่ได้ไปยัง วงจรแปลงสั า อนาล็อกเป็นสั า ดิจิตอล เพื่อท าการแปลงสั า ไ ้าดังกล่าวให้เป็นสั า ดิจิตอล แล้วส่งต่อไปยังส่วนควบคุมหรือส่วน ประมวลผลที่เป็นวงจรดิจิตอลไมโครโปรเซอสเซอร์ หรือ ไมโครคอมพิวเตอร์ซึ่งจะท าหน้าที่ประมวลผล

สั า ดิจิตอลที่อินพุต ตามเงื่อนไขของโปรแกรมที่ก าหนดไว้จากนั้นส่งผลลัพ ์ที่ได้จากการประมวลผล ในรูปของสั า ดิจิตอลไปที ่เอาท์พุตซึ ่งมีวงจรแปลงสั า ดิจิตอลเป็นอนาล็อกที ่ท าการแปลง สั า ดิจิตอลให้เป็นอนาล็อกส่งไปยัง Actuator ที ่ใช้ควบคุมการเปลี ่ยนแปลงทางกายภาพ เช่น ควบคุมการเปิดปิดของวาล์ว ควบคุมการท างานของ Heaterหรือควบคุมทิศทางความเร็ว หรือต าแหน่ง ของมอเตอร์เป็นต้น

### 2.1.10.1 การใช้งาน ADC กับไมโครคอนโทรลเลอร์(ESP32)

การอ่านค่าอนาล็อกด้วยไมโครคอนโทรลเลอร์ (ESP32) หมายความว ่าจะสามารถอ่านค่า แรงดันระหว่าง 0V ถึง 3.3V ซึ่ง ESP32 สามารถอ่านค่าอนาล็อกด้วยความละเอียดสูงสุดถึง 12-bit จากนั้นแรงดันไ ้าที่วัดได้จะถูกกำหนดให้เป็นค่าระหว่าง 0 ถึง 4095 โดยที่ 0 V สอดคล้อง กับ 0 และ 3.3 V สอดคล้องกับ 4095 แรงดันไ ้าระหว่าง 0 V ถึง 3.3 V จะได้รับค่าที่สอดคล้องกัน ระหว่าง


รูปที่ 2.34 แสดงภาพความละเอียดและแรงดันที่ ESP32 สามารถอ่านได้

ค่า ADC ไม่ใช่เชิงเส้น (Non-linear) ตามหลักการแล้วเมื่อใช้พิน ESP32 ADC อ่านค่าคาดว่า จะเป็นแบบเชิงเส้น (Linear) แต่ในการใช้งานจริงค่าที่ได้จะเป็นดังรูปด้านล่าง


รูปที่ 2.35 แสดงภาพค่าอนาล็อกที่อ่านได้เมื่อใช้ ESP32

จากรูปที ่ 2.35 จะเห็นว ่า ESP32 จะไม ่สามารถแยกความแตกต ่างจาก 3.2V ถึง 3.3V กล่าวคือค่าความละเอียดที่ได้จะเป็นค่าเดียวกันคือ 4095 เช่นเดียวกันในระดับแรงดันที่ต่ำมาก จาก 0V ถึง 0.1V ค่าความละเอียดที่ได้จะเป็นค่าเดียวกันคือ 0
ังก์ชัน analogRead() การอ่านอินพุตอะนาล็อกด้วย ESP32 โดยใช้ Arduino IDE ทำได้ ง ่ายเพียงแค ่ใช้ ังก์ชัน analogRead () โดยการกำหนดขา GPIO ที ่จะใช้อ ่านค ่าอนาล็อก analogRead(GPIO); ESP32 รองรับการวัดใน 18 ช่องสั า บอร์ด DEVKIT V1 DOIT มีเพียง 15 ตัว เท่านั้น (เวอร์ชันที่มี 30 GPIOs)


รูปที่ 2.36 แสดงภาพ ESP32 Pinout Reference

ไม ่สามารถใช้พิน ADC2 เมื ่อใช้ Wi-Fi ดังนั้นหากใช้ Wi-Fi และมีปั หาในการรับค ่าจาก ADC2 GPIO อาจพิจาร าใช้ ADC1 GPIO แทนซึ่งจะช่วยแก้ปั หาได้ ังก์ชั่นที่มีประโยชน์อื่น ังก์ชั่นขั้นสูงสำหรับใช้กับพิน ADC ที่สามารถเป็นประโยชน์ในการ ใช้งาน ESP32 ADC
- analogReadResolution(resolution) การกำหนดความละเอียดในการอ ่านค่า อนาล็อก สามารถกำหนดความละเอียดได้ตั้งแต่ 9-bit (0-511) ถึง 12-bit ค่าความ ละเอียดเริ่มต้นคือ 12-bit
- analogSetWidth(width) มี วั ต ถ ุ ป ร ะ สง ค ์ ก า ร ใ ช้ง า น เ ห มื อ น ัง ก ์ ชั่ น analogReadResolution(resolution)
- analogSetCycles(cycles) กำหนดจำนวนรอบต่อตัวอย่าง (sample) ค่าเริ่มต้นคือ 8 (0-255)

- analogSetSamples(samples) กำหนดจำนวนตัวอย ่าง (samples) ในช ่วง ค่า เริ่มต้นคือ 1 ตัวอย่าง (sample) มีผลในการเพิ่มความไว (sensitivity)
- analogSetClockDiv(attenuation) ตั้งค่าตัวแบ่งสำหรับสั า นาฬิกา ADC ค่า เริ่มต้นคือ 1 ช่วง (1-255)
- analogSetAttenuation(attenuation) ตั้งค ่าการลดทอนอินพุตสำหรับพิน ADC ทั้งหมด ค่าเริ่มต้นคือ ADC_11db การตั้งค่า ADC_0db คือไม่มีการลดทอนอินพุต (1V input = ADC reading of 1088) การตั้งค ่า ADC_2_5db ตั้งค ่าการลดทอน เป็น 1.34 (1V input = ADC reading of 2086) การตั้งค่า ADC_6db ตั้งค่าการ ลดทอน 1.5 (1V input = ADC reading of 2975) การตั้งค่า ADC_11db sets an attenuation of 3.6 (1V input = ADC reading of 3959)
- analogSetPinAttenuation(pin, attenuation) ตั้งค่าการลดทอนอินพุตสำหรับพิน ที่ระบุค่าเริ่มต้นคือ ADC_11db ค่าการลดทอนจะเหมือนกันจาก ังก์ชันก่อนหน้า
- adcAttachPin(pin) แนบ (Attach) พินเข้ากับ ADC (ล้างโหมดอะนาล็อกอื่น ที่ อาจเปิดอยู่) ส่งคืนผลลัพ ์เป็นค่า TRUE หรือ FALSE
- adcStart(pin), adcBusy(pin) and resultadcEnd(pin) เริ ่มการแปลง ADC บน บัส (bus) ของพินที่แนบ (Attach) มาตรวจสอบว่าการแปลงบนบัส ADC ของพิน กำลังทำงานอยู่หรือไม่ (ส่งกลับค่า TRUE หรือ FALSE) รับผลลัพ ์ของการแปลง: ส่งกลับจำนวนเต็ม 16 บิต

### 2.1.11 อุณหภูมิ (Temperature)

คือการวัดค่าเฉลี่ยของพลังงานจลน์ของอนุภาคในสสารใด ซึ่งสอดคล้องกับความร้อนหรือ เย็นของสสารนั้น ในอดีตมีแนวคิดเกี่ยวกับอุ หภูมิเกิดขึ้นเป็น 2 แนวทาง คือตามแนวทางของหลักอุ หพลศาสตร์ และตามการอ ิบายเชิงจุลภาคทาง ิสิกส์เชิงสถิติ แนวคิดทางอุ หพลศาสตร์นั้น ถูก พัฒนาขึ้นโดยลอร์ดเคลวิน โดยเกี่ยวข้องกับการวัดในเชิงมหภาค ดังนั้นคำจำกัดความอุ หภูมิในเชิงอุ หพลศาสตร์ในเบื้องแรก จึงระบุเกี ่ยวกับค ่าตัวแปรต ่าง ที ่สามารถตรวจวัดได้จากการสังเกต ส ่วน แนวทางของ ิสิกส์เชิงสถิติจะให้ความเข้าใจในเชิงลึกยิ่งกว ่าอุ หพลศาสตร์ โดยอ ิบายถึงการสะสม จำนวนอนุภาคขนาดให ่ และตีความพารามิเตอร์ต่าง ในอุ หพลศาสตร์ (เชิงมหภาค) ใน านะค่าเฉลี่ย ทางสถิติของพารามิเตอร์ของอนุภาคในเชิงจุลภาค

ในการศึกษา ิสิกส์เชิงสถิติ สามารถตีความคำนิยามอุ หภูมิในอุ หพลศาสตร์ว่า เป็นการวัด พลังงานเฉลี่ยของอนุภาคในแต่ละองศาอิสระในระบบอุ หพลศาสตร์ โดยที่อุ หภูมินั้นสามารถมองเป็น คุ สมบัติเชิงสถิติ ดังนั้นระบบจึงต้องประกอบด้วยปริมา อนุภาคจำนวนมากเพื่อจะสามารถบ่งบอกค่า อุ หภูมิอันมีความหมายที่นำไปใช้ประโยชน์ได้ ในของแข็ง พลังงานนี้พบในการสั่นไหวของอะตอมของ สสารในสภาวะสมดุล ในแก๊สอุดมคติ พลังงานนี้พบในการเคลื่อนไหวไปมาของอนุภาคโมเลกุลของแก๊ส

### 2.1.11.1 ความร้อนและอุณหภูมิ

สสารทั้งหลายประกอบด้วย อะตอมรวมตัวกันเป็นโมเลกุล การเคลื่อนที่ของอะตอม หรือการ สั่นของโมเลกุล ทำให้เกิดรูปแบบของพลังงานจลน์ ซึ่งเรียกว่า “ความร้อน” (Heat) เราพิจาร าพลังงาน ความร้อน (Heat energy) จากพลังงานทั้งหมดที่เกิดขึ้นจากการเคลื่อนที่ของอะตอมหรือโมเลกุลทั้งหมด ของสสาร
อุ หภูมิ (Temperature) หมายถึง การวัดค่าเฉลี่ยของพลังงานจลน์ซึ่งเกิดขึ้นจากอะตอมแต่ ละตัว หรือแต่ละโมเลกุลของสสาร เมื่อเราใส่พลังงานความร้อนให้กับสสาร อะตอมของมันจะเคลื่อนที่เร็ว ขึ้น ทำให้อุ หภูมิสูงขึ้น แต ่เมื ่อเราลดพลังงานความร้อน อะตอมของสสารจะเคลื ่อนที ่ช้าลง ทำให้ อุ หภูมิลดต่ำลง
หากเราต้มน้ำด้วยถ้วยและหม้อบนเตาเดียวกัน จะเห็นได้ว่าน้ำในถ้วยจะมีอุ หภูมิสูงกว่า แต่ จะมีพลังงานความร้อนน้อยกว่าในหม้อ เนื่องจากปริมา ความร้อนขึ้นอยู่กับมวลทั้งหมดของสสาร แต่ อุ หภูมิเป็นเพียงค่าเฉลี่ยของพลังงานในแต่ละอะตอม ดังนั้นบรรยากาศชั้นบนของโลก (ชั้นเทอร์โมส เ ียร์) จึงมีอุ หภูมิสูง แต่มีพลังงานความร้อนน้อย เนื่องจากมีมวลอากาศอยู่อย่างเบาบาง

### 2.1.11.2 หน่วยของอุณหภูมิและการแปลงหน่วย

การแปลงหน่วยอุ หภูมิ คือการแปลงข้อมูลอุ หภูมิในหน่วยอุ หภูมิหนึ่ง ให้กลายเป็นอีก หน่วยอุ หภูมิหนึ่ง อาทิ เช่น 0 องศาเซลเซียส เป็น 32 องศา าเรนไฮต์ ซึ่งต้องใข้สูตรทางค ิตศาสตร์ใน การแก้
องศาเซลเซียส (อังกฤษ:Celcius, สั ลักษ ์: °C) ตั้งตามชื่อของนักดาราศาสตร์ชาวสวีเดน นายแอนเดอร์ เซลเซียส (Anders Celsius) เป็นคนแรกที ่เสนอระบบที ่ใกล้เคียงกับระบบนี้ (องศา เซนติเกรด) นี้ ในปี พ.ศ. 2285 (ค.ศ. 1742) กำหนดอุ หภูมิจุดเยือกแข็งของน้ำคือ 0 องศา และจุดเดือด ของน้ำคือ 100 องศาเซลเซียส ที่ระดับความดันบรรยากาศมาตร าน ในปัจจุบันองศาเซลเซียสใช้กับ

แพร่หลายทั่วโลกในชีวิตประจำวัน ยกเว้นประเทศสหรั อเมริกา และ ประเทศไลบีเรีย รวมถึงประเทศที่ ใช้บริการทางอุตุนิยมวิทยา และ ดินแดนโพ้นทะเลของสหราชอา าจักรฯ เท่านั้นที่นิยมใช้หน่วยองศา า เรนไฮต์ แต่องศาเซลเซียสใช้ในวงการวิทยาศาสตร์ทั่วโลกอย่างเป็นสากล

การแปลงหน่วยอุ หภูมิจากองศา าเรนไฮต์(Fahrenheit) เป็นองศาเซลเซียส (Celcius) จากสมการ

°F = °C x 9/5 +32
จะได้

°C = (°F - 32) x 5/9
การแปลงหน่วยอุ หภูมิจากเคลวิน (kelvin) เป็นองศาเซลเซียส (Celcius) จากสมการ

K = °C + 273.15
จะได้

°C = K − 273.15

องศา าเรนไฮต์ (อังกฤษ:Fahrenheit, สั ลักษ ์: °F) คือหน่วยมาตรวัดอุ หภูมิชนิดหนึ่ง ตั้งชื่อตามนัก ิสิกส์ชาวเยอรมัน กาเบรียล าเรนไฮต์ (1686-1736) ผู้เสนอระบบมาตรวัดอุ หภูมินี้เมื่อ ปี ค.ศ.1724 โดยที ่ค่าสเกลองศา าเรนไฮต์มีจุดอ้างอิงต ่ำสุด 0°F เป็นอุ หภูมิจุดเยือกแข็งของ น้ำ น้ำแข็ง และ เกลือแอมโมเนียมคลอไรด์ องศา าเรนไฮต์เป็นมาตรวัดอุ หภูมิแรกที่มีการใช้งานกันอย่าง แพร่หลาย ในปัจจุบัน องศา าเรนต์ไฮต์ใช้จุดแข็งและจุดเดือดของน้ำเป็นจุดอ้างอิง โดยมีจุดเยือกแข็งอยู่ ที่ 32°F และ มีจุดเดือดที่ 212°F โดยที่มีระยะห่างระหว่างจุดเยือกแข็งกับจุดเดือดของน้ำคือ 180 องศา ความดันบรรยากาศมาตร าน ระดับน้ำทะเล าเรนไฮต์เป็นมาตรวัดอุ หภูมิอย่างเป็นทางการใน สหรั อเมริกา และประเทศที่ใกล้ชิดกับสหรั อเมริกาในมหาสมุทรแปซิ ิกตะวันตก ดินแดนหมู่เกาะที่เป็น ดินแดนโพ้นทะเลของสหราชอา าจักร และ ประเทศไลบีเรีย

การแปลงหน่วยอุ หภูมิจากเคลวิน (kelvin) เป็นองศา าเรนไฮต์ (Fahrenheit) จากสมการ

K = (°F + 459.67) × 5⁄9
จะได้

°F = K × 9⁄5 − 459.67
การแปลงหน่วยอุ หภูมิจากองศาเซลเซียส (Celcius) เป็นองศา าเรนไฮต์ (Fahrenheit) จากสมการ

°C = (°F − 32) × 5⁄9
จะได้

°F = °C × 9⁄5 + 32

เคลวิน (อังกฤษ: kelvin, สั ลักษ ์: K) เป็นหน่วยวัดอุ หภูมิหนึ่ง และเป็นหน่วยพื้น าน หนึ ่งในเจ็ดของระบบเอสไอ นิยามให้เท ่ากับ 1/273.16 เท ่าของอุ หภูมิเทอร์โมไดนามิกของจุดสาม สถานะของน้ำ เคลวินตั้งชื่อเพื่อเป็นเกียรติแต่นัก ิสิกส์และวิศวกรชาวอังกฤษ วิลเลียม ทอมสัน บารอนที่ หนึ่งแห่ง เคลวิน (William Thomson, 1st Baron Kelvin) เคลวิน เป็นหน่วยของหน่วยวัดอุ หภูมิหนึ่ง ที่ลอร์เควิน ได้พัฒนาคิดสเกลขึ้นใหม่ โดยหาความสัมพัน ์ระหว่างอุ หภูมิและความเร็วของอิเล็กตรอนที่ เคลื่อนที่รอบนิวเคลียส โดยสังเกตว่าถ้าให้ความร้อนกับสสารมากขึ้น อิเล็กตรอนจะมีพลังงานมากขึ้น ทำ ให้เคลื่อนที่มีความเร็วมากขึ้น ในทางกลับกันถ้าลดความร้อนให้กับสสาร อิเล็กตรอนก็จะมีพลังงานน้อยลง ทำให้การเคลื่อนที่ลดลง และถ้าสามารถลดอุ หภูมิลงจนถึงจุดที่อิเล็กตรอนหยุดการเคลื่อนที่ จุดนั้น จะไม่มีอุ หภูมิหรือพลังงานในสสารเลย และจะไม่มีการแผ่รังสีความร้อนจากวัตถุ จึงเรียกอุ หภูมิ จุด นี้ว่า ศูนย์สัมบูร ์ (0 K) อุ หภูมิเพิ่ม 1 K มีค่าเท่ากับ 1°C

การแปลงหน่วยอุ หภูมิจากองศาเซลเซียส (Celcius) เป็นเคลวิน (kelvin) จากสมการ

°C = K − 273.15
จะได้

K = °C + 273.15
การแปลงหน่วยอุ หภูมิจากองศา าเรนไฮต์ (Fahrenheit) เป็นเคลวิน (kelvin) จากสมการ

°F = K × 9⁄5 − 459.67
จะได้

K = (°F + 459.67) × 5⁄9

### 2.1.12 ความชื้น (Humidity)

ความชื้น (Humidity) หมายถึง ปริมา ไอน้ำที ่มีอยู ่ในอากาศ เมื ่อน้ำได้รับความร้อนจะ เปลี่ยนสถานะจากของเหลวกลายเป็นไอลอยขึ้นในอากาศ เรียกว่า การระเหย ซึ่งความร้อนที่ใช้ในการทำ ให้น้ำระเหยกลายเป็นไอ เรียกว่า ความร้อนแฝง (Latent Heat) เมื่ออากาศเย็นลงไอน้ำจะเริ่มกลั่นตัวเป็น ละอองและคายความร้อนแฝงออกมาด้วย กาศจะได้รับไอน้ำมากหรือน้อยขึ้นอยู ่กับอุ หภูมิ ดังนั้น อุ หภูมิจึงเป็นตัวกำหนดปริมา ไอน้ำในอากาศ อากาศที่มีอุ หภูมิสูงจะรับไอน้ำได้มากกว่าอากาศที่มี อุ หภูมิต่ำ ถ้าอากาศไม่สามารถรับไอน้ำได้เรียกว่า ไอน้ำอิ่มตัว (Saturate)

### 2.1.12.1 ความชื้นในอากาศ

ความชื้นในอากาสสามารถแบ่งออกเป็น 4 ประเภท คือ
1) ความชื้นสัมบูร ์ (Absolute Humidity) เป็นน้ำหนักของไอน้ำที่มีอยู่จริงในปริมาตรของ อากาศจำนวนหนึ่งคำนว ได้จากน้ำหนักของไอน้ำต่อหนึ่งหน่วยปริมาตรของอากาศ หรือกล่าวอีกนัยหนึ่ง ว่าความชื้นสัมบูร ์คือความหนาแน่นของไอน้ำในอากาศ หน่วยที่ใช้มักเป็นกรัมต่อลูกบาศก์เมตรความชื้น สัมบูร ์ไม่นิยมใช้ในทางอุตุนิยมวิทยาเพราะเมื่ออากาศลอยตัวขึ้นหรือจมตัวลงจะทำให้ปริมาตรของ

อากาศเปลี่ยนแปลงเนื่องจากบริเว รอบ ความกดอากาศจะเปลี่ยนแปลงแม้ว่าไอน้ำที่มีอยู่ในอากาศจะ คงที่
2) ความชื้นจำเพาะ (Specific Humidity) คือน้ำหนักหรือความชื้นที่มีอยู่ในอากาศ (Q) เป็น อัตราส่วนระหว่างน้ำหนักไอน้ำ (Mv) ต่อน้ำหนักของอากาศชื้น น้ำหนักของไอน้ำ (Mv) รวมกับน้ำหนัก ของอากาศ (Ma) มักใช้เป็นกรัมของน้ำต่อ 1 กิโลกรัมของอากาศชื้น ดังสมการ

Q = Mv/(Mv+Ma)
ความชื้นจำเพาะของอากาศจะมีค่าคงที่ เมื่ออากาศขยายตัวหรือหดตัว โดยที่ความชื้นจะไม่เปลี่ยนแปลง แม้ว่าปริมาตรของอากาศจะขยายตัวหรือหดตัวก็ตาม
3) ความชื้นสัมพัท ์ (Relative Humidity) คืออัตราส่วนระหว่างน้ำหนักของไอน้ำที่มีอยู่จริง ที่อุ หภูมิและความกดดันหนึ่งต่อน้ำหนักของไอน้ำอิ่มตัวที่อุ หภูมิและความกดดันนั้น คิดเป็นค่าร้อยละ ตัวอย่างเช่น อากาศ 1 ลูกบาศก์เมตร เมื่ออุ หภูมิ 30 องศาเซลเซียสมีไอน้ำอยู่ 9 กรัม และในอุ หภูมิ นั้นอากาศอิ่มตัวมีไอน้ำอยู่ 30 กรัม ความชื้นสัมพัท ์เท่ากับ (100*9)/30 เท่ากับ 30% ความชื้นสัมพัท ์ เป็นวิ ีวัดความชื้นในอากาศที่ใช้มากที่สุด การเปลี่ยนแปลงความชื้นสัมพัท ์จะไม่ทำให้ปริมา ไอน้ำที่มี อยู่ในอากาศเปลี่ยนแปลง แต่อ ุหภูมิจะเปลี่ยนแปลง และถ้าอุ หภูมิเปลี่ยนแปลงความชื้นสัมพัท ์จะ เปลี่ยนแปลงด้วย
4) อุ หภูมิจุดน้ำค้าง (Dew Point Temperature) คืออุ หภูมิซึ ่งอากาศถูกทำให้เย็นลง (ความกดอากาศคงที่) ถึงอุ หภูมิหนึ่งที่ที่ไอน้ำจุดอิ่มตัวพอดี อุ หภูมิของจุดน้ำค้างจะเป็นเท่าใดก็ได้ ขึ้นอยู่กับจำนวนไอน้ำที่มีอยู่จริงในอากาศ ถ้าอากาศมีไอน้ำมากอุ หภูมิของจุดน้ำค้างจะสูง แต่ถ้าไอน้ำมี น้อยอุ หภูมิของจุดน้ำค้างจะต่ำ ถ้าอุ หภูมิของอากาศลดต่ำกว่าจุดน้ำค้างจะมีการกลั่นตัวในรูปของ หยดน้ำ เช่น ในฤดูร้อนแก้วน้ำที่ใส่น้ำแข็งตั้งทิ้งไว้ความชื้นของอากาศจะรวมกันเป็นหยดน้ำเกาะอยู่รอบ นอกแก้วน้ำ เนื่องจากอุ หภูมิของแก้วน้ำที่ใส่น้ำแข็งจะต่ำกว่าอุ หภูมิจุดน้ำค้างที่อยู่โดยรอบ อุ หภูมิ ของจุดน้ำค้างจะบอกถึงความไม่สะดวกสบายของมนุษย์ในช่วงที ่มีอากาศอุ ่นและชื้นได้ดีกว่าความชื้น สัมพัท ์ ยกเว้นผู้ที่เคยชินกับอากาศร้อนชื้น คนส่วนให ่รู้สึกว่าอากาศชื้นไม่สะดวกสบายเมื่ออุ หภูมิจุด น้ำค้างสูงกว่า 17 องศาเซลเซียส ในขนะที่บางคนอาจไม่รู้สึกสบายตัว เมื่ออุ หภูมิจุดน้ำค้างสูงกว่า 20 องศาเซลเซียส

### 2.1.12.2 ความชื้นสัมพัทธ์ของประเทศไทยในแต่ละฤดู

ประเทศไทยตั้งอยู่ในเขตร้อนใกล้เส้นศูนย์สูตร จึงมีอากาศร้อนชื้นปกคลุมเกือบตลอดปี เว้น แต่บริเว ที่ลึกเข้าไปในแผ่นดิน ตั้งแต่ภาคกลางขึ้นไปความชื้นสัมพัท ์จะลดลงชันเจน ในช่วงฤดูหนาว และฤดูร้อน โดยเฉพาะฤดูร้อนจะเป็นช่วงที่มีความชื้นสัมพัท ์ลดลงต่ำที่สุดในรอบปี ในบริเว ดังกล่าวมี ความชื้นสัมพัท ์เฉลี่ยตลอดปีที่ 72-74 เปอร์เซ็นต์และจะลดลงเหลือ 62-69 เปอร์เซ็นต์ในช่วงฤดูร้อน ดัง แสดงข้อมูลตามตารางที่ 2.ป
ตารางที่ 2.2 สถิติความชื้นสัมพัท ์เฉลี่ย (%) ของประเทศไทยในช่วงฤดูกาลต่าง
ภาค | ฤดูหนาว | ฤดูร้อน | ฤดูฝน | ตลอดปี
เหนือ | 73 | 62 | 81 | 74
ตะวันออกเฉียงเหนือ | 69 | 65 | 80 | 72
กลาง | 71 | 69 | 79 | 73
ตะวันออก | 71 | 74 | 81 | 76
ใต้ฝังตะวันออก | 81 | 77 | 78 | 79
ใต้ฝังตะวันตก | 77 | 76 | 84 | 80

### 2.1.13 ตัวต้านทานตรวจสอบกระแส (Current Sense Resistors)

การตรวจสอบกระแสโดยการวัดแรงดันตกคร่อมตัวต้านทานเป็นวิ ีทำสามารถทำได้ง่าย แต่ ต้องพิจาร าปัจจัยต่าง ก่อนนำมาใช้งาน เช่น การเลือกค่าความต้านทาน ขนาดของตัวต้านทาน ความ ร้อน การวัดการไหลของกระแสมีพารามิเตอร์ที ่สำคั ที ่ต้องจัดการเพื ่อให้ระบบทำงานอย ่างมี ประสิท ิภาพ วิ ีที่ใช้กันทั่วไปในการตรวจสอบการไหลของกระแสทำได้โดยการนำตัวต้านทานที ่มีค่า ความต้านทานต่ำ ต่ออนุกรมกับโหลดแล้ววัดแรงดันตกคร่อมตัวต้านทานโดยใช้กฎของโอห์ม

V = IR
การใช้ตัวต้านทานในการตรวจสอบกระแสเป็นวิ ีพื้น านที่มีประสิท ิภาพ แต่ยังมีปั หาด้าน การออกแบบรายละเอียดปลีกย่อยอีกมากมายที่ต้องคำนึงถึง เช่น ตำแหน่งของตัวต้านทานตรวจสอบ กระแส ค่าความต้านทาน ขนาดของตัวต้านทาน และข้อพิจาร าเชิงกลอีกหลายประการ

### 2.1.13.1 ตำแหน่งการวางตัวต้านทานตรวจสอบกระแส

ตำแหน่งการวางตัวต้านทานตรวจสอบกระแสมีการวางอยู่ 2 แบบคือ การตรวจจับด้านต่ำ (Low-side Sensing) และ การตรวจับด้านสูง (High-side Sensing) ในการตรวจจับด้านต ่ำจะวางตัว ต้านทานตรวจสอบกระแสระหว่างโหลด (Load) และ กราวด์ (Ground) ดังรูปที่ 2.ป ซึ่งช่วยให้สามารถ ใช้วงจรขยายสั า วัดแรงดันตกคร่อมตัวต้านทานตรวบสอบกระแส (Current Sense Resistors) และ กราวด์ (Ground) ได้ง่าย


รูปที่ 2.37 แสดงภาพการวางตัวต้านทานตรวจสอบกระแสแบบการตรวจจับด้านต่ำ (Low-side Sensing)

แบบที่ 2 เป็นการตรวจจับด้านสูง (High-side Sensing) โดยการวงตัวต้านทานตรวจสอบ กระแส (Current Sense Resistors) ระหว่างแหล่งจ่าย (Power) และ โหลด (Load) ดังรูปที่ 2.ป การ ตรวจจับแบบนี้จะใช้วงจรขยายสั า แบบ differential amplifier หรือ instrumentation amplifier ในการวัดแรงดันตกคร่อมตัวต้านทานตรวจสอบกระแส (Current Sense Resistors)


รูปที่ 2.38 แสดงภาพการวางตัวต้านทานตรวจสอบกระแสแบบการตรวจจับด้านสูง (High-side Sensing)

### 2.1.13.2 การเลือกตัวต้านทานตรวจสอบกระแส

ในทางปฏิบัติโดยทั่วไปการเลือกตัวต้านทานตรวจสอบกระแส (Current Sense Resistors) เมื่อนำตัวต้านทานไปต่อกับโหลด (Load) แรงดันตกคร่อมตัวต้านทานตรวจสอบกระแส (Current Sense Resistors) ไม่ควรเกิน 100mV หรือต่ำกว่า เพื่อไม่ให้แบ่งแรงดันจากโหลดมากไป ค่าความต้านทานควรมี ค ่าประมา 10-mΩ หรือต ่ำกว ่าจากรูปที ่ 2.ป แสดงภาพตัวอย ่างของตัวต้านทานตรวจสอบกระแส (Current Sense Resistors) ที่มีค่าความต้านทาน 0.2-mΩ


รูปที่ 2.39 แสดงภาพตัวต้านทานตรวจสอบกระแสขนาด 0.2-mΩ

### 2.1.14 วงจรออปแอมป์ (Op-Amp Circuit)


รูปที่ 2.40 แสดงภาพวงจรออปแอมป์ (Op-Amp Circuit)

### 2.1.14.1 คุณสมบัติของออปแอมป์

ออปแอมป์ (Op-Amp) เป็นชื่อย่อสำหรับเรียกของวงจรขยายที่มาจากคำว่า Operational Amplifier เป็นวงจรขยายแบบต ่อตรง (Direct coupled amplifier) ที ่มีอัตราการขยายสูงมากใช้การ ป้อนกลับแบบลบไปควบคุมลักษ ะการทำงาน ทำให้ผลการทำงานของวงจรไม่ขึ้นกับพารามิเตอร์ภายใน ของออปแอมป์ วงจรภายในประกอบด้วยวงจรขยายที่ต่ออนุกรมกันคือวงจรขยายดิ เ อเรนเชียลด้าน

ทางเข้า วงจรขยายดิ เ อเรนเชียลภาคที ่สอง วงจรเลื ่อนระดับและวงจรขยายกำลังด้านทางออก สั ลักษ ์ที่ใช้แทนออปแอมป์จะเป็นรูปสามเหลี่ยม ไอซีออปแอมป์เป็นไอซีที่แตกต่างไปจากลิเนียร์ไอซี ทั่ว ไปคือไอซีออปแอมป์มีขาอินพุท 2 ขาเรียกว่าขาเข้าไม่กลับเ ส(Non-Inverting Input) หรือขา (+) และขาเข้ากลับเ ส (Inverting Input) หรือขา (-) ส่วน ทางด้านออกมีเพียงขาเดียว เมื่อสั า ป้อนเข้า ขาไม่กลับเ สสั า ทางด้านออกจะมีเ สตรงกับทางด้านเข้า แต่ถ้าป้อนสั า เข้าที่ขาเข้ากลับเ ส สั า ทางออกจะมีเ สต่างไป 180 องศา จากสั า ทางด้านเข้า


รูปที่ 2.41 แสดงแผนภาพบล็อกการทำงานของออปแอมป์

คุ ลักษ ะของ OP-AMP ในอุดมคติ(Ideal Op-Amp)
- อัตราขยายของ Op-Amp แบบวงจรรอบเปิด (Open Loop Gain) มีค่าสูงมากจนเป็น อนันต์AVOL = infinity
- Zin มีค่าสูงมากจนถือได้ว่าเป็น infinity
- Zout มีค่าต่ำมากจนถือได้ว่าเป็น 0
- อัตราขยายของ Op-Amp ไม่ขึ้นกับความถี่
- เมื่อ Vin = 0 จะได้Vout เป็น 0 ด้วย

### 2.1.14.2 วงจรขยายสัญญาณแบบกลับเฟส (Inverting Amplifier)

ในวงจรขยายออปแอมป์นั้นสามารถที่จะกำหนดอัตราการขยายของวงจรได้โดยการใช้วงจรเน กาที ีดแบ็ค (Negative Feedback) เมื่อเราป้อนสั า เข้าทางขากลับเ ส (ขา-)แรงดันด้านทางออก จะมีมุมเ สต ่างไปจากแรงดันทางเข้า 180 องศา ซึ ่งมีลักษ ะตรงข้าม สั า ตรงกันข้ามนี้จะถูก ป้อนกลับผ่าน Rf เข้ามายังขาอินเวอร์ติงอีกครั้งหนึ่ง ตรงจุดนี้จะทำให้สั า เกิดการหักล้างกันอัตรา การขยายก็จะลดลง ถ้าตัวต้านทานที่เป็นตัวป้อนกลับมีค่ามาก จะทำให้สั า ป้อนกลับมีขนาดเล็ก อัตราการขยายออกจึงสูง ถ้าตัวต้านทานที่ป้อนกลับมีค่าน้อยสั า ป้อนกลับไปได้มากอัตราการขยายก็ จะลดลง ฉะนั้นอัตราส่วนของความต้านทาน Rin และ Rf จะเป็นตัวกำหนดอัตราการขยายของวงจรโดย ไม่ขึ้นกับอัตราการขยายของออปแอมป์ซึ่งสามารถหาอัตราการขยายแรงดันได้จากสูตร

Gain=

Vout
Vin

= −

Rf
Rin

Vout = −

Rf
Rin

× Vin


รูปที่ 2.42 แสดงภาพของวงจรขยายสั า แบบกลับเ ส

### 2.1.14.3 วงจรขยายแบบไม่กลับเฟส (Non-inverting amplifier)

วงจรขยายนี้เป็นวงจรขยายอีกแบบหนึ่งที่ต้องการเ สในการขยายเป็นเ สเดียวกัน ดังนั้นการ ป้อนสั า อินพุทจึงต้องป้อนเข้าที ่ขาอินพุทไม่กลับเ ส (+) ซึ่งเมื่อขยายออกที่เอาท์พุทแล้วจะได้ สั า เอาท์พุทที่มีเ สเหมือนเดิม ดังนั้นในวงจรขยายแบบไม่กลับเ สนี้การป้อนกลับเพื่อลดอัตราการ ขยายจึงยังคง ต้องป้อนไปยังขาอินเวอร์ติง (-) เพื่อให้เกิดการหักล้างของสั า กันภายในตัวไอซีออป แอมป์ โดยสามารถหาอัตราการขยายของวงจรได้

Vout
Vin = A(v) = 1 +

RF
R2

Vout = (1 +

Rf
R2

)Vin


รูปที่ 2.43 แสดงภาพของวงจรขยายแบบไม่กลับเ ส

### 2.1.14.4 วงจรขยายสัญญาณแบบตามแรงดัน (Voltage Follower (Buffer)

วงจรขยายสั า แบบตามแรงดัน จะมีแรงดันทางด้านเอาท์พุตเท่ากับแรงดันทางด้าน อินพุต


รูปที่ 2.44 แสดงวงจรขยายสั า แบบตามแรงดัน

### 2.1.14.5 วงจรเปรียบเทียบแรงดัน (Comparator)

วงจรเปรียบเทียบแรงดันแสดงตามรูปที 2.ป เป็นวงจรแบบไม่เป็นเชิงเส้น ซึ่งจะให้เอาต์พุต อิ่มตัวออกมาที่ประมา 90% ของแหล่งจ่ายไ ทั้งด้านบวก และด้านลบ ขั้วของเอาต์พุตขึ้นอยู่กับ เครื่องหมายของผลต่างอินพุต vi − vREF


รูปที่ 2.45 แสดงวงจรเปรียบเทียบแรงดัน

### 2.1.15 เว็บแอปพลิเคชัน (Web Application)


รูปที่ 2.46 แสดงภาพตัวอย่างเว็บแอปพลิเคชัน

เว็บแอปพลิเคชัน (Web Application) คือเว็บที่นำเอา โปรแกรมประยุกต์ (Application) มา รวมไว้ในเว็บโดยการใช้ภาษาคอมพิวเตอร์เชิงโปรแกรมมิ่งเช่น PHP, NodeJS, Python, .NET, Java ฯลฯ เช่น การพัฒนาเว็บแอปพลิเคชันให้สามารถคำนว ได้เหมือนเครื่องคิดเลข
เว็บไชต์ (Website) — เป็นเว็บไซต์ที่ไว้นำเสนอข้อมูลความรู้ แต่ไม่สามารถคำนว หรือ ทำงานอย่างโปรแกรมคอมพิวเตอร์ได้
เว็บแอปพลิเคชัน (Web Application) — เป็นเว็บที่นำเอาโปรแกรมคอมพิวเตอร์มาใช้ใน เว็บซึ่งเชื่อมต่อ านข้อมูลเรียบร้อยแล้ว สามารถเปลี่ยนข้อมูลที่แสดงในเว็บได้อย่าง่ายดายโดยไม่ต้องแก้ไข HTML, CSS และ Javascript จะเห็นตัวอย่างได้ในเว็บต่าง เว็บขายของ ฯลฯ จุดเด่นของเว็บแอปพลิเคชัน (Web Application)
- Web Application เหมาะกับองค์กรขนาดเล็กเพราะมีค่าใช้จ่ายต่ำ และคิดค่าใช้จ่าย ตามจำนวนการใช้งานจริง
- การใช้งานในองค์กรทำได้ง ่าย เพียงแค ่มีเว็บบราวเซอร์ซึ ่งเป็นสิ ่งพื้น านใน คอมพิวเตอร์ปัจจุบันแทบทุกเครื่องก็ใช้งานได้

- ข้อมูลจัดเก็บที่เดียว ง่ายต่อการจัดการ และไม่เกิดความซ้ำซ้อน
- ไม่ต้องการเครื่องคอมพิวเตอร์ประสิท ิภาพสูงซึ่งมีราคาแพง
- อยู่ที่ไหนก็ทำงานได้เพราะสามารถล๊อกอินเข้าใช้งานได้เลยไม่ต้องติดตั้งโปรแกรม
- ไม่ต้องมีบุคคลากรด้านเทคนิคเป็นของตัวเอง เพราะผู้ให้บริการดูแลเซิ เวอร์และการ บำรุงรักษาเองทั้งหมด
- ส่วน มากใช้ได้หลากหลายแพลท อร์มทั้ง Windows, Linux และ Mac ทำให้องค์กร สามารถเลือกใช้บางเครื่องเป็น Linux ได้เพื่อลดค่าใช้จ่ายด้านลิขสิท ์
- เชื่อมต่อกับเว็บแอพหรือบริการออนไลน์อื่น ได้ง่าย

### 2.1.16 วินโดว์แอปพลิเคชัน (Windows Application)


รูปที่ 2.47 ตัวอย่างวินโดว์แอปพลิเคชัน

Windows Application ห รื อ WinAPP เป็นโป ร แก รมป ร ะเภ ท GUI (Graphic User Interface) เรียกง่าย ก็คือ โปรแกรมประเภทนี้เป็นโปรแกรมที่จะติดต่อหรือตอบสนองกับผู้ใช้ (User) ผ ่านทางระบบภาพ Graphic เพื ่อให้มีการใช้งานที ่ง ่ายและเข้าใจได้ง ่ายยิ ่งขึ้นนั ่นเอง ในสมัยก ่อนนั้น

โปรแกรมประเภทนี้ จะต้องผ่านการเขียนโปรแกรมขึ้นมาด้วยข้อความหรือ Text จากโปรแกรมอย่างเช่น Notepad หรือ Editplus แต่หากเป็นในปัจจุบัน มีโปรแกรมที่สามารถใช้วิ ีคลิ๊กวาง ลากวางให้สามารถ จัดการสร้างสรรค์โปรแกรมได้ง่ายยิ่งขึ้น แต่ถึงอย่างไรก็ควรที่จะมีการศึกษาในเรื่องของหลักการพัฒนา โปรแกรมไว้บ้าง เพื่อความสะดวกในการแก้ไขและจัดการโปรแกรมในภายหลัง

### 2.1.17 ซอฟต์แวร์ที่เกี่ยวข้อง

### 2.1.17.1 ภาษา C++


รูปที่ 2.48 ภาษา C++

C++ เป็นภาษาคอมพิวเตอร์เพื่อวัตถุประสงค์ทั่วไป ซึ่งสามารถเขียนโปรแกรมได้ทั้งแบบออบ เจ็ค และการเขียนแบบปกติทั่วไป และยังมีเครื่องมืออำนวยความสะดวกในการจัดการและเข้าถึงระดับ หน ่วยความจำนอกจากนี้มันยังถูกนำไปใช้ในการเขียนโปรแกรมแบบต ่าง มากมาย เช ่น โปรแกรม คอมพิวเตอร์ ระบบฝังตัว (Embedded) ไมโครคอนโทรลเลอร์ เว็บเซิร์ เวอร์ การพัฒนาเกม และแอพ พลิเคชันที่ต้องการประสิท ิภาพอย่างสูง
ภาษา C++ เป็นภาษาที่ถูกออกแบบมาในการเขียนโปรแกรมระบบ ซึ่งมีประสิท ิภาพและ ความยืดหยุ่นในการออกแบบโปรแกรมสูง C++ เป็นภาษาที่ต้องคอมไพล์ก่อนที่จะนำไปใช้งาน ซึ่งสามารถ

พัฒนาได้ในหลาย แพลต อร์ม ซึ ่งได้รับการสนับสนุนโดยองค์กรต ่าง ที ่ประกอบไปด้วย Free Software Foundation (FSF's GCC) LLVM Microsoft Intel และ IBM
C++ นั้นถูกกำหนดให้เป็นภาษาที ่เป็นมาตร านโดย International Organization for Standardization (ISO) ซึ่งเวอร์ชันล่าสุดนั้นเผยแพร่ใน ันวาคม 2014 คือ ISO/IEC 14882:2014 หรือที่ รู้จักกันในชื่อของ C++14 โดยที่ภาษา C++ ได้เริ่มกำหนดมาตรา านครั้งแรกในปี 1998 คือ ISO/IEC 14882:1998 ภาษา C++ ถูกพัฒนาโดย Bjarne Stroustrup ที่ Bell Labs ตั้งแต่ปี 1979 ซึ่งในตอนแรก เป็นส่วนขยายของภาษา C โดยที่เขาต้องการที่จะพัฒนาภาษาที่มีประสิท ิภาพและยืดหยุ่นเหมือนกับ ภาษา C และยังมีคุ สมบัติใหม่ที่สูงกว่าสำหรับพัฒนาโปรแกรม
Bjarne Stroustrup นักวิทยาศาสตร์คอมพิวเตอร์ชาวเดนมาร์ก ได้สร้างภาษา C++ ขึ้นในปี 1979 โดยเขาเริ่มจาก "C with Classes" ซึ่งเป็นภาษาก่อนหน้าของภาษา C++ แรงจูงใจสำหรับการสร้าง ภาษาใหม่นั้นมีต้นกำเนิดมาจากประสบการ ์ในการเขียนโปรแกรมสำหรับงานวิจัยในการศึกษาระดับ ปริ าเอกของเขา ในข ะที ่ Stroustrup เริ ่มต้นการทำงานที ่ AT&T Bell Labs เขามีปั หาในการ วิเคราะห์ UNIX kernel ซึ่งเกี่ยวกับ distributed computing จากการจดจำในประสบการ ์ปริ าเอก ของเขา Stroustrup ตั้งใจว่าจะเพิ่มความสามารถให้ภาษา C กับคุ สมบัติที่เหมือนภาษา Simula เขา เลือกภาษา C เพราะว่ามันเป็นภาษาเขียนโปรแกรมเพื่อวัตถุประสงค์ทั่วไป ที่ทำงานเร็ว สะดวกใช้งานง่าย และใช้กันอย ่างแพร ่หลาย จนกระทั ่งในปี 2011 มาต านของ C++11 ได้ถูกเผยแพร ่ โดยการเพิ่ม คุ สมบัติใหม่เข้ามามากมาย รวมทั้งการเพิ่มเติมขนาดของไลบรารี่มาตร าน และให้ความสะดวกแก่ โปรแกรมเมอร์ภาษา C++ เป็นอย่างมาก คอมไพเลอร์คือโปรแกรมคอมพิวเตอร์หรือกลุ่มของโปรแกรมที่แปลงซอสโค้ดที่เขียนขึ้นใน ภาษา C++ ไปเป็นภาษาคอมพิวเตอร์ (Target language) หลังจากที ่ทำการแปลงแล้วจะได้ข้อมูลใน รูปแบบของ านสอง (Binary) ที่เรียกกันว่า Object code เหตุผลที่ต้องแปลงโปรแกรมจากภาษาเขียน โปรแกรมไปเป็นภาษาเครื ่องโดยคอมไพเลอร์ก็เพื ่อสร้างโปรแกรมที ่สามารทำงานได้ (Executable program) คอมพิวเตอร์สามารถเข้าใจแค ่ภาษาเครื ่อง ภาษาที ่ประกอบไปด้วยตัวเลข 1 และ 0 เรา จำเป็นต้องใช้คอมไพเลอร์เพื่อแปลงโปรแกรมที่เราเขียนไปเป็นภาษาเครื่องที ่ให้คอมพิวเตอร์สามารถ ทำงานได้คอมไพเลอร์ช ่วยให้โปรแกรมเมอร์พัฒนาโปรแกรมของพวกเขาได้อย ่างง ่ายดายในการเขียน โปรแกรมด้วยภาษาระดับสูง อย่างเช่น ภาษา C++

### 2.1.17.2 ภาษา Visual Basic.NET


รูปที่ 2.49 ภาษา Visual Basic.NET

Visual Basic .NET (VB.NET) เป็นภาษารุ่นที่สามในการเขียนโปรแกรมแบบ event-driven programming (การเขียนโปรแกรมที่ขึ้นกับเหตุการ ์) ซึ่งมาพร้อมกับเครื่องมือพัฒนาจาก Microsoft เปิดตัวครั้งแรกในปี 1991 และได้รับการพัฒนาให้ดีมากขึ้นจนถึงปี 2008 โดย ภาษา Visual Basic นั้นถูก ออกแบบมาเพื่อให้ง่ายต่อการเรียนรู้และง่ายต่อการใช้งาน ภาษา Visual Basic นั้นถูกพัฒนามาจากภาษา Basic ภาษาเขียนโปรแกรมที่เข้าใจง่ายสำหรับผู้เริ่มต้น
ภาษา Visual Basic สนับสนุนการพัฒนาโปรแกรมแบบ rapid application development (RAD) และ graphical user interface (GUI) การเข้าถึง านข้อมูล และอื ่น ที ่ทำงานภายใต้ .NET Framework เวอร์ชันล่าสุดของ Visual Basic นั้นสนับสนุนการเขียนโปรแกรมเชิงวัตถุอย่างเต็มรูปแบบ และยังถูกออกแบบมาเพื ่อช ่วยให้ผู้เรียนสามารถเรียนรู้ได้อย ่างรวดเร็ว โปรแกรมเมอร์สามารถสร้าง โปรแกรม GUI อย่างง่ายไปจนถึงซับซ้อน การเขียนโปรแกรมใน VB นั้นสามารถออกแบบได้โดยการลาก และวางส่วนประกอบต่าง ของตัวควบคุมหรือ อร์ม การระบุแอตทริบิวต์เพิ่มเติมสำหรับส่วนประกอบ เหล ่านั้น และเขียนโค้ดเพิ ่มเติมสำหรับการทำงาน เพราะว ่า VB ได้มีการกำหนดค ่าแอตทริบิวต์และ ังก์ชันพื้น านในการทำงานของโค้ด โปรแกรมเมอร์จึงไม่จำเป็นที่จะเขียนโค้ดเป็นจำนวนมากในการ พัฒนาโปรแกรม ข้างล่างนี้เป็นตัวอย่างของหน้าออกแบบ อร์มที่ว่างปล่าวใน Visual Studio 2019 ใน ภาษา Visual Basic


รูปที่ 2.50 ตัวอย่างของหน้าออกแบบ อร์มที่ว่างปล่าวใน Visual Studio 2019

VB 1.0 นั้นถูกแนะนำครั้งแรกในปี 1991 การออกแบบหน้าตาโดยการลากและวางนั้นได้รับ การสืบทอดมาจากตัวสร้าง Prototype ที ่พัฒนาโดย Alan Cooper และบริษัทของเขาชื ่อว ่า Tripod หละงจากนั้น Microsoft ได้ทำการติดต่อกับ Cooper เพื่อพัฒนา Tripod สำหรับระบบ อร์มที่สามารถ เขียนโปรแกรมได้ ภายใต้โค้ดที ่มีชื ่อว ่า Ruby (ซึ ่งไม ่มีความสัมพัน ์กับภาษา Ruby ในปัจจุบัน) ซึ่ง Tripod ไม่ได้รวมเกี่ยวกับภาษาเขียนโปรแกรมทั้งหมด Microsoft จึงตัดสินใจที่จะรวม Ruby กับ Basic เพื ่อสร้างภาษา Visual Basic โดย Interfaces ของ Ruby เป็นตัวสร้างส ่วนที ่มองเห็นได้ด้วยสายตา (Visual) ของ Visual Basic และได้นำไปรวมกับ "EB" Embedded BASIC engine ที ่ออกแบบโดย Microsoft Ruby ยังให้ความสามารถในการเชื่อมโยงกับการโหลดไลบรารี่แบบไดนามิกส์ ที่สนับสนุน การควมคุมเพื่มเติมที่ภายหลังกลายมาเป็น VBX interface

### 2.1.17.3 ภาษา PHP


รูปที่ 2.51 แสดงสั ลักษ ์ของภาษา PHP

PHP (พีเอชพี) ย่อมาจากคำว่า PHP Hypertext Preprocessor ภาษา PHP เป็นโปรแกรม ภาษาคอมพิวเตอร์ระดับสูง ที่สามารถใช้งานในระบบเครือข่ายอินเทอร์เน็ตได้ มีความสามารถสูง และมีผู้ นิยมใช้เป็นจำนวนมาก อีกทั้งยังสามารถดาวน์โหลดมาใช้ได้ รี จากเว็บไซต์ http://php.net/
PHP เป็นภาษาสคริปต์ ( Scripting Language ) คำสั ่งต ่าง จะเก็บในรูปของข้อความ (Text) สามารถใช้งานอิสระหรืออาจเขียนแทรกอยู่ในภาษา HTML ก็ได้ แต่ในการใช้งานจริงมักใช้งาน ร่วมกับภาษา HTML ดังนั้นการเขียนโปรแกรมนี้ต้องมีความรู้ด้านภาษา HTML เป็นอย่างดี อย่างไรก็ตาม เราสามารถใช้โปรแกรมประยุกต์มาช่วยอำนวยความสะดวกในการสร้างงานได้ เช ่น Macromedia Dreamweaver หรือโปรแกรมประเภท Editor เช่น EditPlus ฯลฯ โปรแกรมเหล่านี้จะช่วยจำแนกคำ เช่น คำสั่ง คำทั่วไป ตัวแปร ฯลฯ ให้มีสีต่างกันเพื่อสะดวกในการสังเกต และมีตัวเลขบอกบรรทัดทำให้ สะดวกในการแก้ไข
PHP คือ ภาษาคอมพิวเตอร์ Server-Side Script ซึ ่งใช้ในการจัดทำเว็บไซต์และสามารถ ประมวลผลออกมาในรูปแบบ HTML โดยมีราก านโครงสร้างคำสั่งมาจากภาษา ภาษาซี ภาษาจาวา และ ภาษาเพิร์ล เป้าหมายหลักของภาษาPHP คือให้นักพัฒนาเว็บไซต์สามารถเขียนเว็บเพจ ที่มีความตอบโต้ ได้อย่างรวดเร็ว
ผู้ให้กำเนิด PHP มีชื่อว่า รัสมัส เลอร์ดอร์ (Rasmus Lerdorf) โดยเริ่มต้นเขียนสคริปต์ Perl CGI ใส ่ไว้ในโฮมเพจประวัติส ่วนตัว และเห็นว ่าการเขียน CGI ด้วย Perl มีความยุ ่งยาก จึงได้เขียน โปรแกรมขึ้นใหม่ด้วยภาษา C ที่สามารถแยกส่วนที่เป็นภาษาHTML ออกจากส่วนที่เป็นภาษา C เพื่อแยก ประมวลผล แล้วทำการสร้างโค้ด HTML ขึ้นใหม่ โดยตั้งชื่อโปรแกรมนี้ว่า Personal Home Page Tools (PHP-Tools) และได้เริ ่มแจกจ ่ายโค้ดออกไปในลักษ ะ รีแวร์ ต ่อมาจึงได้เริ ่มเปิดให้ผู้สนใจเข้าร่วม ปรับปรุงและพัฒนา จนกลายป็นภาษา PHP ในปัจจุบัน

### 2.1.17.4 ภาษา JavaScript


รูปที่ 2.52 แสดงสั ลักษ ์ของ JavaScript

JavaScript คือ ภาษาคอมพิวเตอร์สำหรับการเขียนโปรแกรมบนระบบอินเทอร์เน็ต ที่กำลัง ได้รับความนิยมอย่างสูง Java JavaScript เป็น ภาษาสคริปต์เชิงวัตถุ (ที่เรียกกันว่า "สคริปต์" (script) ซึ่ง ในการสร้างและพัฒนาเว็บไซต์ (ใช่ร่วมกับ HTML) เพื่อให้เว็บไซต์ของเราดูมีการเคลื่อนไหว สามารถ ตอบสนองผู้ใช้งานได้มากขึ้น ซึ ่งมีวิ ีการทำงานในลักษ ะ "แปลความและดำเนินงานไปทีละคำสั ่ง" (interpret) หรือเรียกว่า อ็อบเจ็กโอเรียลเต็ด (Object Oriented Programming) ที่มีเป้าหมายในการ ออกแบบและพัฒนาโปรแกรมในระบบอินเทอร์เน็ต สำหรับผู้เขียนด้วยภาษา HTML สามารถทำงานข้าม แพลต อร์มได้ โดยทำงานร่วมกับ ภาษา HTML และภาษา Java ได้ทั้งทางฝั่งไคลเอนต์ (Client) และ ทางฝั่งเซิร์ เวอร์ (Server)
JavaScript ถูกพัฒนาขึ้นโดย เน็ตสเคปคอมมิวนิเคชันส์ (Netscape Communications Corporation) โดยใช้ชื่อว่า Live Script ออกมาพร้อมกับ Netscape Navigator2.0 เพื่อใช้สร้างเว็บเพจ โดยติดต่อกับเซิร์ เวอร์แบบ Live Wire ต่อมาเน็ตสเคปจึงได้ร่วมมือกับ บริษัทซันไมโครซิสเต็มส์ปรับปรุง ระบบของบราวเซอร์เพื่อให้สามารถติดต่อใช้งานกับภาษาจาวาได้ และได้ปรับปรุง LiveScript ใหม่เมื่อ ปี 2538 แล้วตั้งชื ่อใหม ่ว ่า JavaScript JavaScript สามารถทำให้ การสร้างเว็บเพจ มีลูกเล ่น ต ่าง มากมาย และยังสามารถโต้ตอบกับผู้ใช้ได้อย่างทันที เช่น การใช้เมาส์คลิก หรือ การกรอกข้อความใน อร์ม เป็นต้น

เนื่องจาก JavaScript ช่วยให้ผู้พัฒนา สามารถสร้างเว็บเพจได้ตรงกับความต้องการ และมี ความน่าสนใจมากขึ้น ประกอบกับเป็นภาษาเปิด ที่ใครก็สามารถนำไปใช้ได้ ดังนั้นจึงได้รับความนิยมเป็น อย่างสูง มีการใช้งานอย่างกว้างขวาง รวมทั้งได้ถูกกำหนดให้เป็นมาตร านโดย ECMA การทำงานของ JavaScript จะต้องมีการแปลความคำสั่ง ซึ่งขั้นตอนนี้จะถูกจัดการโดยบราวเซอร์ (เรียกว่าเป็น client-side script) ดังนั้น JavaScript จึงสามารถทำงานได้ เฉพาะบนบราวเซอร์ที ่สนับสนุน ซึ ่งปัจจุบัน บราวเซอร์เกือบทั้งหมดก็สนับสนุน JavaScript แล้ว อย ่างไรก็ดี สิ ่งที ่ต้องระวังคือ JavaScript มีการ พัฒนาเป็นเวอร์ชั่นใหม่ ออกมาด้วยดังนั้น ถ้านำโค้ดของเวอร์ชั่นใหม่ ไปรันบนบราวเซอร์รุ่นเก่าที่ยังไม่ สนับสนุน ก็อาจจะทำให้เกิด error ได้
การทำงานของ JavaScript เกิดขึ้นบนบราวเซอร์ (เรียกว่าเป็น client-side script) ดังนั้นไม่ ว่าคุ จะใช้เซิร์ เวอร์อะไร หรือที่ไหน ก็ยังคงสามารถใช้ JavaScript ในเว็บเพจได้ ต่างกับภาษาสคริปต์ อื่น เช่น Perl, PHP หรือ ASP ซึ่งต้องแปลความและทำงานที่ตัวเครื่องเซิร์ เวอร์ (เรียกว่า server-side script) ดังนั้นจึงต้องใช้บนเซิร์ เวอร์ ที่สนับสนุนภาษาเหล่านี้เท่านั้น อย่างไรก็ดี จากลักษ ะดังกล่าวก็ ทำให้ JavaScript มีข้อจำกัด คือไม่สามารถรับและส่งข้อมูลต่าง กับเซิร์ เวอร์โดยตรง เช่น การอ่านไ ล์ จากเซิร์ เวอร์ เพื่อนำมาแสดงบนเว็บเพจ หรือรับข้อมูลจากผู้ชม เพื่อนำไปเก็บบนเซิร์ เวอร์ เป็นต้น ดังนั้นงานลักษ ะนี้ จึงยังคงต้องอาศัยภาษา server-side script อยู่ (ความจริง JavaScript ที่ทำงานบน เซิร์ เวอร์เวอร์ก็มี ซึ่งต้องอาศัยเซิร์ เวอร์ที่สนับสนุนโดยเฉพาะเช่นกัน แต่ไม่เป็นที่นิยมนัก)

### 2.1.17.4.1 Ajax (Asynchronous JavaScript and XML)


รูปที่ 2.53 แสดงสั ลักษ ์ของ Ajax

Ajax (ย่อมาจาก Asynchronous JavaScript and XML) เป็นเทคนิคการเขียนโปรแกรมแบบนึง ไม่ใช่ ภาษาโปรแกรมใหม ่อย ่างที ่บางคนเข้าใจจากชื ่อเต็มของ Ajax จะสังเกตว ่ามีคีย์เวิร์ด 2 ตัวคือ (Asynchronous) JavaScript และ XML ก็คือ การใช้ JavaScript แบบ Asynchronous (แบบคำสั่งไม่ เป็นลำดับขั้นหรือไม่ sync. กัน) และใช้ XML โดยมีหลักการท างาน 2 ประเด็น คือ การ update หน้าจอ แบบบางส่วน และการติดต่อสื่อสารกับ Server โดยใช้หลักการ Asynchronous ท าให้ผู้ใช้ไม่ต้องหยุด การท างาน เพื่อรอการประมวลผลจาก Server รวมถึงการโหลดและการรีเ รชหน้าจอ ของบราวเซอร์ ทางฝั่ง Client มีการใช้ Ajax โดยการเพิ่มเลเยอร์ระหว่าง user browser กับ server ท าให้ผู้ใช้สามารถ ท างานได้โดยไม่ต้องรอให้ Client ติดต่อไปยัง Server รวมถึงการโหลดและการรีเ รชหน้าจอทั้งหมดด้วย ดังนั้นผู้ใช้สามารถใช้งาน application ได้อย่างมีประสิท ิภาพมากขึ้น

### 2.1.17.5 ภาษา HTML (Hyper Text Markup Language)


รูปที่ 2.54 แสดงสั ลักษ ์ของภาษา HTML

HTML ย ่อมาจาก Hyper Text Markup Language คือภาษาคอมพิวเตอร์ที ่ใช้ในการ แสดงผลของเอกสารบน website หรือที่เราเรียกกันว่าเว็บเพจ ถูกพัฒนาและกำหนดมาตร านโดยองค์กร World Wide Web Consortium (W3C) และจากการพัฒนาทางด้าน Software ของ Microsoft ทำให้ ภาษา HTML เป็นอีกภาษาหนึ่งที่ใช้เขียนโปรแกรมได้ หรือที่เรียกว่า HTML Application
HTML เป็นภาษาประเภท Markup สำหรับการการสร้างเว็บเพจ โดยใช้ภาษา HTML สามารถทำโดยใช้โปรแกรม Text Editor ต่าง เช่น Notepad, Editplus หรือจะอาศัยโปรแกรมที ่เป็น

เครื่องมือช่วยสร้างเว็บเพจ เช่น Microsoft FrontPage, Dream Weaver ซึ่งอ านวยความสะดวกในการ สร้างหน้า HTML ส่วนการเรียกใช้งานหรือทดสอบการทำงานของเอกสาร HTML จะใช้โปรแกรม web browser เช ่น Microsoft Internet Explorer (IE), Mozilla Firefox, Safari, Opera, และ Netscape Navigator Google Chrome เป็นต้น

### 2.1.17.6 ภาษา CSS (Cascading Style Sheet)

รูปที่ 2.55 แสดงแสดงสั ลักษ ์ของภาษา CSS

CSS ย่อมาจาก Cascading Style Sheet มักเรียกโดยย่อว่า "สไตล์ชีต" คือภาษาที่ใช้เป็น ส ่วนของการจัดรูปแบบการแสดงผลเอกสาร HTML โดยที ่ CSS กำหนดกฏเก ฑ์ในการระบุรูปแบบ (หรือ "Style") ของเนื้อหาในเอกสาร อันได้แก่ สีของข้อความ สีพื้นหลัง ประเภทตัวอักษร และการจัดวาง ข้อความ ซึ่งการกำหนดรูปแบบ หรือ Style นี้ใช้หลักการของการแยกเนื้อหาเอกสาร HTML ออกจาก คำสั่งที่ใช้ในการจัดรูปแบบการแสดงผล กำหนดให้รูปแบบของการแสดงผลเอกสาร ไม่ขึ้นอยู่กับเนื้อหา ของเอกสาร เพื่อให้ง่ายต่อการจัดรูปแบบการแสดงผลลัพ ์ของเอกสาร HTML โดยเฉพาะในกร ีที่มีการ เปลี ่ยนแปลงเนื้อหาเอกสารบ ่อยครั้ง หรือต้องการควบคุมให้รูปแบบการแสดงผลเอกสาร HTML มี ลักษ ะของความสม่ำเสมอทั่วกันทุกหน้าเอกสารภายในเว็บไซต์เดียวกัน โดยกฏเก ฑ์ในการกำหนด รูปแบบ (Style) เอกสาร HTML ถูกเพิ่มเข้ามาครั้งแรกใน HTML 4.0 เมื่อปีพ.ศ. 2539 ในรูปแบบของ CSS level 1 Recommendations ที่กำหนดโดย องค์กร World Wide Web Consortium หรือ W3C ประโยชน์ของ CSS มีดังต่อไปนี้

- CSS มีคุ สมบัติมากกว่า tag ของ html เช่น การกำหนดกรอบให้ข้อความ รวมทั้ง สี รูปแบบของข้อความที่กล่าวมาแล้ว
- CSS นั้นกำหนดที่ต้นของไ ล์ html หรือตำแหน่งอื่น ก็ได้ และสามารถมีผล กับ เอกสารทั้งหมด หมายถึงกำหนด ครั้งเดียวจุดเดียวก็มีผลกับการแสดงผลทั้งหมด ทำ ให้เวลาแก้ไขหรือปรับปรุงทำได้สะดวก ไม่ต้องไล่ตามแก้ tag ต่าง ทั่วทั้งเอกสาร
- CSS สามารถกำหนดแยกไว้ต่างหากจาก ไ ล์เอกสาร html และสามารถนำมาใช้ ร่วม กับเอกสารหลายไ ล์ได้ การแก้ไขก็แก้เพียง จุดเดียวก็มีผลกับเอกสารทั้งหมด CSS กับ HTML / XHTML นั้นทำหน้าที ่คนละอย ่างกัน โดย HTML / XHTML จะทำหน้าที ่ในการวาง โครงร่างเอกสารอย่างเป็นรูปแบบ ถูกต้อง เข้าใจง่าย ไม่เกี่ยวข้องกับการแสดงผล ส่วน CSS จะทำหน้าที่ ในการตกแต่งเอกสารให้สวยงาม เรียกได้ว่า HTML /XHTML คือส่วน coding ส่วน CSS คือส่วน design

### 2.1.17.7 โปรแกรม Ngrok


รูปที่ 2.56 แสดงสั ลักษ ์ของโปรแกรม Ngrok

Ngrok เป็น Tool Open Source พัฒนาโดย GitHub ซึ ่งอำนวยความสะดวกให้บุคคลอื่น สามารถเข้าใช้งาน Website หรือ Application ที่กำลังทำงานอยู่บนเครื่อง Localhost นั่นเอง อีกทั้ง Ngrok ยังมีหลากหลายช ่องสั า ที่มีความปลอดภัยในการรับและส่งข้อมูลจากเครื่องผู้ใช้ไปจนถึง เครื่อง Localhost

โดยบุคคลอื ่นสามารถเข้าใช้งาน Website หรือ Application กำลังทำงานอยู ่บนเครื ่อง Localhost ผ่านทาง URL ของทาง Ngrok โดยที่ทาง Ngrok จะทำการสุ่มสร้าง URL ขึ้นมา และ URL ที่ ได้มานั้น จะทำการเปลี่ยนไปทุกครั้งเมื่อมีการปิดหรือเปิดใช้งาน Ngrok
อีกทั้ง Ngrok ยังมีเว็บอินเตอร์เ ส ซึ ่งสามารถใช้ตรวจสอบหรือ Monitor ผ ่านทาง URL http://127.0.0.1:4040 ซึ่งสามารถใช้ตรวจสอบการรับส่งข้อมูล Http ทั้งหมด ไม่ว่าจะเป็นการรับส่ง ข้อมูลแบบ Get หรือแบบ Post, การขอ Request การส่ง Response, Traffic รวมถึง Webhook ที่เข้า มาใช้งานบนเครื่อง Localhost
ระบบปฏิบัติการ (Operating System) ที่ Ngrok รองรับมีดังต่อไปนี้
- Mac OS X
- Linux
- Mac (32-bit)
- Windows (32-bit)
- Linux (ARM)
- Linux (ARM64)
- Linux (32-bit)
- FreeBSD (64-bit)
- FreeBSD (32-bit)

### 2.1.17.8 ระบบฐานข้อมูล (Database)

รูปที่ 2.57 แสดงสั ลักษ ์ของระบบ านข้อมูล

Database หรือ านข้อมูล คือ กลุ่มของข้อมูลที่ถูกเก็บรวบรวมไว้ โดยมีความสัมพัน ์ซึ่งกัน และกัน โดยไม ่ได้บังคับว ่าข้อมูลทั้งหมดนี้จะต้องเก็บไว้ในแ ้มข้อมูลเดียวกันหรือแยกเก็บหลาย แ ้มข้อมูล
ระบบ านข้อมูล (Database System) คือ ระบบที่รวบรวมข้อมูลต่าง ที่เกี่ยวข้องกันเข้าไว้ ด้วยกันอย่างมีระบบมีความสัมพัน ์ระหว่างข้อมูลต่าง ที่ชัดเจน ในระบบ านข้อมูลจะประกอบด้วย แ ้มข้อมูลหลายแ ้มที่มีข้อมูล เกี่ยวข้องสัมพัน ์กันเข้าไว้ด้วยกันอย่างเป็นระบบและเปิดโอกาสให้ผู้ใช้ สามารถใช้งานและดูแลรักษาป้องกันข้อมูลเหล่านี้ ได้อย่างมีประสิท ิภาพ โดยมีซอ ต์แวร์ที่เปรียบเสมือน สื่อกลางระหว่างผู้ใช้และโปรแกรมต่าง ที่เกี่ยวข้องกับการใช้ านข้อมูล เรียกว่า ระบบจัดการ านข้อมูล หรือ DBMS (data base management system)มีหน้าที่ช่วยให้ผู้ใช้เข้าถึงข้อมูลได้ง ่ายสะดวกและมี ประสิท ิภาพ การเข้าถึงข้อมูลของผู้ใช้อาจเป็นการสร้าง านข้อมูล การแก้ไข านข้อมูล หรือการตั้ง คำถามเพื่อให้ได้ข้อมูลมา โดยผู้ใช้ไม่จำเป็นต้องรับรู้เกี่ยวกับรายละเอียดภายในโครงสร้างของ านข้อมูล ประโยชน์ของ านข้อมูล มีดังต่อไปนี้
- ลดการเก็บข้อมูลที่ซ้ำซ้อน ข้อมูลบางชุดที่อยู่ในรูปของแ ้มข้อมูลอาจมีปรากฏอยู่ หลาย แห่ง เพราะมีผู้ใช้ข้อมูลชุดนี้หลายคน เมื่อใช้ระบบ านข้อมูลแล้วจะช่วยให้ ความซ้ำซ้อนของข้อมูลลดน้อยลง
- รักษาความถูกต้องของข้อมูล เนื่องจาก านข้อมูลมีเพียง านข้อมูลเดียว ในกร ีที่มี ข้อมูลชุดเดียวกันปรากฏอยู่หลายแห่งใน านข้อมูล ข้อมูลเหล่านี้จะต้องตรงกัน ถ้ามี การแก้ไขข้อมูลนี้ทุก แห่งที่ข้อมูลปรากฏอยู่จะแก้ไขให้ถูกต้องตามกันหมดโดย อัตโนมัติด้วยระบบจัดการ านข้อมูล
- การป้องกันและรักษาความปลอดภัยให้กับข้อมูลทำได้อย่างสะดวก การป้องกันและ รักษาความปลอดภัยกับข้อมูลระบบ านข้อมูลจะให้เฉพาะผู้ที่เกี่ยวข้องเท่านั้นซึ่ง ก่อให้เกิดความปลอดภัย(security) ของข้อมูลด้วย

### 2.2 งานวิจัยที่เกี่ยวข้อง

### 2.2.1 ไอโอทีแพลทฟอร์มโรงเพาะเห็ด

ขันติชัย, ชยุต (2560) ได้ศึกษา ออกแบบ และสร้างไอโอทีแพลท อร์มสำหรับใช้ในโรงเพาะ เห็ด โดยการใช้ Raspberry Pi 3 Model B ซึ่งเป็น Microcontroller มาใช้วัดค่าอุ หภูมิและ ความชื้น จากเซนเซอร์ภายในโรงเรือน จากนั้นจึงส่งข้อมูลอุ หภูมิและความชื้นที่วัดได้ไปยัง Platform และเก็บ ข้อมูลอุ หภูมิและความชื้นลงบน านข้อมูลโดยใช้MySQL เป็นทั้ง านข้อมูล และตัวจัดการ านข้อมูล นอกจากนั้นยังมีระบบ Web Application เพื่อใช้แสดงผลค ่าอุ หภูมิและ ความชื้นที ่ถูกส ่งมาจาก Raspberry Pi หรือประวัติของค ่าอุ หภูมิและความชื้นที ่เก็บไว้ใน านข้อมูล โดย Protocol ที่เป็น ตัวกลางในการรับส ่งข้อมูลระหว่าง Raspberry Pi, Platform และ Web Application คือ MQTT Protocol และใช้ร่วมกับ NodeJS ซึ่งเป็น Service หลักที่ใช้ภายใน Platform

### 2.2.2 IOT for Smart Farm: A case study of the Lingzhi Mushroom Farm at Maejo

University
Oran, Anukit (2560) ได้นำเทคโนโลยีไอโอทีมาใช้ในการเพาะเห็ดหลินจือ โดยวัดค่า ความชื้นในโรงเพาะเห็ดหลินจือ และแสดงผลบนโทรศัพท์และคอมพิวเตอร์ผ่าน NETPIE การควบคุมการ ทำงานของสปริงเกอร์และปั๊มหมอกเป็นแบบอัตโนมัติและแจ้งเตือนสถานะการทำงานของสปริงเกอร์และ ปั๊มหมอกผ่าน แอปพลิเคชัน LINE

### 2.2.3 การประยุกต์ใช้เทคโนโลยีไอโอทีควบคุมฟาร์มอัจฉริยะในโรงเรือนเพาะเห็ดนางฟ้า

วีรศักดิ , สุรพงษ์ม, รั สิท ิ (2561) ได้ออกแบบระบบควบคุมอุ หภูมิและความชื้นสำหรับ โรงเรือนเพาะเห็ดด้วย ไมโครคอนโทรลเลอร์โดยมีการศึกษาค้นคว้าข้อมูลที่เกี่ยวข้องต่อการเพาะเห็ด ตลอดจนการออกแบบโครงสร้างโรงเรือนที่เหมาะสมโดยแบ่งการทดสอบออก 2 ส่วนคือการทดสอบใน ส ่วนของระบบควบคุมและการทดสอบผลผลิต ของดอกเห็ดในโรงเรือนที ่มีการควบคุมอุ หภูมิและ ความชื้นโดยนำก้อนเห็ดนางรมและเห็ดนาง ้ามาทดสอบจำนวน 300 ก้อนและเปรียบเทียบประสิท ิภาพ โรงเรือนเพาะเห็ดที่มีการควบคุมอุ หภูมิและความชื้นที่สร้างขึ้นกับโรงเรือน โดยประยุกต์ใช้ระบบไอโอที ที่ใช้เซ็นเซอร์วัดประกอบด้วย วัดอุ หภูมิ ความชื้นสัมพัท ์ในโรงเรือนเห็ดนาง ้าและควบคุมการเปิดปิด ปั้มน้ำให้สปริงเกอร์และพ่นหมอกแบบอัตโนมัติ และเซอร์วิสที่ใช้ในการ ส่งข้อมูลขึ้นระบบอินเตอร์เน็ตคือ NETPIE และเซอร์วิสย่อยคือ NETPIE freeboard ในการแสดงสถา ะความชื้น และเวลาแบบเรลไทม์ (real time) และ NETPIE FEED ในการบันทึกข้อมูลความชื้นและเวลาและการดึงข้อมูลมาใช้งานคือ

Node.JS ผ่านเซอร์วิส NETPIE REST API มาเป็นไ ล์ CSV ในส่วนแสดงสถา ะการทำงานของการให้น้ำ แบบสปริงเกอร์และพ่นหมอกแบบอัตโนมัติผ่านมือถือ

### 2.2.4 IOT BASED DESIGN IMPLEMENTATION OF MUSHROOM FARM MONITORING

USING ARDUINO MICROCONTROLLERS & SENSORS
Parvati, Megha (2561) ในงานวิจัยฉบับนี้นำเสนอระบบการตรวจสอบและควบคุม สิ่งแวดล้อมเพื่อตรวจสอบและควบคุมสภาพแวดล้อมใน าร์มเห็ด ช่วยให้ผู้ใช้สามารถตรวจสอบอุ หภูมิ ความชื้นความเข้มข้นของก๊าซคาร์บอนไดออกไซด์และความเข้มของแสงใน าร์มเห็ดบนอุปกร ์ Android โดยใช้แพลต อร์มออนไลน์ thing Speak ส ่วนของตัวควบคุมสภาพแวดล้อมใน าร์มเห็ดจะควบคุม สภาพแวดล้อมให้เป็นไปตามที ่ผู้ใช้กำหนด ข้อมูลสถานะของสภาพแวดล้อมใน าร์มเห็ดจะถูกส ่งไป แสดงผลผ่าน ESP8266 WiFi modem
