narinthon-so/Mushroom-project/Documents/งานวิจัยที่เกี่ยวข้อง/006_WUNCA_Lora.pdf

บรรยายโดย
ผู้ช่วยศาสตราจารย์ ดร.กิตติพงษ์สุวรรณราช
kitti@psru.ac.th
และนายสุชิน เขียวเนตร
suchin@psru.ac.th
ศูนย์เทคโนโลยีสารสนเทศ
มหาวิทยาลัยราชภัฏพิบูลสงคราม พิษณุโลก

เครือข่าย LoRa กับการประยุกต์ใช้งานใน Smart University

## Agenda

- Internet of Things
- IoTs Problems (Distance , wiring)
- Introduction to LoRa
- LoRa Device/Node and Gateway
- LoRa Standard
- LoRa vs NB-IoT
- LoRa in Thailand
- LoRa Case Study
- LoRa for Smart University


https://www.gartner.com/smarterwithgartner/gartner-top-10-strategic-technology-trends-for-2018/


https://smarttech.smartsme.co.th/content/1902

### What is IoT?

- The Internet of Things (IoT) is the network of

physical objects—devices, vehicles, buildings and

other items embedded with electronics, software,

sensors, and network connectivity—that enables

these objects to collect and exchange data.

### “อินเทอร์เน็ตส าหรับสรรพสิ่ง”

### Where is IoT?

### It’s everywhere!


Smart
Appliances

Healthcare

Education – Partnership – Solutions

Information Security

Office of Budget and Finance

Wearable Tech


Education – Partnership – Solutions

Information Security

Office of Budget and Finance

## IoTs Problems

- Distance (ภายนอกอาคาร)
– ส่วนใหญ่ IoTs จะใช้ในพื ้นที่ใกล้ๆ ภายในอาคาร หรือระยะไม่เกิน 100 เมตร หรืออาจจะไกลมากขึ ้นโดยใช้เครือข่ายอินเทอร์เน็ตที่สามารถเข้าถึงได้
- Cable wiring
– ความยุ่งยากในการเดินสายสัญญาณ
– ระยะทางจ ากัด อาจจะไม่เหมาะส าหรับการท างานในพื ้นที่กว้าง เช่น Smart Farm

## Introduction to LoRa

LoRa® and LoRaWAN™. Low–Power, Wide-Area Networks (LPWAN) are projected to support a major portion of the billions of devices forecasted for the Internet of Things (IoT). LoRaWAN™ is designed from the bottom up to optimize LPWANs for battery lifetime, capacity, range, and cost. A summary of the LoRaWAN™ specification for the different regions will be given as well as high level comparison of the different technologies competing in the LPWAN space.


## LoRa Gateway


## LoRaWAN Architecture


Resources : livelession

## LoRa กบ

ั


## เทคโนโลยอ

ีื

่

นๆ

## LoRa Device/Node and Gateway


No. | Freq.
1. 433 Mhz.
2. 868 Mhz.
3. 915 Mhz.
LoRa Gateway

LoRa Node (ESP32+OLED+LoRa+WiFi)

vs

- LoRa contains only the link layer protocol and is perfect to be used in P2P communications between nodes. LoRa modules are a little cheaper that the LoRaWAN ones.
- LoRaWAN includes the network layer too so it is possible to send the information to any Base Station already connected to a Cloud platform. LoRaWAN modules may work in different frequencies by just connecting the right antenna to its socket.
- These modules are based on the same modulation technology (the same PHY layer): LoRa™, developed by Semtech. The LoRa module implements a simple link protocol, created by Libelium. However, the LoRaWAN module runs the LoRaWAN protocol, a much richer and more advanced protocol, created by the LoRa Alliance.
- The LoRa module and the LoRaWAN module are not compatible because the protocols are different.

http://www.libelium.com/development/waspmote/documentation/lora-vs-lorawan/

## LoRa Network Architecture


## LoRa Regional Summary


## LoRa Standard


## การประยุกต์ใช้งาน LoRa


ค่า RSSI จะเป็นตัวบอกระยะห่างจากต้นทาง

## LoRA in Thailand

- ลงประกาศในราชกิจจานุเบกษา เรียบร้อย ปลดล็อคย่านความถี่ 920-925 MHz ส าหรับ LoRa
- http://www.ratchakitcha.soc.go.th/DATA/PDF/2560/E/289/47.PDF
- http://www.ratchakitcha.soc.go.th/DATA/PDF/2560/E/289/51.PDF
- http://www.ratchakitcha.soc.go.th/DATA/PDF/2560/E/289/50.PDF

## สรุป (ร

่

## าง) ประกาศ กสทช.ฯ ท

ี

่

เก

ี

่

## ยวขอ

้

## งกบ

### ั LPWAN

- ในประกาศฯ LPWAN นั ้นจะอยู่ในส่วนที่ (2) กรณีเครื่องวิทยุคมนาคมประเภทสื่อสารข้อมูลทั่วไป ที่ ไม่ใช่ RFID (Non-RFID) สามารถสรุปสาระส าคัญดังนี ้
- ให้ใช้คลื่นความถี่ ๙๒๐-๙๒๕ เมกะเฮิรตซ์
- ถ้ามีก าลังส่งไม่เกิน ๕๐๐ มิลลิวัตต์ ได้รับยกเว้น ไม่ต้องได้รับใบอนุญาตให้ มี ใช้ และน าออก ซึ่งเครื่อง วิทยุคมนาคมและใบอนุญ าตให้ตั ้ง สถานีวิทยุคมนาคม แต่ไม่ได้รับยกเว้น ใบอนุญาตให้ท าน าเข้า และ ค้าซึ่งเครื่องวิทยุ คมนาคม
- ถ้ามีก าลังส่งสูงกว่า ๕๐๐ มิลลิวัตต์จะต้องได้รับใบอนุญาตวิทยุคมนาคมที่ เกี่ยวข้อง และการใช้คลื่น ความถี่ดังกล่าว จะต้องได้รับอนุญาตให้ใช้คลื่นความถี่ ตามมาตรา ๔๕ แห่งพระราชบัญญัติองค์กร จัดสรรคลื่นความถี่ และ ก ากับการประกอบกิจการวิทยุกระจายเสียง วิทยุโทรทัศน์ และกิจการ โทรคมนาคม พ.ศ. ๒๕๕๓ และจะต้องได้รับ ใบอนุญาตประกอบกิจการโทรคมนาคมแบบที่ สาม
- ไม่ได้รับสิทธิคุ้มครองการรบกวน
- จะเห็นว่าช่วงคลื่นความถี่ดังกล่าว เป็นมาตฐาน Unlicense Frequency Band ของ LoRaWAN ที่ใช้กันแพร่หลายอยู่แล้ว ซึ่งจากร่าง ประกาศนี ้ ก็ท าให้คาดหวังได้ว่าในปี (2561) อุตสาหกรรม LoRaWAN IoT น่าจะคึกคักยิ่งขึ ้น

## LoRa in Thailand



## LoRa for Smart University


ปี 2017 เริ่มมีการทดสอบและทดลองใช้ LoRa บน พื ้นที่ส่วนของการศึกษาหลัก (วิทยาเขต : ทุ่งทะเลแก้ว 997 ไร่) ได้แก่ Solar Smart Bin , Solar Co Station และ GPS Tracking U-bus services ฯลฯ เพื่อเข้าสู่การเป็น Green and Smart University ในอนาคต

http://itc.psru.ac.th

ESP32 LoRa SX1278 0.96 Inch Blue OLED Display Bluetooth WIFI Lora Kit 32


เป็นอุปกรณ์แรก ๆ และ
ปัจจุบันที่ทีมศูนย์ IT เราใช้ ทดสอบเครือข่าย LoRa
ด้วยคุณสมบัติที่ครบถ้วน
และราคาที่ถูก ใช้งานง่าย



ทดสอบการรับส่งข้อความ
บนอาคารศูนย์ IT ชั ้น 6
ไปยังประตูทางออกที่ 2
ด้วยระยะทาง 1.05 กม.

มหาวิทยาลัยราชภัฏพิบูลสงคราม พื ้นที่ส่วนทะเลแก้ว 997 ไร่


ทดสอบด้วยการส่ง
ข้อความค าว่า Hello
จาก Node A ไปยัง
Node B ได้ไกลสุดที่
ประมาณ 1,000 ม.
โดยสังเกตจากค่า RSSI
ไม่เกิน -131


Lithium Rechargeable
Battery 1000 mAh 3.7v

สามารถท างานได้ประมาณ 7 ชม.

## Case Study in PSRU

1. Solar Smart Bin
ถังขยะที่สามารถรายงานปริมาณขยะ ให้แม่บ้านหรือผู้เกี่ยวข้องทราบได้ว่า สถานะใกล้เต็มหรือกี่ %
2. Solar Co Station


สถานีวัดค่าคาร์บอนไดออกไซด์ ส าหรับรถยนต์ และจักรยานยนต์ที่ผู้ใช้บริการขับขี่ผ่านจุดส าคัญๆ ภายในมหาวิทยาลัย


## Solar Smart Bin


ESP32 LoRa + WiFi
ร่วมกับ Ultrasonic
sensor

## Solar Co Station


ESP32+LoRa+wifi
with Co sensor
,Temp and Humidity

For Green University


## NB-IoT

Narrowband IoT (NB-IoT), also known as LTE Cat NB1, is a Low Power Wide Area (LPWA) technology that works virtually anywhere. It connects devices more simply and efficiently on already established mobile networks, and handles small amounts of fairly infrequent 2-way data, securely and reliably. And the best is, it provides:


NB-IoT ( Narrow Band IoT ) ถูกออกแบบโดย 3GPP ที่มี หน้าที่ก าหนดสเปคทางด้านการสื่อสาร 3G, 4G/LTE ทุกวันนี ้ถูก ประกาศมาครั ้งแรกประมาณ กุมภาพันธ์ 2015 โดยออกมาพร้อมกับ Release 13 ของมาตรฐาน 3GPP



LoRA | NB-IoT
ลดหรือขจัดความพึ่งพาผู้ให้บริการเครือข่าย ลงทุนตัวรับ-ส่งเอง | จ าเป็นต้องพึ่งพาผู้ให้บริการเครือข่าย
รองรับระยะทางประมาณ 15-20KM ใน พื ้นที่โล่ง (ส่งข้อมูลในอัตราประมาณ 21 Kbps ใน Class A) | รองรับระยะทางได้ครอบคลุมมากกว่า (ขึ ้นอยู่ กับพื ้นที่ให้บริการเครือข่ายโทรศัพท์4G)
มีการรักษาความปลอดภัยแบบ AES-128 Security | LTE Data transmission Encryption AES
เหมาะกับงานที่เป็นแบบประจ าที่ มีพื ้นที่การ ท างานชัดเจน | เหมาะกับงานที่มีการเคลื่อนที่
Battery : 5-10 Years | Battery : 5-10 Years




## เชิญชวนอบรม !! วันที่ 19 มกราคม 2561

“LoRa Network เทคโนโลยีการสื่อสารระยะไกล” เวลา 9.00-16.00 น.
Workshop โดยทีมนักวิจัย LoRa จากมหาวิทยาลัยราชภัฏพิบูลสงคราม


คุณโสภณ พินิจกิจเจริญกุล และทีมวิทยากร
