narinthon-so/Mushroom-project/Documents/โรงเพาะเห็ดอัจฉริยะ_hardware.pptx

## โรงเพาะเห็ดอัจฉริยะ

Smart Mushroom Farm

## อาจารย์ที่ปรึกษา ดร. เศวษ หงส์ประสิทธิ์ จัดทำโดย นายนรินทร สอนชัยภูมิ นายวรรณณรงค์ สถิตวิทยกูล นายศุภชัย สะตะ

## โครงสร้างของระบบ


## การออกแบบโรงเรือนเพาะเห็ด


## การออกแบบวงจรตัวต้านทานตรวจสอบกระแส


## การออกแบบวงจรตัวต้านทานตรวจสอบกระแส


## การออกแบบวงจรตัวต้านทานตรวจสอบกระแส


## การออกแบบวงจรตัวต้านทานตรวจสอบกระแส

## การออกแบบวงจรตัวต้านทานตรวจสอบกระแส

## Slide 10

การทำงานของปั๊มพ่นหมอกและพัดลมในโหมดการทำงานแบบอัตโนมัติ (AUTO)

อุณหภูมิ(°C) | ความชื้น(%) | ปั๊มพ่นหมอก | พัดลม
< 25 | < 80 | ON | OFF
< 25 | 80-85 | OFF | OFF
< 25 | > 85 | OFF | ON
25-32 | < 80 | ON | OFF
25-32 | 80-85 | OFF | OFF
25-32 | > 85 | OFF | ON
> 32 | < 80 | ON | ON
> 32 | 80-85 | OFF | ON
> 32 | > 85 | OFF | ON

## การออกแบบการสื่อสารผ่าน Lora

IP Address = X1

Mushroom Node

IP Address = X0

STA Node

Lora communication

433MHz

Point–to-Point

## Slide 12


กดปุ่มเปลี่ยนโหมดการทำงาน

Web App

Windows App

## Slide 13

IP Address = X1

Mushroom Node

IP Address = X0

STA Node

เปลี่ยนโหมดการทำงาน
จาก MANUAL เป็น AUTO

X0X1T32.30H71.403080M0P1F12085

X1M

## Slide 14


## การออกแบบและสร้างเว็บแอปพลิเคชัน


## การออกแบบและสร้างเว็บแอปพลิเคชัน


## การออกแบบและสร้างเว็บแอปพลิเคชัน


## การออกแบบและสร้างเว็บแอปพลิเคชัน

Click


Click

## การออกแบบและสร้างเว็บแอปพลิเคชัน


Click

## การออกแบบและสร้างเว็บแอปพลิเคชัน


## การออกแบบและสร้างเว็บแอปพลิเคชัน


Click

## การออกแบบและสร้างเว็บแอปพลิเคชัน


Click

## การออกแบบและสร้างเว็บแอปพลิเคชัน


Click

## การออกแบบและสร้างเว็บแอปพลิเคชัน


Click

## การออกแบบและสร้างวินโดว์แอปพลิเคชัน


## การออกแบบและสร้างวินโดว์แอปพลิเคชัน
