narinthon-so/Mushroom-project/Documents/WebServerDiagram.pptx

Web Server

Access Point


HTTP

HTTP

HTTP


HTTP

Internet

HTTP


Database


Client
