narinthon-so/Mushroom-project/Documents/เล่ม/ประวัติผู้เขียน_1.docx

ประวัติผู้เขียน

ชื่อ-นามสกุล นายวรรณณรงค์ สถิตวิทยกูล

วัน-เดือน-ปีเกิด 14 พฤษภาคม 2541

ที่อยู่ 30/69 ถ.อำมาตย์ ต.ในมือง อ.เมือง จ.ขอนแก่น 40000

อีเมล wannarong.sa@rmuti.ac.th

เบอร์โทรศัพท์ 0862323374

ประวัติการศึกษา

ระดับประถมศึกษา โรงเรียนมหาไถ่ศึกษาภาคตะวันออกเฉียงเหนือ

ปีการศึกษา 2553

ระดับมัธยมศึกษาตอนต้น โรงเรียนขอนแก่นวิทยายน

ปีการศึกษา 2556

ระดับมัธยมศึกษาตอนปลาย โรงเรียนขอนแก่นวิทยายน

ปีการศึกษา 2559
