narinthon-so/Mushroom-project/Documents/เล่ม/ปัจจัยที่มีผลต่อการออกดอกของเห็ดนางฟ้า.docx

ปัจจัยที่มีผลต่อการออกดอกของเห็ดนางฟ้า

ระยะเปิดดอก
อุณหภูมิ(°C) | ความชื้น(%) | แสงสว่าง | อ้างอิง
25-30 | 80-90% | read a newspaper | Peter Oei, 2005
25-30 | - | - | ชาญกิจ วงศ์เผ่าสกุล, 2555
24-26 | - | อ่านหนังสือออก | บุญส่ง วงศ์เกรียงไกร, 2543
25–30 | 75-85 | - | เบญจพลและณฐวุฒิ, ม.ป.ป
25-28 | 70-90 | - | มทร.นครราชสีมา, 2556
