narinthon-so/Mushroom-project/Documents/เล่ม/successed/เล่ม/กิตติกรรมประกาศ.docx

กิตติกรรมประกาศ

ปริญญานิพนธ์ฉบับนี้ได้รับความช่วยเหลืออย่างดียิ่งจาก อาจารย์ ดร.เศวษ หงษ์ประสิทธิ์อาจารย์ที่ปรึกษาปริญญานิพนธ์ ซึ่งกรุณาให้คำแนะนำและถ่ายทอดความรู้ ตลอดจนควบคุมการทำโครงงานจนประสบความสำเร็จ ผู้ทำโครงงานขอกราบขอบพระคุณเป็นอย่างสูงไว้ ณ โอกาสนี้

ขอขอบพระคุณคณาจารย์มหาวิทยาลัยเทคโนโลยีราชมงคลอีสาน วิทยาเขตขอนแก่น ที่ได้ประสิทธิประสาทความรู้และคณะตลอดเวลาที่ศึกษาเล่าเรียน

ขอขอบพระคุณบิดามารดาตลอดจนญาติพี่น้องที่คอยเป็นกำลังใจให้ข้าพเจ้าและสนับสนุนส่งเสริมการศึกษามาโดยตลอด

ขอขอบพระคุณเพื่อนๆทุกท่านที่ได้ให้การช่วยเหลือในการทำโครงงาน การเรียน การทำงานและมิตรภาพที่ดีแก่กันเสมอมา

ขอขอบพระคุณทุกท่านที่มิได้เอ่ยนามเป็นอย่างยิ่งในความกรุณาและความช่วยเหลือในด้านต่าง ๆ ที่ทำให้โครงงานนี้สำเร็จได้

ประโยชน์และคุณค่าอันพึงมีจากปริญญานิพนธ์ฉบับนี้ผู้ทำโครงงานขอมอบเป็นกตัญญุตาบูชาแด่ บิดามารดา ตลอดจนผู้มีพระคุณทุกท่าน

นรินทร สอนชัยภูมิ

วรรรณณรงค์ สถิตวิทยกูล
