narinthon-so/Mushroom-project/Documents/เล่ม/successed/เล่ม/ปกนอก.docx

โรงเพาะเห็ดอัจฉริยะโดยใช้เทคโนโลยีการสื่อสารไร้สายระยะไกล

Smart Mushroom Farm using Long Range Wireless Communication Technology

นายนรินทร สอนชัยภูมิ

นายวรรรณณรงค์ สถิตวิทยกูล

ปริญญานิพนธ์นี้เป็นส่วนหนึ่งของการศึกษาตามหลักสูตรปริญญาวิศวกรรมศาสตรบัณฑิต

สาขาวิชาวิศวกรรมคอมพิวเตอร์

คณะวิศวกรรมศาสตร์ มหาวิทยาลัยเทคโนโลยีราชมงคลอีสาน วิทยาเขตขอนแก่น

พ.ศ. 2564

ลิขสิทธิ์คณะวิศวกรรมศาสตร์ มหาวิทยาลัยเทคโนโลยีราชมงคลอีสาน
