narinthon-so/Mushroom-project/Documents/เล่ม/successed/เล่ม/ปกใน.docx

โรงเพาะเห็ดอัจฉริยะโดยใช้เทคโนโลยีการสื่อสารไร้สายระยะไกล

นายนรินทร สอนชัยภูมิ

นายวรรรณณรงค์ สถิตวิทยกูล

ปริญญานิพนธ์นี้เป็นส่วนหนึ่งของการศึกษาตามหลักสูตรปริญญาวิศวกรรมศาสตรบัณฑิต

สาขาวิชาวิศวกรรมคอมพิวเตอร์

คณะวิศวกรรมศาสตร์ มหาวิทยาลัยเทคโนโลยีราชมงคลอีสาน วิทยาเขตขอนแก่น

พ.ศ. 2564

ลิขสิทธิ์คณะวิศวกรรมศาสตร์ มหาวิทยาลัยเทคโนโลยีราชมงคลอีสาน

Smart Mushroom Farm using Long Range Wireless Communication Technology

Narinthon Sonchaiyaphum

Wannarong Satitwittayakul

A Report Submitted in Partial Fulfillment of the Requirements for

the Degree of Bachelor of Engineering

Department of Computer Engineering

Faculty of Engineering

Rajamangala University of Technology Isan, Khon Kaen Campus

2021

© Faculty of Engineering, Rajamangala University of Technology Isan
