narinthon-so/Mushroom-project/Documents/ตัวอย่าง/เล่ม-ออกแบบและพัฒนาเครื่องวัดค่าดัชนีมวลกาย.pdf

### ออกแบบและพัฒนาเครื่องวัดค่าดัชนีมวลกาย Design and Development of Body Mass Index Machine

ทัศนะ แก้ววันทา
นราพัฒน์ อินต๊ะสุวรรณ์

ปริญญานิพนธ์นี้เป็นส่วนหนึ่งของการศึกษาตามหลักสูตรปริญญาวิศวกรรมศาสตรบัณฑิต สาขาวิชาวิศวกรรมคอมพิวเตอร์ คณะวิศวกรรมศาสตร์ มหาวิทยาลัยเทคโนโลยีราชมงคลอีสาน วิทยาเขตขอนแก่น พ.ศ. 2563
ลิขสิทธิ์คณะวิศวกรรมศาสตร์ มหาวิทยาลัยเทคโนโลยีราชมงคลอีสาน

ออกแบบและพัฒนาเครื่องวัดค่าดัชนีมวลกาย

ทัศนะ แก้ววันทา
นราพัฒน์ อินต๊ะสุวรรณ์

ปริญญานิพนธ์นี้เป็นส่วนหนึ่งของการศึกษาตามหลักสูตรปริญญาวิศวกรรมศาสตรบัณฑิต สาขาวิชาวิศวกรรมคอมพิวเตอร์ คณะวิศวกรรมศาสตร์ มหาวิทยาลัยเทคโนโลยีราชมงคลอีสาน วิทยาเขตขอนแก่น พ.ศ. 2563
ลิขสิทธิ์คณะวิศวกรรมศาสตร์ มหาวิทยาลัยเทคโนโลยีราชมงคลอีสาน

Design and Development of Body Mass Index Machine

Thatsana Kaewwanta
Naraphat Intasuwan

A Report Submitted in Partial Fulfillment of the Requirements for the Degree of Bachelor of Engineering Department of Computer Engineering Faculty of Engineering
Rajamangala University of Technology Isan, Khon Kaen Campus 2020
© Faculty of Engineering, Rajamangala University of Technology Isan

ใบรับรองปริญญานิพนธ์
มหาวิทยาลัยเทคโนโลยีราชมงคลอีสาน วิทยาเขตขอนแก่น

หัวข้อปริญญานิพนธ์ : ออกแบบและพัฒนาเครื่องวัดค่าดัชนีมวลกาย จัดท าโดย : ทัศนะ แก้ววันทา และนราพัฒน์ อินต๊ะสุวรรณ์
สาขาวิชา : วิศวกรรมคอมพิวเตอร์
ประธานที่ปรึกษา : อาจารย์ดร.เศวษ หงษ์ประสิทธ์

ได้รับอนุมัติให้เป็นส่วนหนึ่งของการศึกษาตามหลักสูตรปริญญาวิศวกรรมศาสตรบัณฑิต คณะวิศวกรรมศาสตร์ มหาวิทยาลัยเทคโนโลยีราชมงคลอีสาน วิทยาเขตขอนแก่น

| คณบดีคณะวิศวกรรมศาสตร์
(นายปริญ นาชัยสิทธิ์) วันที่.......เดือน | พ.ศ |

คณะกรรมการสอบปริญญานิพนธ์

| ประธานกรรมการสอบ | ประธานที่ปรึกษา
(ผู้ช่วยศาสตราจารย์ ธีระพันธ์ ระรื่นรมย์) (อาจารย์ดร.เศวษ หงษ์ประสิทธิ์)
| กรรมการ
(อาจารย์นาวา งามวิทยานนท์)

หัวข้อปริญญานิพนธ์ | ออกแบบและพัฒนาเครื่องวัดค่าดัชนีมวลกาย
จัดท าโดย | ทัศนะ แก้ววันทา และนราพัฒน์ อินต๊ะสุวรรณ์
ปีที่ส าเร็จการศึกษา | พุทธศักราช 2563
สาขาวิชา | วิศวกรรมคอมพิวเตอร์
ที่ปรึกษา | อาจารย์ ดร.เศวษ หงษ์ประสิทธิ์
| บทคัดย่อ

ปริญญานิพนธ์นี้มีจุดประสงค์เพื่อออกแบบและพัฒนาเครื่องวัดค่าดัชนีมวลกาย ให้ สามารถอ่านค่าน้ าหนักและส่วนสูงจากเซ็นเซอร์แล้วน าค่าเหล่านี้มาค านวณหาค่าดัชนีมวลกายเพื่อ เปรียบเทียบเกณฑ์ของร่างกายจากค่าดัชนีมวลกายที่ค านวณได้พร้อมแสดงผลลัพธ์ในหน้าจอระบบ สัมผัสให้ผู้ใช้งานตรวจสอบและส่งข้อมูลการใช้งานไปยังเซิร์ฟเวอร์เพื่อบันทึกในฐานข้อมูลให้ผู้ใช้งาน สามารถเรียกดูประวัติการใช้งานได้ในรูปแบบเว็บแอปพลิเคชัน การออกแบบและพัฒนาเครื่องวัดค่าดัชนีมวลกายแบ่งเป็น 2 ส่วน ส่วนแรก คือส่วนของ เครื่องวัดค่าดัชนีมวลกายที่ท าหน้าที่ชั่งน้ าหนัก, วัดส่วนสูง และค านวณค่าดัชนีมวลกายเพื่อ เปรียบเทียบเกณฑ์ของร่างกาย มีระบบการท างานกับหน้าจอแบบสัมผัสและระบบเสียงขั้นตอนการ ท างาน อีกทั้งยังมีระบบสมาชิกในการเข้าสู่ระบบเพื่อเก็บประวัติการใช้งานส าหรับดูย้อนหลัง ส่วนที่ 2 คือส่วนระบบบันทึกค่าดัชนีมวลกายเป็นการจัดการข้อมูลในรูปแบบเว็บแอปพลิเคชันที่ผู้ใช้งาน สามารถสมัครสมาชิกเพื่อเป็นสมาชิกและเข้าสู่ระบบเพื่อเข้าดูประวัติการใช้งานที่ได้ใช้งานบน เครื่องวัดค่าดัชนีมวลกาย
สรุปผลการด าเนินงานได้ท าการทดสอบการใช้งานเครื่องวัดค่าดัชนีมวลกายกับผู้ใช้งาน จ านวน 10 คน ทดสอบคนละ 10 รอบ เพื่อหาค่าเฉลี่ยของผู้ใช้งานแต่ละคน จากนั้นน าค่าที่ได้ไป เปรียบเทียบหาเปอร์เซ็นต์ความผิดพลาดของเครื่องวัดค่าดัชนีมวลกายโดยเปรียบเทียบกับเครื่องมือ ชั่งน้ าหนักและวัดส่วนสูงแบบมาตรฐาน จากผลการทดสอบได้ค่าเปอร์เซ็นต์ความผิดพลาดเฉลี่ยของ น้ าหนัก 0.22 เปอร์เซ็นต์ ส่วนสูง 0.25 เปอร์เซ็นต์ และค่าดัชนีมวลกาย 0.61 เปอร์เซ็นต์ ในการ ทดสอบการใช้งานเว็บแอปพลิเคชันสามารถสมัครสมาชิก, เข้าสู่ระบบ, เรียกดูประวัติการใช้งาน และ แก้ไขข้อมูลส่วนตัว พบว่าเว็บแอปพลิเคชันมีการแจ้งเตือนและท างานได้ถูกต้องทุกประการ

Project Title | Design and Development of Body Mass Index System
Proposed by | Thatsana Kaewwanta and Naraphat Intasuwan
Year | 2020
Department | Computer Engineering
Project Advisor | Dr. Saweth Hongprasit
| Abstract

The purposes of the study were to design and development of body mass index machine. This system can read the weight and height from the sensor and then use these values to calculate the body mass index to compare the criteria of the body from the calculated body mass index. Ready to display the results in the touch screen for users to check and send usage data to the server to save in the database for users to view their usage history in the form of web application.
The design and development of the body mass index machine is divided into two parts. The first part is the body mass index machine that is used to weigh, measure height and calculate the body mass index to compare the body's criteria. Operation system with touch screen and sound system. There is also a membership system for logging in to store historical usage history. Part 2 is the body mass index recording system. Data management in the form of a web application that users can subscribe to. To become a member and login to view the history of usage that has been used on the body mass index machine.
In testing the use of the body mass index machine, was tested with 10 users, 10 cycles each to find the average of each user. The values were then compared to find the percentage of errors of the body mass index meter by comparing it with a standard weighing and height measuring instrument. Based on the test results, the average error percentage of 0.22 percent weight, 0.25 percent height and 0.61 percent body mass index. In the web application test can be subscribed, logged in, view their usage history and edit personal information. That the web application is notified and works correctly in all respects.

กิตติกรรมประกาศ

ปริญญานิพนธ์ฉบับนี้ได้รับความช่วยเหลืออย่างดียิ่งจาก อาจารย์ดร.เศวษ หงส์ประสิทธิ์ อาจารย์ที่ปรึกษาปริญญานิพนธ์ ซึ่งกรุณาให้ค าแนะน าและถ่ายทอดความรู้ ตลอดจนควบคุมการ ท าโครงงานจนประสบความส าเร็จ ผู้ท าโครงงานขอกราบขอบพระคุณเป็นอย่างสูงไว้ ณ โอกาส นี้ ขอกราบขอบพระคุณ คณาจารย์มหาวิทยาลัยเทคโนโลยีราชมงคลอีสาน วิทยาเขตขอนแก่น ที่ได้ประสิทธิประสาทความรู้และคณะตลอดเวลาที่ศึกษาเล่าเรียน
ขอขอบพระคุณคุณพ่อ คุณแม่และครอบครัวที่ข้าพเจ้ารักที่คอยเป็นก าลังใจให้ข้าพเจ้าและ สนับสนุนส่งเสริมการศึกษามาโดยตลอด
ขอขอบพระคุณ ทุกท่านที่มิได้เอ่ยนามเป็นอย่างยิ่ง ในความกรุณาและความช่วยเหลือ ในด้านต่าง ๆ ที่ท าให้โครงงานนี้ส าเร็จได้
ประโยชน์และคุณค่าอันพึงมีจากปริญญานิพนธ์ฉบับนี้ ผู้ท าโครงงานขอมอบเป็นกตัญญูตา บูชาแด่ บิดามารดา ครูอาจารย์ตลอดผู้มีพระคุณทุกท่าน

ทัศนะ แก้ววันทา
นราพัฒน์ อินต๊ะสุวรรณ์

สารบัญ

**** | หน้า
บทคัดย่อ | ค
กิตติกรรมประกาศ | ง
สารบัญตาราง | ญ
สารบัญรูป | ฎ

บทที่
1 บทน า | 1
1.1 หลักการและเหตุผล | 1
1.2 วัตถุประสงค์ | 2
1.3 ขอบเขตและข้อจ ากัดของปริญญานิพนธ์ | 2
1.4 ประโยชน์ที่คาดว่าจะได้รับ | 3
2 ทฤษฎีและงานวิจัยที่เกี่ยวข้อง | 4
2.1 ทฤษฎีที่เกี่ยวข้อง | 4
2.1.1 ค่าดัชนีมวลกาย | 4
2.1.2 อุปกรณ์ที่เกี่ยวข้อง | 6
2.1.2.1 Heltec WiFi LoRa 32 | 6
2.1.2.2 Load Cell (โหลดเซลล์) | 7
2.1.2.3 Ultrasonic Sensor (Hc-SR04) | 8
2.1.2.4 Touch Screen (HMI TFT LCD Touch) | 9
2.1.2.5 DFPlayer Mini | 9
2.1.2.6 Mini 298N | 10
2.1.2.7 มอเตอร์เกียร์ | 10
2.1.2.8 เฟืองเดือย | 11
2.1.3 ระบบฐานข้อมูล | 11
2.1.3.1 นิยามและค าศัพท์พื้นฐานเกี่ยวกับระบบฐานข้อมูล | 12
2.1.3.2 ประโยชน์เมื่อจัดเก็บข้อมูลรวมเป็นฐานข้อมูล | 12
2.1.3.3 รูปแบบของระบบฐานข้อมูล | 13

ฉ

สารบัญ (ต่อ)

บทที่ | หน้า
2.1.4 Angular 8 | 13
2.1.5 Spring | 14
2.1.6 ภาษาที่เกี่ยวข้อง | 14
2.1.6.1 TypeScript | 14
2.1.6.2 SQL | 15
2.1.6.3 Java | 16
2.1.7 โปรแกรมที่เกี่ยวข้อง | 18
2.1.7.1 Arduino IDE | 18
2.1.7.2 IntelliJ IDEA | 18
2.1.7.3 Visual Studio Code | 18
2.1.7.4 Circuit Wizard | 18
2.1.7.5 Nextion editor | 19
2.1.7.6 SketchUp | 19
2.2 งานวิจัยที่เกี่ยวข้อง | 19
2.2.1 กชกรณ์ (2560) | 19
2.2.2 เครื่องชั่งน้ าหนัก วัดส่วนสูง NAGATA รุ่น BW-1122H | 20
2.2.3 เครื่องชั่งน้ าหนัก Digtal scales รุ่น scml | 20
2.2.4 เครื่องชั่งน้ าหนัก วัดส่วนสูงอัตโนมัติ ADAM รุ่น MUW 300L | 20
2.2.5 เครื่องชั่งน้ าหนัก วัดส่วนสูงอัตโนมัติ Shengyuan รุ่น HGM-601 | 20
3 วิธีด าเนินงาน | 21
3.1 การศึกษาและวิเคราะห์ระบบ | 22
3.1.1 การวิเคราะห์ระบบเดิม | 22
3.1.2 หลักการท างานของระบบเดิม | 22
3.1.3 หลักการท างานของระบบใหม่ | 23
3.2 การออกแบบเครื่องวัดค่าดัชนีมวลกาย | 24
3.2.1 ภาพรวมการท างานของเครื่องวัดค่าดัชนีมวลกาย | 24
3.2.2 การเชื่อมต่ออุปกรณ์และโปรแกรมส าหรับควบคุมฮาร์ดแวร์ | 27

ช

สารบัญ (ต่อ)

บทที่ | หน้า
3.2.2.1 การเชื่อมต่อโหลดเซลล์กับไมโครคอนโทรลเลอร์ | 27
3.2.2.2 การเชื่อมต่ออัลตร้าโซนิกกับไมโครคอนโทรลเลอร์ | 29
3.2.2.3 การเชื่อมต่อหน้าจอสัมผัสกับไมโครคอนโทรลเลอร์ | 30
3.2.2.4 การเชื่อมต่อโมดูลเล่นเสียงกับไมโครคอนโทรลเลอร์ | 32
3.2.2.5 การเชื่อมมอเตอร์กับไมโครคอนโทรลเลอร์ | 33
3.2.2.6 การเชื่อมต่อสวิตซ์กับไมโครคอนโทรลเลอร์ | 35
3.2.3 การออกแบบวงจรส าหรับอุปกรณ์อิเล็กทรอนิกส์ | 36
3.2.4 การออกแบบหน้าจอสัมผัส (Touch Screen) | 37
3.2.4.1 หน้าจอยินดีต้อนรับ (welcome) | 37
3.2.4.2 หน้าจอเมนู (menu) | 38
3.2.4.3 หน้าจอเริ่มต้น (start) | 39
3.2.4.4 หน้าจอเข้าสู่ระบบ (login) | 39
3.2.4.5 หน้าจอกรอกหมายเลขโทรศัพท์ (input_username) | 40
3.2.4.6 หน้าจอกรอกรหัสผ่าน (input_password) | 41
3.2.4.7 หน้าจอก าลังเข้าสู่ระบบ (onlogin) | 41
3.2.4.8 หน้าจอไม่มีผู้ใช้ในระบบ (status_nouser) | 42
3.2.4.9 หน้าจอรหัสผ่านไม่ถูกต้อง (status_nopass) | 43
3.2.4.10 หน้าจอฐานข้อมูลยังไม่เปิดให้บริการ (status_noapi) | 43
3.2.4.11 หน้าจอค านวณ (calculate) | 44
3.2.4.12 หน้าจอแสดงข้อมูลของผู้ใช้ทั่วไป (nouser_show) | 45
3.2.4.13 หน้าจอแสดงข้อมูลของสมาชิก (user_show) | 45
3.2.4.14 หน้าจอก าลังบันทึกข้อมูล (onseve) | 46
3.2.4.15 หน้าจอบันทึกข้อมูลเสร็จสิ้น (save_success) | 47
3.2.4.16 หน้าจอก าลังเชื่อมต่ออินเทอร์เน็ต (connected) | 47
3.2.4.17 หน้าจอกรุณาใส่ SD Card (sdcard) | 48
3.2.5 การออกแบบตัวเครื่อง | 48

ซ

บทที่

สารบัญ (ต่อ)

หน้า
3.3 การออกแบบเว็บแอปพลิเคชัน | 50
3.3.1 การวิเคราะห์ระบบ | 50
3.3.2 ภาพรวมระบบ | 50
3.3.2.1 สมัครสมาชิก | 51
3.3.2.1 เข้าสู่ระบบ | 51
3.3.2.3 ดูข้อมูลส่วนตัว | 51
3.3.2.4 ดูประวัติการใช้งานเครื่องวัดค่าดัชนีมวลกาย | 51
3.3.2.5 แก้ไขข้อมูลส่วนตัว | 51
3.3.2.6 ออกจากระบบ | 51
3.3.3 การออกแบบหน้าจอ | 54
3.3.3.1 หน้าแรก (auth/home) | 54
3.3.3.2 หน้าสมาชิก (auth/registration) | 55
3.3.3.3 หน้าเข้าสู่ระบบ (auth/login) | 56
3.3.3.4 หน้าหลัก (home-page) | 56
3.3.3.5 หน้าแก้ไขข้อมูลส่วนตัว (edit-page) | 57
3.4 การออกแบบฐานข้อมูล | 58
3.4.1 การออกแบบตารางเก็บข้อมูล | 58
3.4.2 การเขียนโปรแกรมเชื่อมต่อฐานข้อมูล | 60
3.4.2.1 การสร้างตารางผู้ใช้ (user) | 60
3.4.2.2 การสร้างตารางข้อมูล(data) ในฐานข้อมูลด้วย Spring Framework | 62
3.5 การออกแบบ API ด้วย Spring Framework | 64
3.5.1 การออกแบบ API ส่วนของ ข้อมูลผู้ใช้งาน | 64
3.5.1.1 ฟังก์ชันการสมัครสมาชิก | 64
3.5.1.2 ฟังก์ชันการเข้าสู่ระบบ | 65
3.5.1.3 ฟังก์ชันการเข้าสู่ระบบ ของไมโครคอนโทรลเลอร์ | 66
3.5.1.4 ฟังก์ชันการแก้ไขข้อมูล | 67
3.5.1.5 ฟังก์ชันแสดงรายละเอียด | 68

ฌ

สารบัญ (ต่อ)

บทที่ | หน้า
3.5.2 การออกแบบ API ส่วนของ ประวัติการใช้งาน | 69
3.5.2.1 ฟังก์ชันการบันทึกข้อมูล | 69
3.5.2.2 ฟังก์ชันการเรียกดูประวัติการใช้งาน | 70
4 ผลการด าเนินงาน | 71
4.1 ผลการทดสอบเครื่องวัดค่าดัชนีมวลกาย | 71
4.1.1 ผลการทดสอบวัดค่าน้ าหนัก ส่วนสูง และค านวณค่าดัชนีมวลกาย | 72
4.1.2 ผลการประเมินการท างานของเครื่องวัดค่าดัชนีมวลกาย | 82
4.2 ผลการทดสอบระบบบันทึกค่าดัชนีมวลกาย | 82
4.2.1 ผลการทดสอบการสมัครสมาชิก | 83
4.2.1.1 ทดสอบกรอกข้อมูลไม่ครบ | 83
4.2.1.2 ทดสอบการกรอกเบอร์โทรศัพท์และรหัสผ่าน | 83
4.2.1.3 ทดสอบการสมัครสมาชิกซ้ า | 84
4.2.2 ผลการทดสอบการเข้าสู่ระบบ | 85
4.2.2.1 ทดสอบกรอกชื่อผู้ใช้ | 85
4.2.2.2 ทดสอบกรอกรหัสผ่าน | 85
4.2.3 ผลการทดสอบการดูประวัติการใช้งานเครื่องวัดค่าดัชนีมวลกาย | 86
4.2.4 ผลการทดสอบการแก้ไขข้อมูลส่วนตัว | 87
4.2.4.1 ทดสอบการกรอกรหัสผ่านก่อนการแก้ไขข้อมูล | 87
5 สรุปผลโครงงาน | 89
5.1 สรุปผล | 89
5.2 ปัญหาและแนวทางแก้ไข | 89
5.3 ข้อเสนอแนะและแนวทางการพัฒนา | 90
บรรณานุกรม | 91
ภาคผนวก | 94
ภาคผนวก ก คู่มือการใช้งาน | 95
ประวัติผู้เขียน | 104

สารบัญตาราง

ตารางที่ | | หน้า
3.1 | แสดง Use Case Description ในส่วน สมัครสมาชิก | 52
3.2 แสดง Use Case Description ในส่วน เข้าสู่ระบบ | 53
3.3 แสดง Use Case Description ในส่วน ดูข้อมูลส่วนตัว | 53
3.4 แสดง Use Case Description ในส่วน ดูประวัติการใช้งาน
| เครื่องวัดค่าดัชนีมวลกาย | 53
3.5 แสดง Use Case Description ในส่วน แก้ไขข้อมูลส่วนตัว | 54
3.6 แสดง Use Case Description ในส่วน ออกจากระบบ | 54
3.7 Data Dictionary users | 59
3.5 Data Dictionary data | 59
4.1 การทดสอบกับคนที่ 1 จ านวน 10 ครั้ง | 73
4.2 การทดสอบกับคนที่ 2 จ านวน 10 ครั้ง | 74
4.3 การทดสอบกับคนที่ 3 จ านวน 10 ครั้ง | 74
4.4 การทดสอบกับคนที่ 3 จ านวน 10 ครั้ง (ต่อ) | 75
4.5 การทดสอบกับคนที่ 4 จ านวน 10 ครั้ง | 75
4.6 การทดสอบกับคนที่ 4 จ านวน 10 ครั้ง (ต่อ) | 76
4.7 การทดสอบกับคนที่ 5 จ านวน 10 ครั้ง | 76
4.8 การทดสอบกับคนที่ 6 จ านวน 10 ครั้ง | 77
4.9 การทดสอบกับคนที่ 7 จ านวน 10 ครั้ง | 77
4.10 การทดสอบกับคนที่ 7 จ านวน 10 ครั้ง (ต่อ) | 78
4.11 การทดสอบกับคนที่ 8 จ านวน 10 ครั้ง | 78
4.12 การทดสอบกับคนที่ 9 จ านวน 10 ครั้ง | 79
4.13 การทดสอบกับคนที่ 10 จ านวน 10 ครั้ง | 79
4.14 การทดสอบกับคนที่ 10 จ านวน 10 ครั้ง (ต่อ) | 80
4.15 ผลการทดสอบเปรียบเทียบเครื่องวัดค่าดัชนีมวลกายกับเครื่องมือวัดทั่วไป | 81
4.16 ผลการประเมินการท างานของเครื่องวัดค่าดัชนีมวลกาย | 82
4.17 สรุปผลการทดสอบระบบบันทึกค่าดัชนีมวลกาย | 88

สารบัญรูป

รูปที่ | | หน้า
2.1 เครื่องค านวณค่าดัชนีมวลกายแบบชั่งได้แค่น้ าหนักกับเครื่องที่ชั่งน้ าหนักและ
| วัดส่วนสูงได้ | 5
2.2 | Heltec WiFi LoRa 32 หรือ NodeMCU (ESSP32 + LoRa SX1278) | 6
2.3 Load Cell (โหลดเซลล์) | 7
2.4 แสดงบอร์ด (HX711) | 7
2.5 Ultrasonic Sensor (HC-SR04) | 8
2.6 การติดต่อระหว่างไมโครคอนโทรลเลอร์กับโมดูล HC-SR04 เพื่อวัดระยะทาง | 8
2.7 Touch Screen (HMI TFT LCD Touch) | 9
2.8 DFPlayer Mini | 9
2.9 Mini 298N | 10
2.10 มอเตอร์เกียร์ | 10
2.11 | เฟืองเดือย | 11
2.12 แสดงสัญลักษณ์ระบบฐานข้อมูล | 11
2.13 แสดงสัญลักษณ์ ANGULAR | 13
2.14 แสดงสัญลักษณ์Spring Boot Framework | 14
2.15 แสดงสัญลักษณ์ TypeScript | 14
2.16 แสดงสัญลักษณ์ SQL | 15
3.1 บล็อกไดอะแกรมหลักการท างานของระบบเดิม | 23
3.2 บล็อกไดอะแกรมหลักการท างานของระบบใหม่ | 24
3.3 Flow Chart แสดงหลักการท างานของโปรแกรมที่ใช้ควบคุม
| เครื่องวัดค่าดัชนีมวลกาย | 25

3.4 Flow Chart แสดงหลักการท างานของโปรแกรมที่ใช้ควบคุม

| เครื่องวัดค่าดัชนีมวลกาย (ต่อ) | 26
3.5 การเชื่อมต่อโหลดเซลล์กับไมโครคอนโทรลเลอร์ | 28
3.6 โปรแกรมการอ่านค่าจากโหลดเซลล์ | 28
3.7 การเชื่อมต่ออัลตร้าโซนิกกับไมโครคอนโทรลเลอร์ | 29
3.8 โปรแกรมการอ่านค่าจากอัลตร้าโซนิก | 30

ฏ

สารบัญรูป (ต่อ)

รูปที่ | หน้า
3.9 การเชื่อมต่อหน้าจอสัมผัสกับไมโครคอนโทรลเลอร์ | 31
3.10 โปรแกรมสื่อสารข้อมูลกับหน้าจอสัมผัส | 31
3.11 การเชื่อมต่อโมดูลเล่นเสียงกับไมโครคอนโทรลเลอร์ | 32
3.12 โปรแกรมควบคุมโมดูลเล่นเสียง | 33
3.13 การเชื่อมต่อมอเตอร์กับไมโครคอนโทรลเลอร์ | 34
3.14 โปรแกรมควบคุมมอเตอร์ | 34
3.15 การเชื่อมต่อสวิตช์กับไมโครคอนโทรลเลอร์ | 35
3.16 โปรแกรมอ่านค่าสวิตช์ | 36
3.17 ลายวงจรอิเล็กทรอนิกส์ | 37
3.18 แสดงหน้า “ยินดีต้อนรับ” บนหน้าจอสัมผัส | 38
3.19 แสดงหน้า “เมนู” บนหน้าจอสัมผัส | 38
3.20 แสดงหน้า “เริ่มต้น” บนหน้าจอสัมผัส | 39
3.21 แสดงหน้า “เข้าสู่ระบบ” บนหน้าจอสัมผัส | 40
3.22 แสดงหน้า “กรอกหมายเลขโทรศัพท์” บนหน้าจอสัมผัส | 40
3.23 แสดงหน้า “กรอกรหัสผ่าน” บนหน้าจอสัมผัส | 41
3.24 แสดงหน้า “ก าลังเข้าสู่ระบบ” บนหน้าจอสัมผัส | 42
3.25 แสดงหน้า “ไม่มีผู้ใช้ในระบบ” บนหน้าจอสัมผัส | 42
3.26 แสดงหน้า “รหัสผ่านไม่ถูกต้อง” บนหน้าจอสัมผัส | 43
3.27 แสดงหน้า “ฐานข้อมูลยังไม่เปิดให้บริการ” บนหน้าจอสัมผัส | 44
3.28 แสดงหน้า “ค านวณ” บนหน้าจอสัมผัส | 44
3.29 แสดงหน้า “แสดงข้อมูลของผู้ใช้ทั่วไป” บนหน้าจอสัมผัส | 45
3.30 แสดงหน้า “แสดงข้อมูลของสมาชิก” บนหน้าจอสัมผัส | 46
3.31 แสดงหน้า “ก าลังบันทึกข้อมูล” บนหน้าจอสัมผัส | 46
3.32 แสดงหน้า “บันทึกข้อมูลเสร็จสิ้น” บนหน้าจอสัมผัส | 47
3.33 แสดงหน้า “ก าลังเชื่อมต่ออินเทอร์เน็ต” บนหน้าจอสัมผัส | 47
3.34 แสดงหน้า “กรุณาใส่ SD Card” บนหน้าจอสัมผัส | 48
3.35 แสดงแบบตัวเครื่องวัดค่าดัชนีมวลกายด้านหน้า | 49
3.36 แสดงแบบตัวเครื่องวัดค่าดัชนีมวลกายด้านข้าง | 49

ฐ

สารบัญรูป (ต่อ)

รูปที่ | หน้า
3.37 แสดงแบบตัวเครื่องวัดค่าดัชนีมวลกายด้านหลัง | 50
3.38 แสดง Use Case Diagram ระบบบันทึกค่าดัชนีมวลกาย | 52
3.39 แสดงหน้าแรกของระบบบันทึกค่าดัชนีมวลกาย | 55
3.40 แสดงหน้าสมัครสมาชิกของระบบบันทึกค่าดัชนีมวลกาย | 55
3.41 แสดงหน้าเข้าสู่ระบบของระบบบันทึกค่าดัชนีมวลกาย | 56
3.42 แสดงหน้าหลักของระบบบันทึกค่าดัชนีมวลกาย | 57
3.43 แสดงหน้าแก้ไขข้อมูลส่วนตัวของระบบบันทึกค่าดัชนีมวลกาย | 57
3.44 แสดง ER-Diagram ของฐานข้อมูลในระบบบันทึกค่าดัชนีมวลกาย | 58
3.45 แสดง การสร้างตารางผู้ใช้ (users) ในฐานข้อมูลด้วย Spring Framwork | 61
3.46 แสดง การเขียนอินเตอร์เฟสกับตารางผู้ใช้ (users) ในฐานข้อมูลด้วย Spring Framwork | 62
3.47 แสดง การสร้างตารางข้อมูล (data) ในฐานข้อมูลด้วย Spring Framwork | 63
3.48 แสดง การเขียนอินเตอร์เฟสกับตารางข้อมูล (data) ในฐานข้อมูลด้วย Spring Framwork | 64
3.49 แสดง ฟังก์ชันการสมัครสมาชิก | 65
3.50 แสดง ฟังก์ชันการเข้าสู่ระบบ | 66
3.51 แสดง ฟังก์ชันการเข้าสู่ระบบ ของไมโครคอนโทรลเลอร์ | 67
3.52 แสดง ฟังก์ชันการแก้ไขข้อมูล | 68
3.53 แสดง ฟังก์ชันแสดงรายละเอียด | 69
3.54 แสดง ฟังก์ชันการบันทึกข้อมูล | 69
3.55 แสดง ฟังก์ชันการเรียกดูประวัติการใช้งาน | 70
4.1 เครื่องวัดค่าดัชนีมวลกาย | 72
4.2 หน้าจอแสดงผลเครื่องวัดค่าดัชนีมวลกาย | 73
4.3 การแจ้งเตือนเมื่อกรอกข้อมูลไม่ครบถ้วน | 83
4.4 การแจ้งเตือนเมื่อกรอกเบอร์โทรศัพท์และรหัสผ่านในรูปแบบที่ไม่ถูกต้อง | 84
4.5 การแจ้งเตือนเมื่อกรอกเบอร์โทรศัพท์ที่เคยลงทะเบียนแล้ว | 84
4.6 การแจ้งเตือนเมื่อเข้าสู่ระบบด้วยเบอร์โทรศัพท์ที่ไม่มีในระบบ | 85
4.7 การแจ้งเตือนเมื่อเข้าสู่ระบบด้วยรหัสผ่านที่ไม่ถูกต้อง | 86

ฑ

สารบัญรูป (ต่อ)

รูปที่ | หน้า
4.8 แสดงประวัติการใช้งานบนเว็บแอปพลิเคชัน | 86
4.9 การแจ้งเตือนเมื่อกรอกรหัสผ่านยืนยันไม่ถูกต้อง | 87
4.10 การแจ้งเตือนเมื่อกรอกรหัสผ่านยืนยันถูกต้อง | 87
ก.1 หน้ายินดีต้อนรับของเครื่องวัดค่าดัชนีมวลกาย | 84
ก.2 หน้า เมนู ของเครื่องวัดค่าดัชนีมวลกาย | 85
ก.3 หน้า เข้าสู่ระบบ ของเครื่องวัดค่าดัชนีมวลกาย | 86
ก.4 หน้า กรอกเบอร์โทรศัพท์ ของเครื่องวัดค่าดัชนีมวลกาย | 87
ก.5 หน้า กรอกรหัสผ่าน ของเครื่องวัดค่าดัชนีมวลกาย | 88
ก.6 หน้า เริ่มต้น ของเครื่องวัดค่าดัชนีมวลกาย | 89
ก.7 ท่าใช้งานเครื่องวัดค่าดัชนีมวลกาย | 90
ก.8 หน้า อ่านค่า ของเครื่องวัดค่าดัชนีมวลกาย | 92
ก.9 หน้า แสดงผล ของเครื่องวัดค่าดัชนีมวลกาย | 95
ก.10 หน้าแรก ของระบบบันทึกค่าดัชนีมวลกาย | 95
ก.11 หน้าสมัครสมาชิก ของระบบบันทึกค่าดัชนีมวลกาย | 96
ก.12 หน้าเข้าสู่ระบบ ของระบบบันทึกค่าดัชนีมวลกาย | 97
ก.13 หน้าหลัก ของระบบบันทึกค่าดัชนีมวลกาย | 97
ก.10 หน้าแรก ของระบบบันทึกค่าดัชนีมวลกาย | 136
ก.11 หน้าสมัครสมาชิก ของระบบบันทึกค่าดัชนีมวลกาย | 137
ก.12 หน้าเข้าสู่ระบบ ของระบบบันทึกค่าดัชนีมวลกาย | 137
ก.13 หน้าหลัก ของระบบบันทึกค่าดัชนีมวลกาย | 138

บทที่ 1
บทน า

### 1.1 ที่มาและความส าคัญ

ตั้งแต่อดีตจนถึงปัจจุบัน ข้อมูลทางด้านน้ าหนักและส่วนสูง มีความส าคัญเป็นอย่างมาก เนื่องด้วย ในทางการแพทย์นั้นได้น าข้อมูลเหล่านี้ไปค านวณหาค่าดัชนีมวลกาย (Body Mass Index : BMI) เพื่อใช้ในการประเมินผลทางด้านสุขภาพ ซึ่งทางการแพทย์จะน าค่าดัชนีมวลกาย ไปวิเคราะห์และ วินิจฉัยสุขภาพของคนไข้ โดยค่าดัชนีมวลกายนั้นเป็นตัวชี้วัดความเสี่ยงในการเกิดโรคต่าง ๆ เช่น โรค อ้วน โรคผอม การไม่สมส่วน หรือร่างกายไม่ได้มาตรฐานตามที่องค์กรการอนามัยโลกได้ก าหนดไว้ ดังนั้นอุปกรณ์ในการวัดน้ าหนักและส่วนสูง จึงมีความส าคัญเป็นอย่างมาก เพื่อให้ได้ค่าดัชนีมวลกาย ไปท าการประเมินภาวะความเสี่ยงต่อการเกิดโรคต่าง ๆ ที่อาจจะเกิดขึ้น เครื่องมือที่ใช้ในการวัดเพื่อหาค่าดัชนีมวลกายที่มีอยู่ในปัจจุบันสามารถท าได้หลายอย่าง ไม่ว่าจะ เป็นเครื่องค านวณดัชนีมวลกายที่สามารถชั่งน้ าหนักได้ แต่ผู้ใช้ต้องกรอกข้อมูลส่วนสูงเอง หรือบาง เครื่องสามารถชั่งทั้งน้ าหนักและวัดส่วนสูง เพื่อให้เครื่องท าการค านวณค่าดัชนีมวลกาย เมื่อมีการใช้ งาน เครื่องสามารถบอกน้ าหนัก ส่วนสูง ค านวณค่าดัชนีมวลกายจากเครื่อง และสามารถบอกว่า ผู้ใช้งานมีค่าดัชนีมวลกายอยู่ในเกณฑ์ใด โดยเครื่องวัดค่าดัชนีมวลกายหรือเครื่องชั่งน้ าหนักและวัด ส่วนสูงทั่ว ๆ ไปนั้นไม่สามารถเก็บประวัติการใช้งานในแต่ละครั้งได้ ถ้าหากผู้ใช้งานต้องการที่จะดูแล สุขภาพและติดตามการเปลี่ยนแปลงของร่างกายที่เกิดขึ้น ผู้ใช้งานจะต้องจดจ าประวัติการใช้งาน ของตน
ในปี พ.ศ. 2560 ได้มีผู้คิดค้นระบบค านวณค่าดัชนีมวลกายอัตโนมัติ ซึ่งจัดท าเป็นปริญญานิพนธ์ เป็นส่วนหนึ่งของการศึกษาตามหลักสูตรปริญญาวิศวกรรมศาสตรบัณฑิต สาขาวิชาวิศวกรรม คอมพิวเตอร์ คณะวิศวกรรมศาสตร์ มหาวิทยาลัยเทคโนโลยีราชมงคลอีสาน วิทยาเขตขอนแก่น มี เนื้อหาเกี่ยวกับการออกแบบระบบค านวณค่าดัชนีมวลกายอัตโนมัติ ที่สามารถบันทึกข้อมูลการใช้งาน ย้อนหลังได้ และได้สร้างต้นแบบเครื่องค านวณค่าดัชนีมวลกายอัตโนมัติขึ้นมา แต่เครื่องค านวณค่า ดัชนีมวลกายที่สร้างขึ้นมานั้นยังมีข้อบกพร่องในด้านการออกแบบลักษณะความสวยงามของเครื่อง ความคงทนของเครื่อง และเครื่องยังต้องเชื่อมต่อกับอินเทอร์เน็ตตลอดเวลาเพื่อที่จะให้สามารถบันทึก ข้อมูลการใช้งานไปที่ฐานข้อมูลได้

ด้วยเหตุผลดังที่กล่าวมา จึงท าให้เกิดความคิดที่จะพัฒนาเครื่องค านวณค่าดัชนีมวลกายอัตโนมัติ จากเครื่องต้นแบบเดิมที่มีอยู่ เพื่อให้สามารถชั่งน้ าหนัก วัดส่วนสูง ค านวณค่าดัชนีมวลกาย ปรับปรุง ลักษณะความสวยงามของเครื่องใหม่ ปรับปรุงคุณภาพของเครื่องให้มีความคงทน พร้อมทั้งยังเพิ่ม ระบบเสียงบอกขั้นตอนการท างานต่างๆของเครื่องด้วย นอกจากนี้ยังได้ท าการพัฒนาระบบฐานข้อมูล ของผู้ใช้งาน เพื่อบันทึกข้อมูลน้ าหนัก ส่วนสูง และค่าดัชนีมวลกาย เพื่อให้ผู้ใช้งานสามารถติดตามผล การเปลี่ยนแปลงของร่างกายได้อย่างต่อเนื่อง โดยการระบุตัวตนแต่ละบุคคลด้วยหมายเลข โทรศัพท์มือถือ ทั้งยังมองไปถึงอนาคตที่จะสามารถพัฒนาเครื่องโดยไม่ต้องเชื่อมต่อกับอินเทอร์เน็ต ทุกเครื่อง ในกรณีที่มีมากกว่าหนึ่งเครื่อง จึงเลือกใช้ไมโครคอนโทรลเลอร์ที่สามารถใช้คลื่นความถี่ แบบไร้สายส่งข้อมูลระหว่างกันได้ เพื่อที่จะให้ผู้ที่จะพัฒนาโครงงานต่อได้ศึกษาค้นคว้าและพัฒนา เครื่องมือต่อไปโดยยังคงรูปแบบเดิมไว้ได้

### 1.2 วัตถุประสงค์

1.2.1 เพื่อพัฒนาและออกแบบให้เครื่องสามารถชั่งน้ าหนัก วัดส่วนสูง และค านวณค่า ดัชนีมวลกาย
1.2.2 เพื่อพัฒนาและออกแบบให้เครื่องสามารถท างานกับระบบหน้าจอแบบสัมผัส
1.2.3 เพื่อพัฒนาระบบเสียงบอกขั้นตอนการใช้งานส าหรับตอบสนองกับผู้ใช้
1.2.4 เพื่อส่งข้อมูลประวัติการใช้งานผ่านเครือข่ายไร้สายไปยังเซิร์ฟเวอร์และบันทึก ลงในฐานข้อมูล
1.2.5 เพื่อเพิ่มความสะดวกส าหรับผู้ใช้งานในการติดตามดูข้อมูลย้อนหลังในรูปแ บบ เว็บแอปพลิเคชัน

### 1.3 ขอบเขตและข้อจ ากัดของปริญญานิพนธ์

1.3.1 สามารถค านวณค่าดัชนีมวลกายและน าค่าดัชนีมวลกายไปเปรียบเทียบเกณฑ์ได้อัตโนมัติ 1.3.2 สามารถส่งข้อมูลประวัติการใช้งานไปยังเซิร์ฟเวอร์แล้วบันทึกลงในฐานข้อมูล
1.3.3 สามารถเรียกดูข้อมูลการใช้งานย้อนหลังในรูปแบบเว็บแอปพลิเคชัน
1.3.4 เลือกใช้ไมโครคอนโทรลเลอร์ที่สามารถน าไปพัฒนาในเรื่องของการส่งสัญญาณไร้สายโดย ไม่ต้องเชื่อมต่ออินเทอร์เน็ต
1.3.5 ไมโครคอนโทรลเลอร์สามารถท างานร่วมกับหน้าจอสัมผัสและโมดูลเล่นเสียงในขั้นตอนการ ท างาน

### 1.4 ประโยชน์ที่คาดว่าจะได้รับ

1.4.1 ได้รับความรู้ในการออกแบบระบบการท างานของโปรแกรมควบคุมฮาร์ดแวร์อย่างเป็น ขั้นตอน
1.4.2 ได้น าความรู้ที่ได้ศึกษาทั้งในด้านฮาร์ดแวร์และซอฟต์แวร์มาประยุกต์ใช้ในการท างาน 1.4.3 ได้รับความรู้ในการออกแบบและใช้งานหน้าจอสัมผัสกับไมโครคอนโทรลเลอร์
1.4.4 มีความรู้ในการเขียนโปรแกรมเพื่อจัดการข้อมูลเพิ่มมากขึ้น

บทที่ 2
ทฤษฎีและงานวิจัยที่เกี่ยวข้อง

ในการจัดท าโครงงาน การออกแบบและพัฒนาเครื่องวัดค่าดัชนีมวลกาย ผู้จัดท าโครงงานได้ ศึกษาเอกสารจากเว็บไซต์ต่าง ๆ และงานวิจัยต่าง ๆ ที่ใช้ในการประกอบการด าเนินงาน ในที่นี้ผู้จัดท า ได้แบ่งเนื้อหาที่เกี่ยวกับการด าเนินงาน ดังต่อไปนี้
2.1 ทฤษฎีที่เกี่ยวข้อง
2.1.1 ค่าดัชนีมวลกาย
2.1.2 อุปกรณ์ที่เกี่ยวข้อง
2.1.3 ระบบฐานข้อมูล
2.1.4 Angular 8
2.1.5 Spring
2.1.6 ภาษาที่เกี่ยวข้อง
2.1.7 โปรแกรมที่เกี่ยวข้อง
2.2 งานวิจัยที่เกี่ยวข้อง
2.2.1 ออกแบบระบบค านวณค่าดัชนีมวลกายอัตโนมัติ
2.2.2 เครื่องชั่งน้ าหนัก วัดส่วนสูง NAGATA รุ่น BW-1122H
2.2.3 เครื่องชั่งน้ าหนัก Digital scales รุ่น scml
2.2.4 เครื่องชั่งน้ าหนัก วัดส่วนสูงอัตโนมัติADAM รุ่น MUW 300 2.2.5 เครื่องชั่งน้ าหนัก วัดส่วนสูงอัตโนมัติShengyuan รุ่น HGM-601

### 2.1 ทฤษฎีที่เกี่ยวข้อง

2.1.1 ค่าดัชนีมวลกาย
ค่าดัชนีมวลกาย (Body Mass Index) หรือค่า BMI คืออัตราส่วนระหว่างน้ าหนักต่อส่วนสูง ที่ใช้บ่งบอกว่าอ้วนหรือผอม ความส าคัญของการรู้ค่าดัชนีมวลกายเพื่อดูอัตราการเสี่ยงต่อการเกิดโรค ต่าง ๆ ถ้าค่าที่ค านวณได้มากหรือน้อยเกินไป เพราะถ้าเป็นโรคอ้วนแล้ว จะมีภาวะเสี่ยงต่อการเป็น โรคความดันโลหิตสูง โรคเบาหวาน โรคหัวใจขาดเลือด และโรคนิ่วในถุงน้ าดี แต่ในขณะเดียวกันผู้ที่ ผอมเกินไป ก็จะเสี่ยงต่อการติดเชื้อ ประสิทธิภาพในการท างานของร่างกายลดลง ดังนั้นควรรักษา ระดับน้ าหนักให้อยู่ในเกณฑ์ปกติ[1]

สูตรค านวณดัชนีมวลกายคือ ดัชนีมวลกาย = (น้ าหนักตัว(กิโลกรัม)) / (ความสูง(เมตร) ยกก าลังสอง)

ค่าดัชนีมวลกายเป็นตัวชี้วัดที่บ่งบอกบอกว่าร่างกายของเราอยู่ในเกณฑ์ไหน โดยเกณฑ์ของ การชี้วัดถูกแบ่งออกเป็น 4 ช่วง ดังต่อไปนี้
BMI น้อยกว่า 18.5 หมายถึง คุณมีน้ าหนักตัวที่ต่ ากว่าเกณฑ์มาตรฐาน
BMI อยู่ระหว่าง 18.5 ถึง 24.9 หมายถึง คุณมีน้ าหนักตัวที่อยู่ในเกณฑ์มาตรฐาน BMI อยู่ระหว่าง 25 ถึง 29.9 หมายถึง คุณเริ่มมีน้ าหนักตัวที่เกินมาตรฐานแล้วนะ BMI เกิน 30 หมายถึง ตอนนี้น้ าหนักตัวของคุณอยู่ในภาวะอ้วนรีบลดน้ าหนักโดย ด่วน
| แม้ว่าค่าดัชนีมวลกาย (Body Mass Index : BMI) จะเคยโด่งดังมากในยุคก่อน แต่ใน
ปัจจุบันค่าดัชนีมวลกาย เป็นเพียงดัชนีตัวหนึ่งที่สามารถบอกว่าเราอาจจะมีปัญหาเรื่องน้ าหนักตัว แบบคร่าว ๆ โดยไม่จ าเป็นต้องไปใช้เครื่องมือทางการแพทย์อื่น ๆ และทุกวันนี้มีเครื่องค านวณค่าดัชนี มวลกายมากมายที่ถูกสร้างขึ้นมา มีทั้งเครื่องที่เป็นแบบชั่งได้แค่เพียงน้ าหนักแล้วให้กรอกข้อมูล ส่วนสูงเพื่อค านวณค่าดัชนีมวลกายและเครื่องที่เป็นแบบชั่งน้ าหนักพร้อมกับวัดส่วนสูงแล้วค านวณค่า ดัชนีมวลกายออกมาให้อัตโนมัติ ซึ่งผู้จัดท าโครงงานนี้ได้น ามาเพื่อดูเป็นตัวอย่าง ดังรูปที่ 2.1


รูปที่ 2.1 เครื่องค านวณค่าดัชนีมวลกายแบบชั่งได้แค่น้ าหนักกับเครื่องที่ชั่งน้ าหนักและวัดส่วนสูงได้

2.1.2 อุปกรณ์ที่เกี่ยวข้อง
2.1.2.1 Heltec WiFi LoRa 32
Heltec WiFi LoRa 32 ห รือ NodeMCU (ESP32 + LoRa SX1278) เป็น ไมโครคอนโทรลเลอร์ที่ถูกพัฒนามาจาก (ESP32) โดยมีชิพของ (SX1278) หรือที่เรียกว่า (LoRa) ประกอบรวมเป็น (NodeMCU) ที่สามารถส่งสัญญาณวิทยุโดยใช้คลื่นความถี่ 433-470 MHz มี ระยะทางในการส่งคลื่นความถี่ได้ไกล มีประสิทธิภาพและความน่าเชื่อถือสูง [2]


รูปที่ 2.2 Heltec WiFi LoRa 32 หรือ NodeMCU (ESP32 + LoRa SX1278)

มีความสามารถทั้งการรับและการส่งข้อมูลเหมาะส าหรับน าไปพัฒนาโครงงานที่มี การสื่อสารระยะไกลโดยไม่ต้องใช้แพ็คเกจอินเตอร์เน็ต ระยะทางในการรับส่งข้อมูลนั้นโดยประมาณ อยู่ที่ระยะทาง 10 กิโลเมตร อีกทั้งไมโครคอนโทรลเลอร์ตัวนี้ยังรองรับการใช้งาน (WiFi) ด้วย

2.1.2.2 Load Cell (โหลดเซลล์)
Load Cell (โหลดเซลล์) อุปกรณ์อิเล็กทรอนิกส์ที่สามารถใช้ตรวจวัดแรงกลที่มา กระท ากับอุปกรณ์ โหลดเซลล์จะเป็นตัวแปลงค่าแรงกด หรือ แรงดึงให้เป็นสัญญาณทางไฟฟ้า โหลด เซลล์เหมาะส าหรับใช้ในการทดสอบคุณสมบัติทางกลของชิ้นงาน โดยโหลดเซลล์ถูกน าไปใช้ใน อุตสาหกรรมหลากหลายประเภท ได้แก่ การชั่งน้ าหนัก การทดสอบแรงกดของชิ้นงาน การทดสอบ ความแข็งแรงของชิ้นงาน การทดสอบการเข้ารูปชิ้นงาน เป็นต้น [3]


รูปที่ 2.3 Load Cell (โหลดเซลล์)

การท างานของโหลดเซลล์จะต้องอาศัยบอร์ด (HX711) ช่วยแปลงแรงที่กระท าต่อ โหลดเซลล์เป็นค่าน้ าหนักที่ท าการชั่งได้ โดยลักษณะโครงสร้างภายในของบอร์ด HX711 จะมีวงจร ก าหนดแรงดันคงที่ โดยจะใช้แรงดันตั้งแต่ 2.7 โวลต์ ถึง 5.5 โวลต์ เพื่อป้อนไปยังขา E+ และ E-ให้กับโหลดเซลล์ และวงจรรับสัญญาณจากโหลดเซลล์เข้าที่ขา INA+ และ INA- เพื่อส่งสัญญาณให้กับ วงจรขยาย (Input MUX) ที่อยู่ภายใน ตรงส่วนนี้จะเลือกอัตราขยายสัญญาณ (Gain) ได้ 3 ค่า คือ 32, 64 และ 128 เท่า จากนั้นจะท าการส่งสัญญาณไปที่วงจรแปลงสัญญาณ (ADC) เพื่อท าการแปลง สัญญาณจากสัญญาณอนาล็อก ไปเป็นสัญญาณดิจิตอล โดยจะมีสัญญาณดิจิตอลขนาด 24 บิต เมื่อ ท าการแปลงสัญญาณเสร็จสิ้น สัญญาณจะถูกส่งไปยังวงจร Digital Interface เพื่อท าการเชื่อมต่อ ข้อมูลกับไมโครคอนโทรลเลอร์ โดยจะมีสายสัญญาณทั้งหมด 2 สาย คือสายส าหรับการรับส่งข้อมูล ( DOUT) แ ล ะ ส า ย สั ญ ญ า ณ น า ฬิ ก า (PD_SCK) เ พื่ อใ ห้ จัง ห ว ะ ก า ร รั บ ส่ง ข้ อ มู ล ใ ห้ กั บ ไมโครคอนโทรลเลอร์


รูปที่ 2.4 แสดงบอร์ด (HX711)

2.1.2.3 Ultrasonic Sensor (HC-SR04)


รูปที่ 2.5 Ultrasonic Sensor (HC-SR04)

HC-SR04 เป็นโมดูลที่ใช้หลักการสะท้อนของคลื่นอัลตร้าโซนิกในการวัดระยะทาง โดยการส่งคลื่นอัลตร้าโซนิกไปกระทบกับวัตถุที่อยู่ข้างหน้าแล้วสะท้อนกลับมายังตัวรับ เมื่อรู้ ระยะเวลาในการเดินทางของคลื่นแล้วจึงสามารถน ามาค านวณเป็นระยะทางได้ ซึ่งโมดูล HC-SR04 จะวัดระยะทางได้ในช่วง 2 ถึง 500 ซม. มีความละเอียดอยู่ที่ 0.3 ซม. ใช้ไฟเลี้ยง +5V โดยโมดูล HC-SR04 จะมีขาสัญญาณ 2 ขา คือ Trigger และ Echo โดยขา Trigger จะเป็นตัวส่งสัญญาณออกไป และขา Echo จะท าหน้าที่รับสัญญาณ [4]


รูปที่ 2.6 การติดต่อระหว่างไมโครคอนโทรลเลอร์กับโมดูล HC-SR04 เพื่อวัดระยะทาง

เมื่อวัดความกว้างของสัญญาณพัลส์จากขา Echo ในหน่วยไมโครวินาที แล้วน าไป ค านวณเป็นระยะทางในหน่วยเซนติเมตรหรือนิ้วได้ดังนี้
ระยะทาง (เซนติเมตร) = (ระยะเวลาในหน่วยไมโครวินาที / 29) / 2
ระยะทาง (นิ้ว) = (ระยะเวลาในหน่วยไมโครวินาที / 74) / 2

2.1.2.4 Touch Screen (HMI TFT LCD Touch)
Touch Screen หรือหน้าจอแบบสัมผัส เป็นหน้าจอแสดงผลที่ใช้งานเป็นทั้งหน้า แสดงผลและหน้าจอควบคุม สามารถควบคุมได้โดยการสัมผัสหน้าจอและยังก าหนดรูปแบบหน้าจอที่ จะแสดงผลได้โดยใช้งานร่วมกับโปรแกรม (Nextion Editor) เป็นโปรแกรมส าหรับออกแบบหน้าจอ Touch Screen นั่นเอง ส าหรับหน้าจอสัมผัสนี้ถูกผลิตโดยบริษัท (Nextion) ที่ออกแบบการสื่อสาร ข้อมูลโดยใช้ (Serial Port) เมื่อเชื่อมต่อกับไมโครคอนโทรลเลอร์ ใช้ไฟเลี้ยงได้ทั้ง 3.3 V และ 5 V มี Socket mini SD Card เผื่อไว้ท า Data log และมีขั้วต่อส าหรับอัพโหลดโปรแกรม [5]


รูปที่ 2.7 Touch Screen (HMI TFT LCD Touch)

2.1.2.5 DFPlayer Mini
โมดูลเล่นไฟล์ MP3 ขนาดเล็ก รองรับการควบคุมผ่านไมโครคอนโทรลเลอร์ ผ่าน UART สามารถต่อออกล าโพงได้โดยตรง หรือสามารถน าไปต่อผ่านวงจรขยายด้วยขา DAC_R และ DAC_L ให้เอาต์พุตแบบสเตอริโอ ท างานที่แรงดัน 3.2 โวลต์ ถึง 5 โวลต์ และรองรับ Micro SD Card ความจุสูงสุด 32GB [6]


รูปที่ 2.8 DFPlayer Mini

2.1.2.6 Mini 298N
Mini 298N เป็นบอร์ดที่ใช้ส าหรับขับมอเตอร์ที่มีขนาดเล็ก ใช้ไฟเลี้ยง 2-10 โวลต์ สามารถขับมอเตอร์ได้ทั้งหมด 2 ช่องสัญญาณ โดยมีรูปแบบสัญญาณเป็น PWM ขับกระแส 1.5 แอมป์แบบต่อเนื่อง และขับกระแสสูงสุดได้2.5 แอมป์[7]


รูปที่ 2.9 Mini 298N

2.1.2.7 มอเตอร์เกียร์
มอเตอร์เกียร์ เป็นอุปกรณ์ส าหรับขับเคลื่อนโหลดที่ใช้เฟืองในการเพิ่มก าลังในการ ขับเคลื่อน ใช้งานร่วมกับบอร์ด Mini 298N ที่มีไว้ส าหรับขับมอเตอร์โดยตรง สามารถใช้งานร่วมกับ ไมโครคอนโทรลเลอร์ส าหรับควบคุมการหมุนและการสั่งให้หยุดท างานได้ แรงดันไฟฟ้าที่เหมาะสมคือ 3 โวลต์ ถึง 6 โวลต์[8]


รูปที่ 2.10 มอเตอร์เกียร์

2.1.2.8 เฟืองเดือย
อุปกรณ์ส าหรับขับเคลื่อนวัตถุที่เคลื่อนที่ด้วยการหมุนไปบนรางในทิศทางที่เป็น เส้นตรง สามารถใช้งานร่วมกับมอเตอร์และเคลื่อนที่ไปตามทิศทางของราง โดยเฟืองเดือยที่ใช้ มีฟัน ทั้งหมด 20 ร่อง [9]


รูปที่ 2.11 เฟืองเดือย

2.1.3 ระบบฐานข้อมูล


รูปที่ 2.12 แสดงสัญลักษณ์ระบบฐานข้อมูล

ฐานข้อมูล (Database) หมายถึง กลุ่มของข้อมูลที่มีความสัมพันธ์กัน น ามาเก็บรวบรวม เข้าไว้ด้วยกันอย่างมีระบบและข้อมูลที่ประกอบกันเป็นฐานข้อมูลนั้น ต้องตรงตามวัตถุประสงค์การใช้ งานขององค์กรด้วยเช่นกัน เช่น ในส านักงานก็รวบรวมข้อมูล ตั้งแต่หมายเลขโทรศัพท์ของผู้ที่มา ติดต่อจนถึงการเก็บเอกสารทุกอย่างของส านักงาน ซึ่งข้อมูลส่วนนี้จะมีส่วนที่สัมพันธ์กันและเป็นที่ ต้องการน าออกมาใช้ประโยชน์ต่อไปภายหลัง ข้อมูลนั้นอาจจะเกี่ยวกับบุคคล สิ่งของสถานที่ หรือ เหตุการณ์ใด ๆ ก็ได้ที่เราสนใจศึกษาหรืออาจได้มาจากการสังเกต การนับหรือการวัดก็เป็นได้ รวมทั้ง

ข้อมูลที่เป็นตัวเลข ข้อความ และรูปภาพต่าง ๆ ก็สามารถน ามาจัดเก็บเป็นฐานข้อมูลได้ และที่ส าคัญ ข้อมูลทุกอย่างต้องมีความสัมพันธ์กัน เพราะเราต้องการน ามาใช้ประโยชน์ต่อไปในอนาคต [10] 2.1.3.1 นิยามและค าศัพท์พื้นฐานเกี่ยวกับระบบฐานข้อมูล
1) บิต (bit) หมายถึง หน่วยของข้อมูลที่มีขนาดเล็กที่สุด
2) ไบต์ (Byte) หมายถึง หน่วยของข้อมูลที่เกิดจากการน าบิตมารวมกันเป็นตัว อักขระ (Character)
3) เขตข้อมูล (Field) หมายถึง หน่วยของข้อมูลที่ประกอบขึ้นจากตัวอักขระตั้งแต่ หนึ่งตัวขึ้นไปมารวมกันแล้ว ได้ความหมายของสิ่งใดสิ่งหนึ่ง เช่น ชื่อ ที่อยู่ เป็นต้น
4) ระเบียน (Record) หมายถึง หน่วยของข้อมูลที่เกิดจากการน าเอาเขตข้อมูล หลาย ๆ เขตข้อมูลมารวมกัน เพื่อเกิดเป็นข้อมูลเรื่องใดเรื่องหนึ่ง เช่น ข้อมูลนักศึกษา 1 ระเบียน (1 คน) จะประกอบด้วย รหัสประจ าตัวนักศึกษา 1 เขตข้อมูล ชื่อนักศึกษา 1 เขตข้อมูล ที่อยู่ 1 เขต ข้อมูล
5) แฟ้มข้อมูล (File) หมายถึง หน่วยของข้อมูลที่เกิดจากการน าข้อมูลหลาย ๆ ชนิดระเบียนที่เป็นเรื่องเดียวกันมารวมกัน เช่น แฟ้มข้อมูลนักศึกษา แฟ้มข้อมูลลูกค้า แฟ้มข้อมูล พนักงาน
6) เอนทิตี (Entity) หมายถึง ชื่อของสิ่งใดสิ่งหนึ่งซึ่ง ได้แก่ คน สถานที่ สิ่งของ การกระท าซึ่งต้องการจัดเก็บข้อมูลไว้ เช่น เอนทิตีลูกค้า เอนทิตีพนักงาน
7) แอททริบิวต์ (Attribute) หมายถึง ข้อมูลที่แสดงคุณสมบัติหรือคุณลักษณะของ เอนทีตีหรือความสัมพันธ์ใน อี-อาร์ไดอะแกรม ใช้สัญลักษณ์วงรีที่มีชื่อของ Attribute นั้นก ากับอยู่ ภายในแทนหนึ่ง Attribute และเชื่อมกับเอนทิตีที่มี Attribute นั้นด้วยเส้นตรง Attribute
8) ความสัมพันธ์ (Relationships) หมายถึง ความสัมพันธ์ระหว่างเอนทิตีอย่างเช่น ความสัมพันธ์ระหว่างเอนทิตีนักศึกษาและเอนทิตีคณะวิชา เป็นลักษณะว่านักศึกษาแต่ละคนเรียนอยู่ คณะวิชาใดคณะวิชาหนึ่ง ในการแสดงความสัมพันธ์ระหว่างเอนทิตี เราจะใช้หัวลูกศรเพื่อแสดง ความสัมพันธ์
2.1.3.2 ประโยชน์เมื่อจัดเก็บข้อมูลรวมเป็นฐานข้อมูล
1) สามารถลดความซ้ าซ้อนของข้อมูลได้
2) หลีกเลี่ยงความขัดแย้งของข้อมูล
3) สามารถใช้ข้อมูลร่วมกันได้
4) สามารถรักษาความถูกต้องเชื่อถือได้ของข้อมูล
5) สามารถก าหนดความเป็นมาตรฐานเดียวกันของข้อมูลได้
6) สามารถก าหนดระบบความปลอดภัยของข้อมูลได้

7) เกิดความเป็นอิสระของข้อมูล
2.1.3.3 รูปแบบของระบบฐานข้อมูล
1) ฐานข้อมูลเชิงสัมพันธ์ (Relational Database) เป็นการเก็บข้อมูลในรูปแบบที่ เป็นตาราง (Table) หรือเรียกว่า รีเลชัน (Relation) มีลักษณะเป็น 2 มิติ คือเป็นแถว (Row) และเป็น คอลัมน์ (Column) การเชื่อมโยงข้อมูลระหว่างตารางจะเชื่อมโยงโดยใช้แอตทริบิวต์ (Attribute) หรือ คอลัมน์ที่เหมือนกันทั้งสองตารางเป็นตัวเชื่อมโยงข้อมูล
2) ฐานข้อมูลแบบเครือข่าย (Network Database) ฐานข้อมูลแบบเครือข่าย จะ เป็นการรวมระเบียนต่าง ๆ และความสัมพันธ์ระหว่างระเบียนแต่ละต่างกับฐานข้อมูลเชิงสัมพันธ์คือ ในฐานข้อมูลเชิงสัมพันธ์จะแฝงความสัมพันธ์เอาไว้ โดยระเบียนที่มีความสัมพันธ์กัน จะต้องมีค่าของ ข้อมูลในแอตทริบิวต์หนึ่งเหมือนกัน แต่ในฐานข้อมูลแบบเครือข่าย จะแสดงความสัมพันธ์อย่างชัดเจน โดยแสดงไว้ในโครงสร้าง
3) ฐานข้อมูลแบบล าดับชั้น (Hierarchical Database) ฐานข้อมูลแบบล าดับชั้น เป็นโครงสร้างที่จัดเก็บข้อมูลในลักษณะความสัมพันธ์แบบ Parent-Child Relationship Type หรือ เป็นโครงสร้างรูปแบบต้นไม้ (Tree) ข้อมูลที่จัดเก็บในที่นี้ คือ ระเบียน (Record) ซึ่งประกอบด้วยค่า ของเขตข้อมูล (Field) ของเอนทิตี้หนึ่ง ๆ นั่นเอง ฐานข้อมูลแบบล าดับชั้นนี้คล้ายคลึงกับฐานข้อมูล แบบเครือข่าย ต่างกันที่ฐานข้อมูลแบบล าดับชั้นมีกฎเพิ่มขึ้นมาหนึ่งประการ คือในแต่ละกรอบจะมี ลูกศรวิ่งเข้าหาได้ไม่เกิน 1 หัวลูกศร

2.1.4 Angular 8


รูปที่2.13 แสดงสัญลักษณ์ ANGULAR

Angular คือ เฟรมเวิร์ก (framework) ส าหรับสร้างแอพลิเคชั่นในฝั่งไคลเอ็นในรูปแบบ ของ HTML, CSS และ JavaScript/TypeScript ซึ่ง TpyeScript จะถูก compile ไปเป็น JavaScript ที่ท างานบนฝั่ง Client ที่เราน าไปสร้าง Reactive Single Page Applications (SPA) ซึ่ง ก็คือทุก ๆ หน้าจะถูกโหลดมารวมอยู่ในหน้าเดียว การคลิ๊กเปลี่ยนหน้าหรือการคลิ๊กปุ่มต่าง ๆ จะท า

ให้เรารู้สึกเหมือนเป็น Desktop Application ที่ไม่มีการโหลดเปลี่ยนหน้า Angular เป็น Model-View-Controller (MCV) และยังเป็น Model-View-ViewModel (MVVM) อีกด้วย มีการเชื่อมการ ท างานระหว่าง JavaScript เข้ากับ DOM Element ของ HTML ใช้การท างาน client-side template สามารถสร้าง template ไปใส่ไว้ในที่ที่เราก าหนดไว้ได้ และเป็น 2-way data binding เพื่อ sync Model กับ View [11]

2.1.5 Spring


รูปที่ 2.14 แสดงสัญลักษณ์Spring Boot Framework

Spring Boot Framework เป็นเครื่องมือที่ท าให้ Developer สามารถใช้งาน Spring Framework ได้ง่ายและรวดเร็วและยังลดขั้นตอนการ configuration ด้วยวิธีการท า Auto Configuration ตัว Spring Boot ได้เพิ่ม Annotation ใหม่ ๆ เข้ามา การท างานของ Spring Boot ยังท างานอยู่บน Spring Framework แต่ท า Interface ให้สามารถใช้งานง่าย ๆ [12]

2.1.6 ภาษาที่เกี่ยวข้อง
2.1.6.1 TypeScript

รูปที่ 2.15 แสดงสัญลักษณ์ TypeScript

TypeScript เป็นภาษาโปรแกรมที่รวมความสามารถที่ ES2015 เองมีอยู่ สิ่งที่เพิ่ม ขึ้นมาคือสนับสนุน Type System รวมถึงคุณสมบัติอื่น ๆ ที่เพิ่มมากขึ้น เช่น Enum และ ความสามารถที่เพิ่มขึ้นของการโปรแกรมเชิงวัตถุ TypeScript นั้นเป็น transpiler เหมือน Babel นั่น หมายความว่าตัวแปลภาษาของ TypeScript จะแปลโค๊ดที่เราเขียนให้เป็น JavaScript อีกทีนึง จึง มั่นใจได้ว่าผลลัพธ์สุดท้ายจะสามารถใช้งานได้บนเว็บเบราเซอร์ทั่วไป [13]
1) ข้อดีของการใช้ TypeScript
- TypeScript ท าให้คุณใช้ JavaScript สมัยใหม่ได้ในปัจจุบัน ความสามารถ ของ ES2015 และอื่น ๆ ได้รวมไว้แล้วใน TypeScript
- ตัวแปรที่คุณประกาศแล้วใน TypeScript จะเปลี่ยนชนิดข้อมูลไม่ได้อีกต่อไป ข้อผิดพลาดในโปรแกรมคุณจะน้อยลงเพราะคุณไม่มีโอกาสพลาดในการใส่ข้อมูลผิดชนิดเป็นแน่
- TypeScript มีการตรวจสอบโค๊ดในช่วง compile time ท าให้คุณดักจับ ข้อผิดพลาดได้แต่ต้นไม่ปล่อยให้ข้อผิดพลาดไปโผล่ในตอนท างานจริง (runtime)
- IDE และ Text Editor ที่ดีเยี่ยมสนับสนุนให้คุณใช้งาน TypeScript ได้อย่าง สมบูรณ์

2.1.6.2 SQL


รูปที่ 2.16 แสดงสัญลักษณ์ SQL

SQL ย่อมาจาก structured query language คือ ภาษาที่ใช้ในการเขียน โปรแกรมเพื่อจัดการกับฐานข้อมูล นอกจากนี้แล้ว SQL ยังเป็นชื่อโปรแกรมฐานข้อมูลซึ่งโปรแกรม SQL เป็นโปรแกรมที่มีโครงสร้างภาษาที่เข้าใจง่าย ไม่ซับซ้อน มีประสิทธิภาพการท างานสูง ท างานที่ ซับซ้อนได้โดยใช้ค าสั่งเพียงไม่กี่ค าสั่งและภาษา SQL ยังเป็นมาตรฐานบนระบบฐานข้อมูลและเป็น ภาษาแบบระบบเปิด (open system) หมายถึงเราสามารถใช้ค าสั่ง SQL กับฐานข้อมูลใดก็ได้ แม้จะ เป็นระบบฐานข้อมูลที่แตกต่างกันจะได้ผลลัพธ์เหมือนกัน ท าให้เราเลือกใช้ฐานข้อมูลชนิดใดก็ได้[14]

1) การท างานของภาษา SQL
- Select query ใช้ส าหรับดึงข้อมูลที่ต้องการ
- Update query ใช้ส าหรับแก้ไขข้อมูล
- Insert query ใช้ส าหรับการเพิ่มข้อมูล
- Delete query ใช้ส าหรับลบข้อมูล
2) ประโยชน์ของภาษา SQL
- สร้างฐานข้อมูลและตาราง
- สนับสนุนการจัดการฐานข้อมูล ซึ่งประกอบไปด้วย การเพิ่ม การปรับปรุง และการลบข้อมูล
- สนับสนุนการเรียกใช้หรือค้นหาข้อมูล
3) ประเภทของค าสั่งภาษา SQL
- ภาษานิยามข้อมูล (Data Definition Language) เป็นค าสั่งที่ใช้ในการสร้าง ฐานข้อมูล
- ภาษาจัดการข้อมูล (Data Manipulation Language) เป็นค าสั่งที่ใช้ในการ เรียกใช้ เพิ่ม ลบ และเปลี่ยนแปลงข้อมูลในตาราง
- ภาษาควบคุมข้อมูล (Data Control Language) เป็นค าสั่งที่ใช้ในการ ก าหนดสิทธิการอนุญาตหรือยกเลิกการเข้าถึงฐานข้อมูล

2.1.6.3 Java
Java หรือ Java programming language คือภาษาโปรแกรมเชิงวัตถุ พัฒนาโดย เจมส์ กอสลิง และวิศวกรคนอื่น ๆ ที่บริษัท ซัน ไมโครซิสเต็มส์ ภาษานี้มีจุดประสงค์เพื่อใช้แทน ภาษาซีพลัสพลัส C++ โดยรูปแบบที่เพิ่มเติมขึ้นคล้ายกับภาษาอ็อบเจกต์ทีฟซี (Objective-C) แต่เดิม ภาษานี้เรียกว่า ภาษาโอ๊ก (Oak) ซึ่งตั้งชื่อตามต้นโอ๊กใกล้ที่ท างานของ เจมส์ กอสลิง แล้วภายหลังจึง เปลี่ยนไปใช้ชื่อ "จาวา" ซึ่งเป็นชื่อกาแฟแทน จุดเด่นของภาษา Java อยู่ที่ผู้เขียนโปรแกรมสามารถใช้ หลักการของ Object-Oriented Programming มาพัฒนาโปรแกรมของตนด้วย Java ได้[15]
1) ข้อดีของ ภาษา Java
ก) ภาษา Java เป็นภาษาที่สนับสนุนการเขียนโปรแกรมเชิงวัตถุแบบสมบูรณ์ ซึ่งเหมาะส าหรับพัฒนาระบบที่มีความซับซ้อน การพัฒนาโปรแกรมแบบวัตถุจะช่วยให้เราสามารถใช้ ค าหรือชื่อ ต่าง ๆ ที่มีอยู่ในระบบงานนั้นมาใช้ในการออกแบบโปรแกรมได้ ท าให้เข้าใจได้ง่ายขึ้น

ข) โปรแกรมที่เขียนขึ้นโดยใช้ภาษา Java จะมีความสามารถท างานได้ใน ระบบปฏิบัติการที่แตกต่างกัน ไม่จ าเป็นต้องดัดแปลงแก้ไขโปรแกรม เช่น หากเขียนโปรแกรมบน เครื่อง Sun โปรแกรมนั้นก็สามารถถูก compile และ run บนเครื่องพีซีธรรมดาได้
ค) ภาษาจาวามีการตรวจสอบข้อผิดพลาดทั้งตอน compile time และ runtime ท าให้ลดข้อผิดพลาดที่อาจเกิดขึ้นในโปรแกรม และช่วยให้ debug โปรแกรมได้ง่าย
ง) ภาษาจาวามีความซับซ้อนน้อยกว่าภาษา C++ เมื่อเปรียบเทียบ code ของ โปรแกรมที่เขียนขึ้นโดยภาษา Java กับ C++ พบว่า โปรแกรมที่เขียนโดยภาษา Java จะมีจ านวน code น้อยกว่าโปรแกรมที่เขียนโดยภาษา C++ ท าให้ใช้งานได้ง่ายกว่าและลดความผิดพลาดได้มาก ขึ้น
จ) ภาษาจาวาถูกออกแบบมาให้มีความปลอดภัยสูงตั้งแต่แรก ท าให้โปรแกรมที่ เขียนขึ้นด้วยจาวามีความปลอดภัยมากกว่าโปรแกรมที่เขียนขึ้น ด้วยภาษาอื่น เพราะ Java มี security ทั้ง low level และ high level ได้แก่ electronic signature, public andprivate key management, access control และ certificatesของ
ฉ) มี IDE, application server, และ library ต่าง ๆ มากมายส าหรับจาวาที่ เราสามารถใช้งานได้โดยไม่ต้องเสียค่าใช้จ่าย ท าให้เราสามารถลดค่าใช้จ่ายที่ต้องเสียไปกับการซื้อ tool และ s/w ต่าง ๆ
2) ข้อเสียของ ภาษา Java
ก) ท างานได้ช้ากว่า native code (โปรแกรมที่ compile ให้อยู่ในรูปของ ภาษาเครื่อง) หรือโปรแกรมที่เขียนขึ้นด้วยภาษาอื่น อย่างเช่น C หรือ C++ ทั้งนี้ก็เพราะว่าโปรแกรม ที่เขียนขึ้นด้วยภาษาจาวาจะถูกแปลงเป็นภาษากลาง ก่อน แล้วเมื่อโปรแกรมท างานค าสั่งของ ภาษากลางนี้จะถูกเปลี่ยนเป็นภาษาเครื่องอีก ทีหนึ่ง ทีล่ะค าสั่ง (หรือกลุ่มของค าสั่ง) ณ runtime ท า ให้ท างานช้ากว่า native code ซึ่งอยู่ในรูปของภาษาเครื่องแล้วตั้งแต่ compile โปรแกรมที่ต้องการ ความเร็วในการท างานจึงไม่นิยมเขียนด้วยจาวา
ข) tool ที่มีในการใช้พัฒนาโปรแกรมจาวามักไม่ค่อยเก่ง ท าให้หลายอย่าง โปรแกรมเมอร์จะต้องเป็นคนท าเอง ท าให้ต้องเสียเวลาท างานในส่วนที่ tool ท าไม่ได้ ถ้าเราดู tool ของ MS จะใช้งานได้ง่ายกว่า และพัฒนาได้เร็วกว่า (แต่เราต้องซื้อ tool ของ MS และก็ต้องรันบน platform ของ MS)

2.1.7 โปรแกรมที่เกี่ยวข้อง
2.1.7.1 Arduino IDE
Arduino IDE คือซอฟต์แวร์ที่ใช้ในการพัฒนางานส าหรับบอร์ด Arduino ในการ เขียนโปรแกรมและคอมไพล์ลงบอร์ด IDE ย่อมาจาก (Integrated Development Environment) คือ ส่วนเสริมของ ระบบการพัฒนาหรือตัวช่วยต่าง ๆ ที่จะคอยช่วยเหลือ Developer หรือช่วยเหลือ คนที่พัฒนา Application เพื่อเสริมให้เกิดความรวดเร็ว ถูกต้อง แม่นย า ตรวจสอบระบบที่จัดท าได้ ท าให้การพัฒนางานต่าง ๆ เร็วมากขึ้น [16]

2.1.7.2 IntelliJ IDEA
IntelliJ IDEA คือโปรแกรมที่ใช้ในเขียน Javaส าหรับการพัฒนาซอฟต์แวร์ คอมพิวเตอร์ มันได้รับการพัฒนาโดยJetBrains และเปิดตัวในเดือนมกราคม 2544 และเป็นหนึ่งใน Java IDEs แรกที่มีพร้อมด้วยการน าทางโค้ดขั้นสูงและความสามารถในการปรับโค้ดให้ใหม่ ในปี 2010 IntelliJ ได้รับการทดสอบด้วยคะแนนสูงสุดจากทั้งสี่ด้าน ของเครื่องมือการเขียนโปรแกรม Java : Eclipse , IntelliJ IDEA, NetBeansและJDeveloper ในเดือนธันวาคม 2014 Google ได้ ประกาศAndroid Studioเวอร์ชัน 1.0 ซึ่งเป็นโอเพ่นซอร์ส IDE ส าหรับแอพ Android โดยพัฒนาได้ จาก IntelliJ IDEA [17]

2.1.7.3 Visual Studio Code
Visual Studio Code หรือ VSCode (Vscode , 2561) เป็นโปรแกรม Code Editor ที่ใช้ในการแก้ไขและปรับแต่งโค้ด จากค่ายไมโครซอฟท์ มีการพัฒนาออกมาในรูปแบบของ OpenSource จึงสามารถน ามาใช้งานได้แบบฟรี ๆ ที่ต้องการความเป็นมืออาชีพ
ซึ่ง Visual Studio Code นั้น เหมาะส าหรับนักพัฒนาโปรแกรมที่ต้องการใช้งาน ข้ามแพลตฟอร์ม รองรับการใช้งานทั้งบน Windows, macOS และ Linux สนับสนุนทั้งภาษา JavaScript, TypeScript และ Node.js สามารถเชื่อมต่อกับ Git ได้ น ามาใช้งานได้ง่ายไม่ซับซ้อน มี เครื่องมือส่วนขยายต่าง ๆ ให้เลือกใช้อย่างมากมาย [18]

2.1.7.4 Circuit Wizard
Circuit Wizard เป็นโปรแกรมที่ใช้ออกแบบวงจรอิเล็กทรอนิกส์ต่าง ๆ และ สามารถแสดงผลการท างานของวงจรให้ด้วย ซึ่งภายในโปรแกรมจะมีอุปกรณ์ที่น่าสนใจคือ อุปกรณ์ที่ เสมือนกับอุปกรณ์จริง ที่ท าให้ผลของการจ าลองวงจรออกมาสวยงามมาก ซึ่งเป็นจุดเด่นของโปรแกรม

นี้ อธิบายเป็นขั้นเป็นตอนอย่างละเอียดให้ท าตามได้จริง ใช้งานง่ายไม่ยุ่งยากเหมาะส าหรับมือใหม่และ ผู้สนใจทั่วไป [19]

2.1.7.5 Nextion editor
Nextion editor คือโปรแกรมที่ใช้ออกแบบ nextion touch screen เป็นหน้าจอ ที่รองรับกับโปรแกรม Nextion editor หรือเรียกอีกอย่างว่า Nextion Display Nextion Display คือ HMI ส าหรับ Microcontroller และ Arduino โดยเฉพาะ ออกแบบมาให้ใช้งานง่าย แบบ HMI, เขียนกราฟฟิกในแบบHMI [20]

2.1.7.6 SketchUp
SketchUp เป็นโปรแกรมที่ใช้ในการออกแบบงาน 3 มิติ ที่มีประสิทธิภาพ ใช้งาน ง่าย เป็นโปรแกรมขนาดเล็กจึงท าให้การประมวลผลมีความรวดเร็ว คนส่วนใหญ่คิดว่าเดิมทีถูกสร้าง ขึ้นโดย Google แต่จริง ๆ แล้ว คือ บริษัท @last Software โดย Brad Schell และคณะ เป็นผู้ริเริ่ม ในการสร้างและพัฒนาโปรแกรม และได้เผยแพร่โปรแกรมนี้ในเดือนสิงหาคม ปี คศ.2000
ต่อมา บริษัท Google ได้พัฒนา Google Maps และ Google Earth ขึ้น และ ต้องการให้มีโมเดล 3 มิติ อยู่ใน Google Maps และ Google Earth จึงเห็นความส าคัญของโปรแกรม SketchUp และซื้อลิขสิทธิ์ ในปี ค.ศ.2006 และเปลี่ยนชื่อเป็น Google SketchUp ให้บริการดาวน์ โหลดโปรแกรมฟรีส าหรับทุกคน เมื่อวันที่ 14 ธันวาคม 2550
ในปี ค.ศ.2012 Google ประกาศขาย Sketchup ให้กับบริษัท TRIMBLE บริษัทนี้ เป็น ผู้สร้าง 3d street view ให้กับ Google ได้พัฒนาโปรแกรม Sketchup ส าหรับงานวิศวกรรม และธุรกิจ AEC มากขึ้น [21]

### 2.2 งานวิจัยที่เกี่ยวข้อง

2.2.1 กชกรณ์(2560) ได้ท าการออกแบบระบบค านวณค่าดัชนีมวลกายอัตโนมัติ ให้การท างาน ของระบบแบ่งออกเป็น 2 ส่วนใหญ่ ๆ คือส่วนที่ควบคุมการท างานทางด้านฮาร์ดแวร์ ซึ่งเป็นส่วนของ การชั่งน้ าหนัก, วัดส่วนสูง และค่าดัชนีมวลกายของผู้ใช้งาน อีกทั้งเป็นส่วนที่ผู้ใช้งานจะท าการ ลงทะเบียน เพื่อสมัครสมาชิก ส่วนที่ 2 คือส่วนการจัดการข้อมูลสมาชิกผ่านหน้าเว็บเบราว์เซอร์ เป็น ส่วนที่ผู้ใช้งานสามารถเรียกดูประวัติการชั่งน้ าหนัก, วัดส่วนสูง และค่าดัชนีมวลกายของผู้ใช้งาน ย้อนหลัง พร้อมทั้งจะแสดงค าแนะน าเพื่อให้ผู้ใช้งานสามารถควบคุมค่าดัชนีมวลกายให้อยู่ในเกณฑ์ ปกติ[22]

2.2.2 เครื่องชั่งน้ าหนัก วัดส่วนสูง NAGATA รุ่น BW-1122H ผลิตโดยบริษัท AP.DD SCALE (2560) เป็นเครื่องชั่งน้ าหนักที่ถูกแบบให้ท างานอัตโนมัติเฉพาะการชั่งน้ าหนักเท่านั้น ส่วนการวัด ส่วนสูงจ าเป็นต้องใช้ฉากวัดโดยการเลื่อนฉากวัดเอง และวัดค่าดัชนีมวลกายได้โดยการกรอกค่าส่วนสูง ที่วัดได้จากฉากวัด แสดงผลผ่านจอแสดงผล LDC [23]

2 .2 .3 เครื่องชั่งน้ าหนัก Digital scales รุ่น scml ผลิตโดยบ ริษัท KROTRON (2557) เป็นเครื่องชั่งน้ าหนักแบบหยอดเหรียญ ท างานโดยอัตโนมัติ แสดงค่าน้ าหนักผ่านจอแสดงผล LCD มี ตารางเปรียบเทียบค่าBMI โดยเปรียบเทียบกับส่วนสูงที่เราทราบ ซึ่งสามารถพบเห็นได้ตามซุปเปอร์ มาร์เก็ตทั่วไป [24]

2.2.4 เครื่องชั่งน้ าหนัก วัดส่วนสูงอัตโนมัติADAM รุ่น MUW 300L ผลิตโดยบริษัท Adam Equipment (2555) เป็นเครื่องชั่งน้ าหนัก วัดส่วนสูงอัตโนมัติ และค านวณค่าดัชนีมวลกายได้ อัตโนมัติ แสดงผลผ่านจอแสดงผล LCD มีKeypad ที่ใช้ในการกดเลือกฟังก์ชันต่าง ๆ [25]

2.2.5 เครื่องชั่งน้ าหนัก วัดส่วนสูงอัตโนมัติShengyuan รุ่น HGM-601 ผลิตโดยบริษัท Henan Shengyuan Industry (2558) เป็นเครื่องชั่งน้ าหนัก วัดส่วนสูง และค านวณค่าดัชนีมวลกายอัตโนมัติ แสดงผลผ่านจอแสดงผล LCD รวมทั้งการปริ้นกระดานสลิปขนาดเล็กที่สรุปค่าน้ าหนัก ส่วนสูง และ ค่าดัชนีมวลกาย พร้อมการพับเก็บและล้อเลื่อนที่ค่อนข้างสะดวกในการเก็บหลังจากที่ไม่ได้ใช้งาน [26]

บทที่ 3
วิธีด าเนินงาน

ในวิธีการด าเนินงานโครงงาน ออกแบบและพัฒนาเครื่องวัดค่าดัชนีมวลกาย ได้น าหลักการ ท างานของงานวิจัยที่เกี่ยวข้อง กชกรณ์(2560) มาศึกษาและได้ท าการออกแบบและพัฒนา โดยจะมี หัวข้อ ดังต่อไปนี้
3.1 การศึกษาและวิเคราะห์ระบบ
3.1.1 การวิเคราะห์ระบบเดิม
3.1.2 หลักการท างานของระบบเดิม
3.1.3 หลักการท างานของระบบใหม่
3.2 การออกแบบเครื่องวัดค่าดัชนีมวลกาย
3.2.1 ภาพรวมการท างานของเครื่องวัดค่าดัชนีมวลกาย
3.2.2 การเชื่อมต่ออุปกรณ์และโปรแกรมส าหรับควบคุมฮาร์ดแวร์ 3.2.3 การออกแบบวงจรส าหรับอุปกรณ์อิเล็กทรอนิกส์
3.2.4 การออกแบบหน้าจอสัมผัส (Touch Screen)
3.2.5 การออกแบบตัวเครื่อง
3.3 การออกแบบเว็บแอปพลิเคชัน
3.3.1 การวิเคราะห์ระบบ
3.3.2 ภาพรวมระบบ
3.3.3 การออกแบบหน้าจอ
3.4 การออกแบบฐานข้อมูล
3.4.1 การออกแบบตารางเก็บข้อมูล
3.4.2 การเขียนโปรแกรมเชื่อมต่อฐานข้อมูล
3.5 การออกแบบ API ด้วย Spring Framework 3.5.1 การออกแบบ API ส่วนของ ข้อมูลผู้ใช้งาน 3.5.2 การออกแบบ API ส่วนของ ประวัติการใช้งาน

### 3.1 การศึกษาและวิเคราะห์ระบบ

3.1.1 การวิเคราะห์ระบบเดิม
เครื่องวัดค่าดัชนีมวลกายนี้ ถูกออกแบบให้สามารถชั่งน้ าหนัก วัดความสูง และ แสดงค่า ดัชนีมวลกายได้แบบอัตโนมัติ โดยมีจุดเด่นตรงที่สามารถวัดความสูงได้ตั้งแต่ 50-200 cm และ สามารถชั่งน้ าหนักได้สูงถึง 200 กิโลกรัม หลักการคือ ผู้ใช้งานที่ต้องการชั่งน้ าหนัก วัดความสูง และ หาค่าดัชนีมวลกาย จะต้องขึ้นไปยืนอยู่บนแท่นโหลดเซลล์ และยืนอยู่ภายใต้กล่องเซนเซอร์ที่ติดไว้ โดยโหลดเซลล์ที่รับน้ าหนักจะแปลงค่าการถูกกด แปลงเป็นสัญญาณทางไฟฟ้า และส่งเข้า ไมโครคอนโทรลเลอร์เพื่อแปลงเป็นค่าน้ าหนัก ซึ่งมีหน่วยเป็น กิโลกรัม (Kg) และจะมีเซนเซอร์วัด ระยะทางอัลตร้าโซนิก HC-SRF04 ปล่อยคลื่นเสียงอัตโนมัติมายังผู้ใช้งาน โดยจะใช้การจับเวลาในการ เดินทางของคลื่นเสียง จากตัวส่งตกกระทบยังวัตถุ แล้วสะท้อนกลับมายังตัวรับแล้วน าค่าเวลามา ค านวณหาระยะทาง หรือความสูงของผู้ใช้งานมีหน่วยเป็น เซนติเมตร (cm) จากนั้นจะน าค่าน้ าหนัก และความสูง ของผู้ใช้งานที่ได้น าไปเปรียบเทียบกับ เกณฑ์ดัชนีมวลกาย (BMI) ของคนเอเชีย เมื่อได้ ค่าของน้ าหนัก, ความสูง และค่าดัชนีมวลกายของผู้ใช้งานแล้ว จะบันทึกข้อมูลทั้งหมดลงบน ฐานข้อมูล (Database) เพื่อช่วยให้ผู้ใช้งานสามารถติดตามผลการเปลี่ยนแปลงได้ โดยสามารถเรียกดู ข้อมูลผ่านหน้าเว็บเบราว์เซอร์ได้
3.1.2 หลักการท างานของระบบเดิม
จากการศึกษางานวิจัยที่ผ่านมา การท างานของระบบโดยรวมจะมีการใช้อัลตร้าโซนิก (Ultrasonic), โหลดเซลล์ (Load Cell), คีย์แพด (Keypad) ท าการส่งสัญญาณมาที่ NodeMCU เพื่อ ท าการประมวลผล และท าการส่งข้อมูลเพื่อเก็บลงบนฐานข้อมูล (Database) ผ่าน Access Point ซึ่ง เป็นตัวกลางในการรับ-ส่งข้อมูล ระหว่าง NodeMCU กับ Server โดย NodeMCU จะส่งค่าต่าง ๆ ไป ยัง Server โดยใช้โปรโตคอล HTTP ในการส่งข้อมูลเพื่อท าการเก็บข้อมูลลงในฐานข้อมูล และเมื่อมี การร้องขอจาก Web Server จะเป็นตัวกลางที่จะน าข้อมูลจากฐานข้อมูลออกมาแสดงบนเว็บ เบราว์เซอร์ของผู้ใช้โดยสามารถเรียกดูค่าที่บันทึกไว้ผ่านทางเว็บเบราว์เซอร์ (Web Browser) ได้ ซึ่ง จะแสดงบล็อกไดอะแกรมหลักการท างานของระบบเดิมตาม รูปที่ 3.1


รูปที่ 3.1 บล็อกไดอะแกรมหลักการท างานของระบบเดิม

3.1.3 หลักการท างานของระบบใหม่
ในการท างานของระบบจะเริ่มต้นด้วยการเลือกเมนูบนหน้าจอสัมผัส (Touch Screen) เมื่อถึงขั้นตอนการวัดค่า NodeMCU (Heltec WiFi LoRa 32) จะอ่านค่าจากโหลดเซลล์ (Load Cell) และ อัลตร้าโซนิก (Ultrasonic) เพื่อน าค่าที่ได้มาค านวณค่าดัชนีมวลกายแล้วแสดงผลการ ค านวณบนหน้าจอสัมผัส (Touch Screen) หากมีการกดปุ่มบันทึกค่าบนหน้าจอ NodeMCU (Heltec WiFi LoRa 32) จะส่งข้อมูลไปยัง API (Application Programming Interface) โดยใช้ โปรโตคอล HTTP แล้วท าการบันทึกข้อมูลไว้ในฐานข้อมูล และหากเราใช้งานเว็บแอปพลิเคชันจะ สามารถเรียกดูประวัติการใช้งานได้นอกจากนี้ NodeMCU (Heltec WiFi LoRa 32) ยังสามารถ สื่อสารข้อมูลแบบ LoRa ระหว่างกันและกันได้เป็นคุณสมบัติที่สามารถท าไปพัฒนาในอนาคตได้ หาก มีการผลิตเครื่องหรือพัฒนาเครื่องวัดค่าดัชนีมวลกายขึ้นมามากกว่า 1 เครื่อง ซึ่งจะแสดง บล็อกไดอะแกรมหลักการท างานของระบบใหม่ตาม รูปที่ 3.2

NodeMCU Heltec WiFi LoRa 32; Load Cell Ultrasonic; Touch Screen Display; Data Input; Serial Port; WiFi; Access Point; Client; API; Database; Server; HTTP; hibernate; Web Application; LoRa; Feature for Development; DFPlayer Mini

รูปที่ 3.2 บล็อกไดอะแกรมหลักการท างานของระบบใหม่

### 3.2 การออกแบบเครื่องวัดค่าดัชนีมวลกาย

3.2.1 ภาพรวมการท างานของเครื่องวัดค่าดัชนีมวลกาย
ในการท างานของเครื่องวัดค่าดัชนีมวลกายจะมีโปรแกรมที่ใช้ส าหรับการควบคุมการ ท างานในส่วนต่าง ๆ ที่มีในระบบของเครื่องวัดค่าดัชนีมวลกายโดยมีลูปการท างานหลัก ๆ ซึ่งจะแสดง Flow Chart การท างานของโปรแกรมโดยรวม ดังรูปที่ 3.3 และรูปที่ 3.4

เชื่อมต่ออินเทอร์เน็ต; เชื่อมต่ออินเทอร์เน็ตอีกครั้ง; รอรับการกดปุ่มบนหน้าจอ (หน้าเมนู); ส าเร็จ; ไม่ส าเร็จ; กดปุ่มเข้าสู่ระบบ; รอรับการกดปุ่มบนหน้าจอ (หน้าเข้าสู่ระบบ) การเข้าสู่ระบบ; ไม่กด, เข้าสู่ระบบส าเร็จ; กดปุ่มกรอกเบอร์โทรศัพท์; กรอกเบอร์โทรศัพท์; กดปุ่มกรอกรหัสผ ่าน; กรอกรหัสผ่าน; ไม่กด, กรอกส าเร็จ

รูปที่ 3.3 Flow Chart แสดงหลักการท างานของโปรแกรมที่ใช้ควบคุมเครื่องวัดค่าดัชนีมวลกาย

จากรูปที่ 3.3 เริ่มต้นโปรแกรมจะท าการตรวจสอบการเชื่อมต่ออินเทอร์เน็ต หากเชื่อมต่อ ไม่ส าเร็จโปรแกรมจะพยายามท าการเชื่อมต่ออีกครั้งจนส าเร็จ เมื่อเชื่อมต่อส าเร็จแล้วโปรแกรมจะรอ รับค่าเมื่อมีการกดปุ่มบนหน้าจอสัมผัสในหน้าเมนู ถ้าผู้ใช้กดปุ่มเข้าสู่ระบบโปรแกรมจะรอรับค่าการ กดปุ่มในหน้าเข้าสู่ระบบ หากกดช่องส าหรับกรอกเบอร์โทรศัพท์โปรแกรมจะท างานในส่วนของการ กรอกข้อมูลเบอร์โทรศัพท์เพื่อให้ผู้ใช้งานกรอกเบอร์โทรศัพท์จนครบแล้วกดตกลง หรือหากกดช่อง ส าหรับกรอกรหัสผ่านโปรแกรมจะท างานในส่วนการกรอกรหัสผ่านเพื่อให้ผู้ใช้งานกรอกรหัสผ่านจน ครบแล้วกดตกลง เมื่อกรอกข้อมูลครบแล้วผู้ใช้ท าการเข้าสู่ระบบจนส าเร็จโปรแกรมจะไปท างานใน ส่วนถัดไป ในจุดเชื่อมต่อที่ 1 ของ Flow Chart ดังรูปที่ 3.4

เข้าสู่ระบบส าเร็จ, กดปุ่มผู้ใช้ทั่วไป; รอรับการกดปุ่มเริ่มบนหน้าจอ (หน้าเริ่ม) การกดปุ่ม บันทึก, เสร็จสิ้น; กดปุ่มเริ่ม; มอเตอร์หมุนเพื่อเลื่อนฉากลง; สวิตช์ใต้ฉากโดนกด; อ่านค่าจากโหลดเซลล์, อัลตร้าโซนิก มาค านวณแล้วประมวลผล; จบการท างาน; เงื่อนไขถูกต้อง; เงื่อนไขไม่ถูกต้อง; ประมวลผลเสร็จ

รูปที่ 3.4 Flow Chart แสดงหลักการท างานของโปรแกรมที่ใช้ควบคุมเครื่องวัดค่าดัชนีมวลกาย (ต่อ)

จากรูปที่ 3.4 หากมีการกดปุ่มใช้งานผู้ใช้ทั่วไปหรือมีการเข้าสู่ระบบมาส าเร็จจากหน้าเข้าสู่ ระบบ โปรแกรมจะรอรับการกดปุ่ม เริ่ม ในหน้าเริ่ม หากมีการกดปุ่มโปรแกรมจะสั่งงานให้มอเตอร์

หมุนเพื่อเลื่อนฉากวัดส่วนสูงลงมาเรื่อย ๆ จะกระทั่งฉากเลื่อนมาโดรศีรษะแล้วท าให้สวิตช์ที่ติดตั้งอยู่ ใต้ฉากโดนกด เมื่อสวิตช์โดนกดโปรแกรมจะท าการอ่านค่าจากโหลดเซลล์และอัลตร้าโซนิกมาค านวณ จนเสร็จสิ้นแล้วแสดงผลทางหน้าจอ เมื่อผู้ใช้งานกดปุ่มบันทึกข้อมูลหรือกดปุ่มเสร็จสิ้นโปรแกรมจะ ออกนอกลูปแล้วจบการท างาน

3.2.2 การเชื่อมต่ออุปกรณ์และโปรแกรมส าหรับควบคุมฮาร์ดแวร์
ในการท างานของทั้งระบบจ าเป็นจะต้องมีการเชื่อมต่อสัญญาณของอุปกรณ์ต่าง ๆ เข้ากับ ไมโครคอนโทรลเลอร์เพื่อให้ไมโครคอนโทรลเลอร์สามารถอ่านค่า ประมวลผลและแสดงผลข้อมูลที่ ตรงตามความต้องการ ในหัวข้อนี้จะแสดงรายละเอียดการเชื่อมต่ออุปกรณ์ต่าง ๆ และหลักการเขียน โปรแกรมเพื่อควบคุมอุปกรณ์แต้ละชนิด มีดังนี้
3.2.2.1 การเชื่อมต่อโหลดเซลล์กับไมโครคอนโทรลเลอร์ ในการเชื่อมต่อโหลดเซลล์กับไมโครคอนโทรลเลอร์เพื่ออ่านค่าน้ าหนักจะอาศัย โมดูล HX711 ในการอ่านค่า โดยการต่อจะแสดงดังรูปที่ 3.5
1) การต่อโหลดเซลล์กับโมดูล HX711
E+ | ต่อกับ | E+
E- | ต่อกับ | E-
A- | ต่อกับ | A-
A+ | ต่อกับ | A+
2) การต่อโมดูล HX711 กับไมโครคอนโทรลเลอร์
VCC | ต่อกับ | 5V
GND | ต่อกับ | GND
DT | ต่อกับ | 13
SCK | ต่อกับ | 14


รูปที่ 3.5 การเชื่อมต่อโหลดเซลล์กับไมโครคอนโทรลเลอร์

3) โปรแกรมอ่านค่าจากโหลดเซลล์
ส าหรับโปรแกรมอ่านค่าจากโหลดเซลล์จะเรียกใช้ไลบรารี่ HX711 ก าหนดค่า DOUT ที่ขา 13 ค่า CLK ที่ขา 14 ค่า zero_factor เท่ากับ 120819 ค่า calibration_factor เท่ากับ 10740.00 และในฟังก์ชัน setup จะเซตค่าต่าง ๆ ที่ใช้ เมื่อมีการอ่านค่าจะเรียกใช้ฟังก์ชัน get_units_kg() เพื่ออ่านค่าน้ าหนักในหน่วยกิโลกรัม แสดงดังรูปที่ 3.6


รูปที่ 3.6 โปรแกรมการอ่านค่าจากโหลดเซลล์

3.2.2.2 การเชื่อมต่ออัลตร้าโซนิกกับไมโครคอนโทรลเลอร์ การเชื่อมต่ออัลตร้าโซนิกกับไมโครคอนโทรเลอร์ จะเชื่อมต่อโดยการใช้ขาต่าง ๆ แสดงดังรูปที่ 3.7 พร้อมทั้งใช้โปรแกรมในการอ่านค่าจากอัลตร้าโซนิก มีรายละเอียดดังต่อไปนี้
1) การต่ออัลตร้าโซนิกกับไมโครคอนโทรลเลอร์
Vcc | ต่อกับ | 5V
Gnd | ต่อกับ | GND
Trig | ต่อกับ | 2
Echo | ต่อกับ | 4


รูปที่ 3.7 การเชื่อมต่ออัลตร้าโซนิกกับไมโครคอนโทรลเลอร์

2) โปรแกรมอ่านค่าจากอัลตร้าโซนิก โปรแกรมอ่านค่าจากอัลตร้าโซนิกเริ่มจากการน าเข้าไลบรารี่ Ultrasonic จากนั้นก าหนดตัวแปร TRIG ให้ใช้ขา 2 ของไมโครคอนโทรลเลอร์และ ECHO ใช้ขา 4 ในส่วนลูปจะ เรียกใช้ Ranging(CM) ในการอ่านระยะทางในหน่วยเซนติเมตร แสดงดังรูปที่ 3.8


รูปที่ 3.8 โปรแกรมการอ่านค่าจากอัลตร้าโซนิก

3.2.2.3 การเชื่อมต่อหน้าจอสัมผัสกับไมโครคอนโทรลเลอร์ การเชื่อมต่อหน้าจอสัมผัสกับไมโครคอนโทรลเลอร์นั้นจะเป็นการสื่อสารแบบใช้ Serial Port เชื่อมต่อกับหน้าจอสัมผัส แสดงดังรูปที่ 3.9 โดยจะก าหนด Serial Port ที่จะเชื่อมต่อได้ ว่าใช้ขาไหน แสดงรายละเอียดดังต่อไปนี้
1) การต่อหน้าจอสัมผัสกับไมโครคอนโทรลเลอร์
VCC | ต่อกับ | 5V
GND | ต่อกับ | GND
RX | ต่อกับ | 16
TX | ต่อกับ | 22


รูปที่ 3.9 การเชื่อมต่อหน้าจอสัมผัสกับไมโครคอนโทรลเลอร์

2) โปรแกรมสื่อสารข้อมูลกับหน้าจอสัมผัส การสื่อสารข้อมูลกับหน้าจอสัมผัสนั้นมีทั้งการส่งและรับข้อมูล โดยโปรแกรม เริ่มต้นจากการน าเข้าไลบรารี่ Nextion จากนั้นในฟังก์ชัน setup จะก าหนดขาที่ใช้เชื่อมต่อแบบ Serial Port และในฟังก์ชัน loop จะแสดงตัวอย่าง การรออ่านค่าจากหน้าจอสัมผัสในบรรทัดที่ 11 การสั่งค าสั่งเปลี่ยนหน้าจอในบรรทัดที่ 12 และค าสั่งแสดลผลในบรรทัดที่ 13 แสดงดังรูปที่ 3.10


รูปที่ 3.10 โปรแกรมสื่อสารข้อมูลกับหน้าจอสัมผัส

3.2.2.4 การเชื่อมต่อโมดูลเล่นเสียงกับไมโครคอนโทรลเลอร์
โมดูลเล่นเสียง DFPlayer Mini สื่อสารกับไมโครคอนโทรลเลอร์โดยใช้ Serial Port ที่ก าหนดขาเอง แสดงดังรูปที่ 3.11 โดยการเชื่อมต่อจะมีรายละเอียดดังต่อไปนี้
1) การต่อโมดูลเล่นเสียงกับไมโครคอนโทรลเลอร์
VCC | ต่อกับ | 5V
GND | ต่อกับ | GND
RX | ต่อกับ | 17
TX | ต่อกับ | 21


รูปที่ 3.11 การเชื่อมต่อโมดูลเล่นเสียงกับไมโครคอนโทรลเลอร์

นอกจากจะต่อโมดูลเล่นเสียงกับไมโครคอนโทรลเลอร์แล้วยังต้องต่อตัว ต้านทานค่า 1K โอห์ม ค่อมระหว่างขา RX และ GND ของโมดูลเล่นเสียง พร้อมกับต่อเข้ากับ Speaker จากขา SPK_1 และ SPK_2 ด้วย
2) โปรแกรมควบคุมโมดูลเล่นเสียง
ในการควบการเล่นเสียงของโมดูล DFPlayer Mini ด้วยไมโครคอนโทรลเลอร์ จะเริ่มต้นจากการน้ าเข้าไลบรารี่ DFRobotDFPlayerMini จากนั้นก าหนดชื่อออบเจ็คของโมดูลและ

Serial Port ส่วนในฟังก์ชัน setup จะก าหนดขาของไมโครคอนโทรลเลอร์ที่จะใช้สื่อสารแบบ Serial Port และในฟังก์ชัน loop เป็นตัวอย่างการสั่งเล่นเสียง แสดงดังรูปที่ 3.12


รูปที่ 3.12 โปรแกรมควบคุมโมดูลเล่นเสียง

3.2.2.5 การเชื่อมต่อมอเตอร์กับไมโครคอนโทรลเลอร์ ในการเชื่อมต่อไมโครคอนโทรลเลอร์กับมอเตอร์จะอาศัยโมดูล Mini298N ในการ ขับมอเตอร์ แสดงดังรูปที่ 3.13 โดยการเชื่อมต่อขาต่าง ๆ มีรายละเอียดดังต่อไปนี้
1) การต่อโมดูล Mini298N กับไมโครคอนโทรลเลอร์
VCC | ต่อกับ | 5V
GND | ต่อกับ | GND
INT1 | ต่อกับ | 5
INT2 | ต่อกับ | 15
ในส่วนของการต่อมอเตอร์กับโมดูล Mini298N นั้น จะต่อที่ช่องสัญญาณขา ออก MOTOR-A เนื่องจากสัญญาณขาเข้าเป็น INT1 และ INT2


รูปที่ 3.13 การเชื่อมต่อมอเตอร์กับไมโครคอนโทรลเลอร์

2) โปรแกรมควบคุมมอเตอร์
ในการควบคุมมอเตอร์ให้หมุนตามที่ต้องการนั้น จะประกาศตัวแปรเพื่อระบุขา ของไมโครคอนโทรลเลอร์ที่เชื่อมต่อกับมอเตอร์ จากนั้นในฟังก์ชัน setup จ าก าหนดให้ขาที่ระบุเป็น สัญญาณขออกและในฟังก์ชัน loop จะเป็นตัวอย่างการสั่งให้มอเตอร์หมุน แสดงดังรูปที่ 3.14


รูปที่ 3.14 โปรแกรมควบคุมมอเตอร์

3.2.2.6 การเชื่อมต่อสวิตช์กับไมโครคอนโทรลเลอร์ การเชื่อมต่อสวิตช์กับไมโครคอนโทรลเลอร์เพื่ออ่านค่าสัญญาณขาเข้าจากสวิตช์ นั้นจะต่อแบบคร่อม GND ให้สวิตช์คั่นระหว่าง GND และช่องสัญญาณขาเข้าของไมโครคอนโทรลเลอร์ แสดงดังรูปที่ 3.15
1) การต่อสวิตช์กับไมโครคอนโทรลเลอร์
switch_up | ต่อกับ | 23
switch_do | ต่อกับ | 18

switch_up; switch_do

รูปที่ 3.15 การเชื่อมต่อสวิตช์กับไมโครคอนโทรลเลอร์

2) โปรแกรมอ่านค่าจากสวิตช์
ในการอ่านค่าจากสวิตช์นั้นจะก าหนดตัวแปรเพื่อท าการเชื่อมต่อเข้ากับขาของ ไมโครคอนโทรลเลอร์ จากนั้นในฟังก์ชัน setup จะก าหนดให้โหมดให้เป็น INPUT_PULLUP เพื่อให้ ไมโครคอนโทรลเลอร์อ่านสัญญาณเป็น HIGH ตลอด จนกว่าจะมีการกดสวิตช์ค่อยจะอ่านสัญญาณ จาก GND เป็น LOW และในฟังก์ชัน loop จะเป็นการอ่านค่าจากสวิตช์ แสดงดังรูปที่ 3.16


รูปที่ 3.16 โปรแกรมอ่านค่าสวิตช์

3.2.3 การออกแบบวงจรส าหรับอุปกรณ์อิเล็กทรอนิกส์ เมื่อมีการทดสอบเชื่อมต่ออุปกรณ์ต่าง ๆ เข้ากับไมโครคอนโทรลเลอร์แล้ว จากนั้นก็เขียน โปรแกรมควบคุมอุปกรณ์และทดสอบจนโปรแกรมและอุปกรณ์ฮาร์ดแวร์ท างานสอดคล้องกันมาก ที่สุด แต่ในการเชื่อมต่ออุปกรณ์หลาย ๆ ตัวเข้าด้วยกันจ าเป็นต้องมีการโยงสายไฟจ านวนมาก ท าดูไม่ เป็นระเบียบและดูไม่สวยงาม จึงได้ออกแบบลายวงจรอิเล็กทรอนิกส์ไว้ส าหรับติดตั้งอุปกรณ์ทุก ๆ ตัว ไว้ในบอร์ดแผ่นเดียว โดยจุดสีน้ าเงินที่เป็นวงกลมเป็นจุดส าหรับเสียบขาอุปกรณ์อิเล็กทรอนิกส์แต่ละ ตัว จุดสีแดงที่เป็นสี่เหลี่ยมเป็นจุดส าหรับใช้สายไฟเชื่อมโยงข้ามลายวงจร เนื่องจากการลากวงจรมีจุด ที่เส้นทองแดงข้ามไปหากันไม่ได้ เส้นสีแดงหมายถึงเส้นทองแดงที่เชื่อมต่ออุปกรณ์แต่ละตัวเข้าหากัน และเส้นสีเขียวหมายถึงสายไฟที่ใช้ส าหรับโยงข้ามลายวงจร แสดงดังรูปที่ 3.17


รูปที่ 3.17 ลายวงจรอิเล็กทรอนิกส์

3.2.4 การออกแบบหน้าจอสัมผัส (Touch Screen) ในระบบของเครื่องวัดค่าดัชนีมวลกายนั้นเรียกได้ว่าใช้การควบคุมจากหน้าจอสัมผัสเป็น ส่วนมากทั้งการกดปุ่มต่าง ๆ และแสดงผลข้อมูล จึงได้ออกแบบหน้าจอให้มีความเหมาะสมต่อการใช้ งาน โดยใช้โปรแกรม Nextion Editor ในการออกแบบ ซึ่งรายละเอียดของจอในหน้าต่าง ๆ มีดังนี้ 3.2.4.1 หน้าจอยินดีต้อนรับ (welcome)
ในหน้าจอ “ยินดีต้อนรับ” จะแสดงข้อความบอกผู้ใช้งานว่า “แตะเพื่อใช้งาน” และแสดงรูปภาพมือที่มีนิ้วชี้แตะบนหน้าจอ เมื่อผู้ใช้งานท าการแตะที่หน้าจอสัมผัสแล้ว หน้าจอสัมผัส จะเปลี่ยนไปยังหน้า “เมนู” ตามรูปที่ 3.19 แสดงภาพประกอบหน้าจอสัมผัสในหน้า “ยินดีต้อนรับ” ดังรูปที่ 3.18


รูปที่ 3.18 แสดงหน้า “ยินดีต้อนรับ” บนหน้าจอสัมผัส

3.2.4.2 หน้าจอเมนู (menu)
ในหน้า “เมนู” เป็นหน้าส าหรับเลือกเมนูว่าจะใช้งานเครื่องวัดค่าดัชนีมวลกายใน ฐานะผู้ใช้ทั่วไปหรือสมาชิก โดยจะแสดงผลเป็นปุ่มกดค าว่า “ผู้ใช้ทั่วไป” และอีกปุ่มเป็นค าว่า “เข้าสู่ ระบบ”และในกรณีที่ยังไม่ได้เป็นสมาชิก จะแสดงข้อความว่า “สแกนเพื่อสมัครสมาชิก” อยู่บนคิว อาร์โค้ดที่สามารถเชื่อมโยงกับเว็บแอปพลิเคชัน ระบบบันทึกค่าดัชนีมวลกาย และด้านล่างของคิวอาร์ โค้ดจะแสดงข้อความเป็น URL ของ “www.ecpbmi.in.th” เพื่อไปยังระบบบันทึกค่าดัชนีมวลกาย เช่นเดียวกัน ในกรณีที่เข้าเว็บไชต์โดยไม่ได้สแกนคิวอาร์โค้ด แสดงดังรูปที่ 3.19


รูปที่ 3.19 แสดงหน้า “เมนู” บนหน้าจอสัมผัส

3.2.4.3 หน้าจอเริ่มต้น (start)
เมื่อมีการกดปุ่ม “ผู้ใช้ทั่วไป” บนหน้าเมนู หน้าจอสัมผัสจะถูกเปลี่ยนมายังหน้า เริ่มต้น หรือเมื่อมีการเข้าสู่ระบบส าเร็จก็จะมายังหน้าเริ่มต้นนี้เหมือนกัน โดยการออกแบบจะเป็น ปุ่มกดรูปทรงวงกลมที่มีข้อความค าว่า “เริ่ม” แสดงอยู่ส าหรับให้ผู้ใช้งานกดปุ่มเริ่มเพื่อท าการวัดค่า บนเครื่องวัดค่าดัชนีมวลกาย และมีปุ่มกลับสู่หน้าหลักที่แสดงข้อความค าว่า “หน้าแรก” อยู่ด้านล่าง ปุ่ม “เริ่ม” แสดงดังรูปที่ 3.20


รูปที่ 3.20 แสดงหน้า “เริ่มต้น” บนหน้าจอสัมผัส

3.2.4.4 หน้าจอเข้าสู่ระบบ (login)
เมื่อมีการกดปุ่ม “เข้าสู่ระบบ” บนหน้าเมนู หน้าจอสัมผัสจะถูกเปลี่ยนมายังหน้า เข้าสู่ระบบ เพื่อรอการกรอกข้อมูลหมายเลขโทรศัพท์และรหัสผ่านในการเข้าสู่ระบบ โดยการ ออกแบบหน้าจอสัมผัสจะแสดงข้อความว่า “หมายเลขโทรศัพท์” บนช่องแสดงผลหมายเลขโทรศัพท์ และค าว่า “รหัสผ่าน” บนช่องแสดงผลรหัสผ่าน จากนั้นจะมีปุ่ม “เข้าสู่ระบบ” เพื่อกดเข้าสู่ระบบ และปุ่ม “ย้อนกลับ” เพื่อย้อนกลับไปยังหน้าเมนู แสดงดังรูปที่ 3.21


รูปที่ 3.21 แสดงหน้า “เข้าสู่ระบบ” บนหน้าจอสัมผัส

3.2.4.5 หน้าจอกรอกหมายเลขโทรศัพท์ (input_username)
ในหน้าจอ “กรอกหมายเลขโทรศัพท์” การออกแบบหน้าจอสัมผัสจะแสดง ข้อความว่า “หมายเลขโทรศัพท์” บนช่องแสดงผลหมายเลขโทรศัพท์ และจะมีปุ่มกดหมายเลขตั้งแต่ เลข 0 ถึง เลข 9 พร้อมกับปุ่มแก้ไขข้อมูลและปุ่มตกลง เมื่อมีการกดตัวเลขหน้าจอจะแสดงผลตัวเลขที่ กด ขึ้นมาบนช่องแสดงผล หากมีการกดปุ่ม “แก้ไข” จะล้างข้อมูลทั้งหมดออกไปเพื่อให้กรอกข้อมูล ใหม่ และกดปุ่ม “ตกลง” เพื่อยืนยัน แสดงดังรูปที่ 3.22


รูปที่ 3.22 แสดงหน้า “กรอกหมายเลขโทรศัพท์” บนหน้าจอสัมผัส

3.2.4.6 หน้าจอกรอกรหัสผ่าน (input_password)
ในหน้าจอ “กรอกรหัสผ่าน” การออกแบบหน้าจอสัมผัสจะแสดงข้อความว่า “รหัสผ่าน” บนช่องแสดงผลรหัสผ่าน และจะมีปุ่มกดหมายเลขตั้งแต่เลข 0 ถึง เลข 9 พร้อมกับปุ่ม แก้ไขข้อมูลและปุ่มตกลง เมื่อมีการกดตัวเลขหน้าจอจะแสดงผลตัวเลขที่กด ขึ้นมาบนช่องแสดงผล หากมีการกดปุ่ม “แก้ไข” จะล้างข้อมูลทั้งหมดออกไปเพื่อให้กรอกข้อมูลใหม่ และกดปุ่ม “ตกลง” เพื่อยืนยัน แสดงดังรูปที่ 3.23


รูปที่ 3.23 แสดงหน้า “กรอกรหัสผ่าน” บนหน้าจอสัมผัส

3.2.4.7 หน้าจอก าลังเข้าสู่ระบบ (onlogin)
เมื่อมีการกดปุ่ม เข้าสู่ระบบ บนหน้าเข้าสู่ระบบ หน้าจอสัมผัสจะแสดงหน้า ก าลัง เข้าสู่ระบบ เป็นหน้าจอที่มีข้อความบอกเป็นค าว่า “ก าลังเข้าสู่ระบบ” และมีไอคอนเป็นรูปภาพที่มี ลักษณะเหมือนการหมุน แสดงดังรูปที่ 3.24


รูปที่ 3.24 แสดงหน้า “ก าลังเข้าสู่ระบบ” บนหน้าจอสัมผัส

3.2.4.8 หน้าจอไม่มีผู้ใช้ในระบบ (status_nouser) หลังจากระบบตรวจสอบข้อมูลชื่อผู้ใช้และรหัสผ่าน หากไม่เจอข้อมูลชื่อผู้ใช้ใน ฐานข้อมูล หน้าจอสัมผัสจะแสดงหน้า “ไม่มีผู้ใช้ในระบบ” โดยการออกแบบหน้าจอนี้จะแสดง ข้อความว่า “ไม่มีผู้ใช้ในระบบ” มีไอคอนรูปคนและแว่นขยายที่มีเครื่องหมายค าถาม บ่งบอกว่าหา บุคคลไม่เจอ และมีปุ่มกด “ย้อนกลับ” เพื่อกดกลับไปหน้าเข้าสู่ระบบ แสดงดังรูปที่ 3.25


รูปที่ 3.25 แสดงหน้า “ไม่มีผู้ใช้ในระบบ” บนหน้าจอสัมผัส

3.2.4.9 หน้าจอรหัสผ่านไม่ถูกต้อง (status_nopass) หลังจากระบบตรวจสอบข้อมูลชื่อผู้ใช้และรหัสผ่าน หากเจอข้อมูลชื่อผู้ใช้ใน ฐานข้อมูล แต่ตรวจสอบไม่เจอรหัสผ่าน หน้าจอสัมผัสจะแสดงหน้า “รหัสผ่านไม่ถูกต้อง” โดยการ ออกแบบหน้าจอนี้จะแสดงข้อความว่า “รหัสผ่านไม่ถูกต้อง” มีไอคอนรูปวงกลมมีกากบาทอยู่ตรง กลาง บ่งบอกว่ามีความผิดพลาด และมีปุ่มกด “ย้อนกลับ” เพื่อกดกลับไปหน้าเข้าสู่ระบบ แสดงดัง รูปที่ 3.26


รูปที่ 3.26 แสดงหน้า “รหัสผ่านไม่ถูกต้อง” บนหน้าจอสัมผัส

3.2.4.10 หน้าจอฐานข้อมูลยังไม่เปิดให้บริการ (status_noapi) เมื่อมีการกด เข้าสู่ระบบ แล้วระบบไม่สามารถเรียกไปยัง API ได้ หน้าจอสัมผัส จะแสดงหน้า “ฐานข้อมูลยังไม่เปิดให้บริการ” โดยการออกแบบหน้าจอนี้จะแสดงข้อความว่า “ระบบ ฐานข้อมูลยังไม่เปิดให้บริการ” มีไอคอนรูปฐานข้อมูลและเครื่องหมายเตือน บ่งบอกว่ามีความ ผิดพลาด และมีปุ่มกด “ย้อนกลับ” เพื่อกดกลับไปหน้าเข้าสู่ระบบ แสดงดังรูปที่ 3.27


รูปที่ 3.27 แสดงหน้า “ฐานข้อมูลยังไม่เปิดให้บริการ” บนหน้าจอสัมผัส

3.2.4.11 หน้าจอค านวณ (calculate) เมื่อมีการกดปุ่มเริ่มต้นจากหน้า เริ่มต้น หน้าจอสัมผัสจะมายังหน้า ค านวณ ใน หน้านี้การออกแบบหน้าจอจอมีช่องแสดงผลข้อมูล 2 ช่อง คือช่องแสดงค่าน้ าหนักที่อ่านได้จากโหลด เซลล์ และบนช่องแสดงค่าน้ าหนักจะมีข้อความบอกว่า “น้ าหนัก” เพื่อบ่งบอกว่าช่องนี้แสดงผลเป็น ตัวเลขของค่าน้ าหนักที่อ่านได้ และมีช่องแสดงค่าส่วนสูงที่อ่านได้จากอัลตร้าโซนิก และบนช่องแสดง ค่าส่วนสูงจะมีข้อความบอกว่า “ส่วนสูง” เพื่อบ่งบอกว่าช่องนี้แสดงผลเป็นตัวเลขของค่าส่วนสูงที่ อ่านได้ แสดงดังรูปที่ 3.28


รูปที่ 3.28 แสดงหน้า “ค านวณ” บนหน้าจอสัมผัส

3.2.4.12 หน้าจอแสดงข้อมูลของผู้ใช้ทั่วไป (nouser_show) เมื่อมีการชั่งน้ าหนักและวัดส่วนสูงในหน้าค านวณเสร็จแล้ว จะสรุปข้อมูลทั้งหมด ที่วัดได้ พร้อมทั้งแสดงค่าดัชนีมวลกายและเกณฑ์ที่วัดได้ โดยจะมีช่องแสดงผลข้อมูลจ านวน 4 ช่อง คือช่อง น้ าหนัก ส่วนสูง BMI และเกณฑ์ โดยเกณฑ์ต่าง ๆ จะแบ่งออกเป็นตัวเลขคือ 1 2 3 และ 4 บ่ง บอกว่าเกณฑ์ 1 คือ ผอม เกณฑ์ 2 คือ ปกติ เกณฑ์ 3 คือ อ้วน และเกณฑ์ 4 คืออ้วนมาก ส่วนล่างสุด ของหน้าจอสัมผัสจะเป็นปุ่มกด “เสร็จสิ้น” เพื่อสิ้นสุดการท างาน แสดงดังรูปที่ 3.29


รูปที่ 3.29 แสดงหน้า “แสดงข้อมูลของผู้ใช้ทั่วไป” บนหน้าจอสัมผัส

3.2.4.13 หน้าจอแสดงข้อมูลของสมาชิก (user_show) เมื่อมีการชั่งน้ าหนักและวัดส่วนสูงในหน้าค านวณเสร็จแล้ว จะสรุปข้อมูลทั้งหมด ที่วัดได้ พร้อมทั้งแสดงค่าดัชนีมวลกายและเกณฑ์ที่วัดได้ โดยจะมีช่องแสดงผลข้อมูลจ านวน 4 ช่อง คือช่อง น้ าหนัก ส่วนสูง BMI และเกณฑ์ โดยเกณฑ์ต่าง ๆ จะแบ่งออกเป็นตัวเลขคือ 1 2 3 และ 4 บ่ง บอกว่าเกณฑ์ 1 คือ ผอม เกณฑ์ 2 คือ ปกติ เกณฑ์ 3 คือ อ้วน และเกณฑ์ 4 คืออ้วนมาก ส่วนล่างสุด ของหน้าจอสัมผัสจะเป็นปุ่มกด “เสร็จสิ้น” เพื่อสิ้นสุดการท างาน และปุ่มบันทึกส าหรับบันทึกข้อมูล ไปยังฐานข้อมูล แสดงดังรูปที่ 3.30


รูปที่ 3.30 แสดงหน้า “แสดงข้อมูลของสมาชิก” บนหน้าจอสัมผัส

3.2.4.14 หน้าจอก าลังบันทึกข้อมูล (onsave)
เมื่อมีการกดปุ่ม บันทึก บนหน้าแสดงข้อมูลสมาชิก หน้าจอสัมผัสจะแสดงหน้า ก าลังบันทึกข้อมูล เป็นหน้าจอที่มีข้อความบอกเป็นค าว่า “ก าลังบันทึกข้อมูล” และมีไอคอนเป็น รูปภาพที่มีลักษณะเหมือนการหมุน แสดงดังรูปที่ 3.31


รูปที่ 3.31 แสดงหน้า “ก าลังบันทึกข้อมูล” บนหน้าจอสัมผัส

3.2.4.15 หน้าจอบันทึกข้อมูลเสร็จสิ้น (save_success) หากท าการบันทึกข้อมูลลงไปในฐานข้อมูลส าเร็จ หน้าจอสัมผัสจะแสดงหน้า บันทึกข้อมูลเสร็จสิ้น โดยหน้าจอจะแสดงเป็นข้อความที่มีค าว่า “บันทึกข้อมูลเสร็จสิ้น” พร้อมกับ ไอคอนที่เป็นรูปเครื่องหมาย ถูกต้อง และมีปุ่มกด “ตกลง” เพื่อสิ้นสุดการท างาน แสดงดังรูปที่ 3.32


รูปที่ 3.32 แสดงหน้า “บันทึกข้อมูลเสร็จสิ้น” บนหน้าจอสัมผัส

3.2.4.16 หน้าจอก าลังเชื่อมต่ออินเทอร์เน็ต (connected)
หน้า ก าลังเชื่อมต่ออินเทอร์เน็ต เป็นแสดงข้อความว่า “ก าลังเชื่อมต่อ อินเทอร์เน็ต” พร้อมไอคอนประกอบเป็นรูปสัญญาณ โดยหน้านี้จะแสดงเมื่อเริ่มต้นการเปิดเครื่องวัด ค่าดัชนีมวลกายและเมื่ออินเทอร์เน็ตขาดการเชื่อมต่อระหว่างการท างาน แสดงดังรูปที่ 3.33


รูปที่ 3.33 แสดงหน้า “ก าลังเชื่อมต่ออินเทอร์เน็ต” บนหน้าจอสัมผัส

3.2.4.17 หน้าจอกรุณาใส่ SD Card (sdcard) หน้ากรุณาใส่ SD Card เป็นหน้าที่จะแสดงเมื่อเปิดเครื่องวัดค่าดัชนีมวลกายแล้ว ไม่ได้ใส่ SD Card เข้าไปในโมดูลเล่นเสียง โดยการแสดงหน้าจอจะมีค าว่า “กรุณาใส่ SD Card” และมีไอคอนรูป SD Card แสดงอยู่ ดังรูปที่ 3.34


รูปที่ 3.34 แสดงหน้า “กรุณาใส่ SD Card” บนหน้าจอสัมผัส

3.2.5 การออกแบบตัวเครื่อง
ในการออกแบบตัวเครื่อง ของเครื่องวัดค่าดัชนีมวลกายจะออกแบบโดยใช้โครงสร้าง พื้นฐานเป็นเหล็กตั้งแต่ฐานครอบตัวโหลดเซลล์ เสาตรงกลาง ไปจนถึงเหล็กที่ยื่นออกมาส าหรับ ติดอัลตร้าโซนิก ในส่วนของเค้าโครงจะใช้ไฟเบอร์กลาสในการออกแบบในส่วนโค้งต่าง ๆ เพื่อให้ ตัวเครื่องมีความสวยงาม และตรงกลางของเสาส่วนบนจะติดรางส าหรับเฟืองเพื่อให้กล่องของฉากวัด ส่วนสูงเลื่อนขึ้นลงได้ โดยแผ่นที่ใช้เป็นฉากจะเป็นพลาสติกแบบอ่อนและบางเพื่อให้มีน้ าหนักเบาที่สุด และไม่ท าให้ฉากเลื่อนลงมาเอง แสดงรูปการออกแบบตัวเครื่อง ของเครื่องวัดค่าดัชนีมวลกาย ดังรูปที่ 3.35 รูปที่ 3.36 และรูปที่ 3.37


รูปที่ 3.35 แสดงแบบตัวเครื่องวัดค่าดัชนีมวลกายด้านหน้า


รูปที่ 3.36 แสดงแบบตัวเครื่องวัดค่าดัชนีมวลกายด้านข้าง


รูปที่ 3.37 แสดงแบบตัวเครื่องวัดค่าดัชนีมวลกายด้านหลัง

### 3.3 การออกแบบเว็บแอปพลิเคชัน

3.3.1 การวิเคราะห์ระบบ
ระบบบันทึกค่าดัชนีมวลกาย เป็นระบบที่ใช้ส าหรับบันทึกค่า น้ าหนัก ส่วนสูง ดัชนีมวล กาย สถานที่ของเครื่อง วันที่วัดค่า และเกณฑ์ ที่วัดได้จากเครื่องวัดค่าดัชนีมวลกายลงในฐานข้อมูล โดยระบบจะสามารถให้ผู้ใช้งานกรอกข้อมูลเพื่อสมัครสมาชิกแล้วน าชื่อผู้ใช้ (หมายเลขโทรศัพท์) และ รหัสผ่านไปท าการเข้าสู่ระบบบนเครื่องวัดค่าดัชนีมวลกายเพื่อเก็บประวัติการใช้งาน จากนั้นจะ สามารถเข้าสู่ระบบบนเว็บเบราเซอร์เพื่อดูประวัติการใช้งานย้อนหลังได้ โดยจะแสดงค่าของข้อมูลที่ วัดได้ในหน้าหลัก (home-page) โดยการแสดงจะแสดงข้อมูลการวัดค่าครั้งล่าสุดก่อนและเรียงค่าใน ครั้งก่อนมาเรื่อย ๆ และในหน้านี้ยังแสดงข้อมูลส่วนตัวของผู้ใช้ อีกทั้งระบบนี้ยังมีหน้าแก้ไขข้อมูล ส่วนตัว (edit-page) ส าหรับให้ผู้ใช้งานแก้ไขข้อมูลส่วนตัว

3.3.2 ภาพรวมระบบ
การใช้งานระบบบันทึกค่าดัชนีมวลกายเป็นระบบส าหรับผู้ใช้งาน แสดงดังรูปที่ 3.38 โดย ผู้ใช้งานมีบทหน้าที่เกี่ยวข้องกับการใช้งานระบบดังนี้

3.3.2.1 สมัครสมาชิก
ผู้ใช้งานสามารถสมัครสมาชิกได้โดยการกรอกข้อมูลส่วนตัวให้ครบทุกช่องและใช้ เบอร์โทรศัพท์เป็น ชื่อผู้ใช้ ส าหรับการใช้งานระบบ 3.3.2.2 เข้าสู่ระบบ
เมื่อสมัครสมาชิกแล้วผู้ใช้งานสามารถเข้าสู่ระบบได้โดยกรอกเบอร์โทรศัพท์ที่ได้ สมัครและรหัสผ่านในการเข้าสู่ระบบ
3.3.2.3 ดูข้อมูลส่วนตัว
ผู้ใช้งานสามารถดูข้อมูลส่วนตัวได้ในหน้าหลักของเว็บแอปพลิเคชันหลังจากการ เข้าสู่ระบบแล้ว
3.3.2.4 ดูประวัติการใช้งานเครื่องวัดค่าดัชนีมวลกาย ผู้ใช้งานสามารถดูประวัติการใช้งานเครื่องวัดค่าดัชนีมวลกายได้ในหน้าหลักของ เว็บแอปพลิเคชันหลังจากการเข้าสู่ระบบแล้ว 3.3.2.5 แก้ไขข้อมูลส่วนตัว
ผู้ใช้งานสามารถแก้ไขข้อมูลส่วนตัวได้หลังจากเข้าสู่ระบบแล้ว โดยการแก้ไขข้อมูลส่วนตัว จะท าในหน้า แก้ไขข้อมูลส่วนตัว
3.3.2.6 ออกจากระบบ
หลังจากการเข้าสู่ระบบและใช้งานเว็บแอปพลิเคชัน ผู้ใช้งานสามารถท าการออก จากระบบได้โดยการกดปุ่ม ออกจากระบบ

ผู้ใช้งาน; สมัครสมาชิก; ออกจากระบบ; <<include>>

ดูข้อมูลส่วนตัว

ดูประวัติการใช้งาน

เครื่องวัดค่าดัชนีมวลกาย เข้าสู่ระบบ

แก้ไขข้อมูลส่วนตัว

รูปที่ 3.38 แสดง Use Case Diagram ระบบบันทึกค่าดัชนีมวลกาย

ตารางที่ 3.1 แสดง Use Case Description ในส่วน สมัครสมาชิก

Use Case ID | 1
Use Case Title | สมัครสมาชิก
Primary Actor | ผู้ใช้งาน
Main Flow | กรอกข้อมูลส่วนตัวเพื่อท าการสมัครสมาชิก
Exceptional Flow | หากกรอก เบอร์โทรศัพท์ ซ้ า จะแจ้งเตือน “หมายเลขนี้ถูกลงทะเบียน แล้ว”

ตารางที่ 3.2 แสดง Use Case Description ในส่วน เข้าสู่ระบบ

Use Case ID | 2
Use Case Title | เข้าสู่ระบบ
Primary Actor | ผู้ใช้งาน
Main Flow | กรอกเบอร์โทรศัพท์และรหัสผ่านเพื่อเข้าสู่ระบบ
Exceptional Flow | หากไม่ได้ลงทะเบียนไว้ จะแจ้ง “ไม่มีผู้ใช้นี้” และรหัสผ่านผิดจะแจ้ง “รหัสผ่านไม่ถูกต้อง”

ตารางที่ 3.3 แสดง Use Case Description ในส่วน ดูข้อมูลส่วนตัว

Use Case ID | 3
Use Case Title | ดูข้อมูลส่วนตัว
Primary Actor | ผู้ใช้งาน
Main Flow | ดูข้อมูลส่วนตัวในหน้าหลัก
Exceptional Flow

ตารางที่ 3.4 แสดง Use Case Description ในส่วน ดูประวัติการใช้งานเครื่องวัดค่าดัชนีมวลกาย

Use Case ID | 4
Use Case Title | ดูประวัติการใช้งานเครื่องวัดค่าดัชนีมวลกาย
Primary Actor | ผู้ใช้งาน
Main Flow | ดูประวัติค่าน้ าหนัก ส่วนสูง ดัชนีมวลกาย สถานที่ใช้งาน วันที่ใช้งาน และ เกณฑ์ของร่างกาย ในหน้าหลัก

Exceptional Flow

ตารางที่ 3.5 แสดง Use Case Description ในส่วน แก้ไขข้อมูลส่วนตัว

Use Case ID | 5
Use Case Title | แก้ไขข้อมูลส่วนตัว
Primary Actor | ผู้ใช้งาน
Main Flow | แก้ไขข้อมูลส่วนตัว โดยการกรอกรหัสผ่านยืนยันในการแก้ไข
Exceptional Flow | หากรหัสไม่ถูกต้องจะแจ้ง “รหัสผ่านไม่ถูกต้อง” และระบบจะไม่แก้ไข ข้อมูล

ตารางที่ 3.6 แสดง Use Case Description ในส่วน ออกจากระบบ

Use Case ID | 6
Use Case Title | ออกจากระบบ
Primary Actor | ผู้ใช้งาน
Main Flow | ออกจากระบบ
Exceptional Flow

3.3.3 การออกแบบหน้าจอ
เว็บแอปพลิเคชันที่ออกแบบให้สามารถใช้งานได้กับเว็บเบราเซอร์ Google Chrome และ Microsoft Edge โดยหน้าเว็บแอปพลิเคชั่นต่าง ๆ จะมีรายละเอียดดังต่อไปนี้ 3.3.3.1 หน้าแรก (auth/home)
ในหน้าแรกของเว็บแอปพลิเคชันจะมีปุ่ม 2 ปุ่ม คือปุ่มเข้าสู่ระบบและปุ่มสมัคร สมาชิกเมื่อท าการกดแต่ละปุ่มก็จะเปลี่ยนหน้าไปยังหน้าที่ก าหนด แสดงดังรูปที่ 3.39


รูปที่ 3.39 แสดงหน้าแรกของระบบบันทึกค่าดัชนีมวลกาย

3.3.3.2 หน้าสมัครสมาชิก (auth/registration)
ในหน้าสมัครสมาชิกจะเป็นหน้าส าหรับกรอกข้อมูลต่าง ๆ ตั้งแต่ค าน าหน้าเป็น แบบเลือก ชื่อและนามสกุลเป็นช่องให้กรอกข้อมูล เพศเป็นแบบเลือก วันเกิดเป็นแบบเลือกในรูปแบบ วันที่ เบอร์โทรศัพท์เป็นช่องให้กรอกได้เฉพาะตัวเลข 10 หลักเท่านั้น และรหัสผ่านต้องกรอกเป็น ตัวเลข 4–6 หลักเท่านั้น แล้วมีปุ่มส าหรับกดสมัครสมาชิก แสดงดังรูปที่ 3.40

รูปที่ 3.40 แสดงหน้าสมัครสมาชิกของระบบบันทึกค่าดัชนีมวลกาย

3.3.3.3 หน้าเข้าสู่ระบบ (auth/login)
ในหน้าเข้าสู่ระบบจะมีช่องให้กรอกข้อมูล 2 ช่อง คือช่องชื่อผู้ใช้หรือหมายเลข โทรศัพท์และช่องรหัสผ่าน แล้วมีปุ่มเข้าสู่ระบบเพื่อให้กดเพื่อท าการเข้าสู่ระบบ แสดงหน้าเข้าสู่ระบบ ดังรูปที่ 3.41


รูปที่ 3.41 แสดงหน้าเข้าสู่ระบบของระบบบันทึกค่าดัชนีมวลกาย

3.3.3.4 หน้าหลัก (home-page)
ในหน้าหลักจะแสดงรูปเกณฑ์ต่าง ๆ ของค่าดัชนีมวลกาย ข้อมูลส่วนตัวที่มีการ ค านวณอายุจากวัน เดือน ปี ตามวันเกิดที่เราสมัครสมาชิกเข้ามา และแสดงรายละเอียดข้อมูลล่าสุด แล้วในส่วนล่างจะแสดงประวัติการใช้งานเครื่องวัดค่าดัชนีมวลกายเรียงล าดับจากวันที่ล่าสุดลงไป แสดงดังรูปที่ 3.42


รูปที่ 3.42 แสดงหน้าหลักของระบบบันทึกค่าดัชนีมวลกาย

3.3.3.5 หน้าแก้ไขข้อมูลส่วนตัว (edit-page)
หน้าแก้ไขข้อมูลจะแสดงข้อมูลเดิมของผู้ใช้ สามารถเลือกแก้ไขข้อมูลตรงไหนก็ได้ และกรอกรหัสผ่านแล้วกดปุ่มแก้ไข เพื่อแก้ไขข้อมูลส่วนตัว แสดงดังรูปที่ 3.43

รูปที่ 3.43 แสดงหน้าแก้ไขข้อมูลส่วนตัวของระบบบันทึกค่าดัชนีมวลกาย

### 3.4 การออกแบบฐานข้อมูล

3.4.1 การออกแบบตารางเก็บข้อมูล
ในการเก็บข้อมูลส่วนต่าง ๆ ลงในฐานข้อมูล จะเก็บเป็น 2 ตาราง คือตาราง ผู้ใช้(users) และตาราง ข้อมูล (data) โดยตารางผู้ใช้จะเก็บ รหัส (id), ชื่อผู้ใช้ (username), รหัสผ่าน (password), ค าน าหน้า (prefix), ชื่อ (firstname), นามสกุล (lastname), เพศ (sex) และวันเกิด (birth) โดยมีรหัส (id) เป็นคีย์หลัก และตารางข้อมูลจะเก็บ รหัส (id), เบอร์โทรศัพท์(phone),สถานที่ (pleace), น้ าหนัก (weight), ส่วนสูง (height), ค่าดัชนีมวลกาย (bmi), เกณฑ์(gane) และวันที่ (date) โดยมีรหัส (id) เป็นคีย์หลัก แสดง ER-Diagram ของฐานข้อมูลในระบบบันทึกค่าดัชนีมวลกาย ดังรูปที่ 3.44

users; data; username; password; prefix; birth; firstname; lastname; sex; have; phone; pleace; weight; height; bmi; gane; date

รูปที่ 3.44 แสดง ER-Diagram ของฐานข้อมูลในระบบบันทึกค่าดัชนีมวลกาย

ตารางที่ 3.7 Data Dictionary users

ชื่อตาราง | ชื่อแอตทริบิวต์ | รายละเอียด | ชนิด | รูปแบบ | คีย์
users (ผู้ใช้) | id | รหัส | int | 1 | PK
| username | ชื่อผู้ใช้ | varchar | 0868582713
| password | รหัสผ่าน | varchar | 1159
| prefix | ค าน าหน้า | varchar | นาย
| firstname | ชื่อ | varchar | สมส่วน
| lastname | นามสกุล | varchar | ดีมาก
| sex | เพศ | varchar | ชาย
| birth | วันเกิด | varchar | 1997-11-08

ตารางที่ 3.8 Data Dictionary data

ชื่อตาราง | ชื่อแอตทริบิวต์ | รายละเอียด | ชนิด | รูปแบบ | คีย์
data (ข้อมูล) | id | รหัส | int | 1 | PK
| phone | เบอร์โทรศัพท์ | varchar | 0868582713
| pleace | สถานที่ | varchar | ECP KKC
| weight | น้ าหนัก | varchar | 61.50
| height | ส่วนสูง | varchar | 166.00
| bmi | ค่าดัชนีมวลกาย | varchar | 18.25
| gane | เกณฑ์ | varchar | 2
| date | วัน เดือน ปี | datetime | 2020-08-10 12:28:46

3.4.2 การเขียนโปรแกรมเชื่อมต่อฐานข้อมูล ในการเขียนโปรแกรมเพื่อให้ระบบติดต่อกับฐานข้อมูล โดยใช้ Spring Framework ในการ เขียนโปรแกรม โดยตัว Spring Framework จะท าหน้าที่สร้างตารางในฐานข้อมูลให้เองโดยไม่ต้องใช้ ค าสั่งของภาษา SQL แสดงรายละเอียดดังต่อไปนี้
3.4.2.1 การสร้างตารางผู้ใช้ (users) ในฐานข้อมูลด้วย Spring Framework ในการสร้างตารางผู้ใช้จะใช้ค าสั่ง @Entity(name = “users”) ในระดับคลาส Spring Framework จะท าการสร้างตารางให้เองอัตโนมัติ และในระดับเมธอดจะประกาศตัวแปรแต่ ละชนิดที่ต้องการใช้งาน จากนั้นใช้ค าสั่ง @Column บนตัวแปรนั้น ๆ Spring Framework จะท าการ สร้างแอตทริบิวต์ตามชื่อตัวแปรที่ได้ประกาศ หรือหากต้องการก าหนดชื่อแอตทริบิวต์ในตารางเองให้ ใช้ค าสั่ง @Column(name = “ชื่อแอตทริบิวต์ที่ต้องการ”) ในที่นี้จะมีแอตทริบิวต์ที่ต้องการคือ id, username, password, prefix, firstname, lastname, sex และ birth จึงประกาศชื่อตัวแปรตาม ข้างต้นและใส่ @Column บนหัวตัวแปรแต่ละตัวไปเลย แสดงดังรูปที่ 3.45 เมื่อสร้างตารางแล้วต่อไปเป็นการเขียนอินเตอร์เฟสเพื่อให้สามารถเขียนโปรแกรม ติดต่อกับฐานข้อมูลได้โดยการสร้างฟังก์ชันในอินเตอร์เฟส แสดงดังรูปที่ 3.46
1) ฟังก์ชันที่ใช้ในระบบส าหรับตารางผู้ใช้
- findByUsername() เป็นฟังก์ชันส าหรับQuery ข้อมูลในตารางทุกอย่างด้วย ค่า username ที่ก าหนด
- findByUsernameAndPassword() เป็นฟังก์ชันส าหรับ Query ข้อมูลใน ตารางทุกอย่างด้วยค่า username และ password ที่ก าหนด
- updateByUsername() Update เป็นฟังก์ชันส าหรับแก้ไขข้อมูลในตาราง ด้วยค่า username ที่ก าหนด
- findPasswordByUsername() เป็นฟังก์ชันส าหรับค้นหาค่า password ใน ตาราง ด้วยค่า username ที่ก าหนด


รูปที่ 3.45 แสดง การสร้างตารางผู้ใช้ (users) ในฐานข้อมูลด้วย Spring Framwork


รูปที่ 3.46 แสดง การเขียนอินเตอร์เฟสกับตารางผู้ใช้ (users) ในฐานข้อมูลด้วย Spring Framwork

3.4.2.2 การสร้างตารางข้อมูล (data) ในฐานข้อมูลด้วย Spring Framework การสร้างตารางข้อมูลจะมีขั้นตอนการสร้างที่เหมือนกันกับตารางผู้ใช้ข้างต้นนี้ มี การก าหนดตัวแปรที่ต้องการเพื่อท าการสร้างแอตทริบิวต์ในตาราง และมีการเขียนอินเตอร์เฟส โดย ฟังก์ชันในการอินเตอร์เฟสกับตารางข้อมูลจะมีแค่ฟังก์ชัน findByPhone() เป็นฟังก์ชันส าหรับการ Query ข้อมูลทุกอย่างในตารางโดยค่า phone แสดงการสร้างตารางข้อมูลและการอินเตอร์เฟสดังรูป ที่ 3.47 และรูปที่ 3.48


รูปที่ 3.47 แสดง การสร้างตารางข้อมูล (data) ในฐานข้อมูลด้วย Spring Framwork


รูปที่ 3.48 แสดง การเขียนอินเตอร์เฟสกับตารางข้อมูล (data) ในฐานข้อมูลด้วย Spring Framwork

### 3.5 การออกแบบ API ด้วย Spring Framework

การออกแบบ API ที่ใช้ส าหรับติดต่อกับอุปกรณ์และเว็บแอปพลิเคชัน แล้วท าการติดต่อกับ ฐานข้อมูล จะใช้ Spring boot Framework ที่เขียนด้วยภาษา Java ในการเขียน API จะแบ่งข้อมูล ออกแบบ 2 ส่วน คือ ข้อมูลผู้ใช้งาน และข้อมูลประวัติการใช้งาน
3.5.1 การออกแบบ API ส่วนของ ข้อมูลผู้ใช้งาน
ส าหรับข้อมูลผู้ใช้จะออกแบบฟังก์ชันต่าง ๆ ที่เกี่ยวข้องกับการใช้งานจะมีฟังก์ชัน การ สมัครสมาชิก การเข้าสู่ระบบด้วยเว็บแอปพลิเคชันและไมโครคอนโทรลเลอร์ การแก้ไขข้อมูลผู้ใช้ และ การเรียกดูรายละเอียดข้อมูลของผู้ใช้ แสดงการเขียนฟังก์ชันต่าง ๆ ดังต่อไปนี้
3.5.1.1 ฟังก์ชันการสมัครสมาชิก ในการสมัครสมาชิกจะเขียนโปรแกรมเพื่อรับข้อมูลผู้ใช้จากเว็บแอปพลิเคชัน แล้ว น าค่าชื่อผู้ใช้ที่ท าการสมัครมาตรวจสอบว่ามีชื่อผู้ใช้ซ้ ากันไหม ถ้าหากชื่อผู้ใช้ยังไม่ซ้ าระบบจะบันทึก ข้อมูลแล้วตอบกลับไปด้วยข้อความ “save user” แต่หากมีชื่อผู้ใช้ซ้ าระบบจะไม่บันทึกข้อมูลและ ตอบกลับไปด้วยข้อความ “repeat user” แสดงดังรูปที่ 3.49


รูปที่ 3.49 แสดง ฟังก์ชันการสมัครสมาชิก

3.5.1.2 ฟังก์ชันการเข้าสู่ระบบ
ในการเข้าสู่ระบบ จะเขียนโรแกรมเพื่อรับค่าชื่อผู้ใช้และรหัสผ่านจากเว็บแอป พลิเคชันเพื่อตรวจสอบในฐานข้อมูล โดยการตรวจสอบจะตรวจสอบชื่อผู้ใช้ก่อน หากไม่มีชื่อผู้ใช้ ระบบจะตอบกลับเป็นข้อความ “no user” แต่ถ้ามีชื่อผู้ใช้แต่ไม่มีรหัสผ่านระบบจะตอบกลับด้วย ข้อความว่า “password incorrect” และถ้ามีทั้งชื่อผู้ใช้และรหัสผ่านระบบจะตอบกลับด้วยข้อความ ว่า “login” แสดงดังรูปที่ 3.50


รูปที่ 3.50 แสดง ฟังก์ชันการเข้าสู่ระบบ

3.5.1.3 ฟังก์ชันการเข้าสู่ระบบ ของไมโครคอนโทรลเลอร์ การเข้าสู่ระบบด้วยไมโครคอนโทรลเลอร์ระบบจะรอรับค่าชื่อผู้ใช้และรหัสผ่าน เช่นเดียวกับการเข้าสู่ระบบด้วยเว็บแอปพลิเคชัน โดยการตรวจสอบจะตรวจสอบชื่อผู้ใช้ก่อน หากไม่ มีชื่อผู้ใช้ระบบจะตอบกลับเป็นข้อความ “NO USER” แต่ถ้ามีชื่อผู้ใช้แต่ไม่มีรหัสผ่านระบบจะตอบ กลับด้วยข้อความว่า “NO PASSWORD” และถ้ามีทั้งชื่อผู้ใช้และรหัสผ่านระบบจะตอบกลับด้วย ข้อความว่า “LOGIN” แสดงดังรูปที่ 3.51


รูปที่ 3.51 แสดง ฟังก์ชันการเข้าสู่ระบบ ของไมโครคอนโทรลเลอร์

3.5.1.4 ฟังก์ชันการแก้ไขข้อมูล
ส าหรับการแก้ไขข้อมูลระบบจะรับค่าที่ต้องการแก้ไขจากเว็บแอปพลิเคชันมาเพื่อ ส่งค่าเหล่านั้นไปแก้ไขในฐานข้อมูลโดยอิงจากชื่อผู้ใช้ หากการแก้ไขส าเร็จระบบจะตอบกลับด้วย ข้อความว่า “update” และส่งข้อมูลที่แก้ไขได้กลับไปด้วย แต่ถ้าแก้ไขข้อมูลไม่ส าเร็จระบบจะตอบ กลับด้วยข้อความว่า “no update” แสดงดังรูปที่ 3.52


รูปที่ 3.52 แสดง ฟังก์ชันการแก้ไขข้อมูล

3.5.1.5 ฟังก์ชันแสดงรายละเอียด ในฟังก์ชันแสดงรายละเอียดระบบจะรับค่าชื่อผู้ใช้จากเว็บแอปพลิเคชันเพื่อส่งไป ค้นหาข้อมูลในฐานข้อมูลจากนั้นจะส่งข้อมูลที่ได้ตอบกลับไปยังเว็บแอปพลิเคชันพร้อมกับแสดง ข้อความว่า “detail for user : ชื่อผู้ใช้ที่ส่งมา” แสดงดังรูปที่ 3.53


รูปที่ 3.53 แสดง ฟังก์ชันแสดงรายละเอียด

3.5.2 การออกแบบ API ส่วนของ ประวัติการใช้งาน ข้อมูลประวัติการใช้งานจะมีฟังก์ชันการใช้งานที่กระท ากับข้อมูลประวัติการใช้งานบน ฐานข้อมูล คือ ฟังก์ชันการบันทึกข้อมูลการใช้งาน และฟังก์ชันเรียกดูประวัติการใช้งาน แสดง ดังต่อไปนี้
3.5.2.1 ฟังก์ชันการบันทึกข้อมูล การบันทึกข้อมูลประวัติการใช้งานเครื่องวัดค่าดัชนีมวลกาย ระบบจะรับข้อมูลที่ จะบันทึกจากไมโครคอนโทรลเลอร์ แล้วน าข้อมูลข้อมูลเหล่านั้นบักทึกลงในฐานข้อมูลและส่งข้อความ ตอบกลับว่า “SAVE DATA” แสดงดังรูปที่ 3.54


รูปที่ 3.54 แสดง ฟังก์ชันการบันทึกข้อมูล

3.5.2.2 ฟังก์ชันการเรียกดูประวัติการใช้งาน การเรียกดูประวัติการใช้งานเว็บแอปพลิเคชันจะส่งค่าเบอร์โทรศัพท์มายังระบบ แล้วระบบจะไปเรียกข้อมูลทั้งหมดในฐานข้อมูลที่ตรงกับเบอร์โทรศัพท์แล้วลิสต์ข้อมูลทั้งหมดตอบ กลับไปยังเว็บแอปพลิเคชันพร้อมกับข้อความว่า “ok” แต่หากไม่มีข้อมูลระบบจะตอบกลับด้วย ข้อความว่า “no data” แสดงดังรูปที่ 3.55


รูปที่ 3.55 แสดง ฟังก์ชันการเรียกดูประวัติการใช้งาน

บทที่ 4
ผลการด าเนินงาน

จากการด าเนินงานตามวิธีด าเนินงานใน บทที่ 3 ได้ท าการทดสอบระบบในส่วนของฮาร์ดแวร์และ ซอฟต์แวร์ เพื่อให้เป็นไปตามวัตถุประสงค์ที่ตั้งเป้าหมายไว้ ในการทดสอบระบบจะมีหัวข้อดังต่อไปนี้ 4.1 ผลการทดสอบเครื่องวัดค่าดัชนีมวลกาย
4.1.1 ผลการทดสอบวัดค่าน้ าหนัก ส่วนสูง และค านวณค่าดัชนีมวลกาย
4.1.2 ผลการประเมินการท างานของเครื่องวัดค่าดัชนีมวลกาย
4.2 ผลการทดสอบระบบบันทึกค่าดัชนีมวลกาย
4.2.1 ผลการทดสอบการสมัครสมาชิก
4.2.2 ผลการทดสอบการเข้าสู่ระบบ
4.2.3 ผลการทดสอบการดูประวัติการใช้งานเครื่องวัดค่าดัชนีมวลกาย
4.2.4 ผลการทดสอบการแก้ไขข้อมูลส่วนตัว

### 4.1 ผลการทดสอบเครื่องวัดค่าดัชนีมวลกาย

จากการท างานเราได้เครื่องวัดค่าดัชนีมวลกายที่พร้อมส าหรับการทดสอบและใช้งาน โดยมี ไมโครคอนโทรลเลอร์ที่สามารถส่งข้อมูลระหว่างกันและกันได้โดยไม่ต้องอาศัยการเชื่อมต่อ อินเทอร์เน็ต คือบอร์ด Heltec WiFi LoRa 32 เป็นตัวกลางในการควบคุม ซึ่งสามารถน าไปพัฒนาต่อ หากมีการสร้างเครื่องวัดค่าดัชนีมวลกายเครื่องต่อไป แสดงเครื่องวัดค่าดัชนีมวลกายที่ได้จากการ ด าเนินงาน ดังรูปที่ 4.1


รูปที่ 4.1 เครื่องวัดค่าดัชนีมวลกาย

จากรูปที่ 4.1 เครื่องวัดค่าดัชนีมวลกาย การทดสอบการใช้งานจะรับค่าส่วนสูงจากอัลตร้าโซนิก และค่ าน้ าหนักจ ากโหลดเซลล์ม าค านวณห าค่ าดัชนีมวลก าย ในก า รป ระมวลผลด้ วย ไมโ ค รคอนโท ร ลเ ล อ ร์ (Heltec WiFi LoRa 32) ต ามที่ได้เ ขี ย นโป ร แก รมค วบคุ มไ ว้ ซึ่ง ไมโครคอนโทรลเลอร์เชื่อมต่อกับอินเทอร์เน็ตไว้หากผู้ใช้งานต้องการจะบันทึกประวัติการใช้งาน ระบบจะส่งข้อมูลไปยังเซิร์ฟเวอร์และบันทึกข้อมูลลงในฐานข้อมูล
4.1.1 ผลการทดสอบวัดค่าน้ าหนัก ส่วนสูง และค านวณค่าดัชนีมวลกาย
การทดสอบนี้จะท าโดยใช้เครื่องชั่งน้ าหนักแบบดิจิตอลและวัดส่วนสูงด้วยตลับเมตรเป็น เครื่องมือส าหรับเปรียบเทียบกับเครื่องวัดค่าดัชนีมวลกาย โดยท าการทดสอบกับคน จ านวน 10 คน เพื่อหาค่าเฉลี่ยของแต่ละคนโดยการทดสอบคนละ 10 ครั้ง จากนั้นจะน าค่าเฉลี่ยที่ได้มาเปรียบเทียบ หาค่าเปอร์เซ็นต์ค่าความผิดพลาดของเครื่องวัดค่าดัชนีมวลกาย โดยการน าเอาค่าที่ประมวลผลได้จาก หน้าจอเครื่องวัดค่าดัชนีมวลกายที่วัดได้มาท าการเปรียบเทียบกับเครื่องชั่งดิจิตอลและตลับเมตร แสดงหน้าจอแสดงผลของเครื่องวัดค่าดัชนีมวลกายดังรูปที่ 4.2


รูปที่ 4.2 หน้าจอแสดงผลเครื่องวัดค่าดัชนีมวลกาย

ตารางที่ 4.1 การทดสอบกับคนที่ 1 จ านวน 10 ครั้ง

ครั้งที่ | น้ าหนัก (กิโลกรัม) | ส่วนสูง (เซนติเมตร) | ค่าดัชนีมวลกาย
1 | 59.29 | 168 | 21.01
2 | 59.28 | 168 | 21.00
3 | 59.30 | 168 | 21.01
4 | 59.23 | 167 | 21.24
5 | 59.27 | 168 | 21.00
6 | 59.30 | 167 | 21.26
7 | 59.30 | 167 | 21.26
8 | 59.28 | 168 | 21.00
9 | 59.26 | 167 | 21.25
10 | 59.27 | 168 | 21.00
เฉลี่ย | 59.28 | 167.6 | 21.10

จากตารางที่ 4.1 การทดสอบโดยผู้ใช้คนที่ 1 ท าการทดสอบจ านวน 10 ครั้ง จากนั้นน า ค่าที่ได้มาหาค่าเฉลี่ยแล้วได้ค่าเฉลี่ยของน้ าหนัก เท่ากับ 59.28 กิโลกรัม ค่าเฉลี่ยของส่วนสูง เท่ากับ 167.6 เซนติเมตร และค่าเฉลี่ยของค่าดัชนีมวลกาย เท่ากับ 21.10

ตารางที่ 4.2 การทดสอบกับคนที่ 2 จ านวน 10 ครั้ง

ครั้งที่ | น้ าหนัก (กิโลกรัม) | ส่วนสูง (เซนติเมตร) | ค่าดัชนีมวลกาย
1 | 53.42 | 164 | 19.86
2 | 53.29 | 164 | 19.81
3 | 53.34 | 164 | 19.83
4 | 53.35 | 164 | 19.84
5 | 53.42 | 164 | 19.86
6 | 53.31 | 164 | 19.82
7 | 53.34 | 164 | 19.83
8 | 53.31 | 164 | 19.82
9 | 53.40 | 164 | 19.86
10 | 53.32 | 163 | 20.07
เฉลี่ย | 53.35 | 163.9 | 19.86

จากตารางที่ 4.2 การทดสอบโดยผู้ใช้คนที่ 2 ท าการทดสอบจ านวน 10 ครั้ง จากนั้นน า ค่าที่ได้มาหาค่าเฉลี่ยแล้วได้ค่าเฉลี่ยของน้ าหนัก เท่ากับ 53.35 กิโลกรัม ค่าเฉลี่ยของส่วนสูง เท่ากับ 163.9 เซนติเมตร และค่าเฉลี่ยของค่าดัชนีมวลกาย เท่ากับ 19.86

ตารางที่ 4.3 การทดสอบกับคนที่ 3 จ านวน 10 ครั้ง

ครั้งที่ | น้ าหนัก (กิโลกรัม) | ส่วนสูง (เซนติเมตร) | ค่าดัชนีมวลกาย
1 | 69.47 | 173 | 23.21
2 | 69.49 | 172 | 23.49
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

จากตารางที่ 4.11 การทดสอบโดยผู้ใช้คนที่ 8 ท าการทดสอบจ านวน 10 ครั้ง จากนั้นน า ค่าที่ได้มาหาค่าเฉลี่ยแล้วได้ค่าเฉลี่ยของน้ าหนัก เท่ากับ 62.65 กิโลกรัม ค่าเฉลี่ยของส่วนสูง เท่ากับ 171.9 เซนติเมตร และค่าเฉลี่ยของค่าดัชนีมวลกาย เท่ากับ 21.21

ตารางที่ 4.12 การทดสอบกับคนที่ 9 จ านวน 10 ครั้ง

ครั้งที่ | น้ าหนัก (กิโลกรัม) | ส่วนสูง (เซนติเมตร) | ค่าดัชนีมวลกาย
1 | 49.26 | 162 | 18.77
2 | 49.31 | 161 | 19.02
3 | 49.27 | 161 | 19.01
4 | 49.25 | 161 | 19.00
5 | 49.34 | 161 | 19.03
6 | 49.23 | 161 | 18.99
7 | 49.20 | 162 | 18.72
8 | 49.32 | 161 | 19.03
9 | 49.25 | 162 | 18.77
10 | 49.30 | 161 | 19.02
เฉลี่ย | 49.27 | 161.3 | 18.94

จากตารางที่ 4.12 การทดสอบโดยผู้ใช้คนที่ 9 ท าการทดสอบจ านวน 10 ครั้ง จากนั้นน า ค่าที่ได้มาหาค่าเฉลี่ยแล้วได้ค่าเฉลี่ยของน้ าหนัก เท่ากับ 49.27 กิโลกรัม ค่าเฉลี่ยของส่วนสูง เท่ากับ 161.3 เซนติเมตร และค่าเฉลี่ยของค่าดัชนีมวลกาย เท่ากับ 18.94

ตารางที่ 4.13 การทดสอบกับคนที่ 10 จ านวน 10 ครั้ง

ครั้งที่ | น้ าหนัก (กิโลกรัม) | ส่วนสูง (เซนติเมตร) | ค่าดัชนีมวลกาย
1 | 86.20 | 182 | 26.20
2 | 86.00 | 182 | 25.96
3 | 86.26 | 181 | 26.33

ตารางที่ 4.14 การทดสอบกับคนที่ 10 จ านวน 10 ครั้ง (ต่อ)

ครั้งที่ | น้ าหนัก (กิโลกรัม) | ส่วนสูง (เซนติเมตร) | ค่าดัชนีมวลกาย
4 | 86.33 | 182 | 26.06
5 | 86.31 | 183 | 25.77
6 | 86.36 | 182 | 26.07
7 | 86.14 | 182 | 26.01
8 | 86.18 | 182 | 26.02
9 | 85.88 | 183 | 25.64
10 | 86.25 | 182 | 26.04
เฉลี่ย | 86.19 | 182.1 | 26.01

จากตารางที่ 4.13 และ 4.14 การทดสอบโดยผู้ใช้คนที่ 10 ท าการทดสอบจ านวน 10 ครั้ง จากนั้นน าค่าที่ได้มาหาค่าเฉลี่ยแล้วได้ค่าเฉลี่ยของน้ าหนัก เท่ากับ 86.19 กิโลกรัม ค่าเฉลี่ยของส่วนสูง เท่ากับ 182.1 เซนติเมตร และค่าเฉลี่ยของค่าดัชนีมวลกาย เท่ากับ 26.01

จาการทดสอบกับคนจ านวน 10 คน แล้วได้ค่าเฉลี่ยของน้ าหนัก ส่วนสูง และค่าดัชนีมวล กายของแต่ละคน แล้วจะน าค่าเฉลี่ยที่ได้ไปเปรียบเทียบกับค่าที่วัดได้จากเครื่องชั่งดิจิตอลและตลับ เมตรเพื่อค่าค่าเปอร์เซ็นต์ความผิดพลาดเฉลี่ยของเครื่องวัดค่าดัชนีมวลกาย ซึ่งได้ผลการเปรียบเทียบ ดังตารางที่ 4.15

ตารางที่ 4.15 ผลการทดสอบเปรียบเทียบเครื่องวัดค่าดัชนีมวลกายกับเครื่องมือวัดทั่วไป

คนที่ | เครื่องวัด ค่าดัชนีมวลกาย | เครื่องมือวัดทั่วไป | เปอร์เซ็นต์ความ ผิดพลาด
เครื่องชั่ง | ตลับ เมตร | -
น้ าหนัก (kg) | ส่วนสูง (cm) | ดัชนี มวล กาย | น้ าหนัก (kg) | ส่วนสูง (cm) | ดัชนี มวล กาย | น้ าหนัก (%) | ส่วน สูง (%) | ดัชนี มวล กาย (%)
1 | 59.28 | 167.6 | 21.10 | 59.15 | 168.0 | 20.95 | 0.22 | 0.24 | 0.72
2 | 53.35 | 163.9 | 19.86 | 53.25 | 164.0 | 19.80 | 0.19 | 0.06 | 0.30
3 | 69.51 | 172.6 | 23.33 | 69.30 | 172.0 | 23.42 | 0.30 | 0.35 | 0.38
4 | 51.06 | 158.8 | 20.25 | 51.10 | 158.0 | 20.47 | 0.08 | 0.51 | 1.07
5 | 65.00 | 169.6 | 22.60 | 65.05 | 169.0 | 22.78 | 0.08 | 0.36 | 0.79
6 | 40.38 | 153.2 | 17.21 | 40.50 | 153.0 | 17.30 | 0.30 | 0.13 | 0.52
7 | 60.62 | 161.9 | 23.13 | 60.85 | 161.0 | 23.48 | 0.38 | 0.56 | 1.49
8 | 62.65 | 171.9 | 21.21 | 62.85 | 172.0 | 21.24 | 0.32 | 0.06 | 0.14
9 | 49.27 | 161.3 | 18.94 | 49.30 | 161.0 | 19.02 | 0.06 | 0.19 | 0.42
10 | 86.19 | 182.1 | 26.01 | 85.95 | 182.0 | 25.95 | 0.28 | 0.05 | 0.23
เฉลี่ย | 59.73 | 166.3 | 21.36 | 59.73 | 166.0 | 21.44 | 0.22 | 0.25 | 0.61

การหาเปอร์เซ็นต์ความผิดพลาดหาได้จากสมการที่ (4.1)
เปอร์เซ็นต์ความผิดพลาด =

|Y−X|
Y
× 100 | (4.1)
โดย | Y = ค่าที่วัดได้จากเครื่องชั่งน้ าหนักทั่วไป
X = ค่าที่วัดได้จากเครื่องค านวณค่าดัชนีมวลกายอัตโนมัติ

จากการทดสอบค่าต่าง ๆ และน ามาเปรียบเทียบหาค่าเปอร์เซ็นต์ความผิดพลาดเฉลี่ย พบว่าค่าความผิดพลาดที่เกิดจากการวัดน้ าหนักจ านวน 10 ครั้ง เมื่อน ามาท าการเฉลี่ยแล้วมีค่า เท่ากับ 0.22 เปอร์เซ็นต์ ส่วนความผิดพลาดของส่วนสูงจ านวน 10 ครั้ง เมื่อน ามาเฉลี่ยแล้วพบว่ามีค่า เท่ากับ 0.25 เปอร์เซ็นต์ และค่าดัชนีมวลกายเฉลี่ยมีค่าความผิดพลาด เท่ากับ 0.61 เปอร์เซ็นต์

4.1.2 ผลการประเมินการท างานของเครื่องวัดค่าดัชนีมวลกาย
การประเมินการท างานในส่วนต่าง ๆ ของเครื่องวัดค่าดัชนีมวลกาย จะประเมินโดย ผู้พัฒนาระบบ จะประเมินตั้งแต่การอ่านค่าน้ าหนักจากโหลดเซลล์ การอ่านค่าส่วนสูงจาก อัลตร้าโซนิก การค านวณค่าดัชนีมวลกายและแบ่งเกณฑ์ การกรอกข้อมูลชื่อผู้ใช้ละรหัสผ่านในการ เข้าสู่ระบบ การแจ้งเตือนหากเข้าสู่ระบบไม่ส าเร็จ การบันทึกประวัติการใช้งานไปยังฐานข้อมูล เสียง ประกอบขั้นตอนการท างาน และการส่งข้อมูลไปยังเซิร์ฟเวอร์แล้วบันทึกข้อมูลลงในฐานข้อมูล ผลการ ประเมินคือการท างานแต่ละส่วนที่ประเมินสามารถท างานได้จริง แสดงดังตารางที่ 4.16

ตารางที่ 4.16 ผลการประเมินการท างานของเครื่องวัดค่าดัชนีมวลกาย

ล าดับ | การท างาน | ท างานได้ | ท างานไม่ได้ | หมายเหตุ
1 | การชั่งน้ าหนัก |
2 | การวัดส่วนสูง |
3 | การค านวณค่าดัชนีมวลกาย |
4 | การแบ่งแยกเกณฑ์จากค่าดัชนีมวลกาย |
5 | การกรอกข้อมูลชื่อผู้ใช้ |
6 | การกรอกข้อมูลรหัสผ่าน |
7 | การเข้าสู่ระบบ |
8 | การแจ้งเตือนเมื่อเข้าสู่ระบบผิดพลาด |
9 | การบันทึกข้อมูล |
10 | เสียงประกอบขั้นตอนการท างาน |
11 | ส่งข้อมูลไปยังเซิร์ฟเวอร์และบันทึกลงฐานข้อมูล |

### 4.2 ผลการทดสอบระบบบันทึกค่าดัชนีมวลกาย

จากการด าเนินงานเราได้ระบบบันทึกค่าดัชนีมวลกายที่อยู่ในรูปแบบเว็บแอปพลิเคชันที่เสร็จสิ้น พร้อมส าหรับการทดสอบการท างานในส่วนต่าง ๆ การทดสอบจะท าการทดสอบฟังก์ชันในแต่ละ หน้าจอที่มีการท างานร่วมกับฐานข้อมูลที่อยู่บนเซิร์ฟเวอร์ โดยมีรายละเอียดดังต่อไปนี้

4.2.1 ผลการทดสอบการสมัครสมาชิก
4.2.1.1 ทดสอบกรอกข้อมูลไม่ครบ เป็นการทดสอบฟังก์ชันการกรอกข้อมูลให้ครบถ้วนเมื่อสมัครสมาชิกเพื่อใช้งาน ระบบหากมีการกรอกข้อมูลไม่ครบทุกช่อง ระบบจะแจ้งเตือนว่า “กรุณากรอกข้อมูลให้ครบทุกช่อง” ตามที่ได้เขียนโปรแกรมไว้ แสดงการแจ้งเตือนดังรูปที่ 4.3


รูปที่ 4.3 การแจ้งเตือนเมื่อกรอกข้อมูลไม่ครบถ้วน

4.2.1.2 ทดสอบการกรอกเบอร์โทรศัพท์และรหัสผ่าน เป็นการทดสอบฟังก์ชันการกรอกเบอร์โทรศัพท์และรหัสผ่านโดยการกรอกเบอร์ โทรศัพท์ต้องกรอกเป็นตัวเลขจ านวน 10 หลักเท่านั้น หากกรอกเป็นตัวอักษรหรือหรอกไม่ครบ 10 หลักระบบจะแจ้งเตือน และการกรอกรหัสผ่านต้องเป็นตัวเลข 4-6 หลักเท่านั้น หากกรอกไม่ถูกต้อง ระบบจะแจ้งเตือน แสดงการแจ้งเตือนดังรูปที่ 4.4


รูปที่ 4.4 การแจ้งเตือนเมื่อกรอกเบอร์โทรศัพท์และรหัสผ่านในรูปแบบที่ไม่ถูกต้อง

4.2.1.3 ทดสอบการสมัครสมาชิกซ้ า
เป็นการทดสอบฟังก์ชันการกรอกชื่อผู้ใช้ (เบอร์โทรศัพท์) ที่เคยสมัครเป็นสมาชิก แล้ว หากมีการกรอกชื่อผู้ใช้เดิมในการสมัครสมาชิกระบบจะแจ้งเตือนตามที่ได้เขียนโปรแกรมไว้ แสดงการแจ้งเตือนดังรูปที่ 4.5


รูปที่ 4.5 การแจ้งเตือนเมื่อกรอกเบอร์โทรศัพท์ที่เคยลงทะเบียนแล้ว

4.2.2 ผลการทดสอบการเข้าสู่ระบบ
4.2.2.1 ทดสอบกรอกชื่อผู้ใช้
เป็นการทดสอบฟังก์ชันการกรอกชื่อผู้ใช้ (เบอร์โทรศัพท์) ที่ไม่ได้สมัครสมาชิกแล้ว ท าการเข้าสู่ระบบ ระบบจะตรวจสอบข้อมูลผู้ใช้ในฐานข้อมูลแล้วแจ้งเตือนตามโปรแกรมที่ได้เขียนไว้ แสดงการแจ้งเตือนดังรูปที่ 4.6


รูปที่ 4.6 การแจ้งเตือนเมื่อเข้าสู่ระบบด้วยเบอร์โทรศัพท์ที่ไม่มีในระบบ

4.2.2.2 ทดสอบกรอกรหัสผ่าน
เป็นการทดสอบฟังก์ชันการกรอกชื่อผู้ใช้ (เบอร์โทรศัพท์) ที่มีในระบบกรอก รหัสผ่านที่ไม่ถูกต้อง ระบบจะตรวจสอบชื่อผู้ใช้ละรหัสผ่านในฐานข้อมูลว่าชื่อผู้ใช้นี้มีรหัสผ่านตามที่ได้ กรอกเข้ามาหรือไม่ หากรหัสผ่านไม่ตรง ระบบจะแจ้งเตือนตามที่ได้เขียนโปรแกรมไว้ แสดงการแจ้ง เตือนดังรูปที่ 4.7


รูปที่ 4.7 การแจ้งเตือนเมื่อเข้าสู่ระบบด้วยรหัสผ่านที่ไม่ถูกต้อง

4.2.3 ผลการทดสอบการดูประวัติการใช้งานเครื่องวัดค่าดัชนีมวลกาย เป็นการเข้าสู่ระบบเพื่อส าเร็จแล้วระบบจะน าทางมายังหน้าหลักที่มีข้อมูลส่วนตัว รวมถึง ประวัติการใช้งานเครื่องวัดค่าดัชนีมวลกายที่ผู้ใช้ได้ใช้งานแล้วกดบันทึกข้อมูลไว้ แสดงดังรูปที่ 4.8


รูปที่ 4.8 แสดงประวัติการใช้งานบนเว็บแอปพลิเคชัน

4.2.4 ผลการทดสอบการแก้ไขข้อมูลส่วนตัว
4.2.4.1 ทดสอบการกรอกรหัสผ่านก่อนการแก้ไขข้อมูล
1) กรอกรหัสผ่านไม่ถูกต้อง ในหน้าแก้ไขข้อมูลเมื่อผู้ใช้งานแก้ไข้ข้อมูลส่วนตัว จ าเป็นจะต้องกรอกรหัสผ่านยืนยันเพื่อแก้ไขข้อมูลแล้วกดปุ่ม แก้ไข จากนั้นระบบจะตรวจสอบว่า รหัสผ่านถูกต้องหรือไม่ หากรหัสผ่านไม่ถูกต้อง ระบบจะแจ้งเตือนดังรูปที่ 4.9


รูปที่ 4.9 การแจ้งเตือนเมื่อกรอกรหัสผ่านยืนยันไม่ถูกต้อง

2) กรอกรหัสผ่านที่ถูกต้อง ในกรณีที่กรอกรหัสผ่านถูกต้อง จะแจ้งเตือน ดัง รูปที่ 4.10


รูปที่ 4.10 การแจ้งเตือนเมื่อกรอกรหัสผ่านยืนยันถูกต้อง

ตารางที่ 4.17 สรุปผลการทดสอบระบบบันทึกค่าดัชนีมวลกาย

ล าดับ | การทดสอบ | ท างานได้ | ท างานไม่ได้ | หมายเหตุ
1 | แจ้งเตือนเมื่อกรอกข้อมูลสมัครสมาชิกไม่ครบ |
2 | แจ้งเตือนเมื่อกรอกชื่อผู้ใช้ผิดรูปแบบ |
3 | แจ้งเตือนเมื่อกรอกรหัสผ่านผิดรูปแบบ |
4 | แจ้งเตือนเมื่อสมัครสมาชิกซ้ า |
5 | สามารถสมัครสมาชิกได้ |
6 | ตรวจสอบชื่อผู้ใช้และรหัสผ่านในระบบ |
7 | สมารถเข้าสู่ระบบได้ |
8 | สามารถแสดงข้อมูลส่วนตัวและประวัติการใช้ งานเครื่องวัดค่าดัชนีมวลกายได้ |
9 | สามารถตรวจสอบรหัสผ่านก่อนแก้ไขข้อมูลได้ |
10 | ออกจากระบบได้ |

บทที่ 5
สรุปผลการด าเนินงาน

### 5.1 สรุปผล

จากผลการทดลอง การออกแบบและพัฒนาเครื่องวัดค่าดัชนีมวลกาย ผู้จัดท าได้เขียนโปรแกรม เพื่อควบคุมอุปกรณ์ โหลดเซลล์, อัลตร้าโซนิก, หน้าจอสัมผัส, โมดูลเล่นเสียง, สวิตซ์, และมอเตอร์ บนไมโครคอนโทรลเลอร์ (Heltec WiFi LoRa 32) โดยท าการออกแบบให้รับค่าจากโหลดเซลล์ และอัลตร้าโซนิกมาค านวณหาค่าดัชนีมวลกาย จากนั้นส่งประวัติการใช้งานเครื่องวัดค่าดัชนีมวลกาย ไปยังไปเซิร์ฟเวอร์เพื่อบันทึกไว้ในฐานข้อมล และน าค่าเหล่านั้นไปแสดงบนเว็บแอปพลิเคชัน คือ ระบบบันทึกค่าดัชนีมวลกาย เพื่อให้ผู้ใช้งานสามารถเรียกดูประวัติการใช้งานย้อนหลัง และเครื่องวัด ค่าดัชนีมวลกายที่ออกแบบนั้นยังสามารถท างานกับหน้าจอสัมผัสและเล่นเสียงขั้นตอนต่าง ๆ ท าให้ สามารถตอบสนองกับผู้ใช้งานในขั้นตอนการใช้งานได้ การทดสอบความถูกต้องของค่าที่วัดได้จากเครื่องวัดค่าดัชนีมวลกาย ได้ท าการทดสอบใช้งาน เครื่องวัดค่าดัชนีมวลกายกับผู้ใช้งานจ านวน 10 คน โดยท าการทดสอบคนละ 10 ครั้ง เพื่อน าค่าเฉลี่ย ที่ได้จากแต่ละคนไปเปรียบเทียบค่าเปอร์เซ็นต์ความผิดพลาด โดยท าการเปรียบเทียบน้ าหนักกับค่าที่ ได้จากเครื่องชั่งแบบดิจิตอลและท าการเปรียบเทียบส่วนสูงจากค่าที่ได้จากตลับเมตร จากการทดสอบ ค่าต่าง ๆ และน ามาหาค่าเปอร์เซ็นต์ความผิดพลาดเฉลี่ย พบว่าค่าเปอร์เซ็นต์ความผิดพลาดที่เกิดจาก การชั่งน้ าหนัก มีค่าความผิดพลาด เท่ากับ 0.22 เปอร์เซ็นต์ ค่าเปอร์เซ็นต์ความผิดพลาดที่เกิดจาก การวัดส่วนสูงมีค่า เท่ากับ 0.25 เปอร์เซ็นต์ และค่าเปอร์เซ็นต์ความผิดพลาดที่ของค่าดัชนีมวลกาย มีค่า เท่ากับ 0.61 เปอร์เซ็นต์
การออกแบบระบบบันทึกค่าดัชนีมวลกายที่อยู่ในรูแบบเว็บแอปพลิเคชัน โดยมีส่วนต่าง ๆ ดังนี้ หน้าสมัครสมาชิก, หน้าเข้าสู่ระบบ, หน้าแสดงข้อมูลส่วนตัวผู้ใช้งานและแสดงประวัติการใช้งาน, และ หน้าแก้ไขข้อมูลส่วนตัว โดยการทดสอบการท างานของระบบในแต่ละหน้าพบว่า ระบบนั้นสามารถ ท างานและแจ้งเตือนพร้อมทั้งแสดงประวัติการใช้งานได้อย่างถูกต้อง

### 5.2 ปัญหาและแนวทางแก้ไข

5.2.1 การท าระบบฉากเลื่อนที่เป็นแบบรางนั้นท าให้การเลื่อนขึ้นลงมีความติดขัดในบางจังหวะ เนื่องจากการติดตั้งอุปกรณ์ค่อนข้างมีความล าบาก จึงอยากเสนอให้ท าฉากเลื่อนที่มีความมั่นคงและมี ความเร็วในการเลื่อนขึ้นลงมากขึ้น โดยการเลือกใช้อุปกรณ์ที่ดีขึ้น

5.2.2 หน้าจอสัมผัสมีขนาดเล็กเกินไป ในการออกแบบจะต้องค านึงถึงส่วนต่าง ๆ ของหน้าจอ หากสามารถเปลี่ยนหน้าจอที่มีขนาดใหญ่ขึ้นได้ จะส่งผลดีต่อการออกแบบหน้าจอและความพึงพอใจ ต่อผู้ใช้งานมากขึ้น

### 5.3 ข้อเสนอแนะและแนวทางการพัฒนา

5.3.1 ปริญญานิพนธ์นี้สามารถพัฒนาต่อได้โดยการสร้างเครื่องวัดค่าดัชนีมวลกายแบบเดิมขึ้นมา และเพิ่มฟังก์ชันการรับส่งข้อมูลโดยใช้สัญญาณแบบ LoRa ระหว่างเครื่องเดิมนี้และเครื่องใหม่ เนื่องจากไมโครคอนโทรลเลอร์ที่ใช้ในปัจจุบันสามารถรับส่งข้อมูลแบบ LoRa ได้ แต่ยังไม่ได้ใช้ส่วนนั้น ในงานวิจัยชิ้นนี้
5.3.2 ปริญญานิพนธ์นี้มีข้อจ ากัดในการเข้าถึงข้อมูลได้เพียงเว็บเบราเซอร์ สามารถเปลี่ยนรูปแบบ จากเว็บแอปพลิเคชันไปเป็นแอปพลิเคชันที่รองรับการท างานบนระบบปฏิบัติการแอนดรอยด์ เนื่องจากผู้คนส่วนมากใช้สมาร์ตโฟนเป็นหลัก จะท าให้สะดวกต่อการใช้งานมากขึ้น

บรรณานุกรม

[1] | กองบรรณาธิการ HD. (2560). | ค านวณค่า BMI ดัชนีมวลกาย [ออนไลน์] เข้าถึงได้จาก
URL: https://www.honestdocs.co/bmi-body-mass-index-calculator
| (9 มีนาคม 2561)
[2] LoRa [นามแฝง]. (2556). LoRa 433MHz [ออนไลน์] เข้าถึงได้จาก
URL: https://www.arduitronics.com/product/2199. (8 ตุลาคม 2562)
[3] DegrawSt [นามแฝง]. (2563). Arduino Bathroom Scale With 50 Kg Load Cellsand HX711 Amplifier [ออนไลน์]. เข้าถึงได้จาก
URL: https://www.instructables.com/Arduino-Bathroom-Scale-With-50-Kg-Load-Cells-and-H/. (10 ตุลาคม 2562)
[4] Kritsada Jaiyen. (2557). [UNICON] [HC-SR04] วัดระยะทางด้วยคลื่นอัลตร้าโซนิก [ออนไลน์]. Innovative Experiment Co.,Ltd. เข้าถึงได้จาก
URL: http://doc.inex.co.th/hc-sr04-ultrasonic-unicon. (8 ตุลาคม 2562)
[5] Saravut Konglampan. (https://www.kkmakerclub.com/author/saravut/) (2559). จอ Touch Screen (https://www.kkmakerclub.com/2016/03/02/%e0%b8%88%e0%b8%ad-touch-screen-nextion-itead-studio-%e0%b8%aa%e0%b8%b7%e0%b9%88%e0%b8%ad%e0%b8%aa%e0%b8%b2%e0%b8%a3%e0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) [ออนไลน์]. เข้าถึงได้จาก URL: https://www.kkmakerclub.com/2016/03/02/?fbclid=IwAR3DYbcrGDCHftxVF74ZnZsIzATUFqjTWUv_dZx_DYPQo30hxX_MlOQY0WM. (https://www.kkmakerclub.com/2016/03/02/) (19 กรกฎาคม 2563)
[6] IOXhop [นามแฝง]. (2563). DFPlayer Mini - mini MP3 player module [ออนไลน์]. เข้าถึงได้จาก URL: https://www.ioxhop.com/product/219.
| (19 กรกฎาคม 2563)
[7] IOXhop [นามแฝง]. (2563). Mini 298N 2 Way PWM Mortor Driver MX1508 บอร์ดขับมอเตอร์ 2 ช่อง 1.5A ขนาดเล็ก ส าหรับ smart car robot [ออนไลน์]. เข้าถึงได้จาก URL: https://www.allnewstep.com/product/1116.
| (19 กรกฎาคม 2563)
[8] IOXhop [นามแฝง]. (2563). เกียร์มอเตอร์ N20 Gear Motor 3-6V ทดรอบความเร็ว 180-360 rpm [ออนไลน์]. เข้าถึงได้จาก URL: https://www.allnewstep.com/-product/3474. (19 กรกฎาคม 2563)
[9] IOXhop [นามแฝง]. (2563). Spur Gear Pinion 1.0 Mod 20Teeth Bore 12.7mm (straightteeth - เฟืองตรง) [ออนไลน์]. เข้าถึงได้จาก
URL: https://www.zonemaker.com/product/1982. (19 กรกฎาคม 2563)

บรรณานุกรม (ต่อ)

[10] Y.Jaruwan [นามแฝง]. (2544). ความรู้ทั่วไปเกี่ยวกับระบบฐานข้อมูล [ออนไลน์]. เข้าถึงได้จาก : URL: http://www3.chandra.ac.th/office/ict/document/it/it04/page01.html. (http://www3.chandra.ac.th/office/ict/document/it/it04/page01.html) (9 ตุลาคม 2562)
[11] A FMIS (https://sysadmin.psu.ac.th/author/maliwan-s/) [นามแฝง]. (2560) รู้จัก Angular กันดีกว่า [ออนไลน์] เข้าถึงได้จาก URL: https://sysadmin.psu.ac.th/2018/05/22. (9 มีนาคม 2563)
[12] ASSANAI MANURAT. (http://assanai.com/author/assanai/) (2559). เริ่มต้นท าความรู้จักกับ Spring Boot [ออนไลน์]. เข้าถึงได้จาก URL: http://assanai.com/getting-started-spring-boot/.
(19 กรกฎาคม 2563)
[13] Nuttavut Thongjor. (2559). TypeScript คืออะไร [ออนไลน์]. เข้าถึงได้จาก URL: https://www.babelcoder.com/blog/posts/typescript-data-types.
(19 กรกฎาคม 2563)
[14] Mindphp [นามแฝง]. (2560). SQL คืออะไร [ออนไลน์]. เข้าถึงได้จาก: URL: https://www.mindphp.com/คู่มือ/73-คืออะไร/2088-sql-คืออะไร.html.
(9 มีนาคม 2563)
[15] Mindphp [นามแฝง]. (2560). Java คืออะไร จาวา คือภาษาคอมพิวเตอร์ ส าหรับเขียน โปรแกรมเชิงวัตถุ [ออนไลน์]. เข้าถึงได้จาก URL: https://www.mindphp.com/คู่มือ/73-คืออะไร/2185-java-คืออะไร.html. (https://www.mindphp.com/คู่มือ%20/73-คืออะไร/2185-java-คืออะไร.html) (20 กรกฎาคม 2563)
[16] ทันพงษ์ ภู่รักษ์. (2563). ซอฟต์แวร์ส าหรับโปรแกรมภาษา C [ออนไลน์]. เข้าถึงได้จาก URL: www.sbt.ac.th › new › sites › default › files › TNP_Unit_2.
(20 กรกฎาคม 2563)
[17] Wikipedia [นามแฝง]. (2563). IntelliJ IDEA [ออนไลน์]. เข้าถึงได้จาก
URL: https://en.wikipedia.org/wiki/IntelliJ_IDEA. (19 กรกฎาคม 2563)
[18] Mindphp [นามแฝง]. (2560). รู้จักกับ Visual Studio Code (วิชวล สตูดิโอ โค้ด) โปรแกรมฟรีจากค่ายไมโครซอฟท์[ออนไลน์]. เข้าถึงได้จาก
URL: https://www.mindphp.com/บทความ/microsoft/4829-visual-studio-code.html. (https://www.mindphp.com/บทความ/microsoft/4829-visual-studio-%20%20%20%20%20%20%20%20%20%20%20code.html) (19 กรกฎาคม 2563)
[19] SE-ED inspiration starts here [นามแฝง]. (2563). จ าลองการท างานและออกแบบลาย วงจรพิมพ์ด้วย Circuit Wizard [ออนไลน์]. เข้าถึงได้จาก URL:https://bit.ly/32DHJAn. (19 กรกฎาคม 2563)

บรรณานุกรม (ต่อ)

[20] Quick ERP TV [นามแฝง]. (2560). NEXTION DISPLAY [ออนไลน์]. เข้าถึงได้จาก URL: https://www.youtube.com/watch?v=_fJO5rBiAP4. (19 กรกฎาคม 2563)
[21] พัชรินทร์ สุภายอง. (2560). หน่วยที่-1-ความเป็นมาของโปรแกรม-SketchUp [ออนไลน์]. เข้าถึงได้จาก URL: https://bit.ly/3dnWv1O. (19 กรกฎาคม 2563)
[22] กชกรณ์ สิงห์กล่อม และ นิติธร มียิ่ง. 2560. “ออกแบบระบบค านวณค่าดัชนีมวลกาย อัตโนมัติ”. ภาคนิพนธ์ สาขาวิชาวิศวกรรมคอมพิวเตอร์ มหาวิทยาลัยเทคโนโลยี ราชมงคลอีสาน วิทยาเขตขอนแก่น.
[23] lnw Shop [นามแฝง]. (2563). เครื่องชั่งน้ าหนัก วัดส่วนสูง NAGATA รุ่น BW-1122H [ออนไลน์]. เข้าถึงได้จาก URL: http://www.apddscale.com/product/372/.
(26 กันยายน 2563)
[24] Krotron [นามแฝง]. (2557). เครื่องชั่งน้ าหนัก Digital scales รุ่น scml [ออนไลน์]. เข้าถึงได้จาก URL: http://krotron.com/เครื่องชั่งหยอดเหรียญ/เครื่องชั่งหยอดเหรียญ-scml. (26 กันยายน 2563)
[25] lnw Shop [นามแฝง]. (2562). เครื่องชั่งน้ าหนัก วัดส่วนสูงอัตโนมัติ ADAM รุ่น MUW 300L [ออนไลน์]. เข้าถึงได้จาก URL: http://www.apddscale.com/product/372/. (26 กันยายน 2563)
[26] Xiaohui Yang [นามแฝง]. (2558). เครื่องชั่งน้ าหนัก วัดส่วนสูงอัตโนมัติ Shengyuan รุ่น HGM-601 [ออนไลน์]. เข้าถึงได้จาก URL: http://www.tamada-scale.com/product/315/adam-model-muw-300l-300-kg-x-0-05-kg. (26 กันยายน 2563)

ภาคผนวก

ภาคผนวก ก.
คู่มือการใช้งาน

คู่มือการใช้งาน


### 1. การใช้งานเครื่องวัดค่าดัชนีมวลกาย

ขั้นตอนที่ 1 เมื่อเราเปิดใช้งานเครื่องวัดค่าดัชนีมวลกายแล้ว หากเครื่องพร้อมใช้งานจะ ขึ้นหน้าจอ ดังรูปที่ ก.1 ให้เราแตะที่หน้าจอเพื่อใช้งาน


รูปที่ ก.1 หน้ายินดีต้อนรับของเครื่องวัดค่าดัชนีมวลกาย

ขั้นตอนที่ 2 หลังจากที่เราแต่หน้าจอในหน้ายินดีต้อนรับแล้ว หน้าจอจะเปลี่ยนมายังหน้า เลือกเมนู ดังรูปที่ ก.2 ให้เราเลือกตามที่ต้องการ การเลือกผู้ใช้ทั่วไปจะเข้าสู่ขั้นตอนการเริ่มใช้งาน หากเลือกเข้าสู่ระบบจะไปยังหน้าเข้าสู่ระบบส าหรับคนที่ต้องการบันทึกการใช้งาน โดยก่อนจะเข้าสู่ ระบบจ าเป็นต้องสมัครสมาชิกผ่าน QR-Code หรือ www.ecpbmi.in.th ก่อนถึงจะใช้งานใน ส่วนนี้ได้


รูปที่ ก.2 หน้า เมนู ของเครื่องวัดค่าดัชนีมวลกาย

ขั้นตอนที่ 3 หากเลือกเมนูเข้าสู่ระบบ จะมายังหน้าจอเข้าสู่ระบบ ดังรูปที่ ก.3 เพื่อให้เรา กรอกข้อมูลเบอร์โทรศัพท์และรหัสผ่านที่ได้สมัครสมาชิกไว้ เมื่อเรากดตรงช่องหมายเลขโทรศัพท์ หน้าจอจะไปยังหน้ากรอกเบอร์โทรศัพท์ ดังรูปที่ ก.4 และเมื่อเรากดตรงช่องรหัสผ่าน หน้าจอจะไปยัง หน้ากรอกรหัสผ่าน เมื่อกรอกข้อมูลจนครบให้กดปุ่ม เข้าสู่ระบบ ในหน้าเข้าสู่ระบบ


รูปที่ ก.3 หน้า เข้าสู่ระบบ ของเครื่องวัดค่าดัชนีมวลกาย

รูปที่ ก.4 หน้า กรอกเบอร์โทรศัพท์ ของเครื่องวัดค่าดัชนีมวลกาย

รูปที่ ก.5 หน้า กรอกรหัสผ่าน ของเครื่องวัดค่าดัชนีมวลกาย

ขั้นตอนที่ 4 เมื่อเราเลือกผู้ใช้ทั่วไปใน หน้าเมนู หรือเข้าสู่ระบบส าเร็จ จะมายังหน้า เริ่มต้น ดังรูปที่ ก.6 ให้เรากดปุ่ม เริ่ม เพื่อท าการวัดค่า โดยก่อนการกดปุ่มต้องยืนบนเครื่องวัดค่าดัชนี มวลกายในท่าที่ถูกต้องด้วย แสดงท่ายืนที่ถูกต้อง ดังรูปที่ ก.7


รูปที่ ก.6 หน้า เริ่มต้น ของเครื่องวัดค่าดัชนีมวลกาย


ไม่ถูกต้อง | ถูกต้อง

รูปที่ ก.7 ท่าใช้งานเครื่องวัดค่าดัชนีมวลกาย

ขั้นตอนที่ 5 เมื่อมีการกดปุ่มเริ่มแล้วหน้าจอจะไปยังหน้า อ่านค่า ดังรูปที่ ก.8 ให้รอ จนกว่าจะมีเสียงบอกว่า “ประมวลผลเสร็จสิ้น” แล้วค่อยก้มหน้ามามองที่หน้าจอได้


รูปที่ ก.8 หน้า อ่านค่า ของเครื่องวัดค่าดัชนีมวลกาย

ขั้นตอนที่ 6 หลังจากอ่านค่าและประมวลผลเสร็จสิ้น หน้าจอจะมายังหน้าแสดงผล เรา สามารถดูข้อมูลการใช้งานได้บนหน้าจอแสดงผล แสดงหน้าแสดงผล ดังรูปที่ ก.9 โดยในหน้าแสดงผล ของสมาชิกจะสามารถกดปุ่ม บันทึก เพื่อบันทึกข้อมูลไว้ดูย้อนหลังได้


ผู้ใช้ทั่วไป | สมาชิก

รูปที่ ก.9 หน้า แสดงผล ของเครื่องวัดค่าดัชนีมวลกาย

### 2. การใช้งานระบบบันทึกค่าดัชนีมวลกาย

ขั้นตอนที่ 1 เข้าไปที่ www.ecpbmi.in.th จะมายังหน้าแรกของ ระบบบันทึกค่าดัชนี มวลกาย ดังรูปที่ ก.10 สามารถเลือกเข้าสู่ระบบหรือสมัครสมาชิกได้


รูปที่ ก.10 หน้าแรก ของระบบบันทึกค่าดัชนีมวลกาย

ขั้นตอนที่ 2 หากเลือกสมัครสมาชิกใน หน้าแรก ระบบจะมายัง หน้าสมัครสมาชิก ดังรูป ที่ ก.11 ให้กรอกข้อมูลให้ครบแล้วกดปุ่มสมัครสมาชิก


รูปที่ ก.11 หน้าสมัครสมาชิก ของระบบบันทึกค่าดัชนีมวลกาย

ขั้นตอนที่ 3 เมื่อเลือกเข้าสู่ระบบจาก หน้าแรก ระบบจะมายัง หน้าเข้าสู่ระบบ ดังรูปที่ ก.12 ให้กรอกเบอร์โทรศัพท์และรหัสผ่านที่ได้สมัครสมาชิกให้ครบแล้วกดปุ่มเข้าสู่ระบบ

รูปที่ ก.12 หน้าเข้าสู่ระบบ ของระบบบันทึกค่าดัชนีมวลกาย

ขั้นตอนที่ 4 เมื่อเข้าสู่ระบบส าเร็จ ระบบจะไปยัง หน้าหลัก คือหน้าแสดงประวัติการใช้ งานเครื่องวัดค่าดัชนีมวลกายย้อนหลัง แสดงหน้าหลัก ดังรูปที่ ก.13


รูปที่ ก.13 หน้าหลัก ของระบบบันทึกค่าดัชนีมวลกาย

ประวัติผู้เขียน

ประวัติผู้เขียน

ชื่อ-นามสกุล | นายทัศนะ แก้ววันทา
วัน-เดือน-ปีเกิด | 26 กุมภาพันธ์ 2541
ที่อยู่ | 196 หมู่ 3 ต าบลหนองเรือ อ าเภอหนองเรือ จังหวัดขอนแก่น
| 40210
อีเมล | Thatsana.ka@rmuti.ac.th
เบอร์โทรศัพท์ | 0629077447

ประวัติการศึกษา
ระดับประถมศึกษา | โรงเรียนอนุบาลศุภมน
| ปีการศึกษา 2553
ระดับมัธยมศึกษาตอนต้น โรงเรียนหนองเรือวิทยา
| ปีการศึกษา 2556
ระดับมัธยมศึกษาตอนปลาย โรงเรียนหนองเรือวิทยา
| ปีการศึกษา 2559

ประวัติผู้เขียน

ชื่อ-นามสกุล | นายนราพัฒน์ อินต๊ะสุวรรณ์
วัน-เดือน-ปีเกิด | 8 พฤศจิกายน 2540
ที่อยู่ | 37 หมู่ 5 ต าบลบ้านกง อ าเภอหนองเรือ จังหวัดขอนแก่น
| 40240
อีเมล | Naraphat.in@rmuti.ac.th
เบอร์โทรศัพท์ | 0868582713

ประวัติการศึกษา
ระดับประถมศึกษา | โรงเรียนบ้านหนองเม็กหนองทุ่มโนนศิลาประชาสรรค์
| ปีการศึกษา 2553
ระดับมัธยมศึกษาตอนต้น โรงเรียนจระเข้วิทยายน
| ปีการศึกษา 2556
ระดับมัธยมศึกษาตอนปลาย โรงเรียนจระเข้วิทยายน
| ปีการศึกษา 2559
