narinthon-so/Mushroom-project/Documents/เล่ม/ปก.pdf

### โรงเพาะเห็ดอัจฉริยะ Smart Mushroom Farm

นายนรินทร สอนชัยภูมิ
นายวรรรณณรงค์ สถิตวิทยกูล

ปริญญานิพนธ์เป็นส่วนหนึ่งของการศึกษาตามหลักสูตรปริญญาวิศวกรรมศาสตรบัณฑิต สาขาวิชาวิศวกรรมคอมพิวเตอร์ คณะวิศวกรรมศาสตร์ มหาวิทยาลัยเทคโนโลยีราชมงคลอีสาน วิทยาเขตขอนแก่น พ.ศ.2563
ลิขสิทธิ์ของคณะวิศวกรรมศาสตร์ มหาวิทยาลัยเทคโนโลยีราชมงคลอีสาน
