narinthon-so/Mushroom-project/Documents/อ้างอิง/m015.pdf

เห็ดนางฟ้ า

ล ักษณะเห็ดนางฟ้ า (http://www.doae.go.th/Library/html/detail/nangfa/nangfa1.htm)

วงจรชวิ ีตของเห็ดนางฟ้ า (http://www.doae.go.th/Library/html/detail/nangfa/nangfa2.htm)

ข ั้นตอนการเพาะเห็ดนางฟ้ า (http://www.doae.go.th/Library/html/detail/nangfa/nangfa3.htm) เห็ดนางฟ้ า

เห็ดนางฟ้ามีรูปรางล ่ | กษณะคล ั | ายคล ้ | งกึ บเห ั ็ดนางรม เห็ดทงสองชน ั้
ดนิ ี้จัดอยในวงศ ู่ | (family) ์ | เดยวก ี ัน
ชอ

ื่ "เห็ดนางฟ้า" เป็นชอท

ื่ ี่ตั้งขนในเม ึ้ | องไทย ื | คนไทยบางคนเรยกว ี | าเห่ ็ดแขก เนองจากม
ื่ | ีผู ้พบเห็นเห็ดนคร
ี้ ั้ง
แรกทประเทศอ ี่
นเด ิ ีย พบขนตามธรรมชาต ึ้ | บนตอไม ิ | เน้ ออ

ื้

อนท ่ ี่กําลงผั ุ ในแถบเมองแจมม ื | ( ู Jammu) บรเวณิ
เชงเขาห ิ | มาล ิ ัย ชอว

ื่
ทยาศาสตร ิ | ์คือ Pleurotus sajor-caju (Fr.) Singer
เห็ดนางฟ้าถกนู ําไปเลยงในอาหารว ี้ | | นเป ุ ้ ็นคร

ั้งแรกโดย Jandaik ในปีค.ศ. 1947 ต่อมา Rangaswami
และ Nadu แห่ง Agricultural University, Coimbattore ในอนเด ิ | ยเป ี ็นผู ้นําเชอบร
| | | | ื้ ิสุทธของเห
ิ์ | ็ดนางฟ้าเขามาฝาก ้
ไว ้ที่ American Type Culture Collection (ATCC) ในอเมรกาเม ิ | อปื่ ีค.ศ. 1975 ไดทราบว ้ | าประมาณป ่ | ีค.ศ.
1977 ทางกองวิจัยโรคพืช กรมวชาการเกษตร ิ | เป็นผู ้นําเชอจาก
ื้ | ATCC เขามาประเทศไทยเพ ้ | อทดลองเพาะด
| | | | ื่ | ู
ปรากฏว่าสามารถเจริญได ้ดี
อีกสายพันธหนุ์ ึ่ง เป็นเห็ดที่มีผู ้นําเขามาจากประเทศภ ้ | ฐาน ู | มาเผยแพร่แก่นักเพาะเห็ดไทย ได ้มีการ
เรยกชอเห ี ื่ ็ดนี้ว่า เห็ดนางฟ้าภฐาน ู | มีหลายสายพันธซงชอบอ ุ์ ึ่
ณหภ ุ | ูมิที่แตกตางก ่ ัน บางพันธออกได ุ์ | ้ดีในฤดูร ้อน
บ ้างพันธออกได ุ์ | ้ดีในฤดหนาว ู | เป็นที่นิยมมาเพาะเป็นการคาก้ นมาก ั
ลักษณะของดอกเห็ดนางฟ้า มีลักษณะคลายก ้ | บดอกเห ั | ็ดเป๋าฮอ
| | | | ื้ และดอกเห็ดนางรม เมอเปร ื่
ยบเท ี | ยบี
กับเห็ดเป๋าฮอ

ื้
ดอกเห็ดนางฟ้าสจะอ ี | อนกว ่ | ่า และมคร ี บอย ี | ชดก ู่ ิ นมากกว ั | ่า เห็นนางฟ้าสามารถเก็บไวในต ้ | เยู ้ ็นนาน
ได ้หลายวัน เชนเด ่ | ยวก ี | บเห ั ็ดเป๋าฮอ

ื้
| | เนองจากเห
ื่ | ็ดชนดนิ ไมี้ ่มีการยอต่ วเหม ั | อนก ื | บเห ั ็ดนางรม ด ้านบนของดอกจะ
มีสนวลๆ ี | ถึงสนีํ้
าตาลออน่ | ในอนเด ิ | ยดอกเห ี | ็ดมขนาดต ี | งแต
ั้ | ่ 5 - 14 เซนตเมตร ิ | และจะมีนํ้าหนักอยระหว ู่ | าง่ 30 -
120 กรัม เห็ดนางฟ้ามรสอร ี | อย่ เวลานําไปปรงอาหารจะม ุ | กลี นชวนร ิ่ | ับประทาน เห็ดชนดนิ สามารถน ี้ | ําไปตากแห้ง
เก็บไวเป้ ็นอาหารได ้เมอจะน
ื่ | ําเห็ดมาปรงอาหาร ุ | ก็นําไปแชน่ ํ้
าเห็ดจะคนร ื ปเด ู | มได ิ | ้

วงจรชวิ ีตของเห็ดนางฟ้ า

วงจรชวีตของเห ิ | ็ดนางฟ้าก็เป็นแบบเห็ดทําลายไม ้ทั่ว ๆ ไป คือมชวี ีตอย ิ ู่ข ้ามฤดูอัตคัด ด ้วยคลามีโด
สปอรในท ์ | อนไม ่ | ้พอถงฤด ึ ูชุมชนก
่ ื้ ็งอกออกมาเป็นเสนใย ้ | แลวสร ้ างดอกเห ้ | ็ดขึ้น ปลอยสปอร ่ | ลอยไป ์ | สปอรงอก ์
เป็นเสนใยแ ้ | ล ้วเจรญไปบนอาหารจนสร ิ | างดอกเห ้ | ็ดอีก วนเวยนไปอย ี | างน ่ ี้
เห็ดนางฟ้าเตบโตด ิ | ีที่ pH. 5 - 5.2 (คือเป็นกรดเล็กนอย้ ) อุณหภูมิที่เหมาะมากตอเสนใยค ่ ้ | ือ 32 องศา
เซลเซยสี และสรางดอกเห ้ | ็ดได ้ดีที่ 25 องศาเซลเซยสี | ้ | ี เสนใยสขาวจัด มีความสามารถเชอมต
ื่ | ้ ่อเสนใยได ้ดีใช ้
นํ้าตาลในแงของอาหารคาร ่ | โบไฮเดรตได ์ | ้ดีกวาพวก ่ | โพลแซคคาไรค ี | ์หรืออาหารซบซอน ั ้


วงจรชวีตเห ิ ็ดนางฟ้า

1. ดอกเห็ดนางฟ้าเมอโตเต ื่ | ็มทจะสร ี่ | างสปอร ้ | บร ์ ิเวณครีบ โดยการปลอยสปอร ่ | เม์ อแก
ื่ | ออกเป ่ | ็นระยะ ๆ
2. เมอดอกเห
ื่ | ็ดปลอยสปอร ่ | ออกมาแล ์ | ้ว สปอร์ก็ปลวไปตามกระแสลม ิ
3. เมอสปอร ื่ | ปล์ วไปตกในสภาพแวดล ิ | อมท ้ | เหมาะสม ี่ | ก็จะงอกออกมาเป็นเสนใยข ้ | นต
ั้
นม้ ี1 นิวเคลยสี
4. เสนใยข ้ นท
ั้ ี่ 1 เมอเจร

ื่
ญเต ิ ็มทแล

ี่ ้ว ก็จะมารวมตวกั ัน ซงอาจมาจากต

ึ่ | างสปอร ่ | ์กัน การรวมตัวของเสน้
ใยขนท

ั้ ี่ 1 จะเป็นการเชอมก

ื่
นแล ั | วถ้ ายทอดน ่ | วเคล ิ | ยสมาอย ี | ในเซลเด ู่ | ยวก ี ัน กลายเป็นเสนใยข ้ | นท
ั้ | 2 ี่
5. หลงจากเสนใยข ั | ้ | นท
| ั้ ี่ 1 รวมตวกั นเป ั ็นเสนใยข ้ | นท
ั้ ี่ 2 แล ้ว ก็จะเจรญเต ิ | บโตและสร ิ | างเสนใยเห ้ | ้ | ็ดแทน
เสนใยข ้ | นท
ั้ ี่ 1 อยางรวดเร ่ | ็วบนอาหาร
6. เมอเสนใยข ื่ ้ | นท
| ั้ ี่ 2 เจรญบนอาหารและโตเต ิ | ็มทแล
ี่ ้ว จะสะสมอาหารแลวรวมต ้ | วกั นอั กคร ี ั้
| | | | | | | งเพอสร ื่
าง้
ดอกเห็ดตอไป ่
7. ดอกเห็ดนางฟ้าทเก
| ี่
ดจากการรวมต ิ | วของเสนใยเห ั | ้ | ็ดขนท
| | | | ั้ ี่ 2

ข ั้นตอนการเพาะเห็ดนางฟ้ า

การเพาะเห็ดนางฟ้ามระบบการผล ี | ตแยกชดเจนได ิ | ั | เป้ ็ น 4 ขั้นตอนดวยก ้ ัน คือ 1) การผลตเชอว ิ ื้ ุ ้น 2)การ
ทําหวเชอเห ั ื้ ็ด 3)การผลตเชอถ ิ ื้
งหร ุ | อกื อนเชอ ้ | ื้ 4)การเพาะใหเก้ ดเป ิ ็นดอกเห็ด การลงทนจะมากในข ุ | นตอนท
ั้ | ี่ 1 -
3 สวนขนท
ั้ ี่ ่ | 4 คือการผลตดอกเห ิ | ็ด จะทําขนาดเล็กใหญเท่ าใดก ่ | ็ได ้ไม่ต ้องลงทนมาก ุ | หรอจะด ื | ดแปลงจาก ั
โรงเรอนอ ื | นๆ
| ื่ ที่มีอยแลู่ ้ว และทวางอย
ี่ | มาใชได ู่ | ้ ้และในขนตอนน
ั้ | ี้ผู ้ที่ต ้องการเพาะจะทําครบทกขุ นตอนเลยก
ั้ | ็ได ้
หรออาจจะท ื | ําเป็นบางขนตอน
ั้ | เชน่ จะทําเฉพาะหวเชอเห ั ื้ ็ด โดยการนํากอนเชอท ้ | ื้ | ํ ี่ทําสาเร็จรปแล ู | วมาเป ้ | ิดออก
รดน
ํ้าใหเก้ ดดอกเห ิ | ็ดเลยก็ได ้ซงระบบการต
ึ่ | งฟาร ั้
มเห ์ ็ด ได ้รับการแนะนําให้ทําเป็นขั้น ๆ ดังตอไปน ่ | ี้

### 1. เรมเร

| ิ่
ยนร ี ู้วิธีการกนเห ิ ็ด เราจะทําธรกุ จเหิ ็ดตองก ้ | นเห ิ ็ดเก่ง ต ้องปรุงอาหารจากเห็ดหลายชนิด
ทําใหอร้ อยด ่ | วย้ สามารถแนะนําผซอเห ู ้ ื้ ็ดไปปรงเองได ุ | อย้ างม ่ | นใจ ั่ | เชนน่ ี้ทําใหเราพร ้ | อมต ้ | อการขายเห ่ | ็ด

### 2. ผลิตดอกเห็ดขาย 90% ของฟารมเห ์ ็ดที่ทําอยเรู่ มจากว

ิ่ | ิธีนี้โดยทําโรงเรอนขนาดย ื | อมๆ ่ | เพอใช ื่ ้
เพาะเอาดอกเห็ด ซอถ
ื้ | ื้ งเชอจากฟาร ุ | มมาผล ์ | ตดอก ิ | โดยหาความชานํ านและความรไปเร ู ้ | อยๆ
ื่ | จนเชยวชาญ
ี่ | ขั้นน
ี้
อยาเพ่ งลงท

ิ่

นทุ ําถงเชอเอง ุ ื้ | ใหซอถ ้ ื้ | ื้ งเชอจากฟาร ุ | มท์ ี่ทําขายดกวี ่า เรมจากน
| | | | ิ่
อยๆ ้ | ทยอยทํา ไดเห้ ็ดมาก็นําไป
ขายตลาด ขายเองหรอสงแม ื ่ | ่ค ้าก็ได ้ขยายตลาดดอกเห็ดเพมมากข
ิ่ | นไปเป ึ้ | ็นลําดับ จนตลาดใหญ่ขึ้นและ
สมํ่าเสมอดแลี วจ้ งคึ ดผล ิ | ตถิ งเชอ ุ ื้
แต่ถ ้าตลาดไปไมได่ ้ก็หยดแค ุ | ่นั้น ไมขาดท ่ | นมาก ุ

### 3. ผลิตถงเชอเห ุ ื้ ็ด ถ ้าตลาดรับซอเห็ ื้

| | ดและถงเชอมากพอ ุ ื้ | | จึงตงหน
ั้ | ่วยผลตถิ งเชอได ุ ื้ | ้แต่ถ ้าคํานวณ
ว่าซอถ

ื้

งถุ กกว ู | าผล ่ | ตเองก ิ | ็ไมควรท ่ | ํา ควรไปดฟาร ู | มท์ ําถงเชอหลาย ุ ื้
ๆ ฟาร์ม แลวมาค ้ | ํานวณวาเคร ่ | องม

ื่
| | | | | | | อและ ื
วิธีการแบบใดดีที่สุด เตรยมการเอาคนค ี | มงานไปฝ ุ | ึกงานในฟาร์ม หรอตื ดติ อจ่ างคนชานาญในฟาร ้ | ํ | มเก ์ | ามาท ่ | ํา
ฟารมใหม ์ | ่ ขั้นตอนนี้ก็ควรซอเชอข
ื้ ื้ าวฟ้ ่าง ยังไมควรท ่ | ําเอง การลงทนขนาดเล ุ | ็กจะใชหม้ อต้ มไอน ้ | ํ้
าตางหาก ่
(สตมเม ี | อร ่ )์ แลวต้ อท่ อมาอบถ ่ | งขุ เล
| ี้ อยในอ ื่
กหม ี | อต้ างหาก ่ | ถ ้างานนมากข
| | | | ี้ นเร

ึ้
อยๆ

ื่
จนเห็นสมควร แลวค้ อยผล ่ ิต เชอข

ื้ างฟ้ ่างและซอว

ื้
นตุ ้ อไป ่
4. ผลิตเชอวื | ื ้ | ้ นและเชอข ุ้ | าวฟ ้ ่ าง เรมท
ิ่ ําเมองานฟาร ื่
มม์ ขนาดใหญ ี | มาก ่ | สาหร ํ ับระยะ 1 - 2 ปีที่ผ่าน
มาน

ั้
นถาย้ งไม ั ่ทําเชอว
ื้ | ื้
นและเชอข ุ ้ | าวฟ้ ่างมากอน่ ก็ไมควรท ่ | ําขนใหม ึ้ | ่ มีผู ้ทําขายมากอยแลู่ ้ว ซอเขาใชด ื้ | ้
กวี ่า
นอกจากจะหางไกลซอยากจร ่ | ื้
งๆิ แลวต้ องใชมากจ ้ | ้ | งคึ อยท ่ | ํา

# การเพาะเห

# ็ดนางฟ้า นางรม

การเพาะเห็ดนางฟ้ า นางรม
เห็ดนางฟ้ า เห็ดนางรม เป็นเห็ดทสามารถเก ี่ | ดขิ นได ึ้ | ้ทุกสภาวะอากาศของเมองไทยเรา ื | โดยเฉพาะ
อยางย ่ | งภาคอ ิ่ | สานของเรา ี | ซงมึ่ สภาพอากาศค ี | อนข ่ | างร ้ | อนอบอ ้ | าว้ จึงมีความเหมาะสม ในการเพาะเห็ดนางฟ้านางรม
เห็ดทงสองชน ั้ | ดนิ เปี้ ็นที่รู้จ ักแพรหลายของผ ่ | ู้นิยมบริโภคเห็ด และราคาก็ไมแพงมากจนเก ่ | นไป ิ | สามารถเลยงเป ้ี | ็นอาชพี
หลกหร ั | ออาชพเสร ื | ี | มได ิ | ้
ว ัสดการใชเพาะเห ุ | ้ | ็ดนางฟ้ า นางรม
สวนมากจะใชข ่ | ้ เล้ี อยไม ื่ | ยางพารา ้ | หรอขื เล้ี อยไม ื่ | เบญจพรรณ ้ | หรือใชฟางข้ ้ | าวก็ได้ตาม ฟารมเห ์ ็ด
ท ั่วไปแลวเพ้ | อความสะดวกในการหม ื่ | กและผสมว ั | สดั ุจึงนยมใชข ิ | ้ เลี้ อยไม ื่ | ยางพารา ้
ซงเปึ่ ็นขเล้ี อยไม ื่ | เน้ ออ้ื อนและม ่ | สารอาหารท ี | ี่มีคุณคาในการเพาะเห ่ | ็ดมาก
อ ัตราสวนในการผสมว ่ | สดั ุอื่น ๆ
1. ขีเล้ อยื่ | 100 กก.
2. รําละเอยดี | 6 กก.
3. ปูนขาว 2 กก.
4. ดีเกลือ 0.2 กก.

### 5. นํ้าสะอาด 60 %

ว ัสดุท ั้งหมดนสามารถปร ้ี | บเปล ั | ยนเพ ี่ | อความเหมาะสมได ื่ | เม้ อชงหร ื่ ั่ | อตวงว ื | สดั ุท ั้งหมดแล้ว คลกเคล ุ | าให ้ | เข้ าก้ นและหม ั | ั่น
ตรวจดความชนบ ู | ื้ อย่ | ๆ เพอไม ื่ | ให่ ้ว ัสดเปุ ียกแฉะจนเกนไป ิ | ซงจะ ึ่ | ทําให้มีผลในการทําใหเชอเห ้ ื้ ็ดไมเด่ ิน
การบรรจุถุง | ใชถ้ | ํ งสาหร ุ | บการเพาะเห ั | ็ดโดยเฉพาะขนาด 6 / ด 12 / นิ้ว โดยกรอกวสดั ุที่ผสมลงให้เต็มถุง ใชม้ ือ
ปาดปากถงแล ุ | วกระแทกแรง ้ | ๆ ทุบใหแน้ นท่ ี่สุด ใสคอขวดพลาสต ่ | ิก แลวป้ ิดฝา ด้วยจกสาล ุ ํ ีจากนนนั้ ําไปนงฆึ่ าเชอให ่ ื้ | ้มี
ความรอนประมาณ ้ | 100 องศาเซลเซยลี | นาน 3 ชม. ปลอยท ่ | งไว ิ้ | ให้ เย้ ็นจงเขึ | ยเชอเห ี่ ื้ ็ด
ล ักษณะเชอเห ื้ ็ดที่ดี จะตองไม ้ | ่มีเชอราอ ื้ | ื่น ๆ เจอปื น เชน่ ราดํา ราเขยวี ราสม้ ปนเปื้อน อยในขวดเชอน ู่ | ื้ ั้น เพราะจะทําให้ถุง
เพาะเชอเห็ ื้ | ดตดโรคราอ ิ | นได ื่ | ้โดยสงเกตด ั | ้ เสนใยของเชอเห ู | ื้ ็ดจะตองม ้ | เสนใย ี ้ | สขาวบร ี | ิสุทธและด ์ | นเต ิ ็มขวด

วิธีเขยเชอเห ี่ ื้ ็ด ให้ทําความสะอาดวสดั ุท ั้งหมดโดยฆาเชอด ่ ื้ ้วยแอลกอฮอล์คือ

1. เชดม็ อดื วยแอลกอฮอล ้ | ให์ สะอาด ้
2. ใชแอลกอฮอล ้ | เชดขวดเชอให ์ ็ | ื้ | ้ท ั่วขวด
3. เอาขวดทเชดด ี่ ็ วยแอลกอฮอล ้ | แล์ วใชปากขวดลนตะเก ้ ้ | ยงแอลกอฮอล ี | เพ์ อฆื่ าเชอ ่ ื้ แลวจ้ งเขึ | ยเชอได ี่ ื้ | ้

การพกเชอเห ั ื้ ็ด
เมอเสร ื่ | ็จสนขบวนการเข ิ้ | ยเชอเห ี่ ื่ ็ดแล้ว จึงนําเอากอนเชอเห ้ | ื้ ็ดทเขี่ ยแล ี่ | วไปพ ้ | กไว ั | ในโรงพ ้ | ัก เชอเพื้ | อให ื่ | ้
เชอเห ้ื ็ดทเขี่ ยแล ี่ | วไปพ ้ | กไว ั | ในโรงพ ้ | กเชอเพ ั ื | ื่
้ | อให ื่ | เชอเห ้ | ็ดเดนในถ ิ | งเพาะเต ุ | ็มท ี่ จากนั้น นําเขาโรงเร ้ | อนเพ ื | อปื่ ิดดอกซงใช ึ่ ้
ระยะเวลาในการพกเชอประมาณโดยเชอเห ั ื้ | ื้ ็ดนางฟ้ า 25 ว ัน เชอเห ื้ ็ดนางรม 25-30 ว ัน จึงทาให ํ | เก้ ดดอกและสามารถ ิ
เก็บบรโภค ิ | และจาหน ํ | ายได ่ | ้

การให้นํ้าเห็ด
เห็ดนางฟ้ า นางรม ควรรดนํ้าวนละ ั | 3 เวลา เชา้-เทยงี่ -เย็น โดยใหละอองน ้ | ํ้าอยเหน ู่ ือ ถุงเห็ด ท ั้งหมด และ
ไมให่ ้นํ้าเขาในคอขวดของ ้ | ถุง โดยเฉพาะ กรณีที่มีฝนตกตลอดทงวั้ ัน อาจจะรด เชา้-เย็น ก็ได ้

การเก็บดอก
ควรเก็บดอกที่มีขนาดโตเต็มที่ด้วยการสงเกตหมวกของดอกเห ั | ็ดมีล ักษณะบาน และให้ทํา ความสะอาด
รากของเห็ดหลงจากการเก ั | ็บดอกเห็ดทกคร ุ | ั้ง

การแปรรูปดอกเห็ด
เห็ดนางฟ้ า นางรม สามารถทจะแปรร ี่ | ปดู วยการอบแห ้ | ้ง ดองเพอบรรจ ื่ | กระป ุ | ๋อง ทําลาบเห็ด ยําเห็ด ทํา
แหนมเห็ด ทําแจวบองเห ่ | ็ด ฯลฯ ซงสามารถปร ึ่ | บปร ั | งสุ ตรการแปรร ู | ปได ู | ้
