narinthon-so/Mushroom-project/Documents/งานวิจัยที่เกี่ยวข้อง/d805b1b7b059305477b017e7bfcfa022ea817c2e.pdf

## โครงงาน โรงเพาะเห็ดระบบอัตโนมัติ

### กฤษณะ มุยสกุล, ดุลยรัตน เศรษฐกุลนนท

สาขาวิชาเทคโนโลยีอิเล็กทรอนิกส, คณะเทคโนโลยีอุตสาหกรรม, มหาวิทยาลัยราชภัฏสวนสุนันทา
1 ถนนอูทองนอก แขวงดุสิต เขตดุสิต กรุงเทพมหานคร 10300

บทคัดยอ -ปญหาในปจจุบันในดานเกษตรกรหรือครัวเรือนในการดูแลและจัดการพืชพันธุทาง การเกษตรมีปญหาคอนขางมากในการควบคุมดูแลงบประมาณที่จะตองเสียไปทั้งคาน้ําหรือคาจางบุคลากรใน การดูแลพืชพันธุทางการเกษตรในดานตาง ๆ และวงจรชีวิตของเห็ดนางฟา มีการเติบโตไดดีที่ อุณหภูมิที่ เหมาะมากตอเสนใยคือ 32 องศาเซลเซียส และสรางดอกเห็ดไดดีที่ 29 องศาเซลเซียส เหตุผลนี้จึงไดนําเทคโนโลยีเขามาควบคุมและดูแลจัดการในดาน วัดอุณหภูมิ ความชื้น การระบาย อากาศ และการใหน้ําของเห็ด และดูแลพืชพันธุทางการเกษตรในดานตาง ๆ ปญหาภัยแลงที่รบกวนหัวใจเกษตรกรและครัวเรือน จะบรรเทาลงดวยการนําเทคโนโลยีมาใชเพื่อควบคุมและ ดูแลจัดการในดาน วัดอุณหภูมิ ความชื้น การระบายอากาศ และการใหน้ําและดูแลเห็ด ตาง ๆ ชุดอุปกรณควบคุมการรดน้ําอัจฉริยะตนทุนต่ํา เสริมแกรงเกษตรกรไทยยุค 4.0 รับภัยแลง พึ่งพา ตนเองไดอยางยั่งยืน
ทั้งนี้ ระบบควบคุมอุณหภูมิและความชื้นอัตโนมัติในโรงเรือนเพาะเห็ด ชวยควบคุมปริมาณการใชน้ํา ตามเวลาที่กําหนดทําใหชวยลดการใชน้ําในการเกษตรไดไมต่ํากวา 3 เทา และยังถือเปนการกระจายองค ความรูนวัตกรรมเพื่อประยุกตใชจริงในการเกษตรดวยตนทุนที่ต่ําที่เกษตรกรเขาถึงได

คําสําคัญ -เกษตรกร, เห็ด, ระบบควบคุมอุณหภูมิและความชื้นอัตโนมัติ

# การประชุมวิชาการสำ หรับนักศึกษาระดับชาติ ครั้งที่ ๒

The Second FIT SSRU Conference 2019

วันศุกร์ที่ 7 มิถุนายน 2562 ณ คณะเทคโนโลยีอุตสาหกรรม มหาวิทยาลัยราชภัฏสวนสุนันทา
- 69 -

## Automated Mushroom Project

### Kirtsana Murtskun Student, Dulyarut Sretkullanon

Department of Electronic Technology, Faculty of Industrial Technology, Suan Sunandha Rajabhat University
1 U Thong Nok Road, Dusit, Khet Dusit, Bangkok 10300

Abstract - Current problems in the field of farmers or households in the care and management of agricultural crops have a lot of problems in controlling the budget that must be wasted, including water or wages, personnel in the care of agricultural plants in different fields. And the life cycle of fairy mushrooms Has grown well at The ideal temperature for the fibers is 32 degrees Celsius and can create a good mushroom at 29 degrees Celsius.
For this reason, technology has been used to control and manage the temperature, humidity, ventilation. And the watering of mushrooms And take care of agricultural plants in various fields
Drought problems that disturb the hearts of farmers and households Will be mitigated by applying technology to control and manage the temperature, humidity, ventilation And watering and caring for mushrooms
Low-cost intelligent watering control equipment set Strengthening Thai farmers in the 4.0 era, receiving sustainable drought, self-reliance
The automatic temperature and humidity control system in mushroom cultivation house Helps control water usage at a given time, helping to reduce water consumption in agriculture by at least 3 times, and is also considered to be an innovative knowledge distribution for practical application in agriculture at a low cost that farmers can access.

Keywords - farmers, mushrooms, automatic temperature and humidity control systems

# การประชุมวิชาการสำ หรับนักศึกษาระดับชาติ ครั้งที่ ๒

- 70 -

### บทนํา

ปญหาในปจจุบันในดานเกษตรกรหรือ ครัวเรือนในการดูแลและจัดการพืชพันธุทาง การเกษตรมีปญหาคอนขางมากในการควบคุมดูแล งบประมาณที่จะตองเสียไปทั้งคาน้ําหรือคาจาง บุคลากรในการดูแลพืชพันธุทางการเกษตรในดาน ตาง ๆ และวงจรชีวิตของเห็ดนางฟา มีการเติบโต ไดดีที่ อุณหภูมิที่เหมาะมากตอเสนใยคือ 32 องศา เซลเซียส และสรางดอกเห็ดไดดีที่ 29 องศา เซลเซียส
เหตุผลนี้จึงไดนําเทคโนโลยีเขามาควบคุมและดูแล จัดการในดาน วัดอุณหภูมิ ความชื้น การระบาย อากาศ และการใหน้ําของเห็ด และดูแลพืช พันธุทางการเกษตรในดานตาง ๆ ปญหาภัยแลงที่รบกวนหัวใจเกษตรกรและ ครัวเรือน จะบรรเทาลงดวยการนําเทคโนโลยีมาใช เพื่อควบคุมและดูแลจัดการในดาน วัดอุณหภูมิ ความชื้น การระบายอากาศ และการใหน้ําและ ดูแลเห็ด ตาง ๆ
ชุดอุปกรณควบคุมการรดน้ําอัจฉริยะตนทุนต่ํา เสริมแกรงเกษตรกรไทยยุค 4.0 รับภัยแลง พึ่งพา ตนเองไดอยางยั่งยืน ผานสวนประกอบ 5 สวน คือ
1) ระบบควบคุมการเปด-ปดน้ําอัตโนมัติ ในโรง เพาะเห็ดระบบอัตโนมัติ
2) ระบบเซ็นเซอร ตรวจวัดอุณหภูมิและความชื้น ใหอยูในระดับที่เหมาะสม
3) ระบบตรวจดูเห็ดในโรงเพาะเห็ดระบบอัตโนมัติ โดยสามารถดูผานสมารทโฟน และบนเว็บไซต ออนไลนได
4) ระบบระบายอากาศ ตามอุณหภูมิที่เหมาะสม ทางการเกษตร
5) ระบบสั่งการผานสมารทโฟน และบนเว็บไซต ออนไลน การติดตามผล พรอม ควบคุมความชื้น และอุณหภูมิ ของเห็ดตามตองการ


ทั้งนี้ ระบบควบคุมอุณหภูมิและความชื้นอัตโนมัติ ในโรงเรือนเพาะเห็ด ชวยควบคุมปริมาณการใชน้ํา ตามเวลาที่กําหนดทําใหชวยลดการใชน้ําใน

การเกษตรไดไมต่ํากวา 3 เทา และยังถือเปนการ กระจายองคความรูนวัตกรรมเพื่อประยุกตใชจริง ในการเกษตรดวยตนทุนที่ต่ําที่เกษตรกรเขาถึงได โดยเกษตรกรสามารถหาซื้ออุปกรณตาง ๆ เพื่อ นํามาประกอบเองไดในงบประมาณเริ่มตน 5,000 บาท สามารถใชกับพื้นที่แปลงเกษตรขนาด 1 ตารางกิโลเมตร หรือ 20 ไร เพื่อชวยเพิ่ม ประสิทธิภาพในการบริหารจัดการน้ําในแปลง เกษตร

### วัตถุประสงคของการวิจัย

1. เพื่อสราง โรงเพาะเห็ดระบบอัตโนมัติ
2. เพื่อลดคาใชจายของเกษตรกร

### วิธีการวิจัย

สําหรับรายละเอียดในบทนี้จะแสดงถึง ขั้นตอน และวิธีการดําเนินโครงงานปริญญานิพนธ โดยมีลําดับขั้นตอนดังตอไปนี้

### 1. กําหนดรูปแบบการทํางานของเครื่อง 2. ออกแบบ และสรางโครงสราง 3. ฟงกชัน และระบบการทํางาน

### 1. กําหนดรูปแบบการทํางานของเครื่อง

ลักษณะการทํางานของระบบควบคุมอุณหภูมิ และ ความชื ้นภายในโรงเพาะเห็ดนั ้น มีการทํางาน ร ว ม กั น ข อ ง อุ ป ก ร ณ ห ล า ย ส ว น โ ด ย มี ไมโครคอนโทรลเลอรเปนตัวควบคุมการทํางาน ทั้งหมดบล็อกไดอะแกรมแสดงการทํางานของ ระบบควบคุมอุณหภูมิ และความชื้นภายในโรง เพาะเห็ด

# การประชุมวิชาการสำ หรับนักศึกษาระดับชาติ ครั้งที่ ๒

- 71 -

รูปที่ 1 บล็อกไดอะแกรมระบบควบคุมอุณหภูมิ และความชื้นในโรงเพาะเห็ด
เปนบล็อกไดอะแกรมที่แสดงถึงระบบการทํางาน ในโครงงานโรงเพาะเห็ดระบบอัตโนมัติ ดังใน รูปภาพ


รูปที่ 2 บล็อกไดอะแกรมระบบควบคุมอุณหภูมิ และความชื้นในโรงเพาะเห็ด
การทํางานของระบบควบคุมอุณหภูมิ และ ความชื้นภายในโรงเพาะเห็ด เริ่มจากการเซ็ตและ ตั้งคา ไมโครคอนโทรลเลอร อาดูโน ในกลอง ควบคุมภายในโรงเพาะเห็ดใหมีอุณหภูมิ และ ความชื้นตามที่ตองการ ตัวตรวจจับ DHT 22 ทํา หนาที่ตรวจจับ อุณหภูมิ และความชื้น นําคาที่วัด ไดสงสัญญาณขอมูลกลับมายังตัไมโครคอนโทรล เลอรเพื่อทําการประมวลคาอุณหภูมิ และความชื้น วาตรงตามที่ตั้งไวหรือไม เมื่ออุณหภูมิภายในโรงเพาะเห็ดสูงเกินกวาที่ กําหนดไว ระบบจะสั่งใหวงจรขับพัดลมดูดอากาศ เขาใหทํางาน เปาลมเขาโรงเพาะเห็ดเพื่อทําให อุณหภูมิภายในคอย ๆ ลดลงจนถึงอุณหภูมิที่ กําหนด
หากอุณหภูมิ ภายในโรงเพาะเห็ดต่ํากวาที่กําหนด ไว ระบบจะสั่งใหวงจรขับกระแสไฟทํางาน เพื่อสง กระแสไฟ ไปยังหลอดไฟใหความรอนภายในโรง เพาะเห็ดเพื่อทําให อุณหภูมิภายในคอย ๆ สูงขึ้น จนถึงอุณหภูมิที่กําหนด


### 2. ออกแบบ และสรางโครงสราง

โครงสรางของโรงเพาะเห็ดระบบอัตโนมัติมีขนาด ความกวาง 1 เมตร ความยาว 1 เมตรความสูง 1 เมตร โรงเพาะเห็ดระบบอัตโนมัติใชอลูมิเนียม

กลองขนาด 1 นิ้วจํานวน 24 เสน จํานวน 12 เสน เปนโครงสรางหลัก สามารถวางขวดหัวเชื้อเห็ดได สูงสุด 40 ขวด แถวละ 10 ขวด จํานวน 2 แถว ของทั้งสองฝง โครงสรางของโรงเพาะเห็ดระบบ อัตโนมัติ มีสวนประกอบที่สําคัญ


รูปที่ 3 โครงสรางของโรงเพาะเห็ดระบบอัตโนมัติ โดยภาพที่เขียนในการออกแบบเปนภาพแบบไอโซ เมตริก (ISOMETRIC) เปนภาพที่มองเห็นสัดสวน ใกล และไกลออกไปมีขนาดเทากัน ลักษณะภาพ เปนภาพจริง สามารถวัดขนาดตาง ๆ ของดาน ความยาว ความกวาง และความสูงได

# การประชุมวิชาการสำ หรับนักศึกษาระดับชาติ ครั้งที่ ๒

- 72 -

รูปที่ 4 โครงสรางโรงเพาะเห็ดระบบอัตโนมัติ (ดานหนา)
เปนรูปภาพที่แสดงโครงสรางภายนอกของโรง เพาะเห็ดเพื่อใหเห็นรูปแบบของตัวโปรเจคที่ ชัดเจน


รูปที่ 5 โครงสรางโรงเพาะเห็ดระบบอัตโนมัติ (ดาน ใน)
โดยรูปจะแสดงภายในโครงสรางโปรเจคระบบ เพาะเห็ดอัตโนมัติโดยจะมีอุปกรณติดตั้งไวตามจุด ตางๆ ดังในรูป

### 3. ฟงกชัน และระบบการทํางาน


รูปที่ 6 แผนตรวจสอบ โรงเพาะเห็ดระบบอัตโนมัติ ผลการวิจัย
ผลการทดสอบ และบันทึกผลการทํางานของระบบ ควบคุมอุณหภูมิและความชื้นในโรงเพาะเห็ดที่ได ออกแบบสรางขึ้น โดยมีผลการทดสอบ และบันทึก ผลการทํางานดังนี้
รูปที่ 7 กราฟแสดงองศาเซลเซียส เปนรูปภาพแสดงการเก็บขอมูลระหวางวันขิงตัว โปรเจความีคาของอุณหภูมิเทาไหรเพื่อเก็บมาเปน ผลเฉลี่ย


ตารางที่ 1 การทดสอบวัดอุณหภูมิและความชื้นใน โรงเพาะเห็ดระบบอัตโนมัติ

วันที่ 12 พฤศจิกายน 2561 โรงเพาะเห็ดระบบ อัตโนมัติ สามารถควบคุมอุณหภูมิเฉลี่นอยูที่ 28.25 องศาสเซลเซียส ความชื้นเฉลี่ยอยูที่ 84 เปอรเซ็นตของความชื้นสัมพัทธ สวนโรงเรือนเพาะ เห็ดจริงสามารถควบคุมอุณหภูมิเฉลี่ยอยูที่ 31 องศาเซลเซียส ความชื้นเฉลี่ยอยูที่ 85.5 เปอรเซ็นต ของความชื้นสัมพัทธ


ตารางที่ 2 การทดสอบวัดปริมาณการใชน้ําใน จากการทดสอบวัดปริมาณการใชน้ําใน 1 สัปดาห คาเฉลี่ยตอวันคือ 41 ลิตร เทียบกับปริมาณการใช น้ําของโรงเพาะเห็ดจริงเฉลี่ยตอวันคือ 51 ลิตร จะ เห็นไดวาโรงเพาะเห็ดระบบอัตโนมัติจะมีปริมาณ การใชน้ํานอยกวาโรงเพาะจริงอยู 80.392 เปอรเซ็นต เมื่อเทียบอัตราสวนโรงเรือนที่เทากัน

กราฟของวันที่ 12 พฤศจิกายน 2561 จะเห็นวา อุณหภูมิ และความชื้นของโรงเพาะเห็ดระบบ อัตโนมัติจะมีความคงที่มากกวาโรงเรือนเพาะเห็ด

# การประชุมวิชาการสำ หรับนักศึกษาระดับชาติ ครั้งที่ ๒


- 73 -

จริง โดยความชื้นของโรงเรือนเพาะเห็ดจริงมีความ ผันผวนมากแสดงได
ตารางที่ 2 ปริมาณการใชไฟฟาของอุปกรณแตละ ชนิดในระบบ
จากการทดสอบวัดปริมาณการใชไฟฟา ไดคา ปริมาณการใชไฟฟาของแตละอุปกรณ และไดทํา การจับเวลาวัดระยะเวลาโดยเฉลี่ยอุปกรณทํางาน ใน 1 วัน ซึ่งแตละอุปกรณจะทํางานไมพรอมกัน เมื่อตั้งคาใหระบบทํางานโดยอัตโนมัติตลอด 1 สัปดาห และบันทึกผล จะไดคาปริมาณการใช ไฟฟาเฉลี่ยตอ 1 วันของระบบ เชน ขอมูล ณ วันที่ 12 พฤศจิกายน 2561 มีระยะเวลาเฉลี่ยที่อุปกรณ ทํางานใน 1 วันคือตูควบคุมรวม 24 ชั่วโมง พัดลม ดูดลมเขา 8 ชั่วโมง พัดลมดูดลมออก 4 ชั่วโมง ปม น้ํา 6 ชั่วโมง กลองวงจรปด 24 ชั่วโมง และ หลอดไฟใหความรอน 1 ชั่วโมง คํานวณไดจากสูตร คือ นําปริมาณการใชไฟฟาเมื่ออุปกรณทํางาน คูณ ระยะเวลาโดยเฉลี่ยที่อุปกรณทํางานใน 1 วัน และ นําผลที่ไดของแตละอุปกรณมาบวกกันจะได


ตารางที่ 2 ผลการวัดปริมาณการใชไฟฟาของ ระบบใน 1 สัปดาห
จากการทดสอบวัดปริมาณการใชไฟฟาใน 1 สัปดาหคาเฉลี่ยตอวันคือ 1.272 กิโลวัตต

### สรุปและอภิปรายผล

บทนี้จะกลาวสรุปถึง ผลการดําเนินงานการจัดทํา ปริญญานิพนธการสรางระบบควบคุมอุณหภูมิ และความชื้นในโรงเพาะเห็ดดังนี้

### สรุปผลการดําเนินงาน

การทํางานของระบบควบคุมอุณหภูมิ และ ความชื้นภายในโรงเพาะเห็ด เริ่มจากการเซ็ตและ

ตั้งคา ไมโครคอนโทรลเลอร อาดูโน ในกลอง ควบคุมภายในโรงเพาะเห็ดใหมีอุณหภูมิ และ ความชื้นตามที่ตองการ ตัวตรวจจับ DHT 22 ทํา หนาที่ตรวจจับ อุณหภูมิ และความชื้น นําคาที่วัด ไมโครคอนโทรลเลอร เพื่อทําการประมวลคา อุณหภูมิ และความชื้นวาตรงตามที่ตั้งไวหรือไม เมื่ออุณหภูมิ ภายในโรงเพาะเห็ดสูงเกินกวาที่ กําหนดไว ระบบจะสั่งใหวงจรขับพัดลมดูดอากาศ เขาใหทํางาน เปาลมเขาโรงเพาะเห็ดเพื่อทําให อุณหภูมิภายในคอย ๆ ลดลงจนถึงอุณหภูมิที่ กําหนด หากอุณหภูมิ ภายในโรงเพาะเห็ดต่ํากวาที่ กําหนดไว ระบบจะสั่งใหวงจรขับกระแสไฟทํางาน เพื่อสงกระแสไฟ ไปยังหลอดไฟใหความรอน ภายในโรงเพาะเห็ดเพื่อทําให อุณหภูมิภายในคอย ๆ สูงขึ้นจนถึงอุณหภูมิที่กําหนด

### เอกสารอางอิง

[1] ปจจัยตาง ๆ ในการเพาะเห็ด. (ระบบ ออนไลน). เขาถึงไดจาก
https://ifarm.co.th(สืบคนลาสุด 12 พฤศจิกายน 2561)
[2] ขั้นตอนการเพาะเห็ดนางฟา. (ระบบออนไลน). เขาถึงไดจาก
https://www.palangkaset.com/ผักเศรษฐกิจ/การเพาะเห็ดนางฟา-1-กอน (สืบคนลาสุด 12 พฤศจิกายน 2561)
[3] การตรวจวัดความชื้น สัมพัทธ ในอากาศ. (ระบบออนไลน). เขาถึงไดจาก http://globethailand.ipst.ac.th/?page_id=40 75 (สืบคนลาสุด 12 พฤศจิกายน 2561)
[4] Arduino. (ระบบออนไลน). เขาถึงไดจาก https://www.arduitronics.com/product/927/nodemcu-version-3-2 (สืบคนลาสุด 12 พฤศจิกายน 2561)
[5] ความรูพื้นฐานเกี่ยวกับเทคโนโลยีเครื่องสูบน้ํา. (ระบบออนไลน). เขาถึงไดจาก

# การประชุมวิชาการสำ หรับนักศึกษาระดับชาติ ครั้งที่ ๒

- 74 -

http://www.neopro-waterpump.com/index.php (สืบคนลาสุด 12 พฤศจิกายน 2561)
[6] ลักษณะการทํางานของปม. (ระบบออนไลน). เขาถึงไดจาก
https://ienergyguru.com/2015/09/pump/(สืบคนลาสุด 12 พฤศจิกายน 2561)
[7] การทํางานของหลอดไฟ หลอดไฟแบบไส. (ระบบออนไลน). เขาถึงไดจาก https://www.nstda.or.th/th/nstda-knowledge/1816-light-bulb (สืบคนลาสุด 13 พฤศจิกายน 2561)
[8] การทํางานของพัดลมดูดอากาศ. (ระบบ ออนไลน). เขาถึงไดจาก
https://ienergyguru.com/2015/09/fan/(สืบคนลาสุด 13 พฤศจิกายน 2561)
[9] ลักษณะการทํางานของกลองวงจรปด. (ระบบ ออนไลน). เขาถึงไดจาก
https://www.hssscctv.com/14604727/ความรูเกี่ยวกับกลองวงจรปด- (สืบคนลาสุด 14 พฤศจิกายน 2561)
[10] การใชงาน Google Firebase. (ระบบ ออนไลน). เขาถึงไดจาก
https://medium.com/firebasethailand/รูจัก-firebase-realtime-database-ตั้งแต-zero-จน เปน-hero-5d09210e6fd6 (สืบคนลาสุด 15 พฤศจิกายน 2561)
[11] ลักษณะการทํางานของรีเลย. (ระบบ ออนไลน). เขาถึงไดจาก
http://www.psptech.co.th/รีเลยrelayคือ อะไร-15696.page (สืบคนลาสุด 15 พฤศจิกายน 2561)

# การประชุมวิชาการสำ หรับนักศึกษาระดับชาติ ครั้งที่ ๒

- 75 -
