narinthon-so/Mushroom-project/Documents/งานวิจัยที่เกี่ยวข้อง/2556-Research-Araya-kampeerapab-thirat.pdf

### การเปรียบเทียบการเพาะเห็ดนางฟ้าด้วยฟางข้าวแห้งและ ก้อนเชื้อเห็ดเก่า

### โดย อารยา มุสิกา คา ภรีภาพ อนิทะนู ตรีรัตน์ วงศ์ช านาญ

### โครงการวิจัยนี้ได้รับการสนับสนุนจากสถาบันวิจัยและพัฒนา มหาวิทยาลัยราชภัฏบุรีรัมย์

พ.ศ. 2555

### “งานวจิัยยังไม่เสร

็

### จสมบูรณ

### ์โปรดอย่าน าไปใช้อ้างองิ”

สารบัญ

เรื่อง | หน้า
ค ำน ำ
สำรบัญ
บทที่ 1 บทน า
1.1 ควำมส ำคัญและที่มำของปัญหำ | 1
1.2 วัตถุประสงค์กำรวิจัย | 1
1.3 สมมุติฐำนของกำรวิจัย | 1
1.4 ขอบเขตของกำรวิจัย | 2
1.5 ประโยชน์ที่คำดว่ำจะได้รับ | 2
1.6 นิยำมศัพย์เฉพำะ | 2
บทที่ 2 เอกสารและงานวิจัยที่เกี่ยวข้อง | 3
2.1 ชีววิทยำของเห็ดนำงฟ้ำ | 3
2.2 สัณฐำนวิทยำเห็ดนำงฟ้ำ | 4
2.3 ควำมเป็นมำของเห็ดนำงฟ้ำ | 4-5
2.4 ปัจจัยที่มีผลต่อกำรเจริญของเห็ดนำงฟ้ำ | 5
2.4.1 อุณหภูมิ
2.4.2 ควำมชื ้น
2.5 วงจรชีวิตของเห็ดนำงฟ้ำ | 6
2.6 อุปนิสัยของเห็ดนำงฟ้ำ | 6
2.7 ธรรมชำติและสภำพแวดล้อมของเห็ดนำงฟ้ำ | 7
2.8 คุณค่ำทำงอำหำรของเห็ดนำงฟ้ำ | 7
2.9 กำรบ ำรุงรักษำเห็ดนำงฟ้ำ | 8-9
2.10ขี ้เลื่อย | 9
2.11 ฟำงข้ำว | 10
2.12 เอกสำรที่เกี่ยวข้อง | 10-11

บทที่ 3 วิธีการด าเนินการวิจัย | 11
3.1 อุปกรณ์ | 11
3.2 วัตถุประสงค์ของโครงกำรวิจัย | 11
3.3 กำรวำงแผนกำรทดลอง | 12-13
3.4 ขั ้นตอนกำรทดลอง | 14-17
3.5 กำรบันทึกข้อมูลและกำรวิเครำะห์ข้อมูล | 17
3.6 สถำนที่ท ำกำรทดลอง | 18
3.7ระยะเวลำด ำเนินกำร | 18


ค ำน ำ
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
