narinthon-so/Mushroom-project/Documents/เล่ม/successed/resource/Pics/0_UIh8Q6caxZazRIK1.png

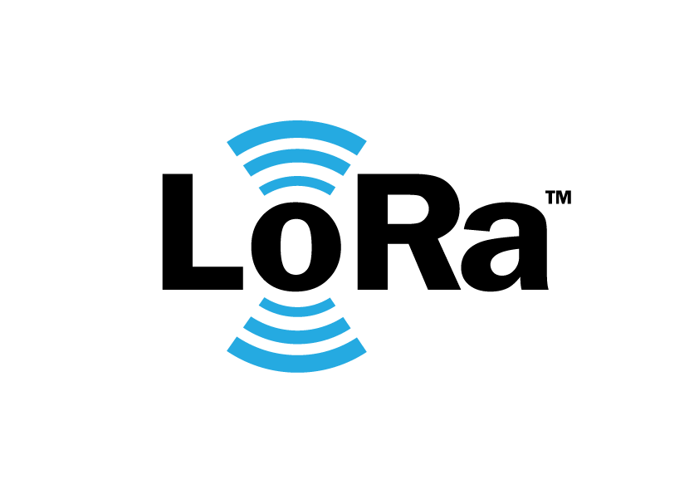
Documents/เล่ม/successed/resource/Pics/0_UIh8Q6caxZazRIK1.png
