narinthon-so/Mushroom-project/Documents/เล่ม/successed/resource/Pics/4_channel_relay_PCB.png

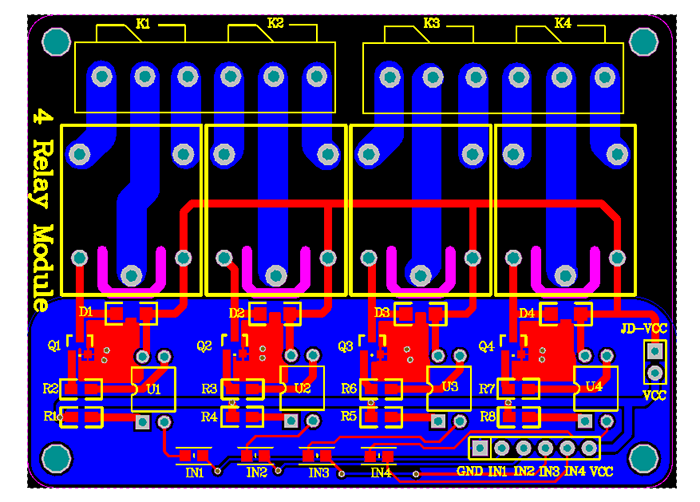
Documents/เล่ม/successed/resource/Pics/4_channel_relay_PCB.png
