narinthon-so/Mushroom-project/Documents/เล่ม/successed/resource/Pics/5mm Super Bright.webp

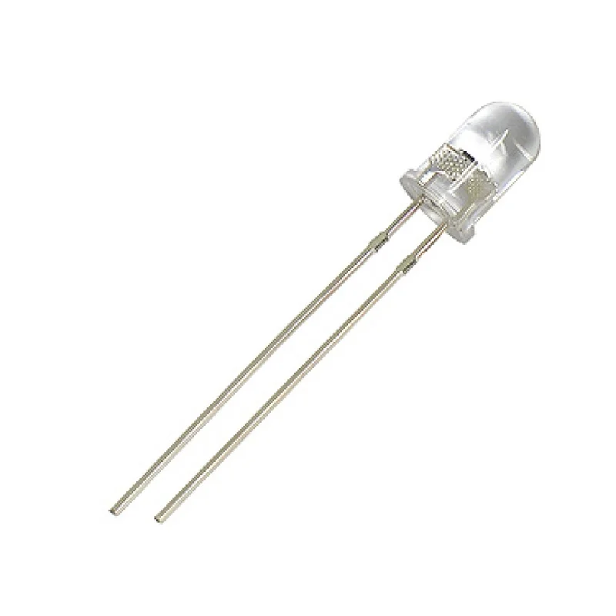
Documents/เล่ม/successed/resource/Pics/5mm Super Bright.webp
