narinthon-so/Mushroom-project/Documents/เล่ม/successed/resource/Pics/28795258_259920121213301_7601259482970062848_n.jpg

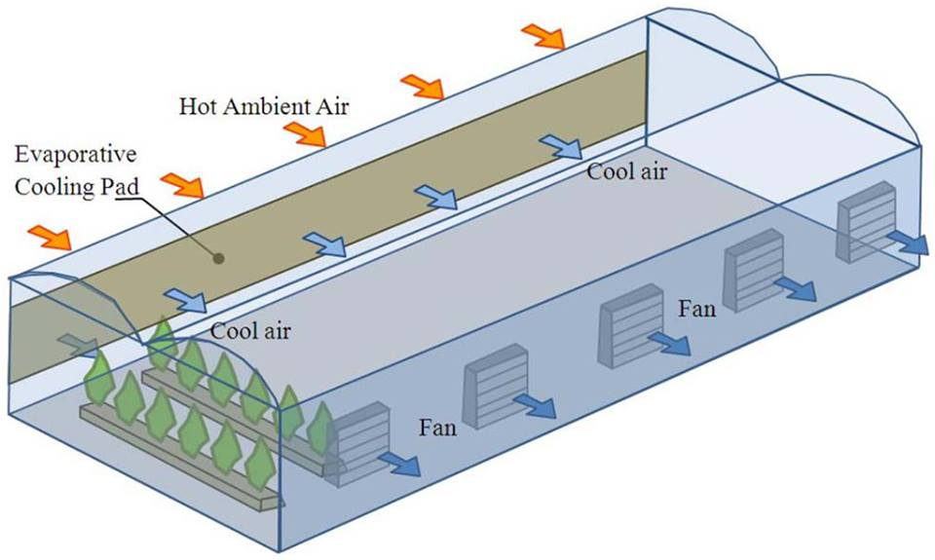
Documents/เล่ม/successed/resource/Pics/28795258_259920121213301_7601259482970062848_n.jpg
