narinthon-so/Mushroom-project/Documents/เล่ม/successed/resource/Pics/117909706_4316516678418567_1922789571024717621_n.jpg

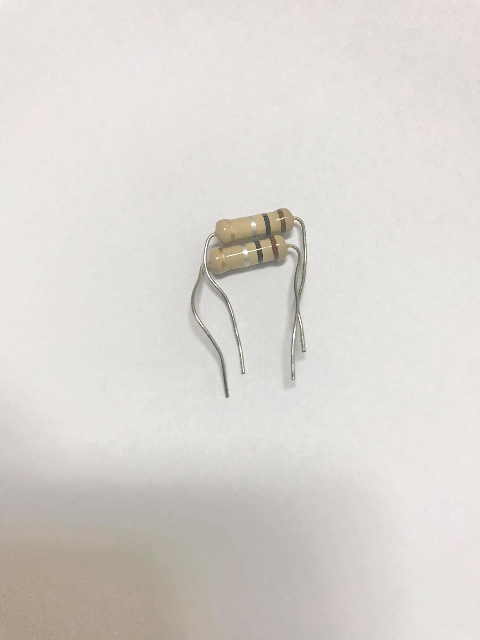
Documents/เล่ม/successed/resource/Pics/117909706_4316516678418567_1922789571024717621_n.jpg
