narinthon-so/Mushroom-project/Documents/เล่ม/successed/resource/Pics/118690725_679170759473519_8142748246153632730_n.jpg

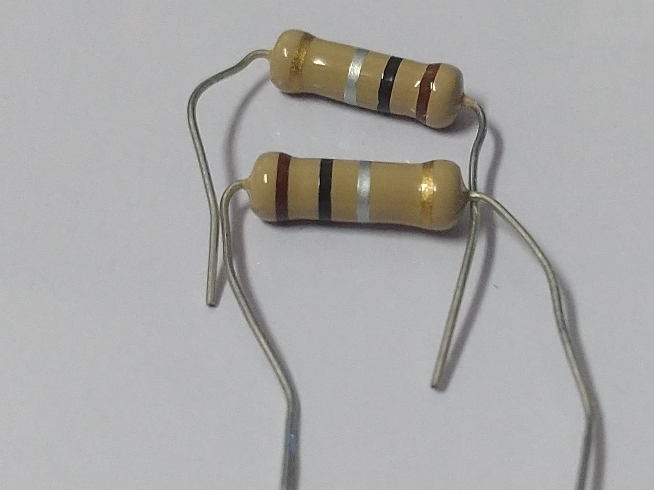
Documents/เล่ม/successed/resource/Pics/118690725_679170759473519_8142748246153632730_n.jpg
