narinthon-so/Mushroom-project/Documents/เล่ม/successed/resource/Pics/118762286_1022313924877198_3035642033460375226_n.jpg

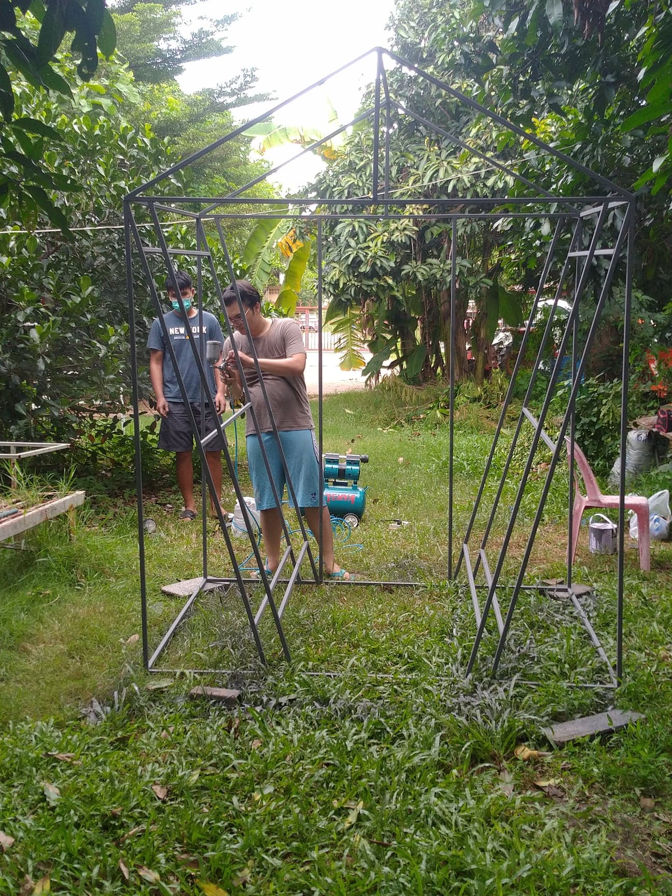
Documents/เล่ม/successed/resource/Pics/118762286_1022313924877198_3035642033460375226_n.jpg
