narinthon-so/Mushroom-project/Documents/เล่ม/successed/resource/Pics/118765508_313573696423611_3949794517563514907_n.jpg

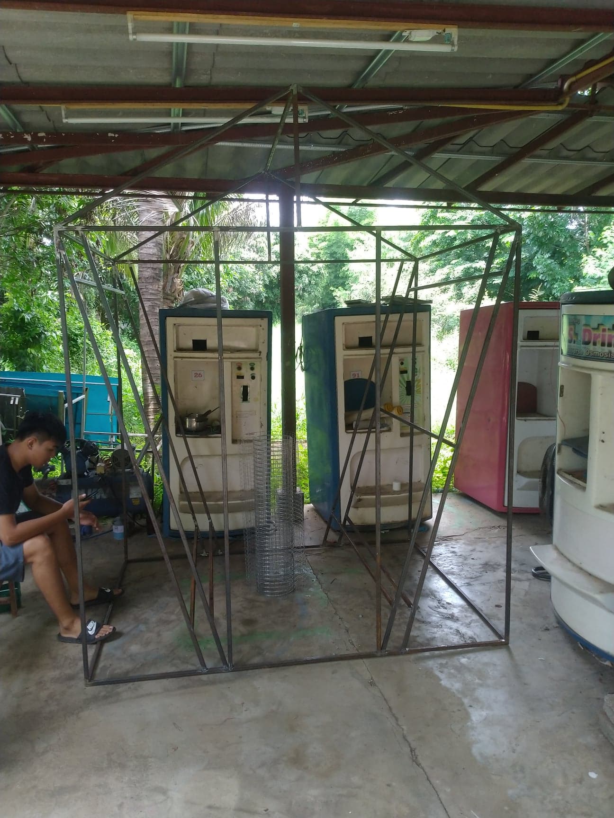
Documents/เล่ม/successed/resource/Pics/118765508_313573696423611_3949794517563514907_n.jpg
