narinthon-so/Mushroom-project/Documents/เล่ม/successed/resource/Pics/119118315_3076004252522261_8200389809315382375_n.jpg

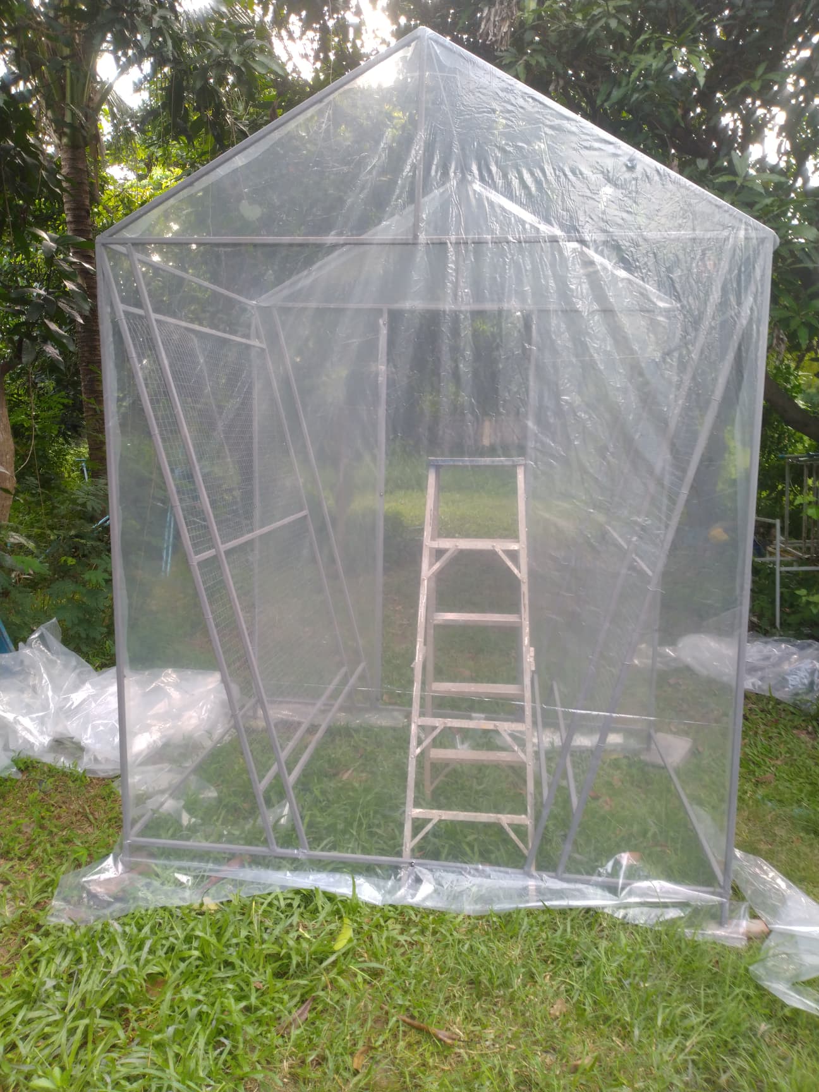
Documents/เล่ม/successed/resource/Pics/119118315_3076004252522261_8200389809315382375_n.jpg
