narinthon-so/Mushroom-project/Documents/เล่ม/successed/resource/Pics/119202702_328925118367797_6977276390690886888_n.jpg

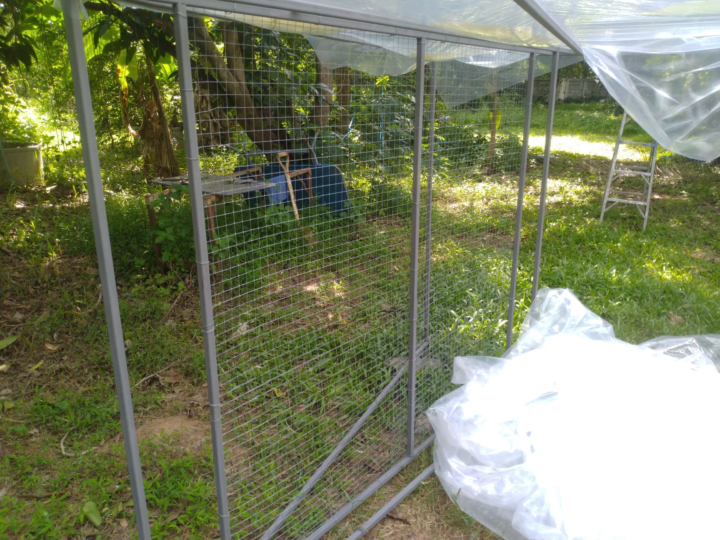
Documents/เล่ม/successed/resource/Pics/119202702_328925118367797_6977276390690886888_n.jpg
