narinthon-so/Mushroom-project/Documents/เล่ม/successed/resource/Pics/119930157_1021614754950036_5825012673992379132_n.jpg

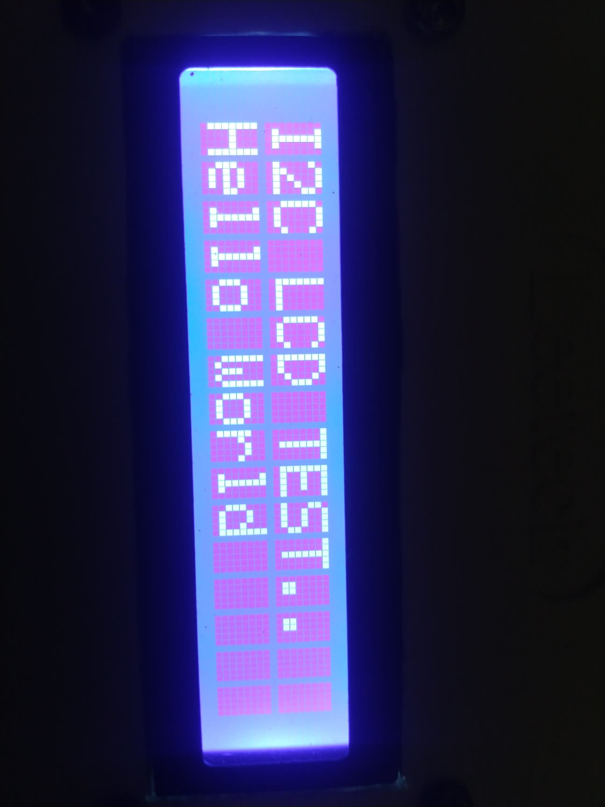
Documents/เล่ม/successed/resource/Pics/119930157_1021614754950036_5825012673992379132_n.jpg
