narinthon-so/Mushroom-project/Documents/เล่ม/successed/resource/Pics/120087555_370843580988722_7798853492217920318_n.jpg

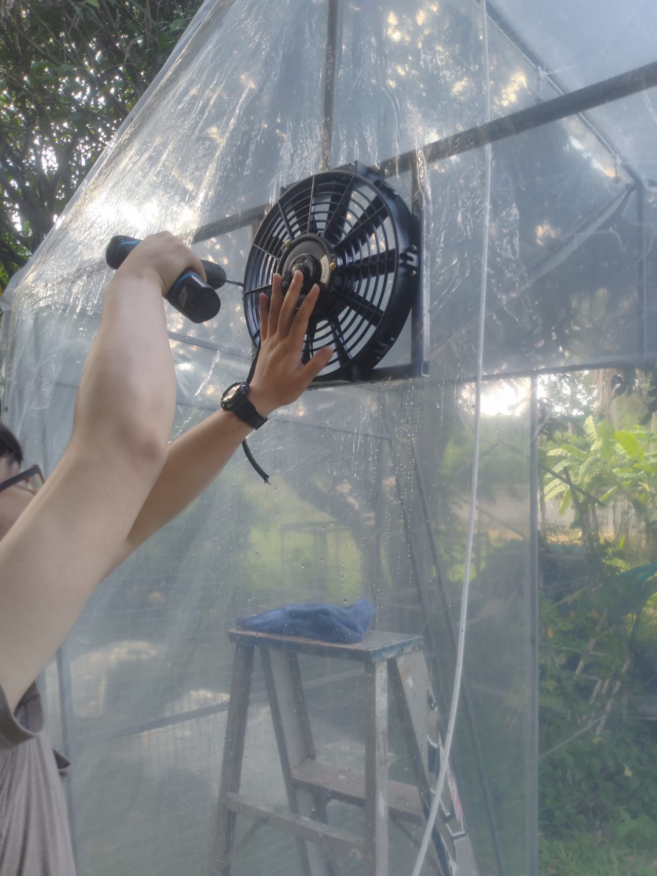
Documents/เล่ม/successed/resource/Pics/120087555_370843580988722_7798853492217920318_n.jpg
