narinthon-so/Mushroom-project/Documents/เล่ม/successed/resource/Pics/120093991_798700224293397_3226080428092699002_n.jpg

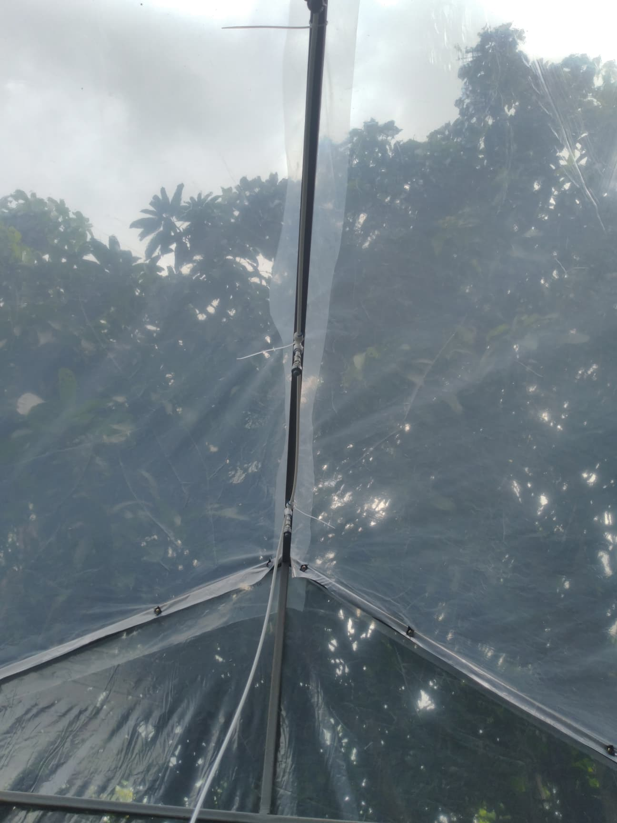
Documents/เล่ม/successed/resource/Pics/120093991_798700224293397_3226080428092699002_n.jpg
