narinthon-so/Mushroom-project/Documents/เล่ม/successed/resource/Pics/Adafruit-1293-30139042-01.jpg

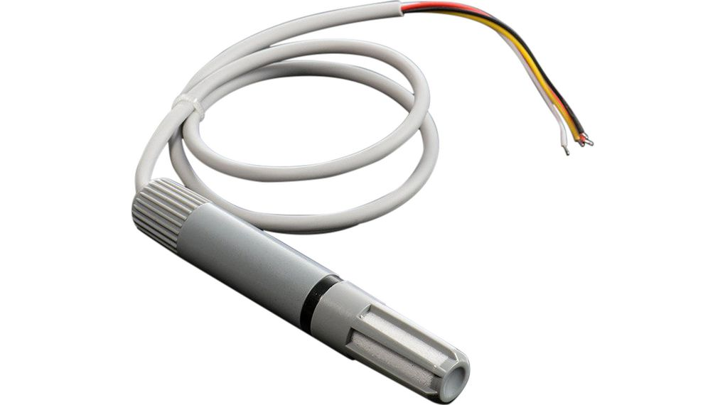
Documents/เล่ม/successed/resource/Pics/Adafruit-1293-30139042-01.jpg
