narinthon-so/Mushroom-project/Documents/เล่ม/successed/resource/Pics/adafruit_products_FeatherM0_AM2315_I2C_bb.jpg

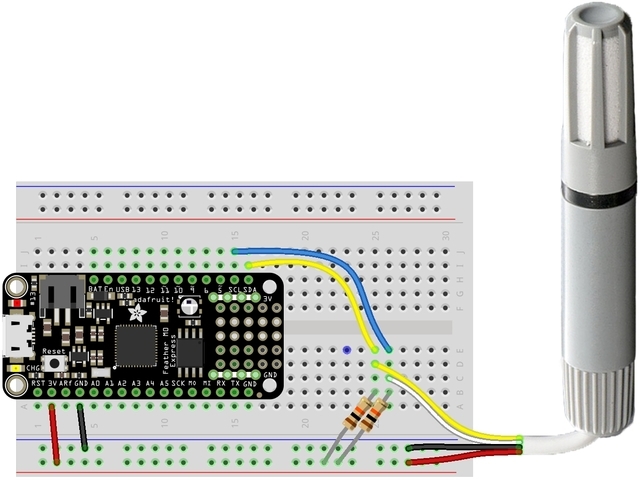
Documents/เล่ม/successed/resource/Pics/adafruit_products_FeatherM0_AM2315_I2C_bb.jpg
