narinthon-so/Mushroom-project/Documents/เล่ม/successed/resource/Pics/am2315.PNG

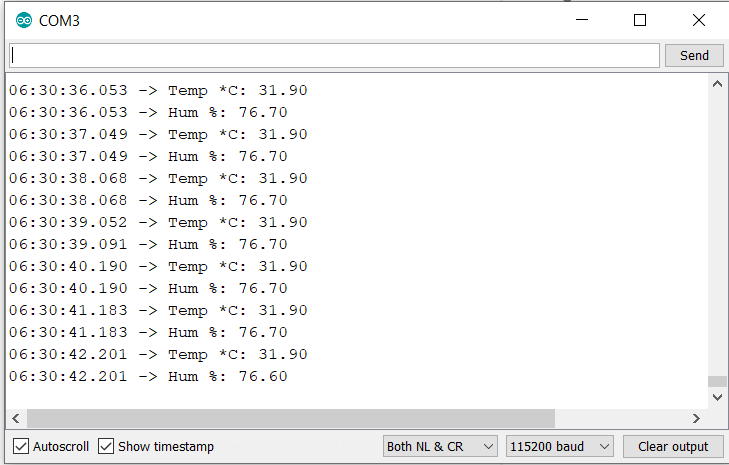
Documents/เล่ม/successed/resource/Pics/am2315.PNG
