narinthon-so/Mushroom-project/Documents/เล่ม/successed/resource/Pics/app-application-browser-internet-page-web-code-coding-window-27558.png

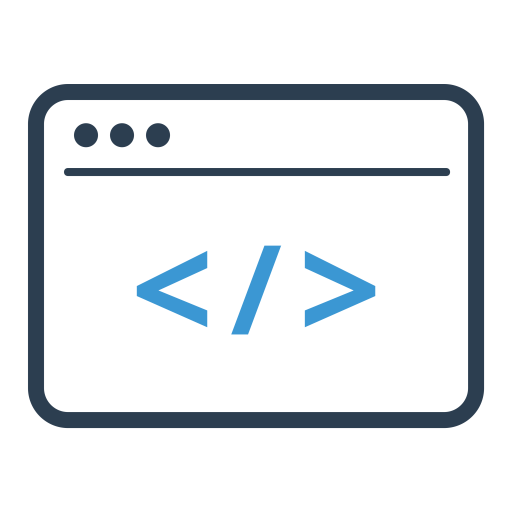
Documents/เล่ม/successed/resource/Pics/app-application-browser-internet-page-web-code-coding-window-27558.png
