narinthon-so/Mushroom-project/Documents/เล่ม/successed/resource/Pics/BoxDiagram2.PNG

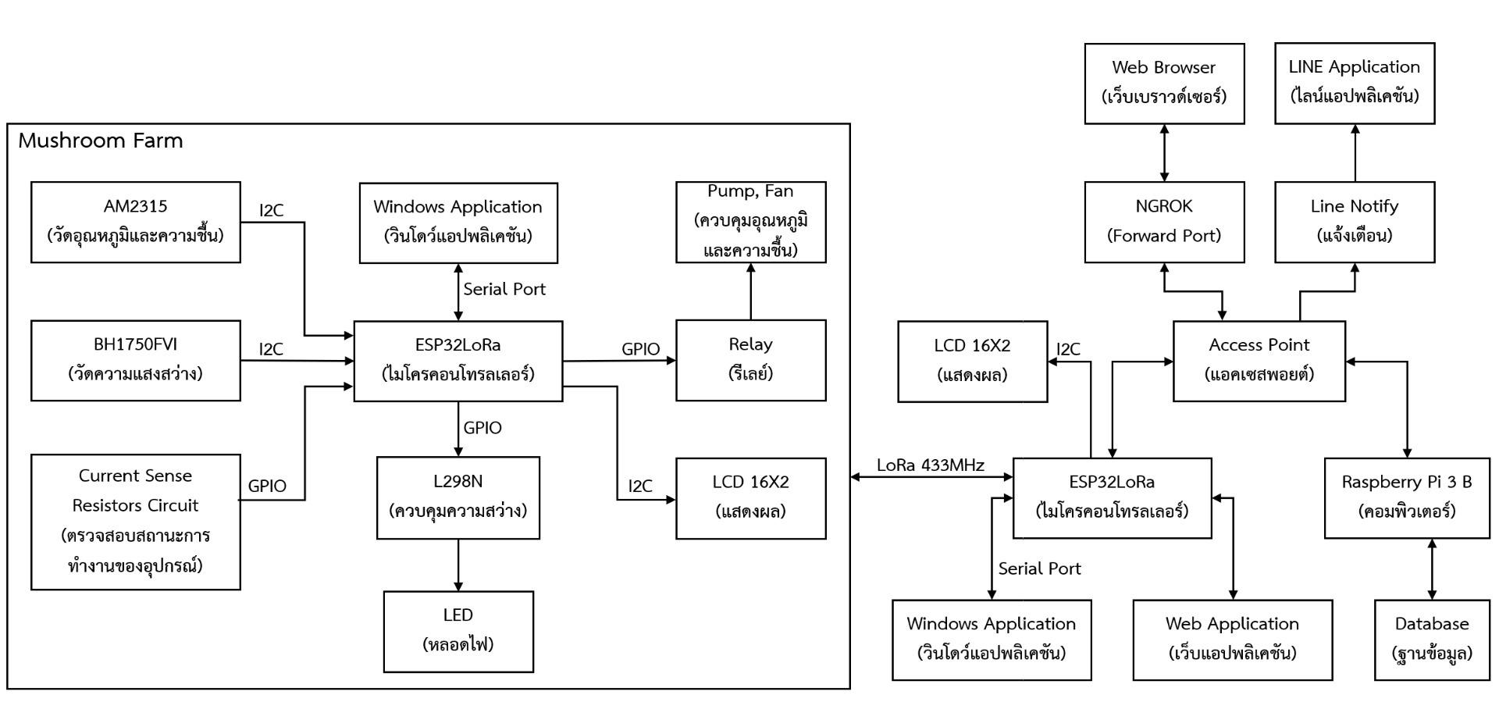
Documents/เล่ม/successed/resource/Pics/BoxDiagram2.PNG
