narinthon-so/Mushroom-project/Documents/เล่ม/successed/resource/Pics/BoxDiagram.PNG

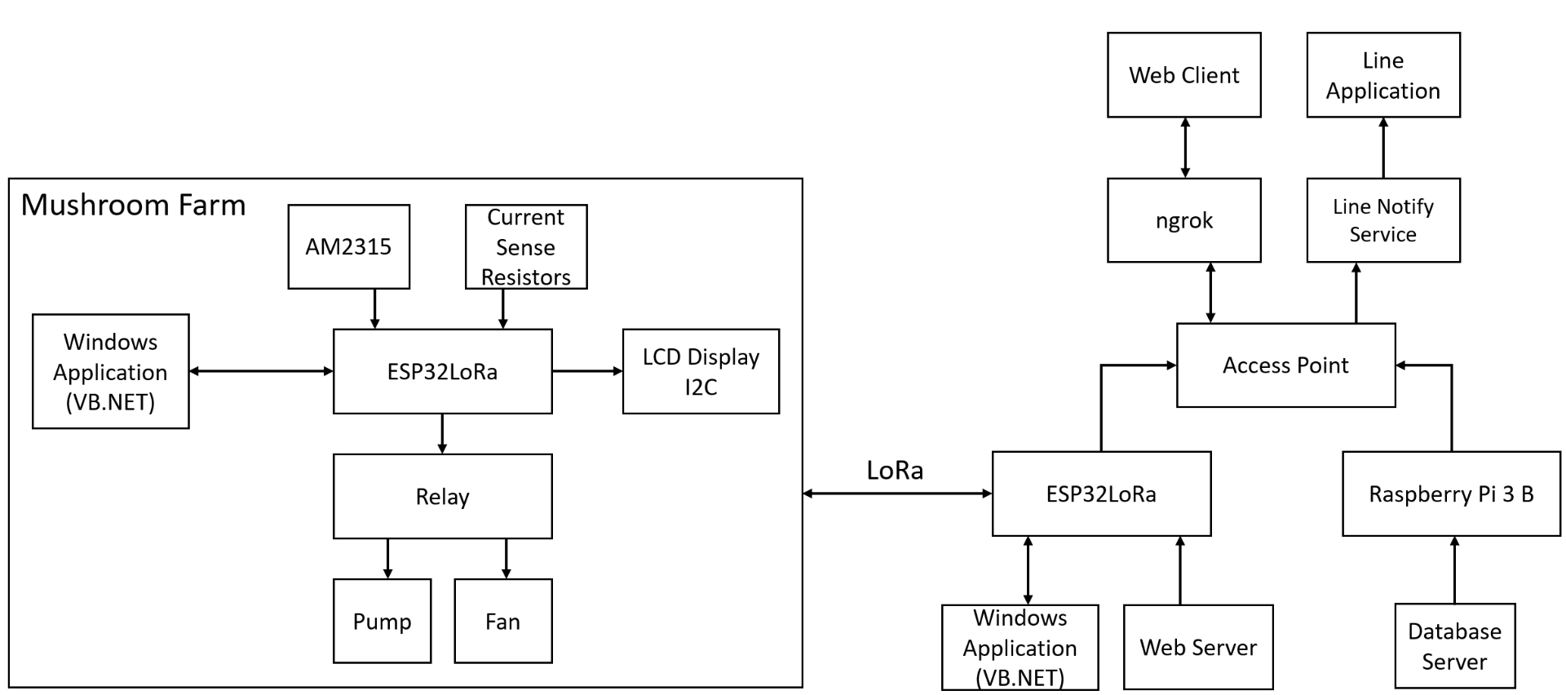
Documents/เล่ม/successed/resource/Pics/BoxDiagram.PNG
