narinthon-so/Mushroom-project/Documents/เล่ม/successed/resource/Pics/cloud.png

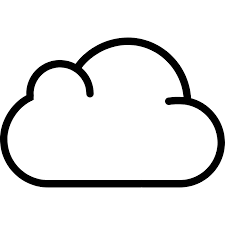
Documents/เล่ม/successed/resource/Pics/cloud.png
