narinthon-so/Mushroom-project/Documents/เล่ม/successed/resource/Pics/crontab.png

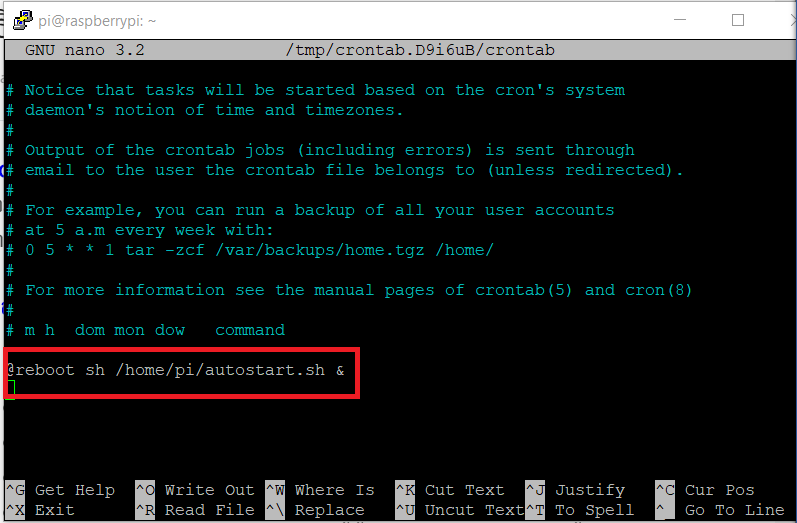
Documents/เล่ม/successed/resource/Pics/crontab.png
