narinthon-so/Mushroom-project/Documents/เล่ม/successed/resource/Pics/d43d38144d427db1a75973a213678fba.jpg

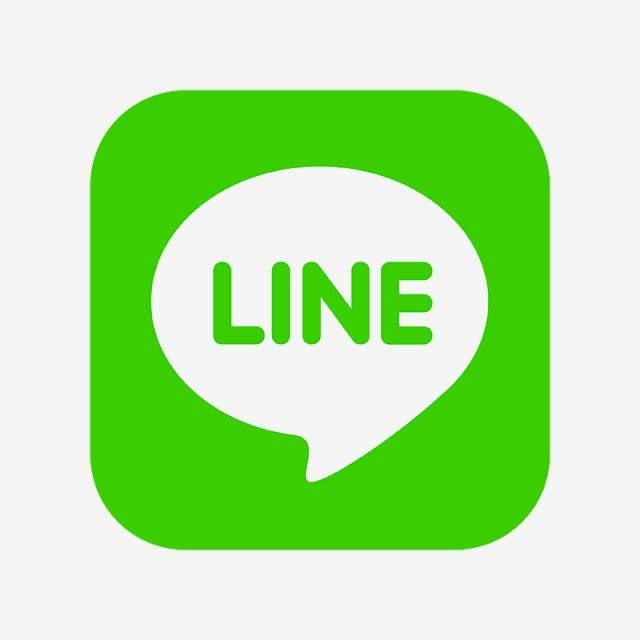
Documents/เล่ม/successed/resource/Pics/d43d38144d427db1a75973a213678fba.jpg
