narinthon-so/Mushroom-project/Documents/เล่ม/successed/resource/Pics/day1_in.jpg

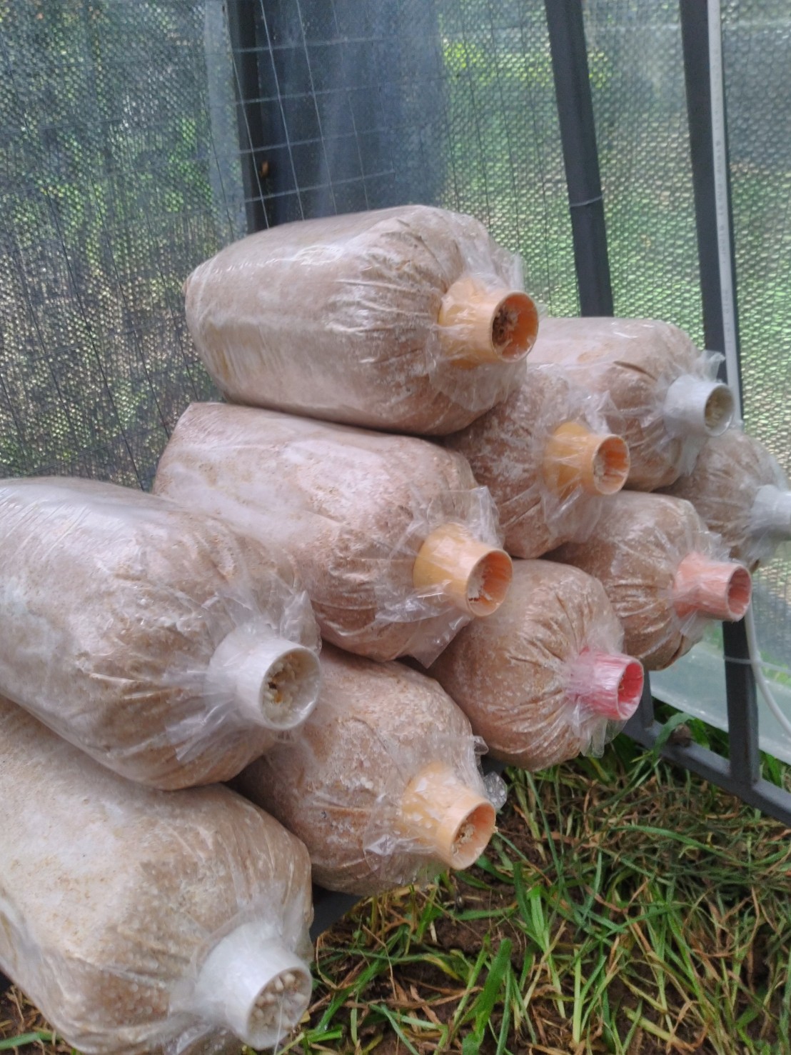
Documents/เล่ม/successed/resource/Pics/day1_in.jpg
