narinthon-so/Mushroom-project/Documents/เล่ม/successed/resource/Pics/day2_in.jpg

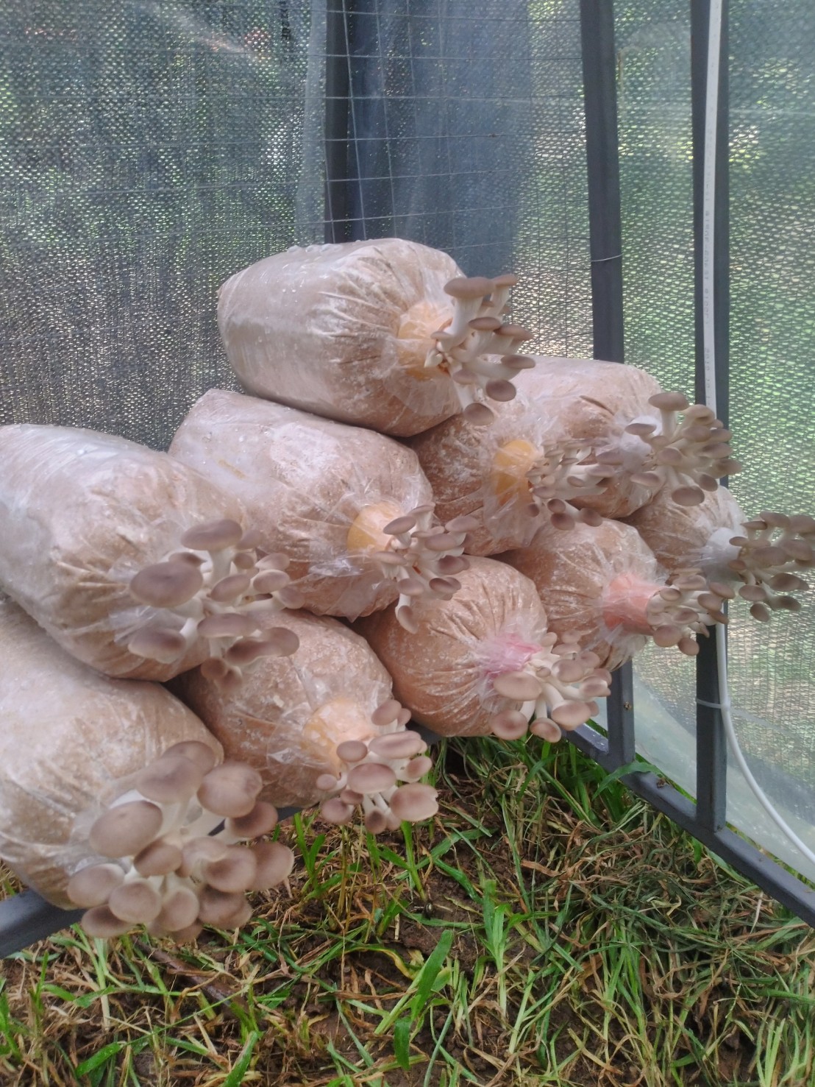
Documents/เล่ม/successed/resource/Pics/day2_in.jpg
