narinthon-so/Mushroom-project/Documents/เล่ม/successed/resource/Pics/db.png

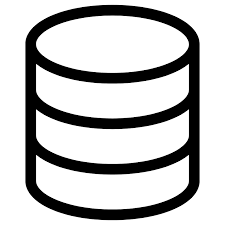
Documents/เล่ม/successed/resource/Pics/db.png
