narinthon-so/Mushroom-project/Documents/เล่ม/successed/resource/Pics/descriptions.PNG

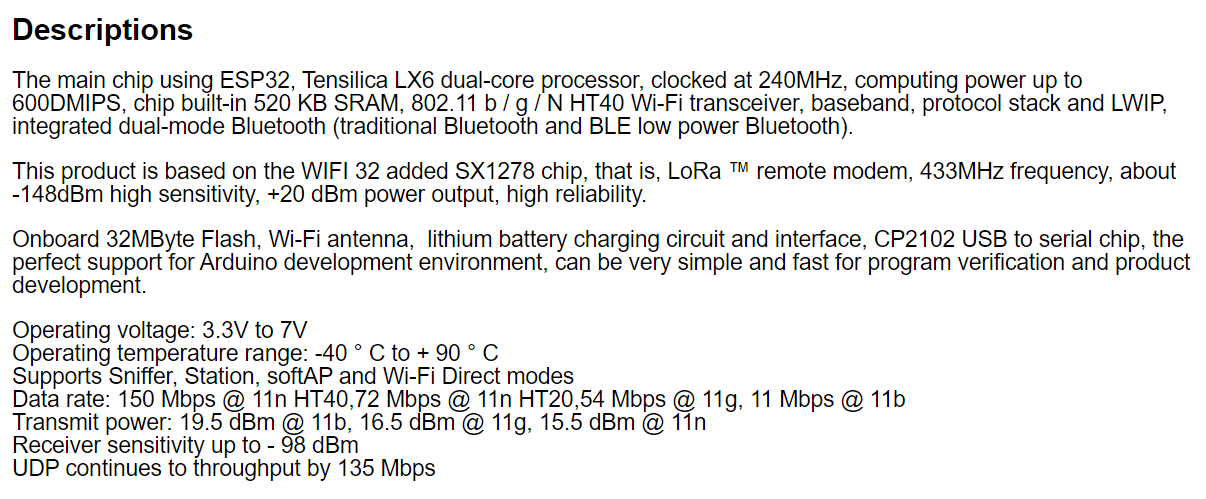
Documents/เล่ม/successed/resource/Pics/descriptions.PNG
