narinthon-so/Mushroom-project/Documents/เล่ม/successed/resource/Pics/HTB1jp1ZdH9YBuNjy0Fgq6AxcXXak.webp

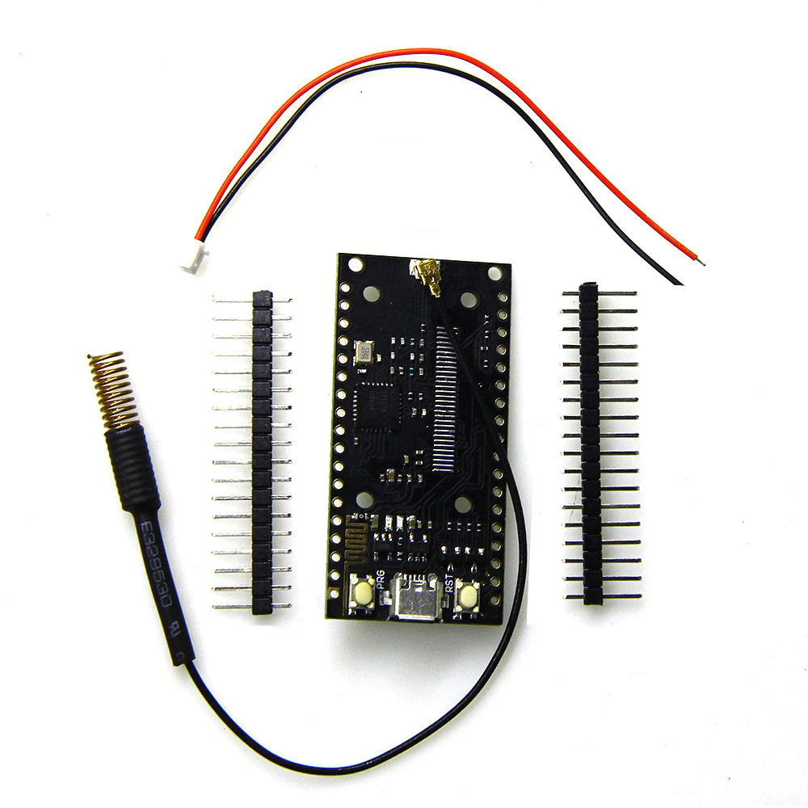
Documents/เล่ม/successed/resource/Pics/HTB1jp1ZdH9YBuNjy0Fgq6AxcXXak.webp
