narinthon-so/Mushroom-project/Documents/เล่ม/successed/resource/Pics/HTB12xoWosrI8KJjy0Fhq6zfnpXaH.webp

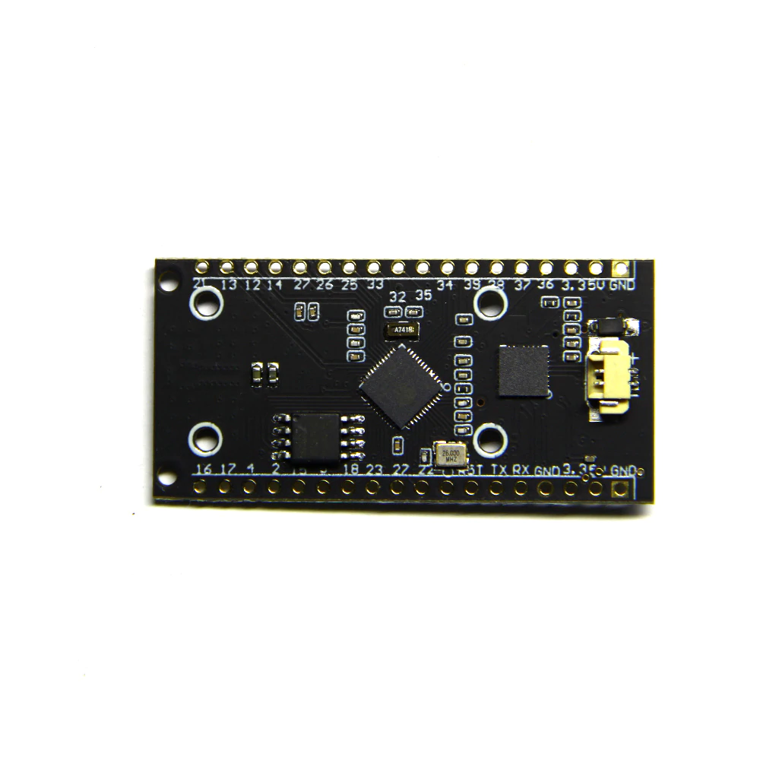
Documents/เล่ม/successed/resource/Pics/HTB12xoWosrI8KJjy0Fhq6zfnpXaH.webp
