narinthon-so/Mushroom-project/Documents/เล่ม/successed/resource/Pics/id1.jpg

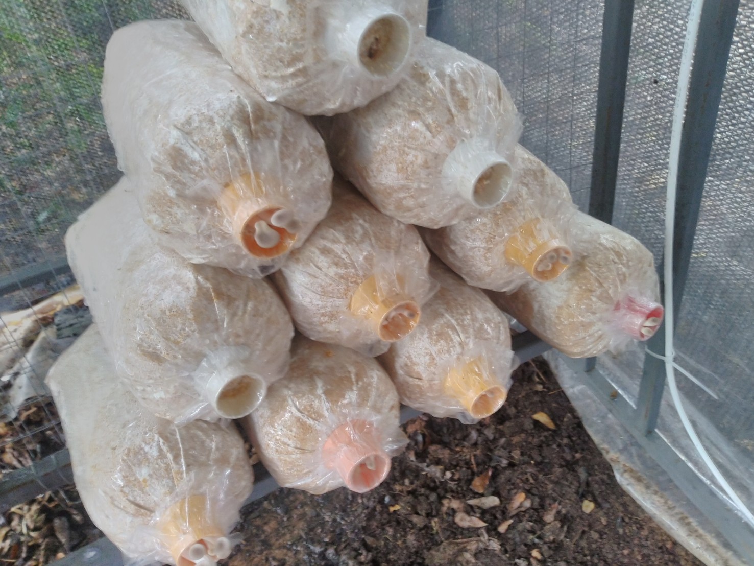
Documents/เล่ม/successed/resource/Pics/id1.jpg
