narinthon-so/Mushroom-project/Documents/เล่ม/successed/resource/Pics/id2.jpg

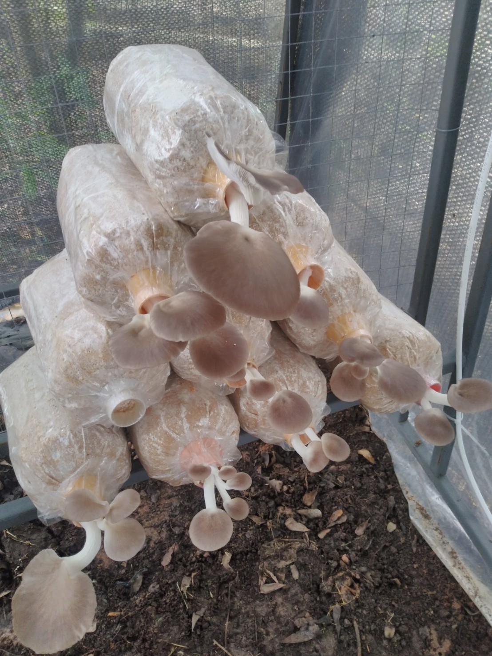
Documents/เล่ม/successed/resource/Pics/id2.jpg
