narinthon-so/Mushroom-project/Documents/เล่ม/successed/resource/Pics/id3.jpg

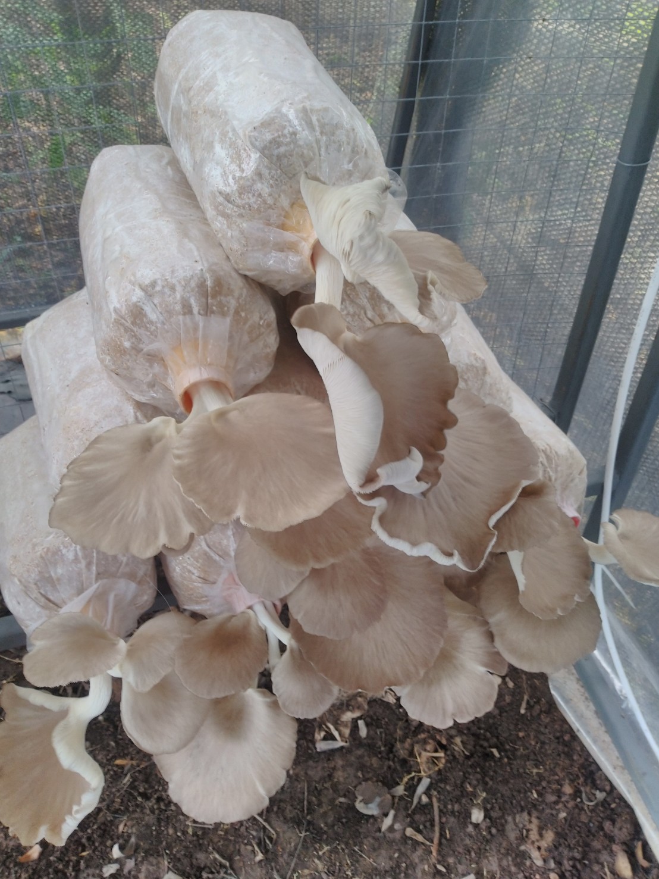
Documents/เล่ม/successed/resource/Pics/id3.jpg
