narinthon-so/Mushroom-project/Documents/เล่ม/successed/resource/Pics/images.png

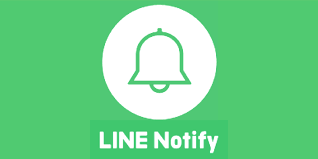
Documents/เล่ม/successed/resource/Pics/images.png
