narinthon-so/Mushroom-project/Documents/เล่ม/successed/resource/Pics/IMG_20201002_115834.jpg

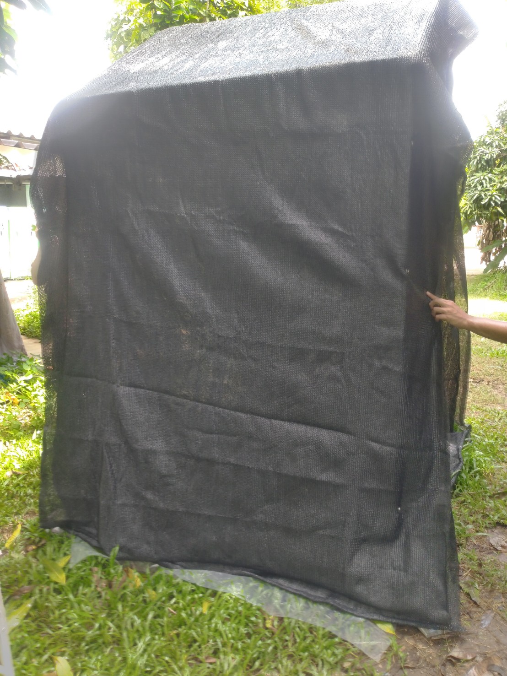
Documents/เล่ม/successed/resource/Pics/IMG_20201002_115834.jpg
