narinthon-so/Mushroom-project/Documents/เล่ม/successed/resource/Pics/IMG_20201011_172425.jpg

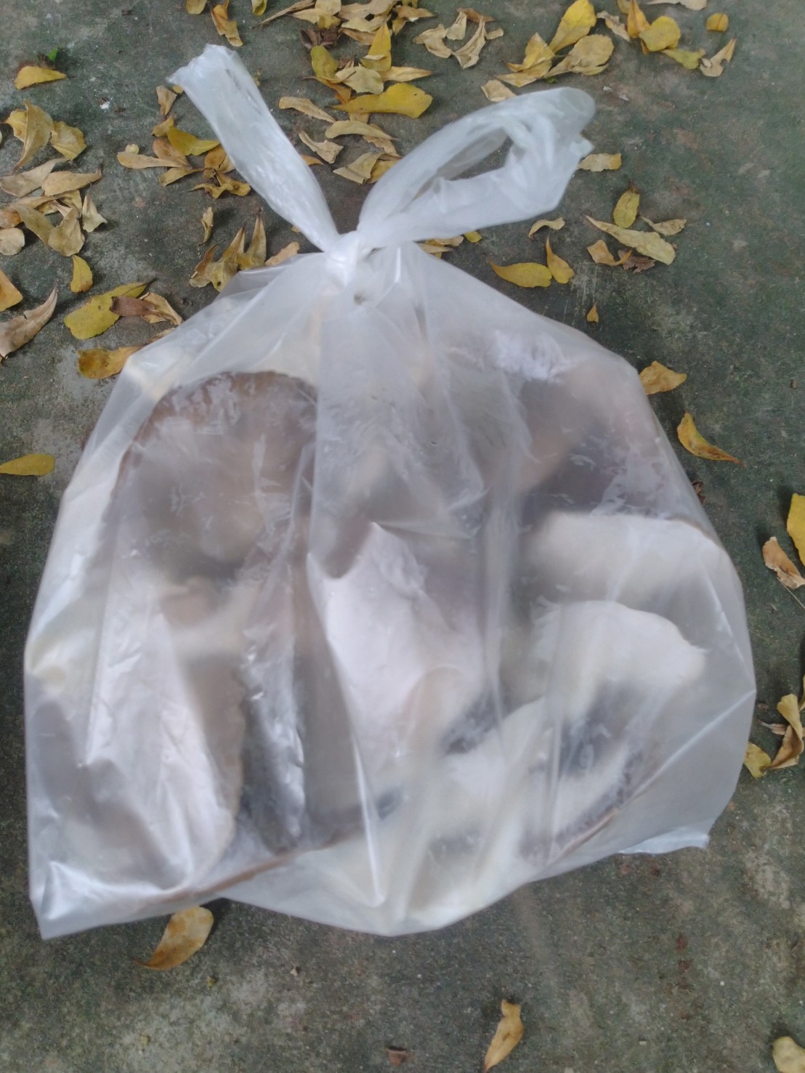
Documents/เล่ม/successed/resource/Pics/IMG_20201011_172425.jpg
