narinthon-so/Mushroom-project/Documents/เล่ม/successed/resource/Pics/IMG_20201015_163537.jpg

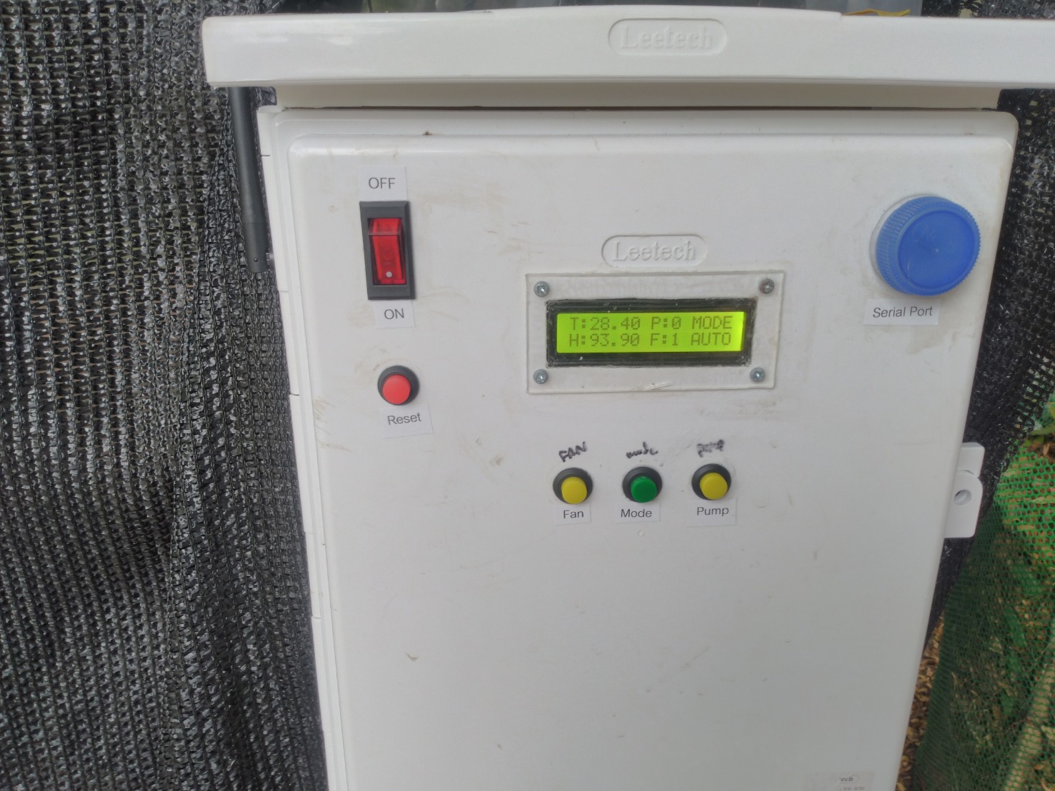
Documents/เล่ม/successed/resource/Pics/IMG_20201015_163537.jpg
