narinthon-so/Mushroom-project/Documents/เล่ม/successed/resource/Pics/IMG_20201015_164943.jpg

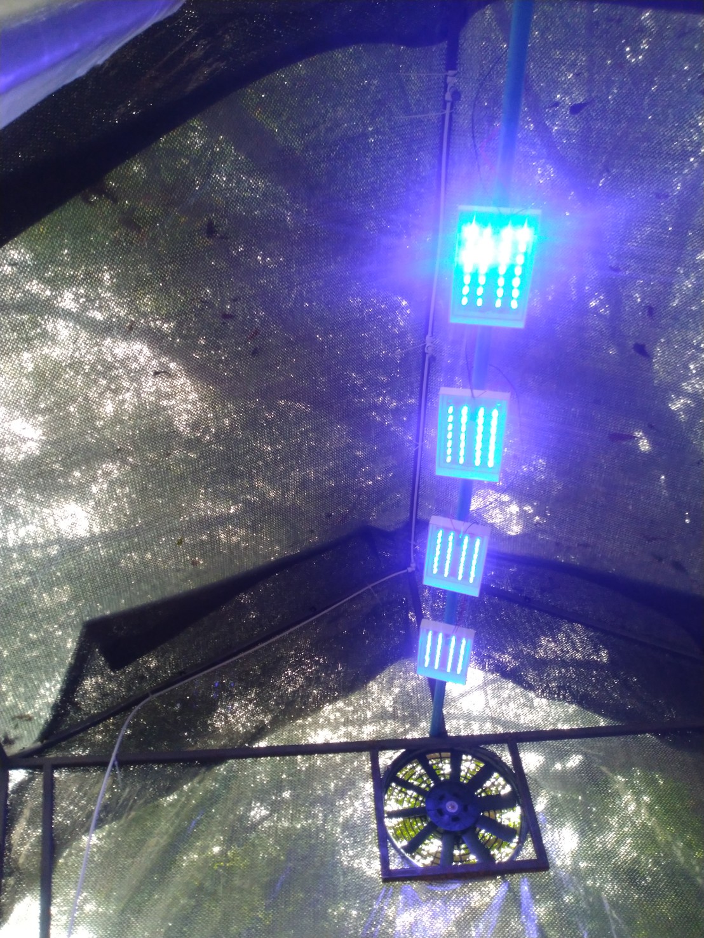
Documents/เล่ม/successed/resource/Pics/IMG_20201015_164943.jpg
