narinthon-so/Mushroom-project/Documents/เล่ม/successed/resource/Pics/IMG_20201019_152650.jpg

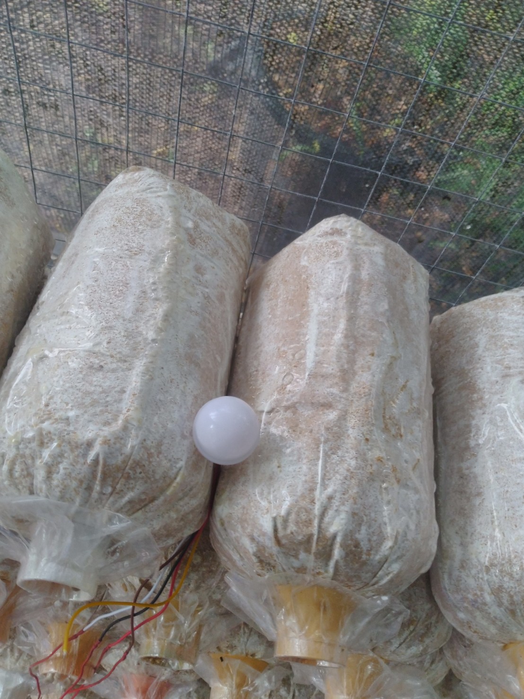
Documents/เล่ม/successed/resource/Pics/IMG_20201019_152650.jpg
