narinthon-so/Mushroom-project/Documents/เล่ม/successed/resource/Pics/IMG_20201106_161149.jpg

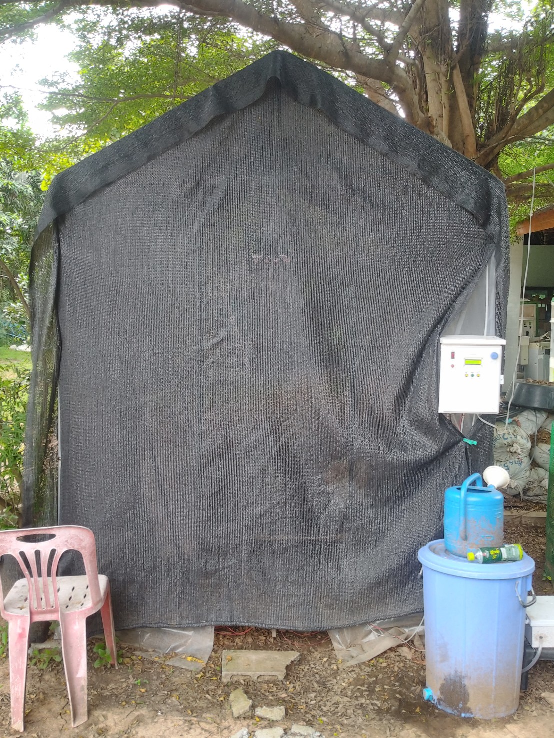
Documents/เล่ม/successed/resource/Pics/IMG_20201106_161149.jpg
