narinthon-so/Mushroom-project/Documents/เล่ม/successed/resource/Pics/lux_sensor.PNG

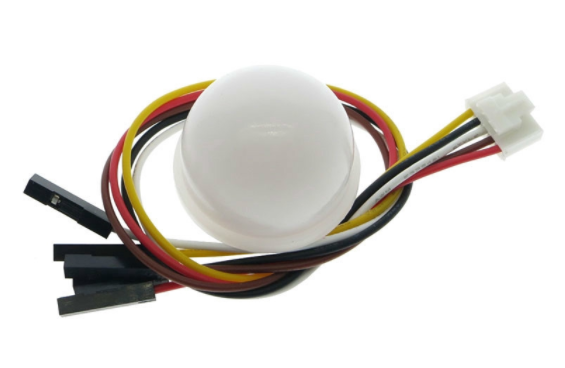
Documents/เล่ม/successed/resource/Pics/lux_sensor.PNG
