narinthon-so/Mushroom-project/Documents/เล่ม/successed/resource/Pics/Mushroom.png

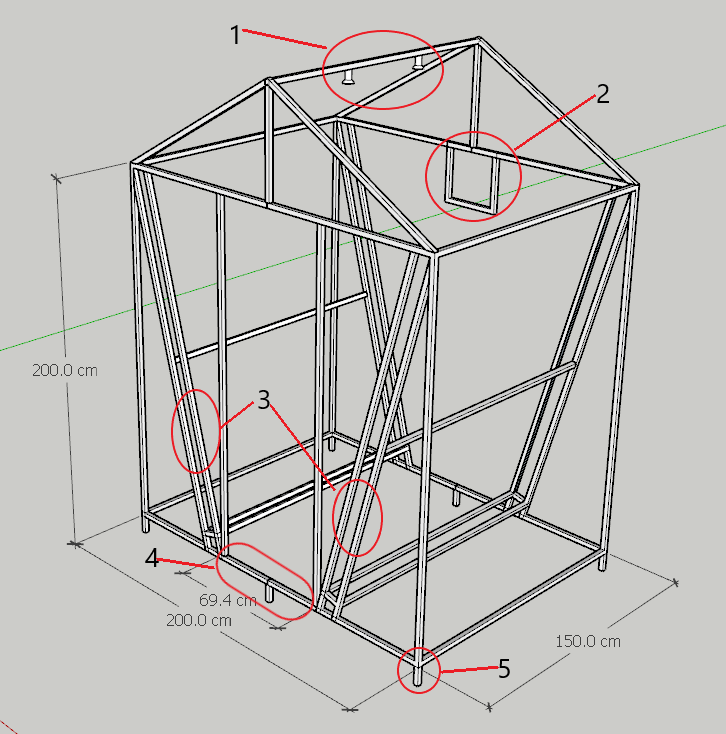
Documents/เล่ม/successed/resource/Pics/Mushroom.png
