narinthon-so/Mushroom-project/Documents/เล่ม/successed/resource/Pics/od1.jpg

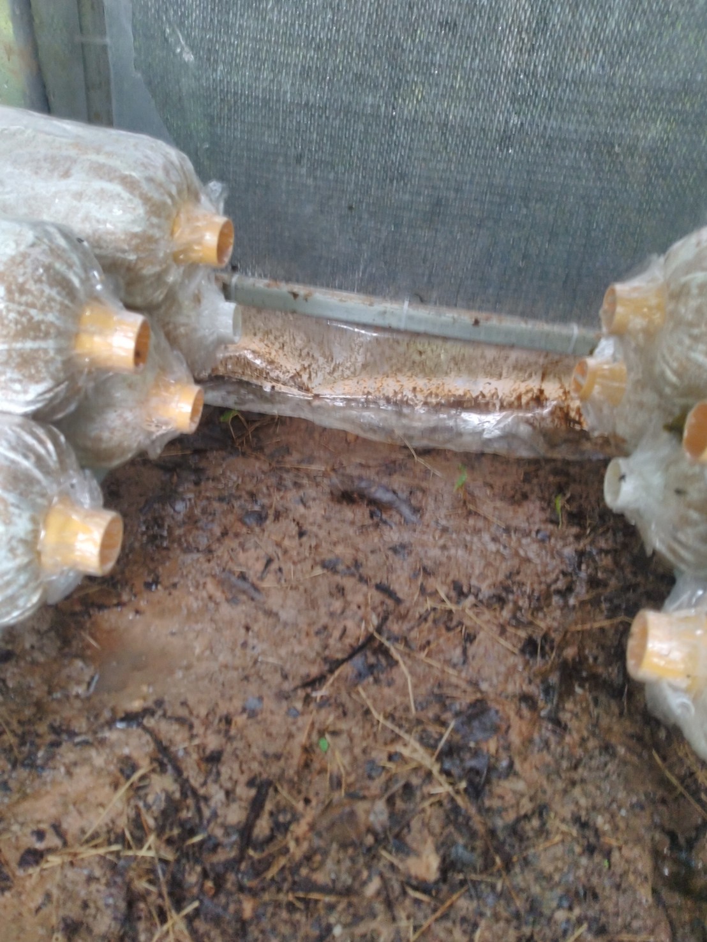
Documents/เล่ม/successed/resource/Pics/od1.jpg
