narinthon-so/Mushroom-project/Documents/เล่ม/successed/resource/Pics/od2.jpg

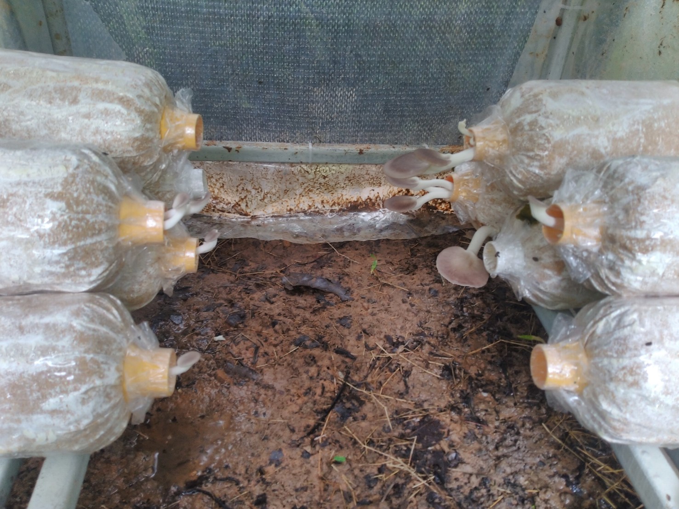
Documents/เล่ม/successed/resource/Pics/od2.jpg
