narinthon-so/Mushroom-project/Documents/เล่ม/successed/resource/Pics/od3.jpg

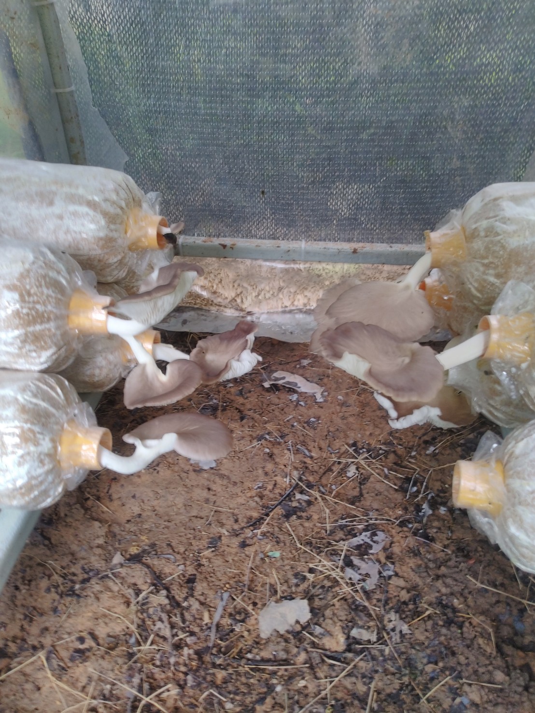
Documents/เล่ม/successed/resource/Pics/od3.jpg
