narinthon-so/Mushroom-project/Documents/เล่ม/successed/resource/Pics/pngtree-office-supplies-office-computer-image_1230621.jpg

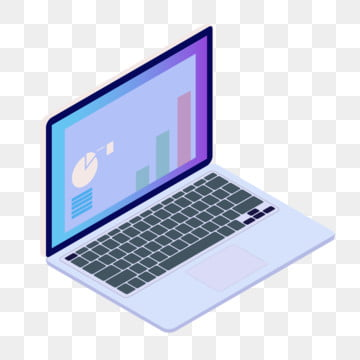
Documents/เล่ม/successed/resource/Pics/pngtree-office-supplies-office-computer-image_1230621.jpg
