narinthon-so/Mushroom-project/Documents/เล่ม/successed/resource/Pics/profile.jpg

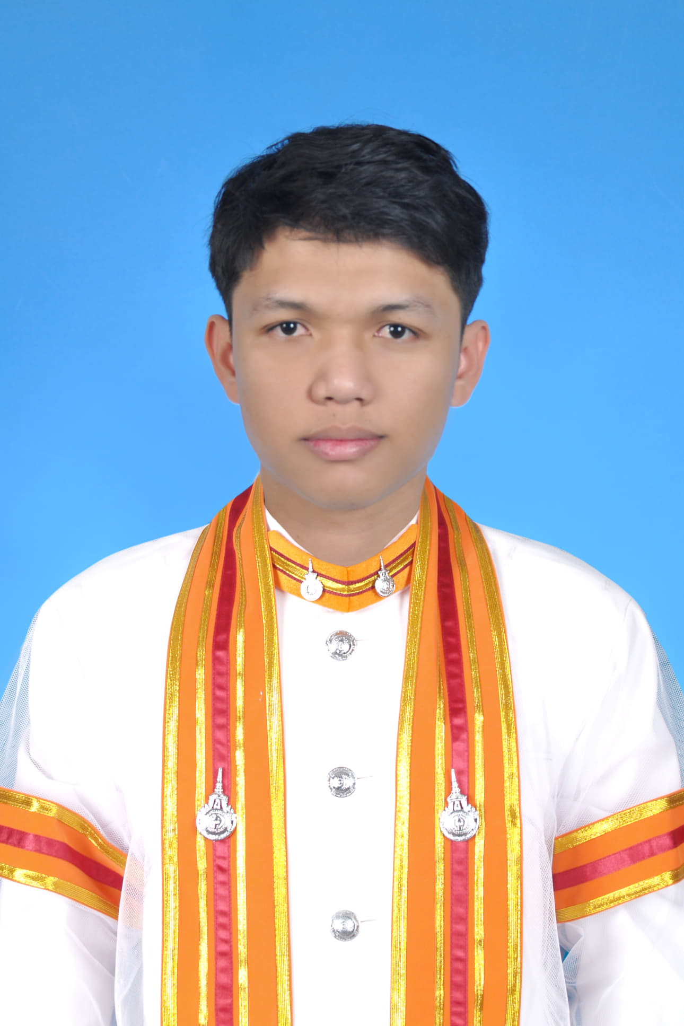
Documents/เล่ม/successed/resource/Pics/profile.jpg
