narinthon-so/Mushroom-project/Documents/เล่ม/successed/resource/Pics/received_253057606143818.jpg

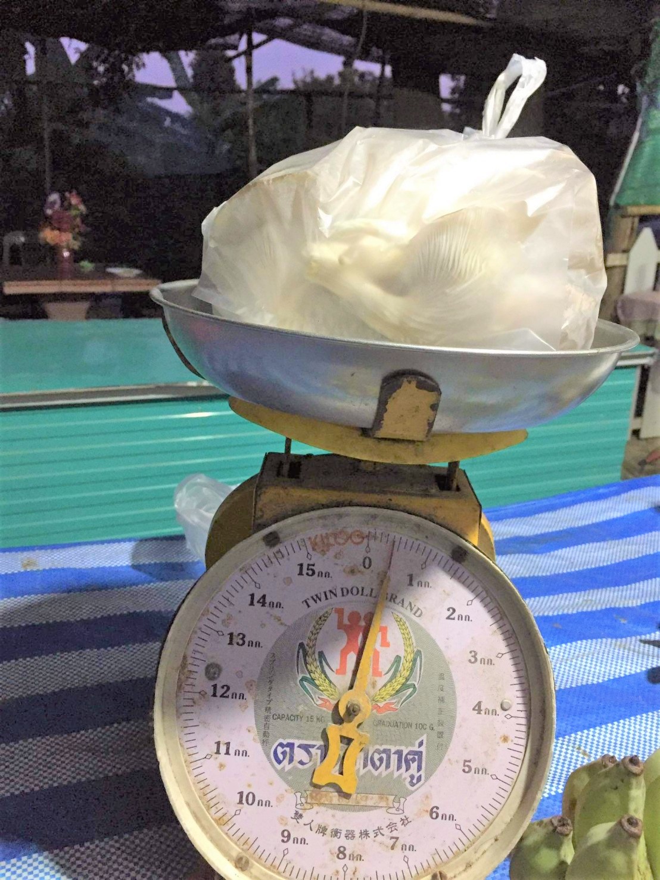
Documents/เล่ม/successed/resource/Pics/received_253057606143818.jpg
