narinthon-so/Mushroom-project/Documents/เล่ม/successed/resource/Pics/received_260887925341141.jpg

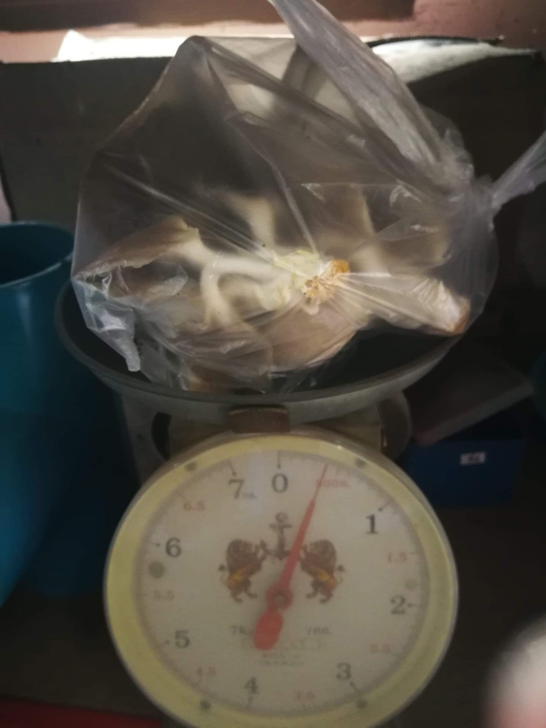
Documents/เล่ม/successed/resource/Pics/received_260887925341141.jpg
