narinthon-so/Mushroom-project/Documents/เล่ม/successed/resource/Pics/received_397475101283589.jpg

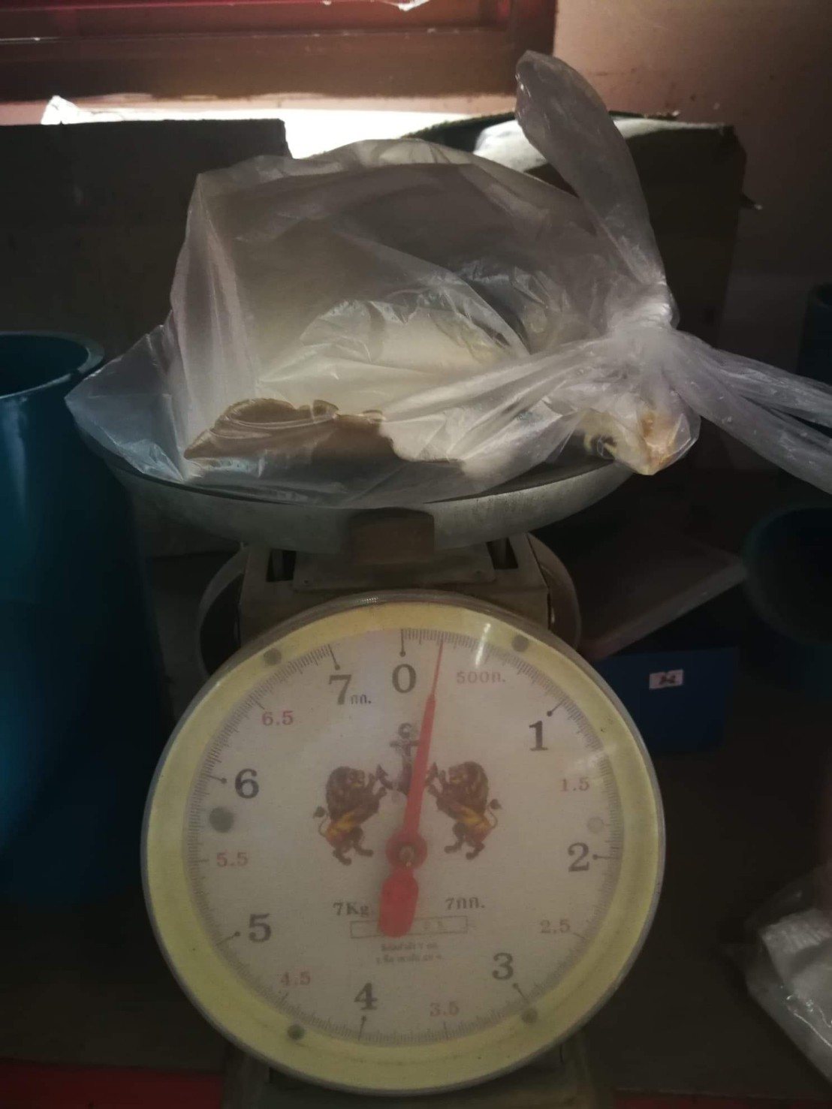
Documents/เล่ม/successed/resource/Pics/received_397475101283589.jpg
