narinthon-so/Mushroom-project/Documents/เล่ม/successed/resource/Pics/received_1121789758235522.jpg

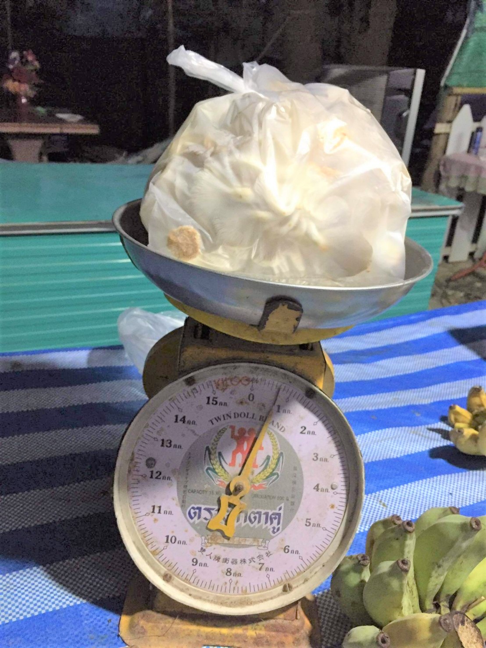
Documents/เล่ม/successed/resource/Pics/received_1121789758235522.jpg
