narinthon-so/Mushroom-project/Documents/เล่ม/successed/resource/Pics/res-json-public-url-file.PNG

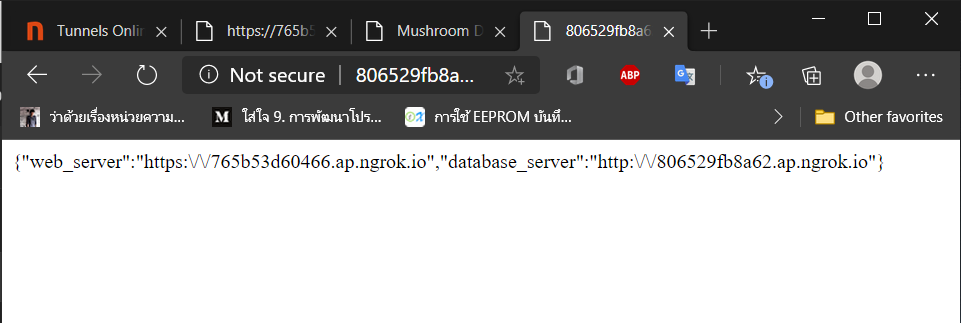
Documents/เล่ม/successed/resource/Pics/res-json-public-url-file.PNG
