narinthon-so/Mushroom-project/Documents/เล่ม/successed/resource/Pics/Screenshot_20201202-142638.png

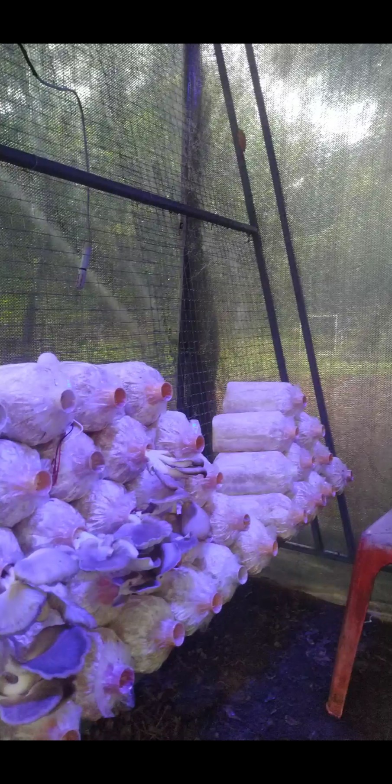
Documents/เล่ม/successed/resource/Pics/Screenshot_20201202-142638.png
