narinthon-so/Mushroom-project/Documents/เล่ม/successed/resource/Pics/t1.jpg

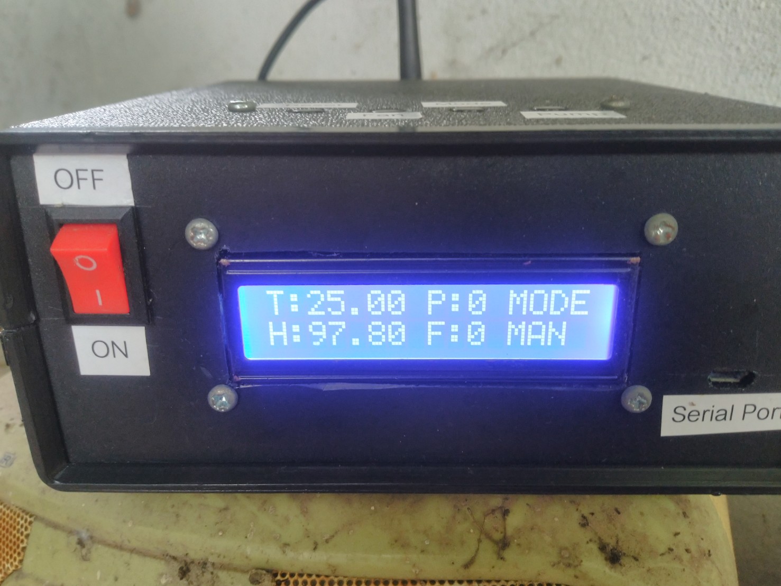
Documents/เล่ม/successed/resource/Pics/t1.jpg
