narinthon-so/Mushroom-project/Documents/เล่ม/successed/resource/Pics/t2.jpg

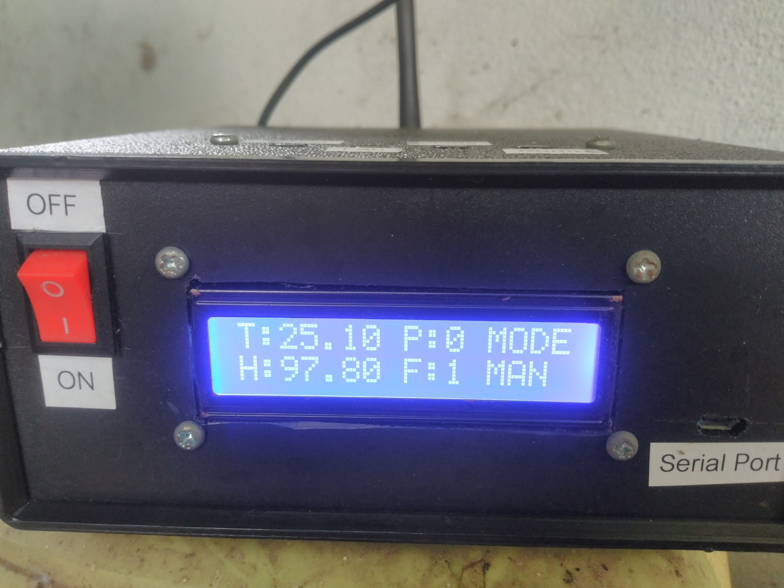
Documents/เล่ม/successed/resource/Pics/t2.jpg
