narinthon-so/Mushroom-project/Documents/เล่ม/successed/resource/Pics/t3.jpg

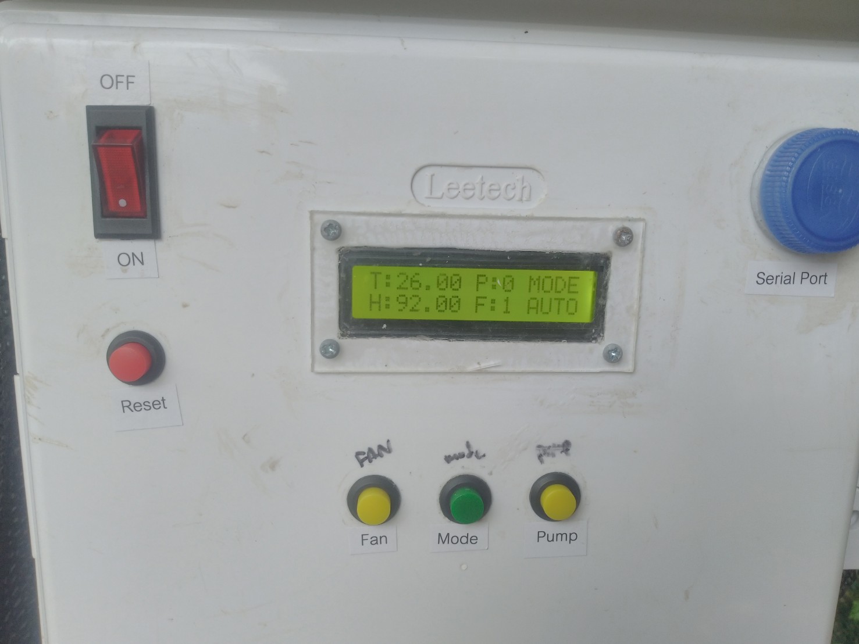
Documents/เล่ม/successed/resource/Pics/t3.jpg
