narinthon-so/Mushroom-project/Documents/เล่ม/successed/resource/Pics/t4.jpg

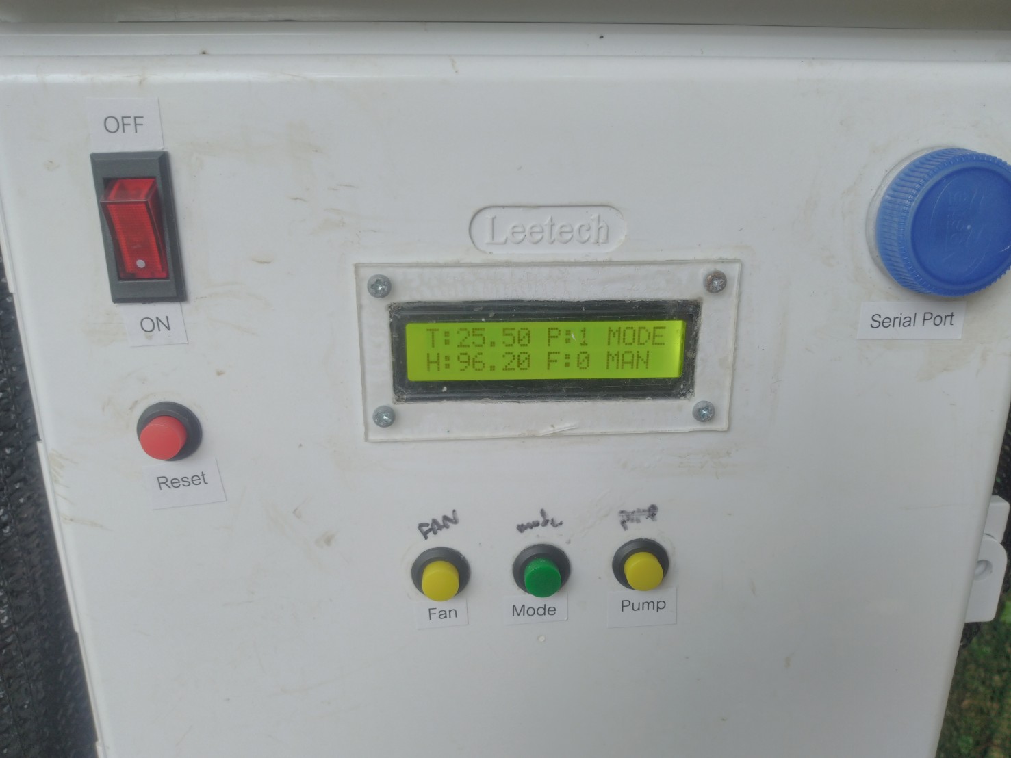
Documents/เล่ม/successed/resource/Pics/t4.jpg
