narinthon-so/Mushroom-project/Documents/เล่ม/successed/resource/Pics/t5.jpg

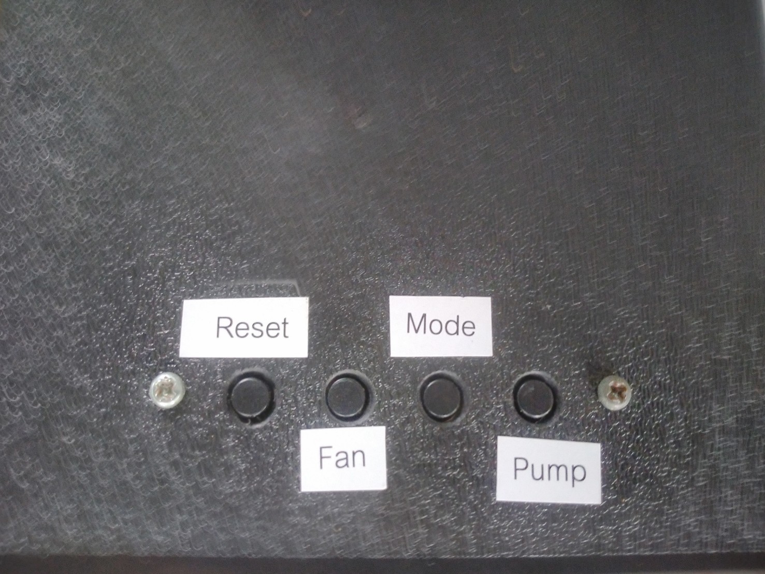
Documents/เล่ม/successed/resource/Pics/t5.jpg
