narinthon-so/Mushroom-project/Documents/เล่ม/successed/resource/Pics/t6.jpg

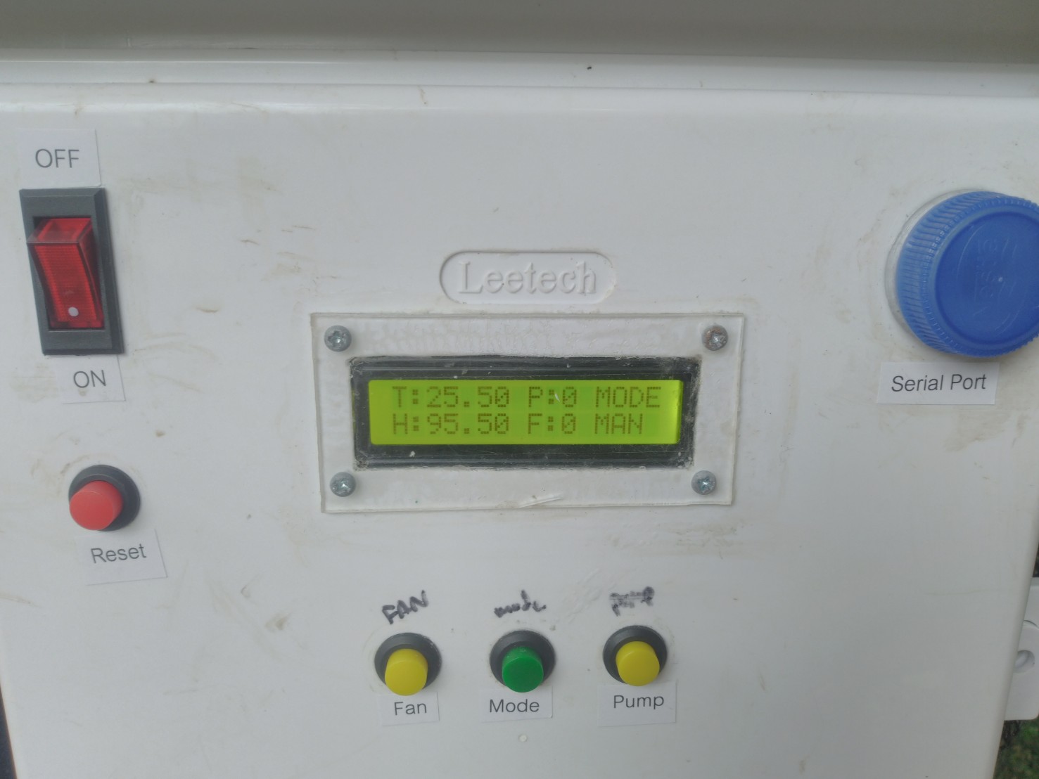
Documents/เล่ม/successed/resource/Pics/t6.jpg
