narinthon-so/Mushroom-project/Documents/เล่ม/successed/resource/Pics/t7.jpg

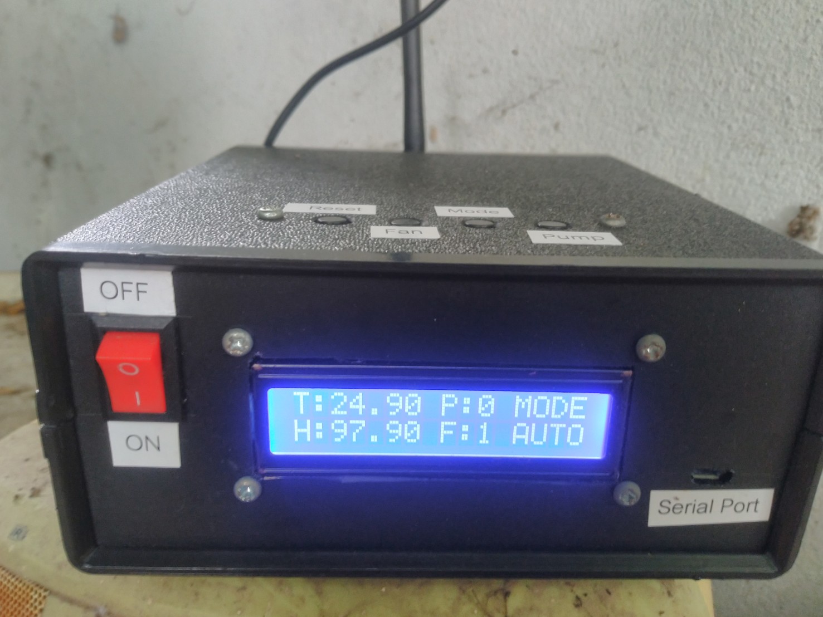
Documents/เล่ม/successed/resource/Pics/t7.jpg
