narinthon-so/Mushroom-project/Documents/เล่ม/successed/resource/Pics/t9.jpg

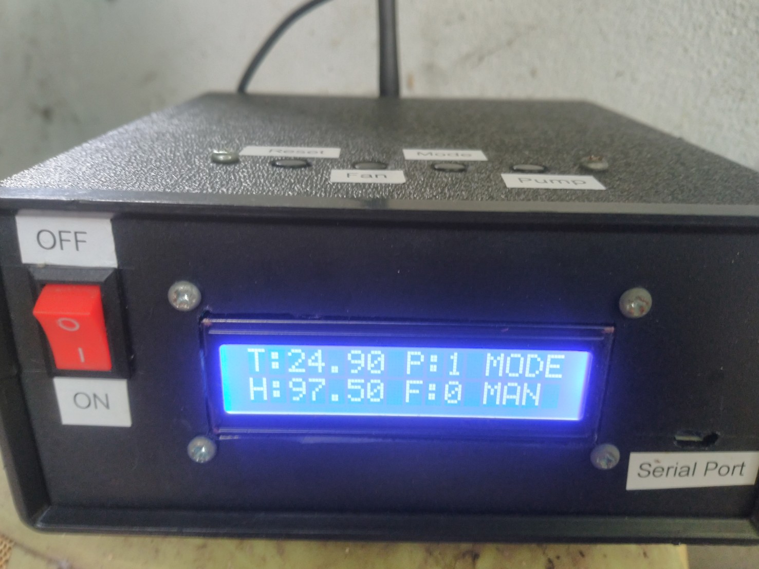
Documents/เล่ม/successed/resource/Pics/t9.jpg
