narinthon-so/Mushroom-project/Documents/เล่ม/successed/resource/Pics/tempsnip.png

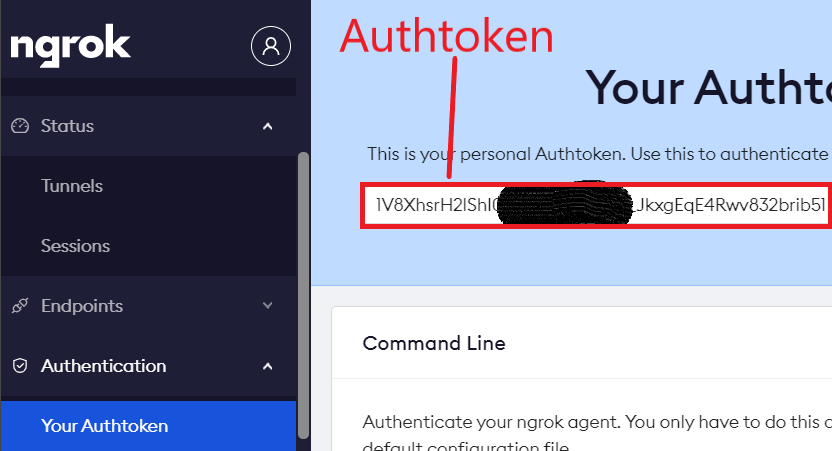
Documents/เล่ม/successed/resource/Pics/tempsnip.png
