narinthon-so/Mushroom-project/Documents/เล่ม/successed/resource/Pics/web1.PNG

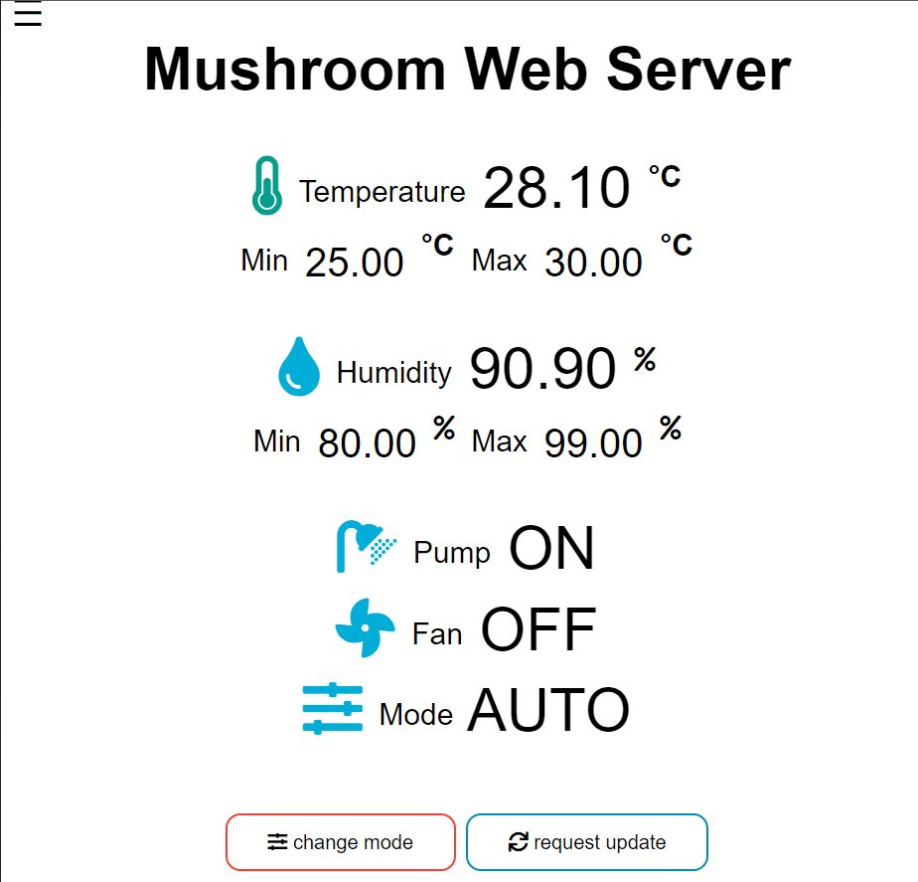
Documents/เล่ม/successed/resource/Pics/web1.PNG
