narinthon-so/Mushroom-project/Documents/เล่ม/successed/resource/Pics/web2.PNG

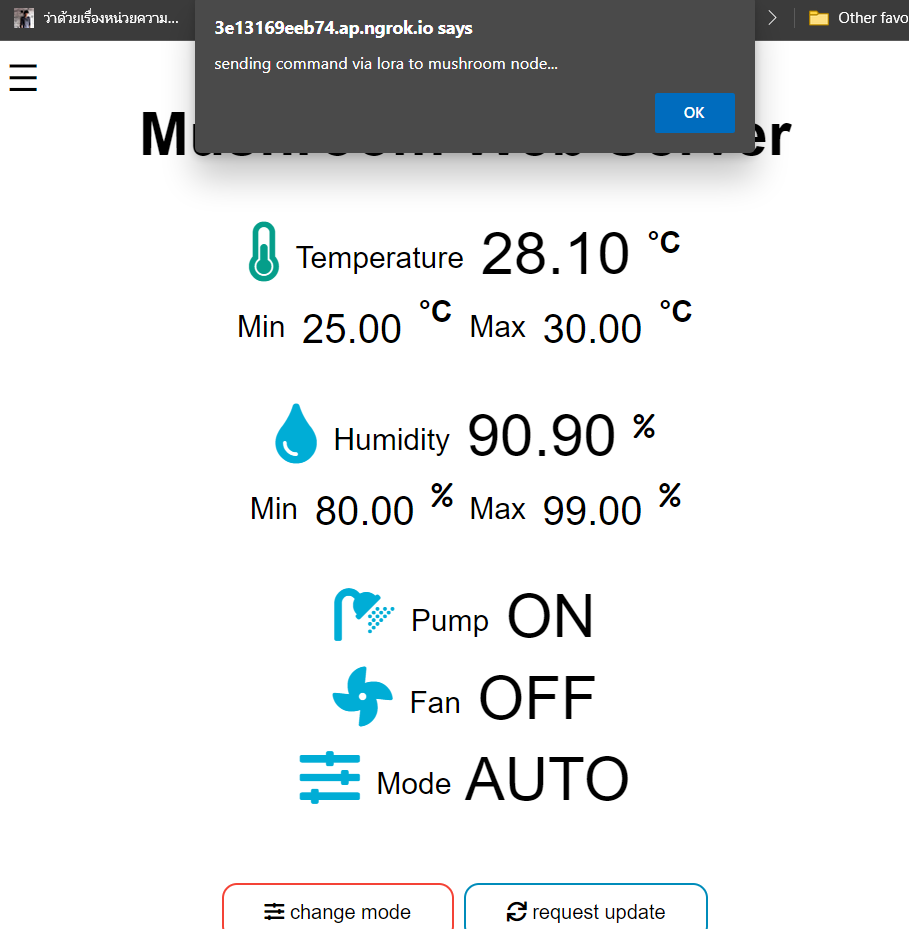
Documents/เล่ม/successed/resource/Pics/web2.PNG
