narinthon-so/Mushroom-project/Documents/เล่ม/successed/resource/Pics/web3.PNG

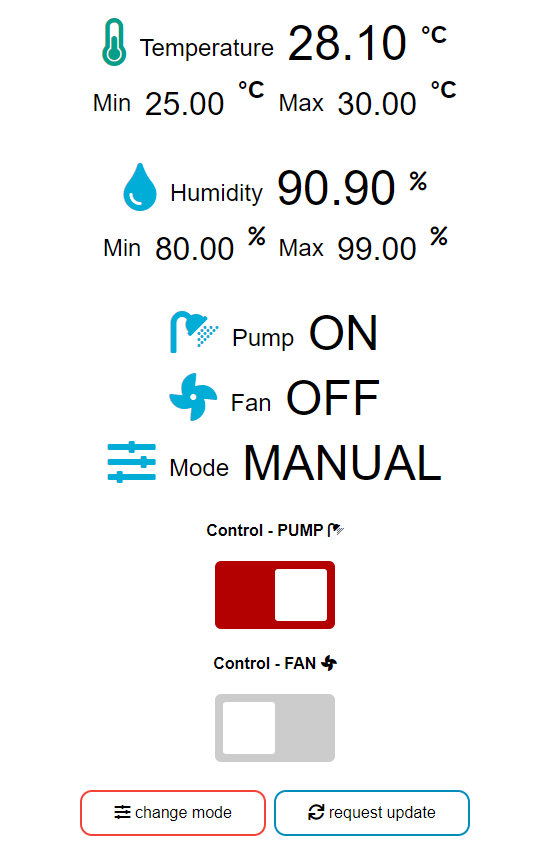
Documents/เล่ม/successed/resource/Pics/web3.PNG
