narinthon-so/Mushroom-project/Documents/เล่ม/successed/resource/Pics/web4.PNG

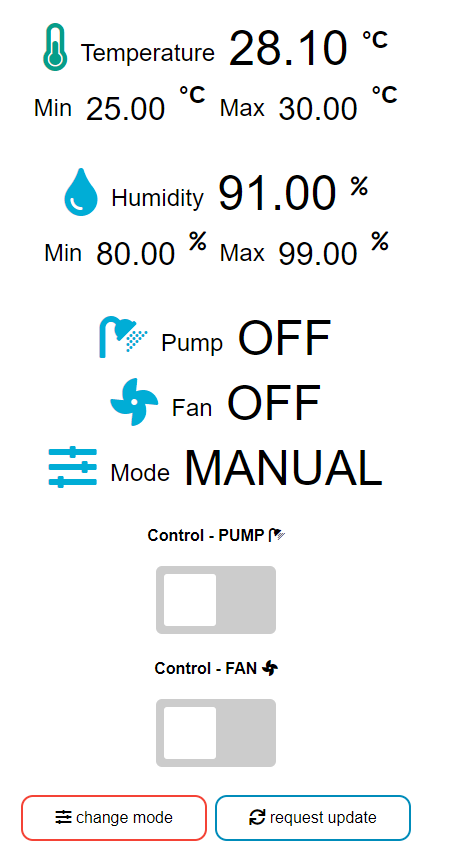
Documents/เล่ม/successed/resource/Pics/web4.PNG
