narinthon-so/Mushroom-project/Documents/เล่ม/successed/resource/Pics/web5.PNG

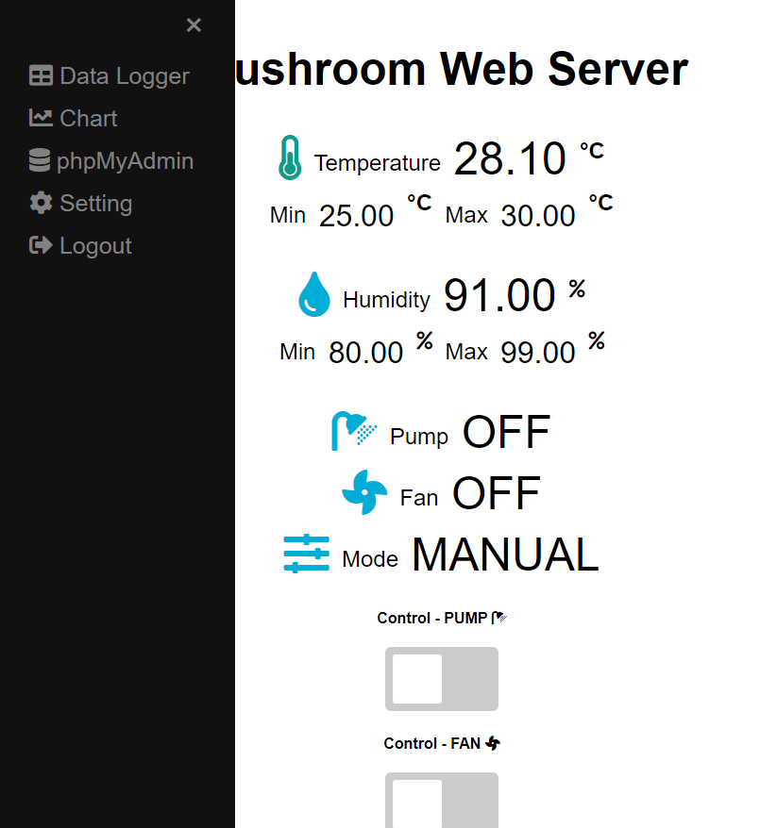
Documents/เล่ม/successed/resource/Pics/web5.PNG
