narinthon-so/Mushroom-project/Documents/เล่ม/successed/resource/Pics/web8.PNG

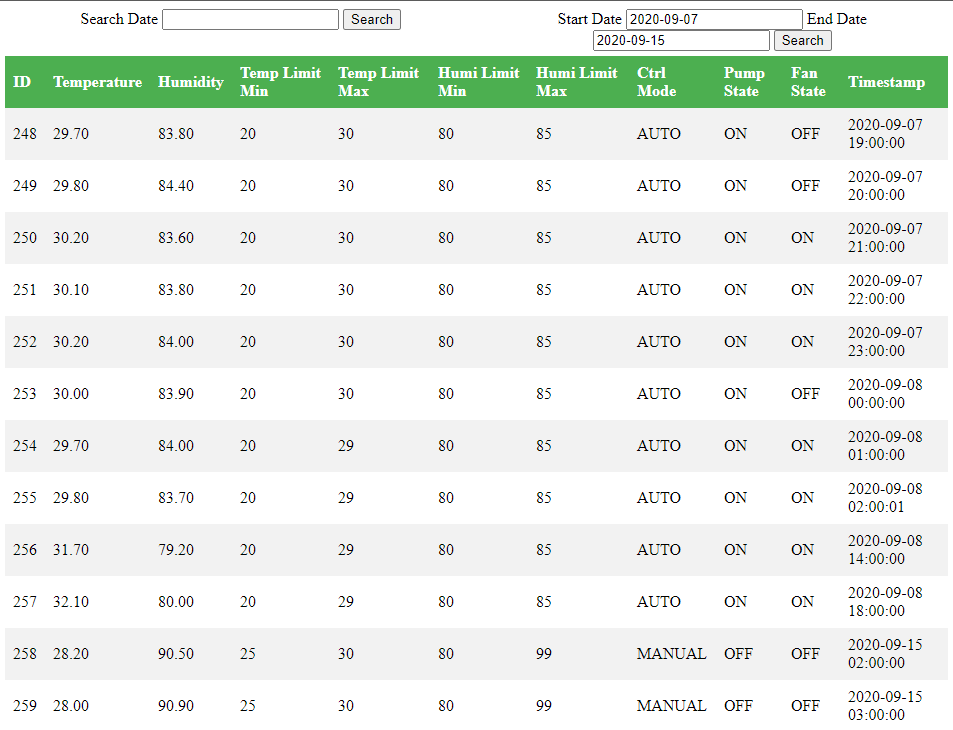
Documents/เล่ม/successed/resource/Pics/web8.PNG
