narinthon-so/Mushroom-project/Documents/เล่ม/successed/resource/Pics/web10.PNG

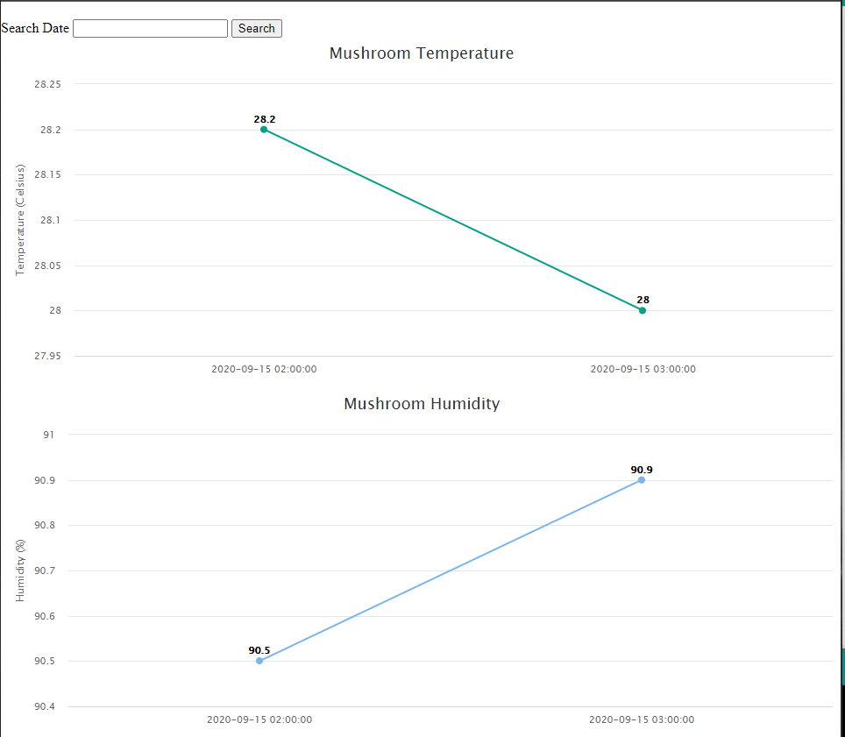
Documents/เล่ม/successed/resource/Pics/web10.PNG
