narinthon-so/Mushroom-project/Documents/เล่ม/successed/resource/Pics/web12.PNG

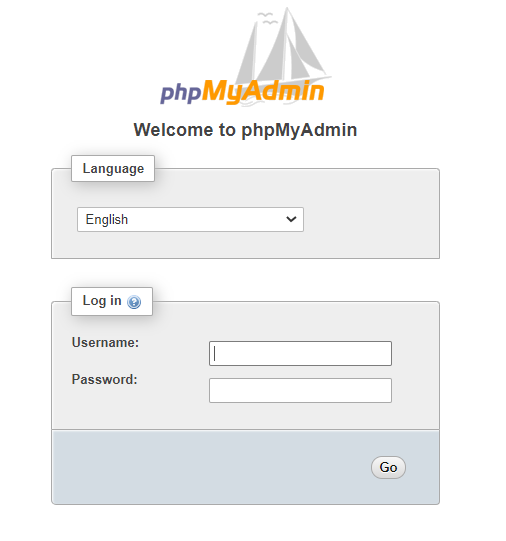
Documents/เล่ม/successed/resource/Pics/web12.PNG
