narinthon-so/Mushroom-project/Documents/เล่ม/successed/resource/Pics/web13.PNG

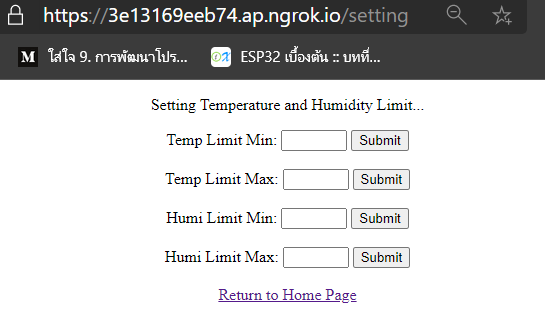
Documents/เล่ม/successed/resource/Pics/web13.PNG
