narinthon-so/Mushroom-project/Documents/เล่ม/successed/resource/Pics/web14.PNG

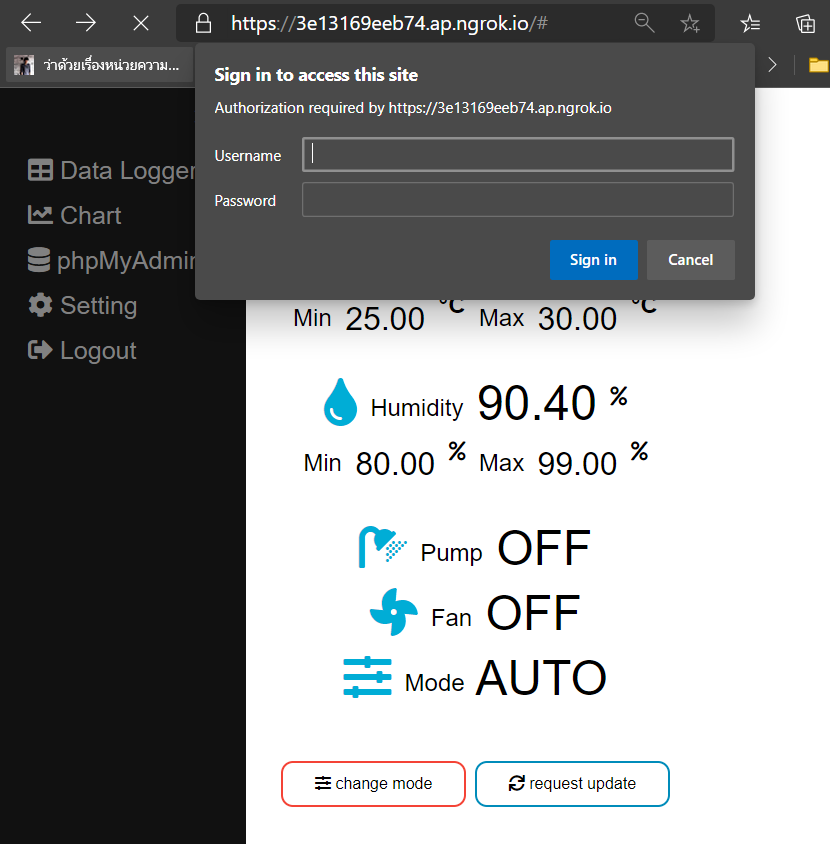
Documents/เล่ม/successed/resource/Pics/web14.PNG
