narinthon-so/Mushroom-project/Documents/เล่ม/successed/resource/Pics/web15.PNG

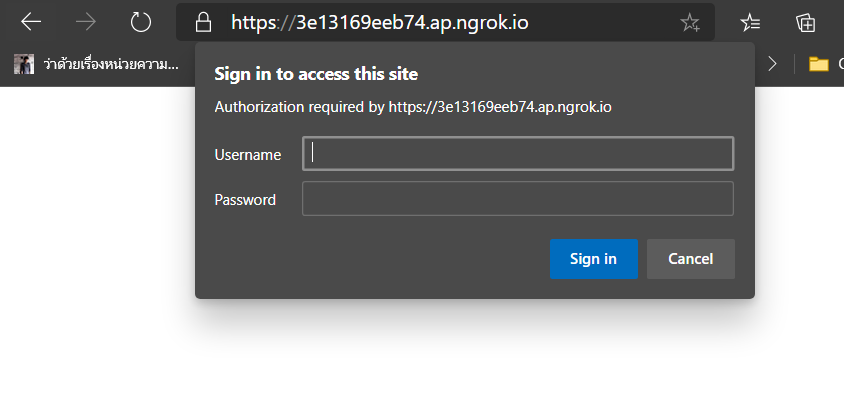
Documents/เล่ม/successed/resource/Pics/web15.PNG
