narinthon-so/Mushroom-project/Documents/เล่ม/successed/resource/Pics/web_10.PNG

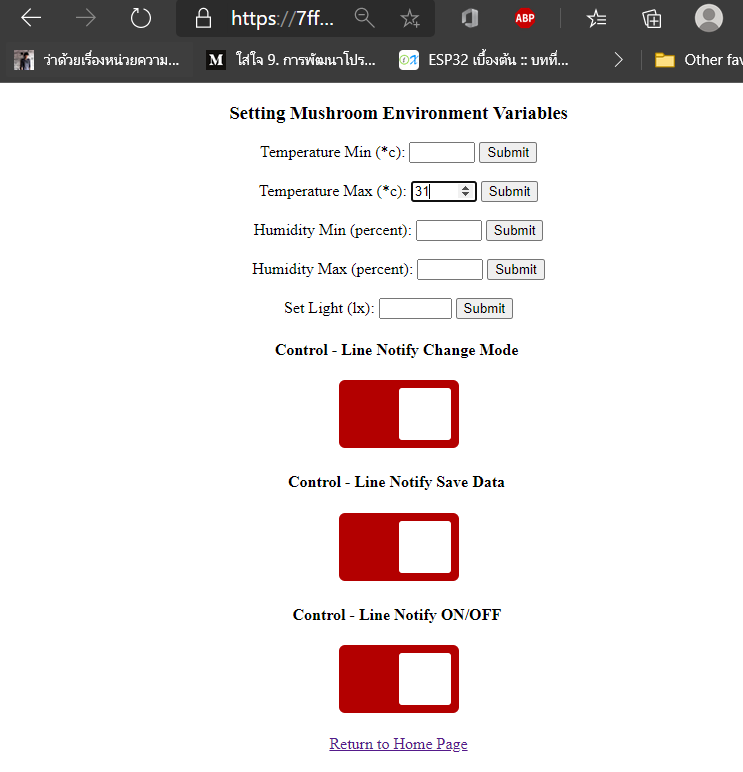
Documents/เล่ม/successed/resource/Pics/web_10.PNG
