narinthon-so/Mushroom-project/Documents/เล่ม/successed/resource/Pics/web_19.PNG

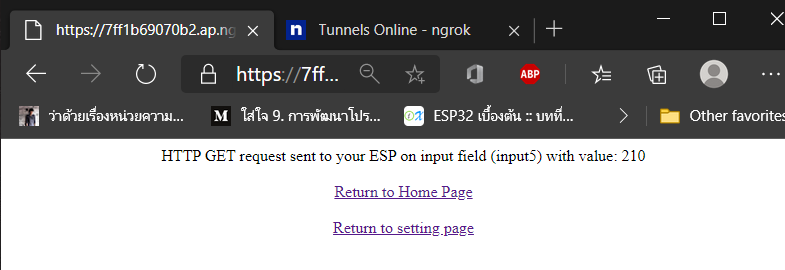
Documents/เล่ม/successed/resource/Pics/web_19.PNG
