narinthon-so/Mushroom-project/Documents/เล่ม/successed/resource/Pics/x.PNG

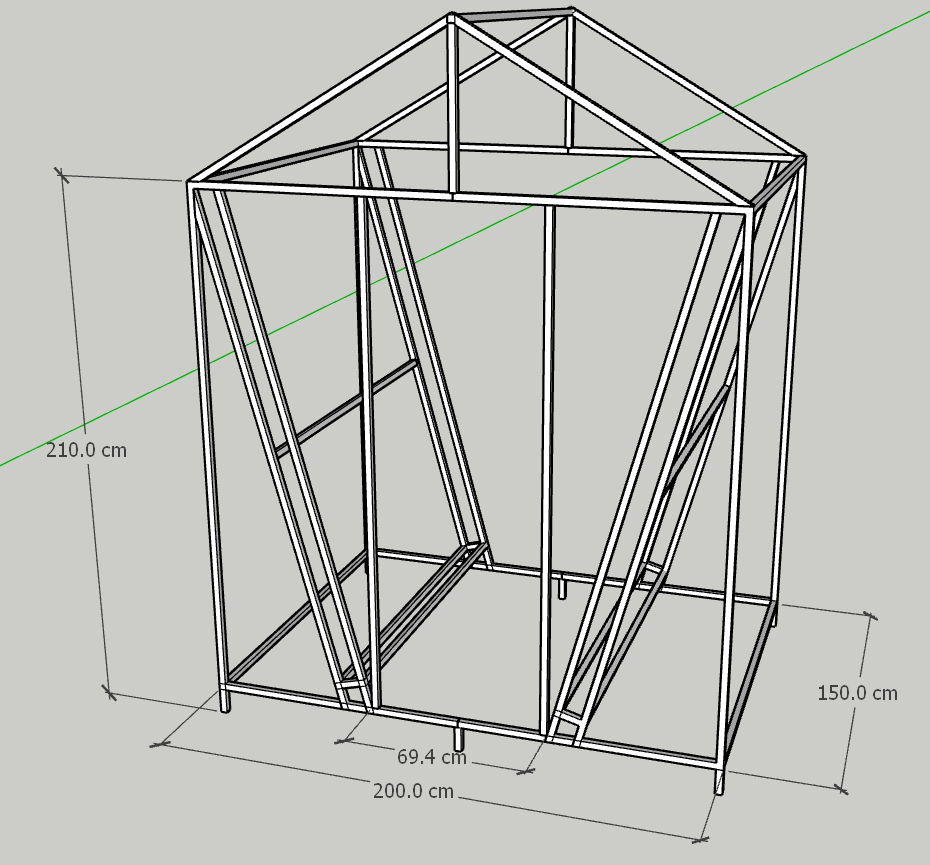
Documents/เล่ม/successed/resource/Pics/x.PNG
