narinthon-so/Mushroom-project/Documents/เล่ม/successed/resource/Pics/xefekm.jpg

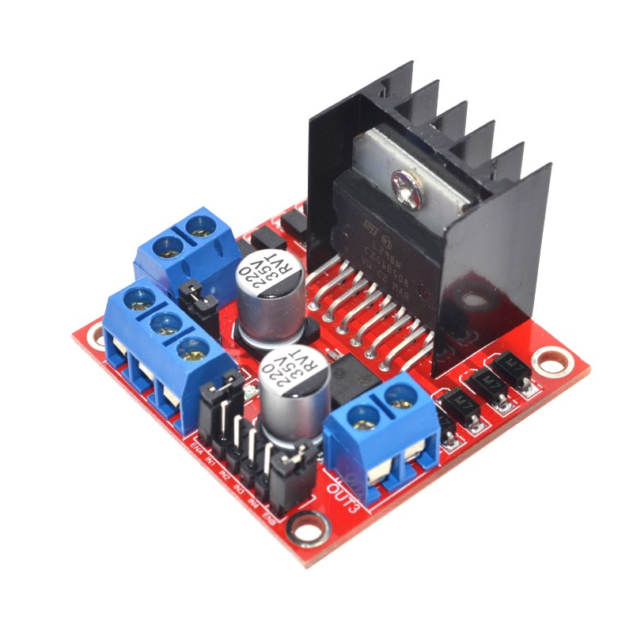
Documents/เล่ม/successed/resource/Pics/xefekm.jpg
