narinthon-so/Mushroom-project/Documents/เล่ม/successed/resource/Pics/เปิดโรงเพาะเห็ดขาย-เริ่มต้นอย่างไร-1.png

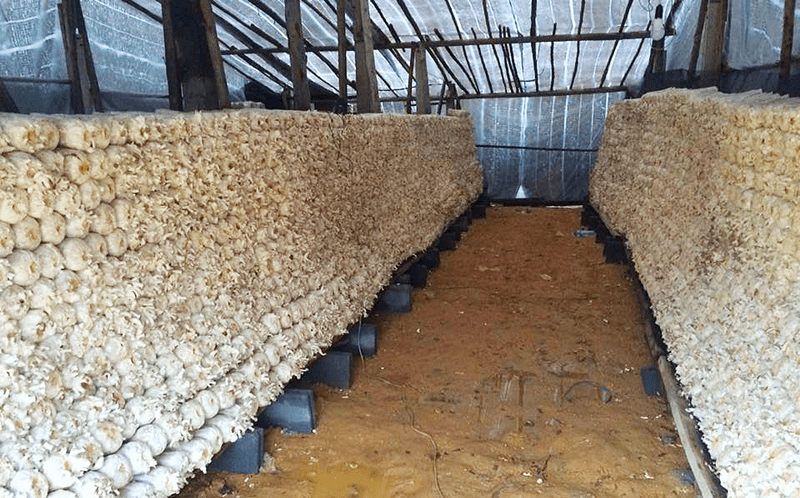
Documents/เล่ม/successed/resource/Pics/เปิดโรงเพาะเห็ดขาย-เริ่มต้นอย่างไร-1.png
