narinthon-so/Mushroom-project/(list of files, cad)

Other CAD files:
Documents/โรงเห็ด.skp
Documents/โรงเห็ดV2.skp
Documents/โรงเห็ดV3.skp
