narinthon-so/Mushroom-project/(list of files, drawings)

Other design files:
Documents/demo.pdsprj
Documents/ldr_demo.pdsprj
