narinthon-so/Mushroom-project/(commit log)

2021-03-01 Update บทที่ 2.docx
2021-03-02 Update บทที่ 3.docx
2021-03-02 Update บทที่ 1.docx
2021-03-04 Update บทที่ 3.pdf
2021-03-09 Create บทที่ 3 - Copy.docx
2021-03-10 Update บทที่ 3 - Copy.docx
2021-03-12 Create บทที่ 4 - Copy.docx
2021-03-13 Update บทที่ 4.docx
2021-03-14 Update บทที่ 5.docx
